Juxi-Technology/wiki-documents/docs/public/downloads/ST3215-20200328-to-customer.stp

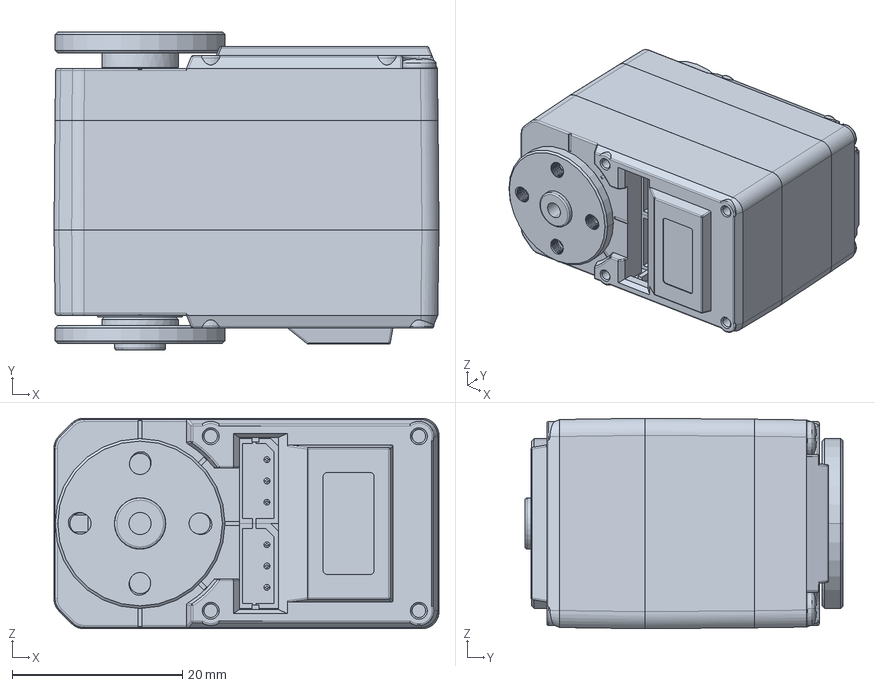
[picture p4: CAD file, 2026-09-16]
docs/public/downloads/ST3215-20200328-to-customer.stp
45.2 x 37.4 x 24.7 mm
SJ-WK00-0021TOPCABINETCASE_104
MOTOR-1723_3_1
PCB-CHAZUO_92_2
SJ-WK00-0023BOTTOMCASE_12
SJ-WK00-0022MIDDLECASE_68
LUOSI-2-25_1_2 x 4
3PIN-1_1 x 2
CHOUCHENGMR106_3 x 2
OUTPUTGEAR_20
FK-AP-019-25T_11
WJ-DP00-0002-FK-AP-020_7
