Juxi-Technology/wiki-documents/docs/public/downloads/SCS009-20230110-S.stp

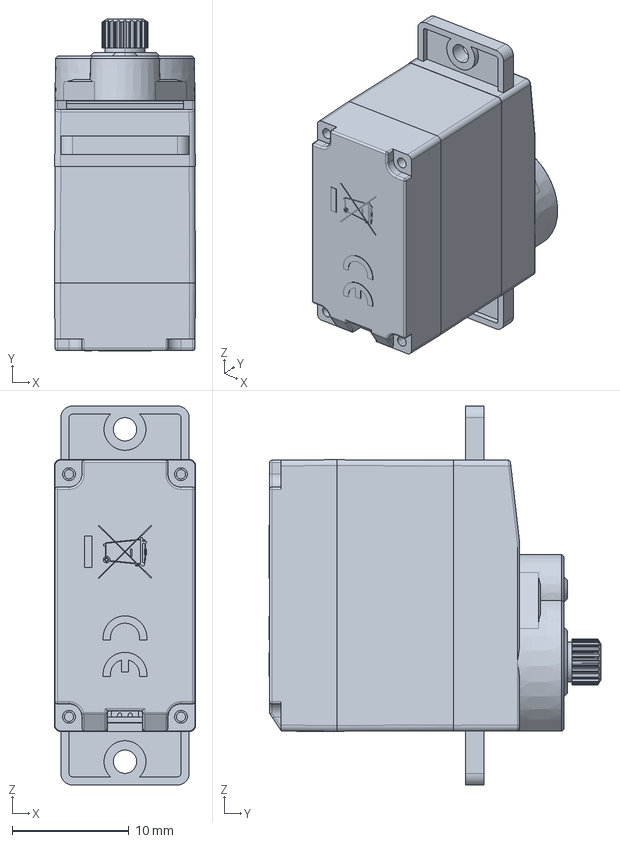
[picture p5: CAD file, 2026-09-16]
docs/public/downloads/SCS009-20230110-S.stp
12.1 x 28.5 x 32.5 mm
SJ-WK00-0038-TOPCASE-0716_41_1
SJ-WK00-0039-COREMIDDLE-0716_65
SJ-WK00-0037-BOTTOMCASE-0716_9_
SJ-CL00-0027-OUTPUTGEAR-0716_37
