Juxi-Technology/wiki-documents/docs/content/tutorials/index.md

---
title: Tutorials Home
titleTemplate: Product Tutorials & Guides
description: "Explore all product tutorials, guides, and examples to quickly get started with Juxi Technology products"
head:
  - [ meta, { property: "og:title", content: "Tutorials Home | Product Tutorials & Guides" } ]
  - [ meta, { property: "og:description", content: "Explore all product tutorials, guides, and examples to quickly get started with Juxi Technology products" } ]
---

# Tutorials Home

Welcome to the Tutorials page! Here, you can find all product usage tutorials, configuration guides, and best practices to help you quickly get started and fully utilize the product's capabilities.

## Topic Categories

### Getting Started

- [FAQ](/tutorials/faq)
- [ROS Intro](/tutorials/ros-intro)
- [Lark Docs](/tutorials/lark-wiki)

### SO-ARM101 Robotic Arm 7-DOF Tutorial

- [SO-ARM101 Robotic Arm 7-DOF Tutorial](/tutorials/robot-arms/so-arm101/lerobot-7dof/)
- **1. Environment Setup**
  - [Ubuntu](/tutorials/robot-arms/so-arm101/lerobot-7dof/01-Environment-Setup/Ubuntu)
  - [Windows](/tutorials/robot-arms/so-arm101/lerobot-7dof/01-Environment-Setup/Windows)
  - [Mac](/tutorials/robot-arms/so-arm101/lerobot-7dof/01-Environment-Setup/MacOS)
- **2. Replace Files (7-DOF Adaptation)**
  - [Replace Files (7-DOF Adaptation)](/tutorials/robot-arms/so-arm101/lerobot-7dof/02-Replace-Files-7DOF)
- **3. Serial Port Check**
  - [Ubuntu](/tutorials/robot-arms/so-arm101/lerobot-7dof/03-Serial-Port/Ubuntu)
  - [Windows](/tutorials/robot-arms/so-arm101/lerobot-7dof/03-Serial-Port/Windows)
  - [Mac](/tutorials/robot-arms/so-arm101/lerobot-7dof/03-Serial-Port/MacOS)
- **4. Arm Calibration**
  - [Ubuntu](/tutorials/robot-arms/so-arm101/lerobot-7dof/04-Calibration/Ubuntu)
  - [Windows](/tutorials/robot-arms/so-arm101/lerobot-7dof/04-Calibration/Windows)
  - [Mac](/tutorials/robot-arms/so-arm101/lerobot-7dof/04-Calibration/MacOS)
- **5. Teleoperation**
  - [Ubuntu](/tutorials/robot-arms/so-arm101/lerobot-7dof/05-Teleoperation/Ubuntu)
  - [Windows](/tutorials/robot-arms/so-arm101/lerobot-7dof/05-Teleoperation/Windows)
  - [Mac](/tutorials/robot-arms/so-arm101/lerobot-7dof/05-Teleoperation/MacOS)
- **6. Camera Teleop**
  - [Ubuntu](/tutorials/robot-arms/so-arm101/lerobot-7dof/06-Camera-Teleoperation/Ubuntu)
  - [Windows](/tutorials/robot-arms/so-arm101/lerobot-7dof/06-Camera-Teleoperation/Windows)
  - [Mac](/tutorials/robot-arms/so-arm101/lerobot-7dof/06-Camera-Teleoperation/MacOS)
- **7. Data Collection**
  - [Browse and Replay the Dataset](/tutorials/robot-arms/so-arm101/lerobot-7dof/07-Data-Collection/Browse-and-Replay)
  - [Dataset Collection Notes](/tutorials/robot-arms/so-arm101/lerobot-7dof/07-Data-Collection/Collection-Notes)
  - [Register a Hugging Face Account (Optional)](/tutorials/robot-arms/so-arm101/lerobot-7dof/07-Data-Collection/HF-Account)
  - [Upload Dataset to HuggingFace (Optional)](/tutorials/robot-arms/so-arm101/lerobot-7dof/07-Data-Collection/HF-Dataset-Upload)
  - [Teaching and Recording a Dataset - Handshake 200](/tutorials/robot-arms/so-arm101/lerobot-7dof/07-Data-Collection/Teaching-and-Recording-Handshake-200)
  - [Teaching and Recording a Dataset](/tutorials/robot-arms/so-arm101/lerobot-7dof/07-Data-Collection/Teaching-and-Recording)
- **8. Model Training**
  - [Cloud GPU Training Environment Setup](/tutorials/robot-arms/so-arm101/lerobot-7dof/08-Training/Cloud-GPU)
  - [Training Command Line - ACT (Recommended for Beginners)](/tutorials/robot-arms/so-arm101/lerobot-7dof/08-Training/Command-ACT)
  - [Training Command Line - Diffusion](/tutorials/robot-arms/so-arm101/lerobot-7dof/08-Training/Command-Diffusion)
  - [Training Command Line - pi0.5](/tutorials/robot-arms/so-arm101/lerobot-7dof/08-Training/Command-pi0.5)
  - [Training Command Line - pi0 (Best Results)](/tutorials/robot-arms/so-arm101/lerobot-7dof/08-Training/Command-pi0)
  - [Training Command Line - pi0fast](/tutorials/robot-arms/so-arm101/lerobot-7dof/08-Training/Command-pi0fast)
  - [Training Command Line - smolvla (Recommended for Advanced Users)](/tutorials/robot-arms/so-arm101/lerobot-7dof/08-Training/Command-smolvla)
  - [Upload the Model to HuggingFace (Optional)](/tutorials/robot-arms/so-arm101/lerobot-7dof/08-Training/HF-Model-Upload)
  - [Imitation Learning Algorithms Supported by LeRobot](/tutorials/robot-arms/so-arm101/lerobot-7dof/08-Training/Imitation-Learning-Algorithms)
  - [Local Ubuntu Training](/tutorials/robot-arms/so-arm101/lerobot-7dof/08-Training/Local-Ubuntu)
  - [Obtain the Model Weight File](/tutorials/robot-arms/so-arm101/lerobot-7dof/08-Training/Model-Weights)
  - [Training Parameter Recommendations](/tutorials/robot-arms/so-arm101/lerobot-7dof/08-Training/Training-Parameter-Tips)
  - [View Real-Time Training Curves on wandb](/tutorials/robot-arms/so-arm101/lerobot-7dof/08-Training/WandB-Curves)
- **9. Model Inference**
  - [Command Line Reference](/tutorials/robot-arms/so-arm101/lerobot-7dof/09-Inference/CLI-Reference)
  - [Inference Command Line - ACT](/tutorials/robot-arms/so-arm101/lerobot-7dof/09-Inference/Command-ACT)
  - [Inference Command Line - Diffusion](/tutorials/robot-arms/so-arm101/lerobot-7dof/09-Inference/Command-Diffusion)
  - [Inference Command Line - pi0.5](/tutorials/robot-arms/so-arm101/lerobot-7dof/09-Inference/Command-pi0.5)
  - [Inference Command Line - pi0](/tutorials/robot-arms/so-arm101/lerobot-7dof/09-Inference/Command-pi0)
  - [Inference Command Line - smolvla](/tutorials/robot-arms/so-arm101/lerobot-7dof/09-Inference/Command-smolvla)
  - [Common Bugs and Fixes](/tutorials/robot-arms/so-arm101/lerobot-7dof/09-Inference/Common-Bugs)
  - [NVIDIA DGX Spark Inference](/tutorials/robot-arms/so-arm101/lerobot-7dof/09-Inference/DGX-Spark)
  - [D-Robotics RDK S100 Inference](/tutorials/robot-arms/so-arm101/lerobot-7dof/09-Inference/RDK-S100)

### Jetson AGX Orin

- [Quick Start — From Unboxing to a Working JetPack 7.2.1 System](/tutorials/jetson-agx-orin/quick-start)
- [Flashing & Updates — Jetson ISO Method](/tutorials/jetson-agx-orin/flashing-and-updates)
- [Verify Your System](/tutorials/jetson-agx-orin/verify-your-system)
- [Interfaces & Hardware Layout](/tutorials/jetson-agx-orin/interfaces)
- [Product Overview](/tutorials/jetson-agx-orin/overview)
- [Local LLM Inference](/tutorials/jetson-agx-orin/local-llm)
- [Agentic AI (NemoClaw)](/tutorials/jetson-agx-orin/agentic-ai)
- [DeepStream Video Analytics](/tutorials/jetson-agx-orin/deepstream)
- [Robotics — State of Play](/tutorials/jetson-agx-orin/robotics)
- [Memory Efficiency](/tutorials/jetson-agx-orin/memory-efficiency)
- [Migrate from JetPack 6.x](/tutorials/jetson-agx-orin/jetpack-6-to-7)
- [Downloads & Official Links](/tutorials/jetson-agx-orin/downloads)
- [FAQ](/tutorials/jetson-agx-orin/faq)
- [Troubleshooting](/tutorials/jetson-agx-orin/troubleshooting)
- [Glossary](/tutorials/jetson-agx-orin/glossary)
- [Changelog](/tutorials/jetson-agx-orin/changelog)
- [XLeRobot Docker — 01 · Overview](/tutorials/jetson-agx-orin/xlerobot-docker/deployment/01-Overview)
- [XLeRobot Docker — 02 · Environment Setup](/tutorials/jetson-agx-orin/xlerobot-docker/deployment/02-Environment-Setup)
- [XLeRobot Docker — 03 · Deployment](/tutorials/jetson-agx-orin/xlerobot-docker/deployment/03-Deployment)
- [XLeRobot Docker — Original LeRobot Operation](/tutorials/jetson-agx-orin/xlerobot-docker/lerobot/01-Operation)
- [XLeRobot Docker — XLeRobot Operation](/tutorials/jetson-agx-orin/xlerobot-docker/xlerobot/01-Operation)
- [XLeRobot Docker — Troubleshooting and Quick Reference](/tutorials/jetson-agx-orin/xlerobot-docker/troubleshooting/01-Troubleshooting)

### Jetson Orin Nano

- [Quick Start — From Unboxing to a Working JetPack 7.2.1 System](/tutorials/jetson-orin-nano/quick-start)
- [Flashing & Updates — Jetson ISO Method, microSD & NVMe](/tutorials/jetson-orin-nano/flashing-and-updates)
- [Verify Your System](/tutorials/jetson-orin-nano/verify-your-system)
- [Interfaces & Hardware Layout](/tutorials/jetson-orin-nano/interfaces)
- [Product Overview](/tutorials/jetson-orin-nano/overview)
- [Local LLM Inference](/tutorials/jetson-orin-nano/local-llm)
- [Memory Efficiency (8 GB)](/tutorials/jetson-orin-nano/memory-efficiency)
- [DeepStream Video Analytics](/tutorials/jetson-orin-nano/deepstream)
- [Robotics (State of Play)](/tutorials/jetson-orin-nano/robotics)
- [Agentic AI (NemoClaw)](/tutorials/jetson-orin-nano/agentic-ai)
- [Migrate from JetPack 6.x](/tutorials/jetson-orin-nano/jetpack-6-to-7)
- [Downloads](/tutorials/jetson-orin-nano/downloads)
- [FAQ](/tutorials/jetson-orin-nano/faq)
- [Troubleshooting](/tutorials/jetson-orin-nano/troubleshooting)
- [Glossary](/tutorials/jetson-orin-nano/glossary)
- [Changelog](/tutorials/jetson-orin-nano/changelog)
- [XLeRobot Docker — 01 · Overview](/tutorials/jetson-orin-nano/xlerobot-docker/deployment/01-Overview)
- [XLeRobot Docker — 02 · Environment Setup](/tutorials/jetson-orin-nano/xlerobot-docker/deployment/02-Environment-Setup)
- [XLeRobot Docker — 03 · Deployment](/tutorials/jetson-orin-nano/xlerobot-docker/deployment/03-Deployment)
- [XLeRobot Docker — Original LeRobot Operation](/tutorials/jetson-orin-nano/xlerobot-docker/lerobot/01-Operation)
- [XLeRobot Docker — XLeRobot Operation](/tutorials/jetson-orin-nano/xlerobot-docker/xlerobot/01-Operation)
- [XLeRobot Docker — Troubleshooting and Quick Reference](/tutorials/jetson-orin-nano/xlerobot-docker/troubleshooting/01-Troubleshooting)

### Learning Resources

- [Learning Resources Home](/tutorials/learning-resources/)
- [Jetson Orin PyTorch Compatibility](/tutorials/learning-resources/jetson-orin-pytorch-compatibility)

### Robot Arms

- [Robot Arms Overview](/tutorials/robot-arms/)
  - [Selection Guide](/tutorials/robot-arms/select-guide)
  - **SO-ARM101 Series**
    - [SO-ARM101 Robotic Arm Tutorials](/tutorials/robot-arms/so-arm101/)
    - [SO-ARM101 Tutorial](/tutorials/robot-arms/so-arm101/SO-ARM101-Tutorial)
    - [SO-ARM101 Assembly](/tutorials/robot-arms/so-arm101/SO-ARM101-Assembly)
    - [SO-ARM101 Jetson Orin PyTorch Compatibility](/tutorials/robot-arms/so-arm101/SO-ARM101-Jetson-Orin-PyTorch-Compatibility)
    - [Arm Mount & Camera Kit Installation](/tutorials/robot-arms/so-arm101/SO-ARM101-100-Arm-Mount-Camera-Kit-Installation)
    - [Overhead Camera Mount Installation](/tutorials/robot-arms/so-arm101/SO-ARM101-Overhead-Camera-Mount-Installation)
    - [SO-ARM101 Wireless Teleoperation (ESP32-NanoCam Version)](/tutorials/robot-arms/so-arm101/SO-ARM101-NanoCam-Wireless-Teleop)
    - [Wireless Teleoperation Troubleshooting](/tutorials/robot-arms/so-arm101/SO-ARM101-NanoCam-Troubleshooting)
    - [SO-ARM101 Bi-Arm (Dual Follower) Tutorial](/tutorials/robot-arms/so-arm101/SO-ARM101-Bi-Arm-Tutorial)
    - [SoARM Series Servo Calibration Tool Tutorial](/tutorials/robot-arms/so-arm101/SO-ARM101-Servo-Calibration-Tool)
    - [So-ARM Series STS3215 Servo Calibration – Web Version](/tutorials/robot-arms/so-arm101/SO-ARM101-Web-Calibration)
      - **LeRobot Full Course**
        - [LeRobot Course Overview](/tutorials/robot-arms/so-arm101/lerobot/)
          - **1. Environment Setup**
            - [Step 1: Environment Setup (Ubuntu)](/tutorials/robot-arms/so-arm101/lerobot/01-Environment-Setup/Ubuntu)
            - [Step 1: Environment Setup (Windows)](/tutorials/robot-arms/so-arm101/lerobot/01-Environment-Setup/Windows)
            - [Step 1: Environment Setup (macOS)](/tutorials/robot-arms/so-arm101/lerobot/01-Environment-Setup/MacOS)
          - **2. Serial Port Check**
            - [Step 2: Serial Port Check (Ubuntu)](/tutorials/robot-arms/so-arm101/lerobot/02-Serial-Port/Ubuntu)
            - [Step 2: Serial Port Check (Windows)](/tutorials/robot-arms/so-arm101/lerobot/02-Serial-Port/Windows)
            - [Step 2: Serial Port Check (macOS)](/tutorials/robot-arms/so-arm101/lerobot/02-Serial-Port/MacOS)
          - **3. Arm Calibration**
            - [Step 3: Arm Calibration (Ubuntu)](/tutorials/robot-arms/so-arm101/lerobot/03-Calibration/Ubuntu)
            - [Step 3: Arm Calibration (Windows)](/tutorials/robot-arms/so-arm101/lerobot/03-Calibration/Windows)
            - [Step 3: Arm Calibration (macOS)](/tutorials/robot-arms/so-arm101/lerobot/03-Calibration/MacOS)
          - **4. Teleoperation**
            - [Step 4: Teleoperation (Ubuntu)](/tutorials/robot-arms/so-arm101/lerobot/04-Teleoperation/Ubuntu)
            - [Step 4: Teleoperation (Windows)](/tutorials/robot-arms/so-arm101/lerobot/04-Teleoperation/Windows)
            - [Step 4: Teleoperation (macOS)](/tutorials/robot-arms/so-arm101/lerobot/04-Teleoperation/MacOS)
          - **5. Camera Teleop**
            - [Step 5: Camera Teleoperation (Ubuntu)](/tutorials/robot-arms/so-arm101/lerobot/05-Camera-Teleoperation/Ubuntu)
            - [Step 5: Camera Teleoperation (Windows)](/tutorials/robot-arms/so-arm101/lerobot/05-Camera-Teleoperation/Windows)
            - [Step 5: Camera Teleoperation (macOS)](/tutorials/robot-arms/so-arm101/lerobot/05-Camera-Teleoperation/MacOS)
          - **6. Data Collection**
            - [Step 6: Teaching & Recording a Dataset](/tutorials/robot-arms/so-arm101/lerobot/06-Data-Collection/Teaching-and-Recording)
            - [Step 6: Teaching & Recording a Dataset — Handshake 200](/tutorials/robot-arms/so-arm101/lerobot/06-Data-Collection/Teaching-and-Recording-Handshake-200)
            - [Step 6: Viewing & Replaying a Dataset](/tutorials/robot-arms/so-arm101/lerobot/06-Data-Collection/Browse-and-Replay)
            - [Step 6: Dataset Collection Notes](/tutorials/robot-arms/so-arm101/lerobot/06-Data-Collection/Collection-Notes)
            - [Step 6: Hugging Face Account (Optional)](/tutorials/robot-arms/so-arm101/lerobot/06-Data-Collection/HF-Account)
            - [Step 6: Upload Dataset to Hugging Face (Optional)](/tutorials/robot-arms/so-arm101/lerobot/06-Data-Collection/HF-Dataset-Upload)
            - [Step 7 (Simulation): Collecting a Dataset — Lightwheel LeIsaac Teleoperation](/tutorials/robot-arms/so-arm101/lerobot/06-Data-Collection/LeIsaac-Sim)
          - **7. Model Training**
            - [Step 7: Training — Local Ubuntu](/tutorials/robot-arms/so-arm101/lerobot/07-Training/Local-Ubuntu)
            - [Step 7: Training — Cloud GPU Setup](/tutorials/robot-arms/so-arm101/lerobot/07-Training/Cloud-GPU)
            - [Step 7: Training — wandb Curves](/tutorials/robot-arms/so-arm101/lerobot/07-Training/WandB-Curves)
            - [Step 7: Training — Upload Model (Optional)](/tutorials/robot-arms/so-arm101/lerobot/07-Training/HF-Model-Upload)
            - [Step 7: Training — Model Weights](/tutorials/robot-arms/so-arm101/lerobot/07-Training/Model-Weights)
            - [Step 7: Training — ACT Command](/tutorials/robot-arms/so-arm101/lerobot/07-Training/Command-ACT)
            - [Step 7: Training — pi0 Command](/tutorials/robot-arms/so-arm101/lerobot/07-Training/Command-pi0)
            - [Step 7: Training — pi0.5 Command](/tutorials/robot-arms/so-arm101/lerobot/07-Training/Command-pi0.5)
            - [Step 7: Training — pi0fast Command](/tutorials/robot-arms/so-arm101/lerobot/07-Training/Command-pi0fast)
            - [Step 7: Training — smolvla Command](/tutorials/robot-arms/so-arm101/lerobot/07-Training/Command-smolvla)
            - [Step 7: Training — Diffusion Command](/tutorials/robot-arms/so-arm101/lerobot/07-Training/Command-Diffusion)
            - [Step 7: Training — WALL-OSS Command](/tutorials/robot-arms/so-arm101/lerobot/07-Training/Command-Wall-OSS)
            - [Step 7: Training — Training Command Line](/tutorials/robot-arms/so-arm101/lerobot/07-Training/Train-CLI)
            - [Step 7: Training — Parameter Tips](/tutorials/robot-arms/so-arm101/lerobot/07-Training/Training-Parameters)
            - [Step 7: Training — Imitation Learning Algorithms](/tutorials/robot-arms/so-arm101/lerobot/07-Training/Imitation-Learning-Algorithms)
          - **8. Model Inference**
            - [Step 8: Inference — CLI Reference](/tutorials/robot-arms/so-arm101/lerobot/08-Inference/CLI-Reference)
            - [Step 8: Inference — Common Bugs](/tutorials/robot-arms/so-arm101/lerobot/08-Inference/Common-Bugs)
            - [Step 8: Inference — ACT Command](/tutorials/robot-arms/so-arm101/lerobot/08-Inference/Command-ACT)
            - [Step 8: Inference — pi0 Command](/tutorials/robot-arms/so-arm101/lerobot/08-Inference/Command-pi0)
            - [Step 8: Inference — pi0.5 Command](/tutorials/robot-arms/so-arm101/lerobot/08-Inference/Command-pi0.5)
            - [Step 8: Inference — smolvla Command](/tutorials/robot-arms/so-arm101/lerobot/08-Inference/Command-smolvla)
            - [Step 8: Inference — Diffusion Command](/tutorials/robot-arms/so-arm101/lerobot/08-Inference/Command-Diffusion)
            - [Step 8: Inference — WALL-OSS Command](/tutorials/robot-arms/so-arm101/lerobot/08-Inference/Command-Wall-OSS)
            - [Step 8: Inference — NVIDIA DGX Spark](/tutorials/robot-arms/so-arm101/lerobot/08-Inference/DGX-Spark)
            - [Step 8: Inference — D-Robotics RDK S100](/tutorials/robot-arms/so-arm101/lerobot/08-Inference/RDK-S100)
          - **Basics**
            - [Understanding LeRobot](/tutorials/robot-arms/so-arm101/basics/Understanding-LeRobot)
            - [LeRobot Datasets on Hugging Face](/tutorials/robot-arms/so-arm101/basics/HF-Datasets)
            - [Model Training Resources](/tutorials/robot-arms/so-arm101/basics/Training-Resources)
            - [SO-ARM100 Official 3D Print Files](/tutorials/robot-arms/so-arm101/basics/Official-3D-Print-Files)
            - [URDF Files and Reference Materials](/tutorials/robot-arms/so-arm101/basics/URDF-Reference)
            - [Recommended Camera Brackets and Mounts](/tutorials/robot-arms/so-arm101/basics/Camera-Mounts-Recommended)
          - **Extras & Advanced**
            - [ROS2 Simulation Control](/tutorials/robot-arms/so-arm101/ROS2-Simulation-Control)
            - [Parallel Finger Gripper Installation](/tutorials/robot-arms/so-arm101/Parallel-Finger-Gripper-Installation)
      - **LeLab Tutorial**
        - [1 · Overview](/tutorials/robot-arms/so-arm101/lelab/01-Overview)
        - [2 · Install and run](/tutorials/robot-arms/so-arm101/lelab/02-Install)
        - [3 · Connect and calibrate](/tutorials/robot-arms/so-arm101/lelab/03-Calibration)
        - [4 · Teleoperation](/tutorials/robot-arms/so-arm101/lelab/04-Teleoperation)
        - [5 · Record a dataset](/tutorials/robot-arms/so-arm101/lelab/05-Record-Dataset)
        - [6 · Train and run inference](/tutorials/robot-arms/so-arm101/lelab/06-Train-and-Inference)
        - [7 · Troubleshooting](/tutorials/robot-arms/so-arm101/lelab/07-Troubleshooting)
      - **MuJoCo Simulation Tutorial**,        - [SO-ARM101 × MuJoCo Full Workflow Tutorial (Index)](/tutorials/robot-arms/so-arm101/mujoco/),        - [01 · Environment Setup](/tutorials/robot-arms/so-arm101/mujoco/01-Environment),        - [02 · Simulation Model Verification (MJCF Loading and Driving)](/tutorials/robot-arms/so-arm101/mujoco/02-Sim-Model-Verification),        - [03 · Real-Robot Connection and Calibration](/tutorials/robot-arms/so-arm101/mujoco/03-Hardware-Calibration),        - [04 · Keyboard Teleoperation](/tutorials/robot-arms/so-arm101/mujoco/04-Keyboard-Teleop),        - [05 · Leader-Arm Digital Twin (Physical Arm Driving the Simulated Arm)](/tutorials/robot-arms/so-arm101/mujoco/05-Leader-Digital-Twin),        - [06 · Data Recording and Replay](/tutorials/robot-arms/so-arm101/mujoco/06-Record-and-Replay),        - [07 · Troubleshooting and Lessons Learned](/tutorials/robot-arms/so-arm101/mujoco/07-Troubleshooting),        - [08 · Roadmap](/tutorials/robot-arms/so-arm101/mujoco/08-Roadmap),        - [09 · Complete Usage Tutorial (Arm Bring-Up → Dataset → Watching Videos → Training → Deployment)](/tutorials/robot-arms/so-arm101/mujoco/09-Usage-Tutorial)
  - **SO-ARM101 + AmazingHand Course**
    - [Course Overview](/tutorials/robot-arms/so-arm-amazinghand/)
      - **Linux**
        - [Stage 1: Environment Setup (Linux)](/tutorials/robot-arms/so-arm-amazinghand/01-Environment-Setup-Linux)
        - [Stage 2: Hand & Arm Calibration (Linux)](/tutorials/robot-arms/so-arm-amazinghand/02-Hand-Arm-Calibration-Linux)
        - [Stage 3: Teleoperation (Linux)](/tutorials/robot-arms/so-arm-amazinghand/03-Teleoperation-Linux)
        - [Stage 4: Data Collection (Linux)](/tutorials/robot-arms/so-arm-amazinghand/04-Data-Collection-Linux)
        - [Stage 5: Model Training (Linux)](/tutorials/robot-arms/so-arm-amazinghand/05-Model-Training-Linux)
        - [Stage 6: Model Deployment (Linux)](/tutorials/robot-arms/so-arm-amazinghand/06-Model-Deployment-Linux)
      - **Windows**
        - [Stage 1: Environment Setup (Windows)](/tutorials/robot-arms/so-arm-amazinghand/01-Environment-Setup-Windows)
        - [Stage 2: Hand & Arm Calibration (Windows)](/tutorials/robot-arms/so-arm-amazinghand/02-Hand-Arm-Calibration-Windows)
        - [Stage 3: Teleoperation (Windows)](/tutorials/robot-arms/so-arm-amazinghand/03-Teleoperation-Windows)
        - [Stage 4: Data Collection (Windows)](/tutorials/robot-arms/so-arm-amazinghand/04-Data-Collection-Windows)
        - [Stage 5: Model Training (Windows)](/tutorials/robot-arms/so-arm-amazinghand/05-Model-Training-Windows)
        - [Stage 6: Model Deployment (Windows)](/tutorials/robot-arms/so-arm-amazinghand/06-Model-Deployment-Windows)
  - **XLeRobot Tutorials**
    - [Tutorials Overview](/tutorials/robot-arms/xlerobot/)
    - [Environment Setup (macOS)](/tutorials/robot-arms/xlerobot/01-Environment-Setup-macOS)
    - [Environment Setup (Ubuntu)](/tutorials/robot-arms/xlerobot/01-Environment-Setup-Ubuntu)
    - [Environment Setup (Windows)](/tutorials/robot-arms/xlerobot/01-Environment-Setup-Windows)
    - [Move XLeRobot Files](/tutorials/robot-arms/xlerobot/02-Move-Xlerobot-Files)
    - [Assembled-Kit Assembly](/tutorials/robot-arms/xlerobot/03-Assembly-Assembled-Kit)
    - [Parts-Kit Assembly](/tutorials/robot-arms/xlerobot/04-Assembly-Parts-Kit)
  - **AmazingHand Dexterous Hand Tutorials Overview**
    - [Tutorial index (incl. legacy URLs)](/tutorials/robot-arms/amazing-hand/index.md)
    - [AmazingHand Dexterous Hand Tutorials Overview](/tutorials/robot-arms/amazing-hand/README)
    - [AmazingHand Product Information](/tutorials/robot-arms/amazing-hand/00-product/product-info)
    - [SCS0009 vs PWM Version Comparison and Selection](/tutorials/robot-arms/amazing-hand/00-product/version-comparison)
    - [Downloads and Resources](/tutorials/robot-arms/amazing-hand/00-product/downloads)
    - [Hardware Overview: Mechanics, CAD and Assembly](/tutorials/robot-arms/amazing-hand/01-hardware/overview)
    - [SCS0009 Wiring, ID and Power](/tutorials/robot-arms/amazing-hand/01-hardware/scs0009)
    - [PWM Wiring, GPIO and Power](/tutorials/robot-arms/amazing-hand/01-hardware/pwm)
    - [Environmental Camera Kit Installation](/tutorials/robot-arms/amazing-hand/01-hardware/camera-kit)
    - [SCS0009 Quick Start](/tutorials/robot-arms/amazing-hand/02-quick-start/scs0009)
    - [PWM Quick Start](/tutorials/robot-arms/amazing-hand/02-quick-start/pwm)
    - [AmazingHand Web Control](/tutorials/robot-arms/amazing-hand/03-web-control/README)
    - [SCS0009 Web Control](/tutorials/robot-arms/amazing-hand/03-web-control/scs0009)
    - [PWM Web Control](/tutorials/robot-arms/amazing-hand/03-web-control/pwm)
    - [SCS0009 Desktop Host Software (GUI and CLI)](/tutorials/robot-arms/amazing-hand/04-desktop/scs0009)
    - [PWM Desktop Host Software (Tkinter GUI)](/tutorials/robot-arms/amazing-hand/04-desktop/pwm)
    - [SCS0009 Hand Tracking (Official dora Demo)](/tutorials/robot-arms/amazing-hand/05-hand-tracking/scs0009)
    - [PWM Hand Tracking (MediaPipe Built into the GUI)](/tutorials/robot-arms/amazing-hand/05-hand-tracking/pwm)
    - [SCS0009 Servo Debugging and Calibration](/tutorials/robot-arms/amazing-hand/06-servo-tuning/scs0009)
    - [PWM Servo Protocol, Commands and Calibration](/tutorials/robot-arms/amazing-hand/06-servo-tuning/pwm)
    - [Arduino Nano Tutorial](/tutorials/robot-arms/amazing-hand/07-arduino/arduino-nano)
    - [Arduino and Python Examples](/tutorials/robot-arms/amazing-hand/07-arduino/examples)
    - [Frequently Asked Questions (FAQ)](/tutorials/robot-arms/amazing-hand/08-faq/faq)
  - **Lekiwi**
    - [Lekiwi Tutorial](/tutorials/robot-arms/lekiwi/Lekiwi-Tutorial)
    - [Lekiwi Assembly](/tutorials/robot-arms/lekiwi/Lekiwi-Assembly)
  - **SR-Support Self-Righting Robot Tutorial**
    - [SR-Support Self-Righting Robot Tutorial](/tutorials/robot-arms/sr-support/)
    - [01 Basics](/tutorials/robot-arms/sr-support/01-basics)
    - [02 Environment setup (venv, flash tools and firmware)](/tutorials/robot-arms/sr-support/02-environment)
    - [03 Flash the main firmware](/tutorials/robot-arms/sr-support/03-build-flash)
    - [04 Assembly: print, build, wire](/tutorials/robot-arms/sr-support/04-assembly)
    - [05 Zero-calibration (arrow keys; required for DIY builds)](/tutorials/robot-arms/sr-support/05-zero-tool)
    - [06 Debug and calibration](/tutorials/robot-arms/sr-support/06-debug-and-calibrate)
    - [07 Self-righting usage and monitoring](/tutorials/robot-arms/sr-support/07-self-righting)
    - [08 WiFi status page and provisioning](/tutorials/robot-arms/sr-support/08-wifi)
    - [09 MuJoCo simulation and the live twin](/tutorials/robot-arms/sr-support/09-mujoco)
    - [10 Troubleshooting](/tutorials/robot-arms/sr-support/10-troubleshooting)
    - [11 Reference: model, parameters and licensing](/tutorials/robot-arms/sr-support/11-reference)

### Accessories

- [Accessories Overview](/tutorials/accessories/)
  - **KWS Speech Recognition Module**
    - [Series Home](/tutorials/accessories/KWS-speech-recognition-module/)
    - [Jetson Nano Serial Communication](/tutorials/accessories/KWS-speech-recognition-module/Jetson-Nano-serial-communication)
    - [Jetson Serial Communication](/tutorials/accessories/KWS-speech-recognition-module/Jetson-serial-communication)
    - [PC Serial Communication](/tutorials/accessories/KWS-speech-recognition-module/PC-serial-communication)
    - [Raspberry Pi Serial Communication](/tutorials/accessories/KWS-speech-recognition-module/raspberry-pi-serial-communication)
    - [ROS2 rviz2 Visualization](/tutorials/accessories/KWS-speech-recognition-module/ROS2-rviz2-visualization)
    - [Firmware Download & Burn](/tutorials/accessories/KWS-speech-recognition-module/download-and-burn-firmware-for-chinese-and-english-recognition-words)
  - **Feetech Servos**
    - [STS3215 & SCS0009 Tutorial](/tutorials/accessories/feetech/Feetech-STS3215&SCS0009-Tutorial)
    - [SCS Communication Protocol](/tutorials/accessories/feetech/Feetech-SCS_Communication_Protocol)
    - [Magnetic Encoder STS Servo Memory Table](/tutorials/accessories/feetech/Feetech-Magnetic_Encoder_STS_Servo-Memory_Table_Analysis)
    - [Potentiometer SCSCL Servo Memory Table](/tutorials/accessories/feetech/Feetech-Potentiometer_SCSCL_Servo-Memory_Table_Analysis)
    - [SCS0009 Servo Debug Tool Tutorial](/tutorials/accessories/feetech/SCS0009-Debug-Tool)
    - [Feetech Bus Servo Web Debugger (SCS0009 / STS3215 / HD1910)](/tutorials/accessories/feetech/Feetech-Web-Debugger)
  - **ESP32-NanoCam Video Module**
    - [ESP32-NanoCam Quick Start](/tutorials/accessories/esp32-nanocam/ESP32-NanoCam-Quick-Start)
    - [ESP32-NanoCam Hardware Spec](/tutorials/accessories/esp32-nanocam/ESP32-NanoCam-Hardware-Spec)
    - [ESP32-NanoCam Serial Protocol Manual](/tutorials/accessories/esp32-nanocam/ESP32-NanoCam-Serial-Protocol)
      - **AI Vision Tutorial (11 chapters)**
        - [Chapter 1: Environment Setup](/tutorials/accessories/esp32-nanocam/Ch01-Environment-Setup)
        - [Chapter 2: Quick Start](/tutorials/accessories/esp32-nanocam/Ch02-Quick-Start)
        - [Chapter 3: Camera Basics](/tutorials/accessories/esp32-nanocam/Ch03-Camera-Basics)
        - [Chapter 4: Face Detection](/tutorials/accessories/esp32-nanocam/Ch04-Face-Detection)
        - [Chapter 5: Cat Face Detection](/tutorials/accessories/esp32-nanocam/Ch05-Cat-Face-Detection)
        - [Chapter 6: Color Recognition](/tutorials/accessories/esp32-nanocam/Ch06-Color-Recognition)
        - [Chapter 7: QR Code Scanning](/tutorials/accessories/esp32-nanocam/Ch07-QR-Code-Scanning)
        - [Chapter 8: Face Recognition](/tutorials/accessories/esp32-nanocam/Ch08-Face-Recognition)
        - [Chapter 9: Voice Chat](/tutorials/accessories/esp32-nanocam/Ch09-Voice-Chat)
        - [Chapter 10: AI Vision Understanding](/tutorials/accessories/esp32-nanocam/Ch10-AI-Vision-Understanding)
        - [Chapter 11: ESP-Claw Voice Control](/tutorials/accessories/esp32-nanocam/Ch11-ESP-Claw-Voice-Control)
  - **CSI Camera Tutorials**
    - [Jetson CSI Camera Setup](/tutorials/accessories/csi-camera/01-Jetson-CSI-Setup)
    - [Auto-Focus Camera Usage](/tutorials/accessories/csi-camera/02-Auto-Focus-Camera)
    - [Using JupyterLab](/tutorials/accessories/csi-camera/03-JupyterLab)
    - [Using JetCam](/tutorials/accessories/csi-camera/04-JetCam)
    - [IMX219 on Raspberry Pi](/tutorials/accessories/csi-camera/05-IMX219-RaspberryPi)
  - **AI Voice Interaction Module**
    - [Quick Start](/tutorials/accessories/ai-voice-module/Quick-Start)
    - [Product Information](/tutorials/accessories/ai-voice-module/Product-Info)
    - [Module Firmware Flashing](/tutorials/accessories/ai-voice-module/Firmware-Flashing)
    - [Modify the Wake Word and Command Words](/tutorials/accessories/ai-voice-module/Wake-Word-Commands-Edit)
    - [Custom Protocol Entry Creation](/tutorials/accessories/ai-voice-module/Custom-Protocol-Entries)
    - [ROS1 Voice Interaction](/tutorials/accessories/ai-voice-module/ROS1-Voice-Interaction)
    - [ROS2 Voice Interaction](/tutorials/accessories/ai-voice-module/ROS2-Voice-Interaction)
    - [Serial Port Protocol](/tutorials/accessories/ai-voice-module/Serial-Protocol)
    - [IIC Protocol](/tutorials/accessories/ai-voice-module/IIC-Protocol)
    - [PC Communication](/tutorials/accessories/ai-voice-module/PC-Communication)
    - [Arduino: Serial Port Communication](/tutorials/accessories/ai-voice-module/Arduino-Serial-Communication)
    - [Arduino: IIC Communication](/tutorials/accessories/ai-voice-module/Arduino-IIC-Communication)
    - [Jetson: Serial Port Communication](/tutorials/accessories/ai-voice-module/Jetson-Serial-Communication)
    - [Jetson: IIC Communication](/tutorials/accessories/ai-voice-module/Jetson-IIC-Communication)
    - [RDK: Serial Port Communication](/tutorials/accessories/ai-voice-module/RDK-Serial-Communication)
    - [RDK: IIC Communication](/tutorials/accessories/ai-voice-module/RDK-IIC-Communication)
    - [Raspberry Pi: Serial Port Communication](/tutorials/accessories/ai-voice-module/RaspberryPi-Serial-Communication)
    - [Raspberry Pi: IIC Communication](/tutorials/accessories/ai-voice-module/RaspberryPi-IIC-Communication)
  - **Other Accessories**
    - [USB Auto-Focus Camera](/tutorials/accessories/usb-auto-focus-camera)
    - [Jetson CSI Camera](/tutorials/accessories/jetson-csi-camera)
    - [2-DOF Camera Gimbal](/tutorials/accessories/2dof-camera-gimbal)
    - [Heart Rate & SpO2 Sensor](/tutorials/accessories/heart-rate-spo2)
    - [0.91" OLED Screen](/tutorials/accessories/0.91-oled-screen-tutorial)
    - [4K HDMI Capture](/tutorials/accessories/4k-hdmi-capture-tutorial)
    - [KVM Switch](/tutorials/accessories/kvm-switch-tutorial)
    - [KVM Switch · Tutorial Overview](/tutorials/accessories/kvm-switch/00-Overview-and-Quick-Start),    - [01 · Switching Between Two Computers (Button & IR Remote)](/tutorials/accessories/kvm-switch/01-Switching-Between-Two-Computers),    - [02 · HUB Function (One to Three)](/tutorials/accessories/kvm-switch/02-HUB-Function-One-to-Three),    - [03 · Bluetooth](/tutorials/accessories/kvm-switch/03-Bluetooth),    - [04 · TTL Serial Port (Wireless Serial)](/tutorials/accessories/kvm-switch/04-TTL-Serial-Port),    - [05 · 10-Pin Expansion Header](/tutorials/accessories/kvm-switch/05-10-Pin-Expansion-Header),    - [06 · Headless Host (Capture Card + OBS)](/tutorials/accessories/kvm-switch/06-Headless-Host-Capture-Card-and-OBS),    - [07 · FAQ and Precautions](/tutorials/accessories/kvm-switch/07-FAQ-and-Precautions)
    - [USB Driver-Free Sound Card](/tutorials/accessories/usb-audio-card-tutorial)

### Sensors

- [Sensors Overview](/tutorials/sensors/)
  - **IMU Inertial Module**
    - [Product Info](/tutorials/sensors/imu/product-info)
    - [Web Host Console](/tutorials/sensors/imu/web-host-console)
    - [MicroDuck Integration](/tutorials/sensors/imu/microduck-integration)
    - [IMU Calibration](/tutorials/sensors/imu/calibration)
    - [Remote File Transfer](/tutorials/sensors/imu/remote-file-transfer)
    - [SSH File Transfer](/tutorials/sensors/imu/ssh-file-transfer)
      - **Multi-Board Examples**
        - [Overview](/tutorials/sensors/imu/multi-board-examples/overview)
        - [PC Communication](/tutorials/sensors/imu/multi-board-examples/pc-communication)
          - **I2C Communication**
            - [Arduino](/tutorials/sensors/imu/multi-board-examples/i2c-communication/arduino)
            - [Jetson Series](/tutorials/sensors/imu/multi-board-examples/i2c-communication/jetson)
            - [Raspberry Pi 5](/tutorials/sensors/imu/multi-board-examples/i2c-communication/raspberry-pi)
            - [RDK Series](/tutorials/sensors/imu/multi-board-examples/i2c-communication/rdk)
            - [STM32 F103C8T6](/tutorials/sensors/imu/multi-board-examples/i2c-communication/stm32)
          - **Serial Communication**
            - [Arduino](/tutorials/sensors/imu/multi-board-examples/serial-communication/arduino)
            - [Jetson Series](/tutorials/sensors/imu/multi-board-examples/serial-communication/jetson)
            - [Raspberry Pi 5](/tutorials/sensors/imu/multi-board-examples/serial-communication/raspberry-pi)
            - [RDK Series](/tutorials/sensors/imu/multi-board-examples/serial-communication/rdk)
            - [STM32 F103C8T6](/tutorials/sensors/imu/multi-board-examples/serial-communication/stm32)
      - **ROS Examples**
        - [ROS1 Application](/tutorials/sensors/imu/ros-examples/ros1)
        - [ROS2 Application](/tutorials/sensors/imu/ros-examples/ros2)
  - **GPS & BeiDou Module**
    - [Module Info](/tutorials/sensors/gps/GPS-Module-Info)
    - [51 MCU: GPS Parsing](/tutorials/sensors/gps/51-MCU-GPS-Parsing)
    - [Arduino: Location Reading](/tutorials/sensors/gps/Arduino-Location-Reading)
    - [Arduino: Location Parsing](/tutorials/sensors/gps/Arduino-Location-Parsing)
    - [STM32F103: GPS Parsing Output](/tutorials/sensors/gps/STM32F103-GPS-Parsing)
    - [Jetson: GPS Parsing](/tutorials/sensors/gps/Jetson-GPS-Parsing)
    - [Jetson: AGNSS Positioning](/tutorials/sensors/gps/Jetson-AGNSS)
    - [Jetson: Baidu Map API](/tutorials/sensors/gps/Jetson-Baidu-Map-API)
    - [Raspberry Pi: GPS Parsing](/tutorials/sensors/gps/RaspberryPi-GPS-Parsing)
    - [Raspberry Pi: AGNSS Positioning](/tutorials/sensors/gps/RaspberryPi-AGNSS)
    - [Raspberry Pi: Baidu Map API](/tutorials/sensors/gps/RaspberryPi-Baidu-Map-API)
    - [ROS: Preparation](/tutorials/sensors/gps/ROS-Preparation)
    - [ROS: Reading GPS Data](/tutorials/sensors/gps/ROS-Read-GPS-Data)
    - [ROS: Drawing GPS Tracks](/tutorials/sensors/gps/ROS-Draw-GPS-Track)
    - [Map Location Error](/tutorials/sensors/gps/Map-Location-Error)

## How to Use

1. **Select Topic Category**: Choose the corresponding topic category based on your interests or needs
2. **View Tutorial List**: In each topic category, view available tutorials and documents
3. **Follow Steps**: Follow the steps in the tutorials to gradually learn and use the product
4. **Practice and Explore**: During actual operation, try different functions and configurations to accumulate experience
- **Learning Resources**
  - [Learning Resources Home](./learning-resources/index)
  - [Jetson Orin PyTorch Compatibility](./learning-resources/jetson-orin-pytorch-compatibility)

## Other Resources

- For questions or suggestions, please visit our GitHub repository to submit an Issue
- Follow our blog and social media for the latest product updates and tutorial information
