Juxi-Technology/wiki-documents/docs/content/de/tutorials/index.md

---
title: Tutorials
description: "Alle Tutorials im Juxi Technology Wiki: Roboterarme, Greifhände, Sensoren und Zubehör mit Schritt-für-Schritt-Anleitungen für den schnellen Einstieg."
---

# Tutorials

Willkommen auf der Tutorials-Seite! Hier finden Sie alle Tutorials zur Produktnutzung, Konfigurationsanleitungen und Best Practices, die Ihnen einen schnellen Einstieg und die volle Nutzung der Produkte ermöglichen.

## Themenkategorien

### Schnellstart

- [FAQ](/de/tutorials/faq)
- [ROS-Einführung](/de/tutorials/ros-intro)
- [Lark Wiki](/de/tutorials/lark-wiki)

### SO-ARM101 Roboterarm 7-Achsen Tutorial

- [SO-ARM101 Roboterarm 7-Achsen Tutorial](/tutorials/robot-arms/so-arm101/lerobot-7dof/)
- **1. LeRobot-Umgebung**
  - [Ubuntu-Computer](/de/tutorials/robot-arms/so-arm101/lerobot-7dof/01-Environment-Setup/Ubuntu)
  - [Windows-Computer](/de/tutorials/robot-arms/so-arm101/lerobot-7dof/01-Environment-Setup/Windows)
  - [Mac-Computer](/de/tutorials/robot-arms/so-arm101/lerobot-7dof/01-Environment-Setup/MacOS)
- **2. Dateien ersetzen (Anpassung an 7-DOF)**
  - [Dateien ersetzen (Anpassung an 7-DOF)](/de/tutorials/robot-arms/so-arm101/lerobot-7dof/02-Replace-Files-7DOF)
- **3. Serielle Ports**
  - [Ubuntu](/de/tutorials/robot-arms/so-arm101/lerobot-7dof/03-Serial-Port/Ubuntu)
  - [Windows-Computer](/de/tutorials/robot-arms/so-arm101/lerobot-7dof/03-Serial-Port/Windows)
  - [Mac-Computer](/de/tutorials/robot-arms/so-arm101/lerobot-7dof/03-Serial-Port/MacOS)
- **4. Kalibrierung**
  - [Ubuntu-Computer](/de/tutorials/robot-arms/so-arm101/lerobot-7dof/04-Calibration/Ubuntu)
  - [Windows-Computer](/de/tutorials/robot-arms/so-arm101/lerobot-7dof/04-Calibration/Windows)
  - [Mac-Computer](/de/tutorials/robot-arms/so-arm101/lerobot-7dof/04-Calibration/MacOS)
- **5. Teleoperation**
  - [Ubuntu-Computer](/de/tutorials/robot-arms/so-arm101/lerobot-7dof/05-Teleoperation/Ubuntu)
  - [Windows-Computer](/de/tutorials/robot-arms/so-arm101/lerobot-7dof/05-Teleoperation/Windows)
  - [Mac-Computer](/de/tutorials/robot-arms/so-arm101/lerobot-7dof/05-Teleoperation/MacOS)
- **6. Teleop mit Kamera**
  - [Ubuntu-Computer](/de/tutorials/robot-arms/so-arm101/lerobot-7dof/06-Camera-Teleoperation/Ubuntu)
  - [Windows-Computer](/de/tutorials/robot-arms/so-arm101/lerobot-7dof/06-Camera-Teleoperation/Windows)
  - [Mac-Computer](/de/tutorials/robot-arms/so-arm101/lerobot-7dof/06-Camera-Teleoperation/MacOS)
- **7. Datenerfassung**
  - [Datensatz ansehen und wiedergeben](/de/tutorials/robot-arms/so-arm101/lerobot-7dof/07-Data-Collection/Browse-and-Replay)
  - [Hinweise zum Erfassen von Datensätzen](/de/tutorials/robot-arms/so-arm101/lerobot-7dof/07-Data-Collection/Collection-Notes)
  - [Hugging Face-Konto registrieren (optional)](/de/tutorials/robot-arms/so-arm101/lerobot-7dof/07-Data-Collection/HF-Account)
  - [Datensatz auf HuggingFace hochladen (optional)](/de/tutorials/robot-arms/so-arm101/lerobot-7dof/07-Data-Collection/HF-Dataset-Upload)
  - [Datensatz durch Demonstration erfassen-Handschlag 200](/de/tutorials/robot-arms/so-arm101/lerobot-7dof/07-Data-Collection/Teaching-and-Recording-Handshake-200)
  - [Datensatz durch Demonstration erfassen](/de/tutorials/robot-arms/so-arm101/lerobot-7dof/07-Data-Collection/Teaching-and-Recording)
- **8. Modelltraining**
  - [Cloud-GPU-Trainingsumgebung einrichten](/de/tutorials/robot-arms/so-arm101/lerobot-7dof/08-Training/Cloud-GPU)
  - [Trainingsbefehl-ACT (empfohlen für den Einstieg)](/de/tutorials/robot-arms/so-arm101/lerobot-7dof/08-Training/Command-ACT)
  - [Trainingsbefehl-Diffusion](/de/tutorials/robot-arms/so-arm101/lerobot-7dof/08-Training/Command-Diffusion)
  - [Trainingsbefehl-pi0.5](/de/tutorials/robot-arms/so-arm101/lerobot-7dof/08-Training/Command-pi0.5)
  - [Trainingsbefehl-pi0 (beste Ergebnisse)](/de/tutorials/robot-arms/so-arm101/lerobot-7dof/08-Training/Command-pi0)
  - [Trainingsbefehl-pi0fast](/de/tutorials/robot-arms/so-arm101/lerobot-7dof/08-Training/Command-pi0fast)
  - [Trainingsbefehl-smolvla (empfohlen für Fortgeschrittene)](/de/tutorials/robot-arms/so-arm101/lerobot-7dof/08-Training/Command-smolvla)
  - [Modell zu HuggingFace hochladen (optional)](/de/tutorials/robot-arms/so-arm101/lerobot-7dof/08-Training/HF-Model-Upload)
  - [Von LeRobot unterstützte Imitation-Learning-Algorithmen](/de/tutorials/robot-arms/so-arm101/lerobot-7dof/08-Training/Imitation-Learning-Algorithms)
  - [Lokales Training unter Ubuntu](/de/tutorials/robot-arms/so-arm101/lerobot-7dof/08-Training/Local-Ubuntu)
  - [Modelldateien abrufen](/de/tutorials/robot-arms/so-arm101/lerobot-7dof/08-Training/Model-Weights)
  - [Empfehlungen für Trainingsparameter](/de/tutorials/robot-arms/so-arm101/lerobot-7dof/08-Training/Training-Parameter-Tips)
  - [Trainingskurven in Echtzeit mit wandb anzeigen](/de/tutorials/robot-arms/so-arm101/lerobot-7dof/08-Training/WandB-Curves)
- **9. Modell-Inferenz**
  - [Erläuterung der Befehle](/de/tutorials/robot-arms/so-arm101/lerobot-7dof/09-Inference/CLI-Reference)
  - [Inferenzbefehl-ACT](/de/tutorials/robot-arms/so-arm101/lerobot-7dof/09-Inference/Command-ACT)
  - [Inferenzbefehl-Diffusion](/de/tutorials/robot-arms/so-arm101/lerobot-7dof/09-Inference/Command-Diffusion)
  - [Inferenzbefehl-pi0.5](/de/tutorials/robot-arms/so-arm101/lerobot-7dof/09-Inference/Command-pi0.5)
  - [Inferenzbefehl-pi0](/de/tutorials/robot-arms/so-arm101/lerobot-7dof/09-Inference/Command-pi0)
  - [Inferenzbefehl-smolvla](/de/tutorials/robot-arms/so-arm101/lerobot-7dof/09-Inference/Command-smolvla)
  - [Häufige Bugs und Lösungen](/de/tutorials/robot-arms/so-arm101/lerobot-7dof/09-Inference/Common-Bugs)
  - [Inferenz mit dem NVIDIA DGX Spark](/de/tutorials/robot-arms/so-arm101/lerobot-7dof/09-Inference/DGX-Spark)
  - [Inferenz mit dem D-Robotics RDK S100](/de/tutorials/robot-arms/so-arm101/lerobot-7dof/09-Inference/RDK-S100)

### Jetson AGX Orin Developer Kit

- [Schnellstart](/de/tutorials/jetson-agx-orin/quick-start)
- [Flashen & Updates](/de/tutorials/jetson-agx-orin/flashing-and-updates)
- [System überprüfen](/de/tutorials/jetson-agx-orin/verify-your-system)
- [Schnittstellen & Hardware-Layout](/de/tutorials/jetson-agx-orin/interfaces)
- [Produktübersicht](/de/tutorials/jetson-agx-orin/overview)
- [Lokale LLM-Inferenz](/de/tutorials/jetson-agx-orin/local-llm)
- [Agentic AI (NemoClaw)](/de/tutorials/jetson-agx-orin/agentic-ai)
- [DeepStream-Videoanalyse](/de/tutorials/jetson-agx-orin/deepstream)
- [Robotik (Stand der Dinge)](/de/tutorials/jetson-agx-orin/robotics)
- [Speichereffizienz](/de/tutorials/jetson-agx-orin/memory-efficiency)
- [Migration von JetPack 6.x](/de/tutorials/jetson-agx-orin/jetpack-6-to-7)
- [Downloads & offizielle Links](/de/tutorials/jetson-agx-orin/downloads)
- [FAQ](/de/tutorials/jetson-agx-orin/faq)
- [Fehlerbehebung](/de/tutorials/jetson-agx-orin/troubleshooting)
- [Glossar](/de/tutorials/jetson-agx-orin/glossary)
- [Changelog](/de/tutorials/jetson-agx-orin/changelog)
- [XLeRobot Docker — 01 · Überblick](/de/tutorials/jetson-agx-orin/xlerobot-docker/deployment/01-Overview)
- [XLeRobot Docker — 02 · Umgebung einrichten](/de/tutorials/jetson-agx-orin/xlerobot-docker/deployment/02-Environment-Setup)
- [XLeRobot Docker — 03 · Bereitstellung](/de/tutorials/jetson-agx-orin/xlerobot-docker/deployment/03-Deployment)
- [XLeRobot Docker — Original-LeRobot-Befehle](/de/tutorials/jetson-agx-orin/xlerobot-docker/lerobot/01-Operation)
- [XLeRobot Docker — XLeRobot-Befehle](/de/tutorials/jetson-agx-orin/xlerobot-docker/xlerobot/01-Operation)
- [XLeRobot Docker — Fehlerbehebung und Schnellreferenz](/de/tutorials/jetson-agx-orin/xlerobot-docker/troubleshooting/01-Troubleshooting)

### Jetson Orin Nano Super Developer Kit

- [Schnellstart](/de/tutorials/jetson-orin-nano/quick-start)
- [Flashen & Updates](/de/tutorials/jetson-orin-nano/flashing-and-updates)
- [System überprüfen](/de/tutorials/jetson-orin-nano/verify-your-system)
- [Schnittstellen & Hardware-Layout](/de/tutorials/jetson-orin-nano/interfaces)
- [Produktübersicht](/de/tutorials/jetson-orin-nano/overview)
- [Lokale LLM-Inferenz](/de/tutorials/jetson-orin-nano/local-llm)
- [Agentic AI (NemoClaw)](/de/tutorials/jetson-orin-nano/agentic-ai)
- [DeepStream-Videoanalyse](/de/tutorials/jetson-orin-nano/deepstream)
- [Robotik (Stand der Dinge)](/de/tutorials/jetson-orin-nano/robotics)
- [Speichereffizienz](/de/tutorials/jetson-orin-nano/memory-efficiency)
- [Migration von JetPack 6.x](/de/tutorials/jetson-orin-nano/jetpack-6-to-7)
- [Downloads & offizielle Links](/de/tutorials/jetson-orin-nano/downloads)
- [FAQ](/de/tutorials/jetson-orin-nano/faq)
- [Fehlerbehebung](/de/tutorials/jetson-orin-nano/troubleshooting)
- [Glossar](/de/tutorials/jetson-orin-nano/glossary)
- [Changelog](/de/tutorials/jetson-orin-nano/changelog)
- [XLeRobot Docker — 01 · Überblick](/de/tutorials/jetson-orin-nano/xlerobot-docker/deployment/01-Overview)
- [XLeRobot Docker — 02 · Umgebung einrichten](/de/tutorials/jetson-orin-nano/xlerobot-docker/deployment/02-Environment-Setup)
- [XLeRobot Docker — 03 · Bereitstellung](/de/tutorials/jetson-orin-nano/xlerobot-docker/deployment/03-Deployment)
- [XLeRobot Docker — Original-LeRobot-Befehle](/de/tutorials/jetson-orin-nano/xlerobot-docker/lerobot/01-Operation)
- [XLeRobot Docker — XLeRobot-Befehle](/de/tutorials/jetson-orin-nano/xlerobot-docker/xlerobot/01-Operation)
- [XLeRobot Docker — Fehlerbehebung und Schnellreferenz](/de/tutorials/jetson-orin-nano/xlerobot-docker/troubleshooting/01-Troubleshooting)

### Lernressourcen

- [Lernressourcen](/de/tutorials/learning-resources/)
- [PyTorch-Inkompatibilitäten auf Jetson Orin](/de/tutorials/learning-resources/jetson-orin-pytorch-compatibility)

### Roboterarme

- [Serie Roboterarme](/de/tutorials/robot-arms/)
- [Auswahlhilfe](/de/tutorials/robot-arms/select-guide)
  - **SO-ARM101-Serie**
    - [SO-ARM101 Roboterarm-Tutorials](/de/tutorials/robot-arms/so-arm101/)
    - [LeRobot-Roboterarm-Tutorial](/de/tutorials/robot-arms/so-arm101/SO-ARM101-Tutorial)
    - [Lerobot-Roboterarm-Montageanleitung](/de/tutorials/robot-arms/so-arm101/SO-ARM101-Assembly)
    - [PyTorch-Inkompatibilität auf Jetson Orin](/de/tutorials/robot-arms/so-arm101/SO-ARM101-Jetson-Orin-PyTorch-Compatibility)
    - [SO-ARM100&101 Armhalterung und Umgebungskamera-Kit – Montage-Tutorial](/de/tutorials/robot-arms/so-arm101/SO-ARM101-100-Arm-Mount-Camera-Kit-Installation)
    - [Overhead-Kamera-Halterung Montage](/de/tutorials/robot-arms/so-arm101/SO-ARM101-Overhead-Camera-Mount-Installation)
    - [SO-ARM101 Drahtlose Teleoperation (ESP32-NanoCam-Version)](/de/tutorials/robot-arms/so-arm101/SO-ARM101-NanoCam-Wireless-Teleop)
    - [Teleoperation-Fehlerbehebung](/de/tutorials/robot-arms/so-arm101/SO-ARM101-NanoCam-Troubleshooting)
    - [SO-ARM101 Zweiarm-Tutorial (zwei Folgearme)](/de/tutorials/robot-arms/so-arm101/SO-ARM101-Bi-Arm-Tutorial)
    - [SoARM-Servo-Kalibrierungstool – Anleitung](/de/tutorials/robot-arms/so-arm101/SO-ARM101-Servo-Calibration-Tool)
    - [So-ARM-Serie STS3215 Servo-Kalibrierung – Web-Version](/de/tutorials/robot-arms/so-arm101/SO-ARM101-Web-Calibration)
      - **LeRobot-Komplettkurs**
        - [LeRobot-Komplettkurs](/de/tutorials/robot-arms/so-arm101/lerobot/)
          - **1. LeRobot-Umgebung**
            - [Schritt 1: LeRobot-Umgebung installieren (Ubuntu)](/de/tutorials/robot-arms/so-arm101/lerobot/01-Environment-Setup/Ubuntu)
            - [Schritt 1: LeRobot-Umgebung installieren (Windows)](/de/tutorials/robot-arms/so-arm101/lerobot/01-Environment-Setup/Windows)
            - [Schritt 1: LeRobot-Umgebung installieren (macOS)](/de/tutorials/robot-arms/so-arm101/lerobot/01-Environment-Setup/MacOS)
          - **2. Serielle Ports**
            - [Schritt 2: Ports der seriellen Geräte anzeigen (Ubuntu)](/de/tutorials/robot-arms/so-arm101/lerobot/02-Serial-Port/Ubuntu)
            - [Schritt 2: Ports der seriellen Geräte anzeigen (Windows)](/de/tutorials/robot-arms/so-arm101/lerobot/02-Serial-Port/Windows)
            - [Schritt 2: Ports der seriellen Geräte anzeigen (macOS)](/de/tutorials/robot-arms/so-arm101/lerobot/02-Serial-Port/MacOS)
          - **3. Kalibrierung**
            - [Schritt 3: Roboterarm kalibrieren (Ubuntu)](/de/tutorials/robot-arms/so-arm101/lerobot/03-Calibration/Ubuntu)
            - [Schritt 3: Roboterarm kalibrieren (Windows)](/de/tutorials/robot-arms/so-arm101/lerobot/03-Calibration/Windows)
            - [Schritt 3: Roboterarm kalibrieren (macOS)](/de/tutorials/robot-arms/so-arm101/lerobot/03-Calibration/MacOS)
          - **4. Teleoperation**
            - [Schritt 4: Teleoperation (Ubuntu)](/de/tutorials/robot-arms/so-arm101/lerobot/04-Teleoperation/Ubuntu)
            - [Schritt 4: Teleoperation (Windows)](/de/tutorials/robot-arms/so-arm101/lerobot/04-Teleoperation/Windows)
            - [Schritt 4: Teleoperation (macOS)](/de/tutorials/robot-arms/so-arm101/lerobot/04-Teleoperation/MacOS)
          - **5. Teleop mit Kamera**
            - [Schritt 5: Teleoperation mit Kamera (Ubuntu)](/de/tutorials/robot-arms/so-arm101/lerobot/05-Camera-Teleoperation/Ubuntu)
            - [Schritt 5: Teleoperation mit Kamera (Windows)](/de/tutorials/robot-arms/so-arm101/lerobot/05-Camera-Teleoperation/Windows)
            - [Schritt 5: Teleoperation mit Kamera (macOS)](/de/tutorials/robot-arms/so-arm101/lerobot/05-Camera-Teleoperation/MacOS)
          - **6. Datenerfassung**
            - [Schritt 6: Datensatz durch Demonstration erfassen](/de/tutorials/robot-arms/so-arm101/lerobot/06-Data-Collection/Teaching-and-Recording)
            - [Schritt 6: Datensatz durch Vorführen aufnehmen – Handshake 200](/de/tutorials/robot-arms/so-arm101/lerobot/06-Data-Collection/Teaching-and-Recording-Handshake-200)
            - [Schritt 6: Datensatz ansehen und wiedergeben](/de/tutorials/robot-arms/so-arm101/lerobot/06-Data-Collection/Browse-and-Replay)
            - [Schritt 6: Hinweise zum Erfassen von Datensätzen](/de/tutorials/robot-arms/so-arm101/lerobot/06-Data-Collection/Collection-Notes)
            - [Schritt 6: Hugging-Face-Konto registrieren (optional)](/de/tutorials/robot-arms/so-arm101/lerobot/06-Data-Collection/HF-Account)
            - [Schritt 6: Datensatz auf HuggingFace hochladen (optional)](/de/tutorials/robot-arms/so-arm101/lerobot/06-Data-Collection/HF-Dataset-Upload)
            - [Schritt 7 (Simulation): Datensatz aufnehmen – Lightwheel-LeIsaac-Teleoperation](/de/tutorials/robot-arms/so-arm101/lerobot/06-Data-Collection/LeIsaac-Sim)
          - **7. Modelltraining**
            - [Schritt 7: Lokales Training unter Ubuntu](/de/tutorials/robot-arms/so-arm101/lerobot/07-Training/Local-Ubuntu)
            - [Schritt 7: Cloud-GPU-Trainingsumgebung einrichten](/de/tutorials/robot-arms/so-arm101/lerobot/07-Training/Cloud-GPU)
            - [Schritt 7: Trainingskurven in Echtzeit mit wandb anzeigen](/de/tutorials/robot-arms/so-arm101/lerobot/07-Training/WandB-Curves)
            - [Schritt 7: Modell zu HuggingFace hochladen (optional)](/de/tutorials/robot-arms/so-arm101/lerobot/07-Training/HF-Model-Upload)
            - [Schritt 7: Modelldateien abrufen](/de/tutorials/robot-arms/so-arm101/lerobot/07-Training/Model-Weights)
            - [Schritt 7: Trainingsbefehl für ACT](/de/tutorials/robot-arms/so-arm101/lerobot/07-Training/Command-ACT)
            - [Schritt 7: Trainingsbefehl für pi0](/de/tutorials/robot-arms/so-arm101/lerobot/07-Training/Command-pi0)
            - [Schritt 7: Trainingsbefehl für pi0.5](/de/tutorials/robot-arms/so-arm101/lerobot/07-Training/Command-pi0.5)
            - [Schritt 7: Trainingsbefehl für pi0fast](/de/tutorials/robot-arms/so-arm101/lerobot/07-Training/Command-pi0fast)
            - [Schritt 7: Trainingsbefehl für SmolVLA](/de/tutorials/robot-arms/so-arm101/lerobot/07-Training/Command-smolvla)
            - [Schritt 7: Trainingsbefehl für Diffusion](/de/tutorials/robot-arms/so-arm101/lerobot/07-Training/Command-Diffusion)
            - [Schritt 7: Trainingsbefehl für WALL-OSS](/de/tutorials/robot-arms/so-arm101/lerobot/07-Training/Command-Wall-OSS)
            - [Schritt 7: Trainings-Kommandozeile](/de/tutorials/robot-arms/so-arm101/lerobot/07-Training/Train-CLI)
            - [Schritt 7: Empfehlungen für Trainingsparameter](/de/tutorials/robot-arms/so-arm101/lerobot/07-Training/Training-Parameters)
            - [Schritt 7: Von LeRobot unterstützte Imitationslern-Algorithmen](/de/tutorials/robot-arms/so-arm101/lerobot/07-Training/Imitation-Learning-Algorithms)
          - **8. Modell-Inferenz**
            - [Schritt 8: Erläuterung der Befehle](/de/tutorials/robot-arms/so-arm101/lerobot/08-Inference/CLI-Reference)
            - [Schritt 8: Häufige Bugs und Lösungen](/de/tutorials/robot-arms/so-arm101/lerobot/08-Inference/Common-Bugs)
            - [Schritt 8: Deploy-Befehl für ACT](/de/tutorials/robot-arms/so-arm101/lerobot/08-Inference/Command-ACT)
            - [Schritt 8: Deploy-Befehl für pi0](/de/tutorials/robot-arms/so-arm101/lerobot/08-Inference/Command-pi0)
            - [Schritt 8: Deploy-Befehl für pi0.5](/de/tutorials/robot-arms/so-arm101/lerobot/08-Inference/Command-pi0.5)
            - [Schritt 8: Deploy-Befehl für SmolVLA](/de/tutorials/robot-arms/so-arm101/lerobot/08-Inference/Command-smolvla)
            - [Schritt 8: Inferenzbefehl für Diffusion](/de/tutorials/robot-arms/so-arm101/lerobot/08-Inference/Command-Diffusion)
            - [Schritt 8: Inferenzbefehl für WALL-OSS](/de/tutorials/robot-arms/so-arm101/lerobot/08-Inference/Command-Wall-OSS)
            - [Schritt 8: Inferenz auf NVIDIA DGX Spark](/de/tutorials/robot-arms/so-arm101/lerobot/08-Inference/DGX-Spark)
            - [Schritt 8: Inferenz auf D-Robotics RDK S100](/de/tutorials/robot-arms/so-arm101/lerobot/08-Inference/RDK-S100)
          - **Grundlagen**
            - [LeRobot kennenlernen](/de/tutorials/robot-arms/so-arm101/basics/Understanding-LeRobot)
            - [LeRobot-Datensätze auf HuggingFace](/de/tutorials/robot-arms/so-arm101/basics/HF-Datasets)
            - [Materialien zum Modelltraining](/de/tutorials/robot-arms/so-arm101/basics/Training-Resources)
            - [Offizielle 3D-Druckdateien für den SO-ARM 100 Roboterarm](/de/tutorials/robot-arms/so-arm101/basics/Official-3D-Print-Files)
            - [URDF-Dateien und Referenzmaterial](/de/tutorials/robot-arms/so-arm101/basics/URDF-Reference)
            - [Empfohlene Kamera-Halterungen und -Montagevorrichtungen](/de/tutorials/robot-arms/so-arm101/basics/Camera-Mounts-Recommended)
          - **Weitere Themen**
            - [ROS2-Simulationssteuerung](/de/tutorials/robot-arms/so-arm101/ROS2-Simulation-Control)
            - [Montageanleitung für den Parallelbacken-Greifer](/de/tutorials/robot-arms/so-arm101/Parallel-Finger-Gripper-Installation)
      - **LeLab-Tutorial**
        - [1 · Überblick](/de/tutorials/robot-arms/so-arm101/lelab/01-Overview)
        - [2 · Installation und Start](/de/tutorials/robot-arms/so-arm101/lelab/02-Install)
        - [3 · Verbinden und kalibrieren](/de/tutorials/robot-arms/so-arm101/lelab/03-Calibration)
        - [4 · Teleoperation](/de/tutorials/robot-arms/so-arm101/lelab/04-Teleoperation)
        - [5 · Ein Dataset aufzeichnen](/de/tutorials/robot-arms/so-arm101/lelab/05-Record-Dataset)
        - [6 · Trainieren und Inferenz ausführen](/de/tutorials/robot-arms/so-arm101/lelab/06-Train-and-Inference)
        - [7 · Fehlerbehebung](/de/tutorials/robot-arms/so-arm101/lelab/07-Troubleshooting)
      - **MuJoCo-Simulations-Tutorial**,        - [SO-ARM101 × MuJoCo – Tutorial für den kompletten Workflow (Index)](/de/tutorials/robot-arms/so-arm101/mujoco/),        - [01 · Umgebung einrichten](/de/tutorials/robot-arms/so-arm101/mujoco/01-Environment),        - [02 · Validierung des Simulationsmodells (MJCF laden und ansteuern)](/de/tutorials/robot-arms/so-arm101/mujoco/02-Sim-Model-Verification),        - [03 · Verbindung zum realen Roboter und Kalibrierung](/de/tutorials/robot-arms/so-arm101/mujoco/03-Hardware-Calibration),        - [04 · Tastatur-Teleoperation](/de/tutorials/robot-arms/so-arm101/mujoco/04-Keyboard-Teleop),        - [05 · Digitaler Zwilling des Leader-Arms (physischer Arm steuert simulierten Arm)](/de/tutorials/robot-arms/so-arm101/mujoco/05-Leader-Digital-Twin),        - [06 · Datenaufzeichnung und -wiedergabe](/de/tutorials/robot-arms/so-arm101/mujoco/06-Record-and-Replay),        - [07 · Häufige Probleme und Erfahrungen](/de/tutorials/robot-arms/so-arm101/mujoco/07-Troubleshooting),        - [08 · Weiterer Fahrplan](/de/tutorials/robot-arms/so-arm101/mujoco/08-Roadmap),        - [09 · Vollständiges Nutzungstutorial (Arm starten → Dataset → Videos ansehen → Training → Deployment)](/de/tutorials/robot-arms/so-arm101/mujoco/09-Usage-Tutorial)
  - **SO-ARM101 + AmazingHand Kurs**
    - [Kursübersicht](/de/tutorials/robot-arms/so-arm-amazinghand/)
      - **Linux**
        - [Phase 1: Umgebung einrichten (Linux)](/de/tutorials/robot-arms/so-arm-amazinghand/01-Environment-Setup-Linux)
        - [Stufe 2: Hand- & Arm-Kalibrierung (Linux)](/de/tutorials/robot-arms/so-arm-amazinghand/02-Hand-Arm-Calibration-Linux)
        - [Phase 3: Teleoperation (Linux)](/de/tutorials/robot-arms/so-arm-amazinghand/03-Teleoperation-Linux)
        - [Phase 4: Datenerfassung (Linux)](/de/tutorials/robot-arms/so-arm-amazinghand/04-Data-Collection-Linux)
        - [Phase 5: Modelltraining (Linux)](/de/tutorials/robot-arms/so-arm-amazinghand/05-Model-Training-Linux)
        - [Stufe 6: Modell-Deployment (Linux)](/de/tutorials/robot-arms/so-arm-amazinghand/06-Model-Deployment-Linux)
      - **Windows**
        - [Phase 1: Umgebung einrichten (Windows)](/de/tutorials/robot-arms/so-arm-amazinghand/01-Environment-Setup-Windows)
        - [Stufe 2: Hand- & Arm-Kalibrierung (Windows)](/de/tutorials/robot-arms/so-arm-amazinghand/02-Hand-Arm-Calibration-Windows)
        - [Phase 3: Teleoperation (Windows)](/de/tutorials/robot-arms/so-arm-amazinghand/03-Teleoperation-Windows)
        - [Phase 4: Datenerfassung (Windows)](/de/tutorials/robot-arms/so-arm-amazinghand/04-Data-Collection-Windows)
        - [Phase 5: Modelltraining (Windows)](/de/tutorials/robot-arms/so-arm-amazinghand/05-Model-Training-Windows)
        - [Stufe 6: Modell-Deployment (Windows)](/de/tutorials/robot-arms/so-arm-amazinghand/06-Model-Deployment-Windows)
  - **XLeRobot-Tutorials**
    - [Tutorial-Übersicht](/de/tutorials/robot-arms/xlerobot/)
    - [Umgebung einrichten (macOS)](/de/tutorials/robot-arms/xlerobot/01-Environment-Setup-macOS)
    - [Umgebung einrichten (Ubuntu)](/de/tutorials/robot-arms/xlerobot/01-Environment-Setup-Ubuntu)
    - [Umgebung einrichten (Windows)](/de/tutorials/robot-arms/xlerobot/01-Environment-Setup-Windows)
    - [XLeRobot-Dateien verschieben](/de/tutorials/robot-arms/xlerobot/02-Move-Xlerobot-Files)
    - [Montage (fertiger Bausatz)](/de/tutorials/robot-arms/xlerobot/03-Assembly-Assembled-Kit)
    - [Montage (Einzelteile)](/de/tutorials/robot-arms/xlerobot/04-Assembly-Parts-Kit)
  - **AmazingHand-Dexterhand-Tutorial – Übersicht**
    - [Tutorial-Index (inkl. alter URLs)](/de/tutorials/robot-arms/amazing-hand/index.md)
    - [AmazingHand-Dexterhand-Tutorial – Übersicht](/de/tutorials/robot-arms/amazing-hand/README)
    - [AmazingHand-Produktinformationen](/de/tutorials/robot-arms/amazing-hand/00-product/product-info)
    - [SCS0009- und PWM-Version im Vergleich und Auswahl](/de/tutorials/robot-arms/amazing-hand/00-product/version-comparison)
    - [Downloads und Ressourcen](/de/tutorials/robot-arms/amazing-hand/00-product/downloads)
    - [Hardware-Übersicht: Struktur, CAD und Montage](/de/tutorials/robot-arms/amazing-hand/01-hardware/overview)
    - [SCS0009-Verkabelung, IDs und Stromversorgung](/de/tutorials/robot-arms/amazing-hand/01-hardware/scs0009)
    - [PWM-Verkabelung, GPIO und Stromversorgung](/de/tutorials/robot-arms/amazing-hand/01-hardware/pwm)
    - [Installation des Umgebungskamera-Kits](/de/tutorials/robot-arms/amazing-hand/01-hardware/camera-kit)
    - [SCS0009-Schnellstart](/de/tutorials/robot-arms/amazing-hand/02-quick-start/scs0009)
    - [PWM-Schnellstart](/de/tutorials/robot-arms/amazing-hand/02-quick-start/pwm)
    - [AmazingHand-Websteuerung](/de/tutorials/robot-arms/amazing-hand/03-web-control/README)
    - [SCS0009-Websteuerung](/de/tutorials/robot-arms/amazing-hand/03-web-control/scs0009)
    - [PWM-Websteuerung](/de/tutorials/robot-arms/amazing-hand/03-web-control/pwm)
    - [SCS0009-Desktop-GUI (GUI und CLI)](/de/tutorials/robot-arms/amazing-hand/04-desktop/scs0009)
    - [PWM-Desktop-GUI (Tkinter-GUI)](/de/tutorials/robot-arms/amazing-hand/04-desktop/pwm)
    - [SCS0009-Handtracking (offizielles dora-Demo)](/de/tutorials/robot-arms/amazing-hand/05-hand-tracking/scs0009)
    - [PWM-Handtracking (integriertes MediaPipe in der GUI)](/de/tutorials/robot-arms/amazing-hand/05-hand-tracking/pwm)
    - [SCS0009-Servo-Debugging und Kalibrierung](/de/tutorials/robot-arms/amazing-hand/06-servo-tuning/scs0009)
    - [PWM-Servo-Protokoll, Befehle und Kalibrierung](/de/tutorials/robot-arms/amazing-hand/06-servo-tuning/pwm)
    - [Arduino Nano – Anleitung](/de/tutorials/robot-arms/amazing-hand/07-arduino/arduino-nano)
    - [Arduino- und Python-Beispiele](/de/tutorials/robot-arms/amazing-hand/07-arduino/examples)
    - [Häufige Fragen (FAQ)](/de/tutorials/robot-arms/amazing-hand/08-faq/faq)
  - **Lekiwi**
    - [Lekiwi-Mobilitätsroboter – Bedienungstutorial](/de/tutorials/robot-arms/lekiwi/Lekiwi-Tutorial)
    - [Lekiwi-Mobilitätsroboter – Montage-Tutorial](/de/tutorials/robot-arms/lekiwi/Lekiwi-Assembly)
  - **SR-Support Selbstaufrichtender Roboter – Tutorial**
    - [SR-Support Selbstaufrichtender Roboter – Tutorial](/de/tutorials/robot-arms/sr-support/)
    - [01 Grundlagen](/de/tutorials/robot-arms/sr-support/01-basics)
    - [02 Umgebungseinrichtung (venv, Flash-Tools und Firmware)](/de/tutorials/robot-arms/sr-support/02-environment)
    - [03 Hauptfirmware flashen](/de/tutorials/robot-arms/sr-support/03-build-flash)
    - [04 Montage: Drucken, Bauen, Verkabeln](/de/tutorials/robot-arms/sr-support/04-assembly)
    - [05 Nullpunkt-Kalibrierung (Pfeiltasten; erforderlich für DIY-Bauten)](/de/tutorials/robot-arms/sr-support/05-zero-tool)
    - [06 Debug und Kalibrierung](/de/tutorials/robot-arms/sr-support/06-debug-and-calibrate)
    - [07 Selbstaufrichtung: Anwendung und Überwachung](/de/tutorials/robot-arms/sr-support/07-self-righting)
    - [08 WLAN-Statusseite und Einrichtung im Heimnetz](/de/tutorials/robot-arms/sr-support/08-wifi)
    - [09 MuJoCo-Simulation und der Live-Zwilling](/de/tutorials/robot-arms/sr-support/09-mujoco)
    - [10 Fehlerbehebung](/de/tutorials/robot-arms/sr-support/10-troubleshooting)
    - [11 Referenz: Modell, Parameter und Lizenzierung](/de/tutorials/robot-arms/sr-support/11-reference)

### Sensoren

- [Sensoren & Wahrnehmung](/de/tutorials/sensors/)
- [IMU-Kalibrierung](/de/tutorials/sensors/imu/calibration)
- [Remote-Dateiübertragung](/de/tutorials/sensors/imu/remote-file-transfer)
- [SSH-Dateiübertragung](/de/tutorials/sensors/imu/ssh-file-transfer)
  - **IMU-Trägheitsnavigation**
    - [Produktinformation](/de/tutorials/sensors/imu/product-info)
    - [Web-Host-Konsole](/de/tutorials/sensors/imu/web-host-console)
    - [MicroDuck-Integration](/de/tutorials/sensors/imu/microduck-integration)
      - **Multi-Board-Beispiele**
        - [Multi-Host-Kommunikationsfälle Übersicht](/de/tutorials/sensors/imu/multi-board-examples/overview)
        - [PC-Kommunikation](/de/tutorials/sensors/imu/multi-board-examples/pc-communication)
          - **I2C-Kommunikation**
            - [Arduino](/de/tutorials/sensors/imu/multi-board-examples/i2c-communication/arduino)
            - [Jetson-Serie](/de/tutorials/sensors/imu/multi-board-examples/i2c-communication/jetson)
            - [Raspberry Pi 5](/de/tutorials/sensors/imu/multi-board-examples/i2c-communication/raspberry-pi)
            - [RDK-Serie](/de/tutorials/sensors/imu/multi-board-examples/i2c-communication/rdk)
            - [STM32 F103C8T6](/de/tutorials/sensors/imu/multi-board-examples/i2c-communication/stm32)
          - **Serielle Kommunikation**
            - [Arduino](/de/tutorials/sensors/imu/multi-board-examples/serial-communication/arduino)
            - [Jetson-Serie](/de/tutorials/sensors/imu/multi-board-examples/serial-communication/jetson)
            - [Raspberry Pi 5](/de/tutorials/sensors/imu/multi-board-examples/serial-communication/raspberry-pi)
            - [RDK-Serie](/de/tutorials/sensors/imu/multi-board-examples/serial-communication/rdk)
            - [STM32 F103C8T6](/de/tutorials/sensors/imu/multi-board-examples/serial-communication/stm32)
      - **ROS-Beispiele**
        - [ROS1-Anwendung](/de/tutorials/sensors/imu/ros-examples/ros1)
        - [ROS2-Anwendung](/de/tutorials/sensors/imu/ros-examples/ros2)
  - **GPS- & BeiDou-Modul**
    - [Modul-Informationen](/de/tutorials/sensors/gps/GPS-Module-Info)
    - [51-MCU: GPS-Auswertung](/de/tutorials/sensors/gps/51-MCU-GPS-Parsing)
    - [Arduino: Positionsausgabe](/de/tutorials/sensors/gps/Arduino-Location-Reading)
    - [Arduino: Positionsauswertung](/de/tutorials/sensors/gps/Arduino-Location-Parsing)
    - [STM32F103: GPS-Auswertung](/de/tutorials/sensors/gps/STM32F103-GPS-Parsing)
    - [Jetson: GPS-Auswertung](/de/tutorials/sensors/gps/Jetson-GPS-Parsing)
    - [Jetson: AGNSS-Unterstützung](/de/tutorials/sensors/gps/Jetson-AGNSS)
    - [Jetson: Baidu-Maps-API](/de/tutorials/sensors/gps/Jetson-Baidu-Map-API)
    - [Raspberry Pi: GPS-Auswertung](/de/tutorials/sensors/gps/RaspberryPi-GPS-Parsing)
    - [Raspberry Pi: AGNSS-Unterstützung](/de/tutorials/sensors/gps/RaspberryPi-AGNSS)
    - [Raspberry Pi: Baidu-Maps-API](/de/tutorials/sensors/gps/RaspberryPi-Baidu-Map-API)
    - [ROS: Vorbereitung](/de/tutorials/sensors/gps/ROS-Preparation)
    - [ROS: GPS-Daten lesen](/de/tutorials/sensors/gps/ROS-Read-GPS-Data)
    - [ROS: GPS-Spur zeichnen](/de/tutorials/sensors/gps/ROS-Draw-GPS-Track)
    - [Kartenpositionsfehler](/de/tutorials/sensors/gps/Map-Location-Error)

### Zubehör

- [Roboter-Accessoires](/de/tutorials/accessories/)
  - [USB-Kamera mit Autofokus](/de/tutorials/accessories/usb-auto-focus-camera)
  - [Jetson-CSI-Kamera](/de/tutorials/accessories/jetson-csi-camera)
    - **KWS-Spracherkennungsmodul**
      - [Tutorial-Startseite](/de/tutorials/accessories/KWS-speech-recognition-module/)
      - [Jetson Nano serielle Kommunikation](/de/tutorials/accessories/KWS-speech-recognition-module/Jetson-Nano-serial-communication)
      - [Jetson serielle Kommunikation](/de/tutorials/accessories/KWS-speech-recognition-module/Jetson-serial-communication)
      - [PC serielle Kommunikation](/de/tutorials/accessories/KWS-speech-recognition-module/PC-serial-communication)
      - [Raspberry Pi serielle Kommunikation](/de/tutorials/accessories/KWS-speech-recognition-module/raspberry-pi-serial-communication)
      - [ROS2 RViz2-Visualisierung](/de/tutorials/accessories/KWS-speech-recognition-module/ROS2-rviz2-visualization)
      - [Firmware für Wake-Wörter herunterladen und flashen](/de/tutorials/accessories/KWS-speech-recognition-module/download-and-burn-firmware-for-chinese-and-english-recognition-words)
    - **Feetech-Servo**
      - [STS3215 & SCS0009 – Debug-Tutorial](/de/tutorials/accessories/feetech/Feetech-STS3215&SCS0009-Tutorial)
      - [SCS-Kommunikationsprotokoll](/de/tutorials/accessories/feetech/Feetech-SCS_Communication_Protocol)
      - [Magnetencoder-STS-Servo – Speichertabelle](/de/tutorials/accessories/feetech/Feetech-Magnetic_Encoder_STS_Servo-Memory_Table_Analysis)
      - [Potentiometer-SCSCL-Servo – Speichertabelle](/de/tutorials/accessories/feetech/Feetech-Potentiometer_SCSCL_Servo-Memory_Table_Analysis)
      - [SCS0009-Servo-Debug-Tool – Anleitung](/de/tutorials/accessories/feetech/SCS0009-Debug-Tool)
    - [Feetech-Busservo-Web-Debugger (SCS0009 / STS3215 / HD1910)](/de/tutorials/accessories/feetech/Feetech-Web-Debugger)
    - **ESP32-NanoCam Videoübertragungsmodul**
      - [ESP32-NanoCam Schnellstart](/de/tutorials/accessories/esp32-nanocam/ESP32-NanoCam-Quick-Start)
      - [ESP32-NanoCam Hardware-Spezifikation](/de/tutorials/accessories/esp32-nanocam/ESP32-NanoCam-Hardware-Spec)
      - [ESP32-NanoCam Handbuch zum seriellen Protokoll](/de/tutorials/accessories/esp32-nanocam/ESP32-NanoCam-Serial-Protocol)
        - **KI-Vision-Tutorial (11 Kapitel)**
          - [Kapitel 1: Umgebungseinrichtung](/de/tutorials/accessories/esp32-nanocam/Ch01-Environment-Setup)
          - [Kapitel 2: Schnellstart](/de/tutorials/accessories/esp32-nanocam/Ch02-Quick-Start)
          - [Kapitel 3: Kamera-Grundlagen](/de/tutorials/accessories/esp32-nanocam/Ch03-Camera-Basics)
          - [Kapitel 4: Gesichtsdetektion](/de/tutorials/accessories/esp32-nanocam/Ch04-Face-Detection)
          - [Kapitel 5: Katzengesichtsdetektion](/de/tutorials/accessories/esp32-nanocam/Ch05-Cat-Face-Detection)
          - [Kapitel 6: Farberkennung](/de/tutorials/accessories/esp32-nanocam/Ch06-Color-Recognition)
          - [Kapitel 7: QR-Code-Scanning](/de/tutorials/accessories/esp32-nanocam/Ch07-QR-Code-Scanning)
          - [Kapitel 8: Gesichtserkennung](/de/tutorials/accessories/esp32-nanocam/Ch08-Face-Recognition)
          - [Kapitel 9: Sprachdialog](/de/tutorials/accessories/esp32-nanocam/Ch09-Voice-Chat)
          - [Kapitel 10: KI-Bildverständnis](/de/tutorials/accessories/esp32-nanocam/Ch10-AI-Vision-Understanding)
          - [Kapitel 11: ESP-Claw-Sprachsteuerung](/de/tutorials/accessories/esp32-nanocam/Ch11-ESP-Claw-Voice-Control)
    - **CSI-Kamera-Tutorials**
      - [Jetson CSI-Kamera einrichten](/de/tutorials/accessories/csi-camera/01-Jetson-CSI-Setup)
      - [Autofokus-Kamera verwenden](/de/tutorials/accessories/csi-camera/02-Auto-Focus-Camera)
      - [Jupyter Lab verwenden](/de/tutorials/accessories/csi-camera/03-JupyterLab)
      - [JetCam verwenden](/de/tutorials/accessories/csi-camera/04-JetCam)
      - [IMX219 am Raspberry Pi](/de/tutorials/accessories/csi-camera/05-IMX219-RaspberryPi)
    - **AI-Sprachinteraktionsmodul**
      - [Schnellstart](/de/tutorials/accessories/ai-voice-module/Quick-Start)
      - [Produktinformationen](/de/tutorials/accessories/ai-voice-module/Product-Info)
      - [Flashen der Modul-Firmware](/de/tutorials/accessories/ai-voice-module/Firmware-Flashing)
      - [Weckwort und Befehlswörter ändern](/de/tutorials/accessories/ai-voice-module/Wake-Word-Commands-Edit)
      - [Benutzerdefinierte Protokolleinträge erstellen](/de/tutorials/accessories/ai-voice-module/Custom-Protocol-Entries)
      - [ROS1-Sprachinteraktion](/de/tutorials/accessories/ai-voice-module/ROS1-Voice-Interaction)
      - [ROS2-Sprachinteraktion](/de/tutorials/accessories/ai-voice-module/ROS2-Voice-Interaction)
      - [Serielles Protokoll](/de/tutorials/accessories/ai-voice-module/Serial-Protocol)
      - [IIC-Protokoll](/de/tutorials/accessories/ai-voice-module/IIC-Protocol)
      - [PC-Kommunikation](/de/tutorials/accessories/ai-voice-module/PC-Communication)
      - [Arduino: Serielle Kommunikation](/de/tutorials/accessories/ai-voice-module/Arduino-Serial-Communication)
      - [Arduino: IIC-Kommunikation](/de/tutorials/accessories/ai-voice-module/Arduino-IIC-Communication)
      - [Jetson: Serielle Kommunikation](/de/tutorials/accessories/ai-voice-module/Jetson-Serial-Communication)
      - [Jetson: IIC-Kommunikation](/de/tutorials/accessories/ai-voice-module/Jetson-IIC-Communication)
      - [RDK: Serielle Kommunikation](/de/tutorials/accessories/ai-voice-module/RDK-Serial-Communication)
      - [RDK: IIC-Kommunikation](/de/tutorials/accessories/ai-voice-module/RDK-IIC-Communication)
      - [Raspberry Pi: Serielle Kommunikation](/de/tutorials/accessories/ai-voice-module/RaspberryPi-Serial-Communication)
      - [Raspberry Pi: IIC-Kommunikation](/de/tutorials/accessories/ai-voice-module/RaspberryPi-IIC-Communication)
  - [2-DOF-Gimbal](/de/tutorials/accessories/2dof-camera-gimbal)
- [Herzfrequenz- und SpO2-Sensor](/de/tutorials/accessories/heart-rate-spo2)
- [0,91-Zoll-OLED-Display](/de/tutorials/accessories/0.91-oled-screen-tutorial)
- [4K-HDMI-Capture-Karte](/de/tutorials/accessories/4k-hdmi-capture-tutorial)
- [KVM-Switch](/de/tutorials/accessories/kvm-switch-tutorial)
- [KVM-Switch · Tutorial-Übersicht](/de/tutorials/accessories/kvm-switch/00-Overview-and-Quick-Start),- [01 · Umschalten zwischen zwei Computern (Taste & IR-Fernbedienung)](/de/tutorials/accessories/kvm-switch/01-Switching-Between-Two-Computers),- [02 · HUB-Funktion (eins zu drei)](/de/tutorials/accessories/kvm-switch/02-HUB-Function-One-to-Three),- [03 · Bluetooth](/de/tutorials/accessories/kvm-switch/03-Bluetooth),- [04 · TTL-Serieller Anschluss (drahtlose serielle Verbindung)](/de/tutorials/accessories/kvm-switch/04-TTL-Serial-Port),- [05 · 10-Pin-Erweiterungsheader](/de/tutorials/accessories/kvm-switch/05-10-Pin-Expansion-Header),- [06 · Host ohne Monitor (Capture-Card + OBS)](/de/tutorials/accessories/kvm-switch/06-Headless-Host-Capture-Card-and-OBS),- [07 · FAQ und Hinweise](/de/tutorials/accessories/kvm-switch/07-FAQ-and-Precautions)
- [USB-Soundkarte ohne Treiber](/de/tutorials/accessories/usb-audio-card-tutorial)

## So verwenden Sie die Seite

1. **Themenkategorie wählen**: Wählen Sie die passende Themenkategorie je nach Interesse oder Bedarf.
2. **Tutorial-Liste ansehen**: In jeder Themenkategorie finden Sie die verfügbaren Tutorials und Dokumente.
3. **Den Schritten folgen**: Folgen Sie den Schritten der Tutorials, um die Produkte Schritt für Schritt kennenzulernen und zu nutzen.
4. **Üben und ausprobieren**: Probieren Sie bei der praktischen Arbeit verschiedene Funktionen und Konfigurationen aus, um Erfahrung zu sammeln.

## Weitere Ressourcen

- Bei Fragen oder Anregungen besuchen Sie bitte unser GitHub-Repository und reichen Sie ein Issue ein.
- Folgen Sie unserem Blog und unseren Social-Media-Kanälen für die neuesten Produkt-Updates und Tutorial-Informationen.
