Juxi-Technology/wiki-documents/docs/content/es/tutorials/index.md

---
title: Tutoriales
titleTemplate: Tutoriales y guías de productos
description: "Explora todos los tutoriales, guías y ejemplos de productos para empezar rápidamente con los productos de Juxi Technology"
head:
  - [ meta, { property: "og:title", content: "Tutoriales | Tutoriales y guías de productos" } ]
  - [ meta, { property: "og:description", content: "Explora todos los tutoriales, guías y ejemplos de productos para empezar rápidamente con los productos de Juxi Technology" } ]
---

# Tutoriales

¡Bienvenido a la página de Tutoriales! Aquí encontrarás todos los tutoriales de uso de productos, guías de configuración y mejores prácticas para ayudarte a empezar rápidamente y aprovechar al máximo las capacidades del producto.

## Categorías temáticas

### Inicio rápido

- [FAQ](/es/tutorials/faq)
- [Introducción a ROS](/es/tutorials/ros-intro)
- [Lark Wiki](/es/tutorials/lark-wiki)

### Tutorial del brazo robótico SO-ARM101 de 7 ejes

- [Tutorial del brazo robótico SO-ARM101 de 7 ejes](/tutorials/robot-arms/so-arm101/lerobot-7dof/)
- **1. Instalar LeRobot**
  - [Equipo Ubuntu](/es/tutorials/robot-arms/so-arm101/lerobot-7dof/01-Environment-Setup/Ubuntu)
  - [Equipo Windows](/es/tutorials/robot-arms/so-arm101/lerobot-7dof/01-Environment-Setup/Windows)
  - [Equipo MAC](/es/tutorials/robot-arms/so-arm101/lerobot-7dof/01-Environment-Setup/MacOS)
- **2. Sustituir los archivos (adaptación a 7DOF)**
  - [Sustituir los archivos (adaptación a 7DOF)](/es/tutorials/robot-arms/so-arm101/lerobot-7dof/02-Replace-Files-7DOF)
- **3. Puerto serie**
  - [Ubuntu](/es/tutorials/robot-arms/so-arm101/lerobot-7dof/03-Serial-Port/Ubuntu)
  - [Equipo Windows](/es/tutorials/robot-arms/so-arm101/lerobot-7dof/03-Serial-Port/Windows)
  - [Equipo MAC](/es/tutorials/robot-arms/so-arm101/lerobot-7dof/03-Serial-Port/MacOS)
- **4. Calibración**
  - [Equipo Ubuntu](/es/tutorials/robot-arms/so-arm101/lerobot-7dof/04-Calibration/Ubuntu)
  - [Equipo Windows](/es/tutorials/robot-arms/so-arm101/lerobot-7dof/04-Calibration/Windows)
  - [Equipo Mac](/es/tutorials/robot-arms/so-arm101/lerobot-7dof/04-Calibration/MacOS)
- **5. Teleoperación**
  - [Equipo Ubuntu](/es/tutorials/robot-arms/so-arm101/lerobot-7dof/05-Teleoperation/Ubuntu)
  - [Equipo Windows](/es/tutorials/robot-arms/so-arm101/lerobot-7dof/05-Teleoperation/Windows)
  - [Equipo Mac](/es/tutorials/robot-arms/so-arm101/lerobot-7dof/05-Teleoperation/MacOS)
- **6. Cámara y teleop.**
  - [Equipo Ubuntu](/es/tutorials/robot-arms/so-arm101/lerobot-7dof/06-Camera-Teleoperation/Ubuntu)
  - [Equipo Windows](/es/tutorials/robot-arms/so-arm101/lerobot-7dof/06-Camera-Teleoperation/Windows)
  - [Equipo Mac](/es/tutorials/robot-arms/so-arm101/lerobot-7dof/06-Camera-Teleoperation/MacOS)
- **7. Conjunto de datos**
  - [Revisar y reproducir el conjunto de datos](/es/tutorials/robot-arms/so-arm101/lerobot-7dof/07-Data-Collection/Browse-and-Replay)
  - [Notas de la recopilación del conjunto de datos](/es/tutorials/robot-arms/so-arm101/lerobot-7dof/07-Data-Collection/Collection-Notes)
  - [Cuenta de Hugging Face (opcional)](/es/tutorials/robot-arms/so-arm101/lerobot-7dof/07-Data-Collection/HF-Account)
  - [Subir el conjunto de datos a HuggingFace (opcional)](/es/tutorials/robot-arms/so-arm101/lerobot-7dof/07-Data-Collection/HF-Dataset-Upload)
  - [Recopilación del conjunto de datos por enseñanza-Apretón de manos 200](/es/tutorials/robot-arms/so-arm101/lerobot-7dof/07-Data-Collection/Teaching-and-Recording-Handshake-200)
  - [Recopilación del conjunto de datos por enseñanza](/es/tutorials/robot-arms/so-arm101/lerobot-7dof/07-Data-Collection/Teaching-and-Recording)
- **8. Entrenamiento**
  - [Configuración del entorno de entrenamiento con GPU en la nube](/es/tutorials/robot-arms/so-arm101/lerobot-7dof/08-Training/Cloud-GPU)
  - [Línea de comandos de entrenamiento-ACT (recomendado para empezar)](/es/tutorials/robot-arms/so-arm101/lerobot-7dof/08-Training/Command-ACT)
  - [Línea de comandos de entrenamiento-Diffusion](/es/tutorials/robot-arms/so-arm101/lerobot-7dof/08-Training/Command-Diffusion)
  - [Línea de comandos de entrenamiento-pi0.5](/es/tutorials/robot-arms/so-arm101/lerobot-7dof/08-Training/Command-pi0.5)
  - [Línea de comandos de entrenamiento-pi0 (el de mejores resultados)](/es/tutorials/robot-arms/so-arm101/lerobot-7dof/08-Training/Command-pi0)
  - [Línea de comandos de entrenamiento-pi0fast](/es/tutorials/robot-arms/so-arm101/lerobot-7dof/08-Training/Command-pi0fast)
  - [Línea de comandos de entrenamiento-smolvla (recomendado para nivel avanzado)](/es/tutorials/robot-arms/so-arm101/lerobot-7dof/08-Training/Command-smolvla)
  - [Subir el modelo a HuggingFace (opcional)](/es/tutorials/robot-arms/so-arm101/lerobot-7dof/08-Training/HF-Model-Upload)
  - [Algoritmos de aprendizaje por imitación compatibles con LeRobot](/es/tutorials/robot-arms/so-arm101/lerobot-7dof/08-Training/Imitation-Learning-Algorithms)
  - [Entrenamiento local en Ubuntu](/es/tutorials/robot-arms/so-arm101/lerobot-7dof/08-Training/Local-Ubuntu)
  - [Obtener el archivo de pesos del modelo](/es/tutorials/robot-arms/so-arm101/lerobot-7dof/08-Training/Model-Weights)
  - [Recomendaciones de parámetros de entrenamiento](/es/tutorials/robot-arms/so-arm101/lerobot-7dof/08-Training/Training-Parameter-Tips)
  - [Curvas de entrenamiento en tiempo real con wandb](/es/tutorials/robot-arms/so-arm101/lerobot-7dof/08-Training/WandB-Curves)
- **9. Inferencia**
  - [Descripción de la línea de comandos](/es/tutorials/robot-arms/so-arm101/lerobot-7dof/09-Inference/CLI-Reference)
  - [Línea de comandos de inferencia-ACT](/es/tutorials/robot-arms/so-arm101/lerobot-7dof/09-Inference/Command-ACT)
  - [Línea de comandos de inferencia-Diffusion](/es/tutorials/robot-arms/so-arm101/lerobot-7dof/09-Inference/Command-Diffusion)
  - [Línea de comandos de inferencia-pi0.5](/es/tutorials/robot-arms/so-arm101/lerobot-7dof/09-Inference/Command-pi0.5)
  - [Línea de comandos de inferencia-pi0](/es/tutorials/robot-arms/so-arm101/lerobot-7dof/09-Inference/Command-pi0)
  - [Línea de comandos de inferencia-smolvla](/es/tutorials/robot-arms/so-arm101/lerobot-7dof/09-Inference/Command-smolvla)
  - [Bugs comunes y soluciones](/es/tutorials/robot-arms/so-arm101/lerobot-7dof/09-Inference/Common-Bugs)
  - [Inferencia en NVIDIA DGX Spark](/es/tutorials/robot-arms/so-arm101/lerobot-7dof/09-Inference/DGX-Spark)
  - [Inferencia en D-Robotics RDK S100](/es/tutorials/robot-arms/so-arm101/lerobot-7dof/09-Inference/RDK-S100)

### Kit de desarrollo Jetson AGX Orin

- [Inicio rápido](/es/tutorials/jetson-agx-orin/quick-start)
- [Flasheo y actualizaciones](/es/tutorials/jetson-agx-orin/flashing-and-updates)
- [Verificación del sistema](/es/tutorials/jetson-agx-orin/verify-your-system)
- [Interfaces y disposición del hardware](/es/tutorials/jetson-agx-orin/interfaces)
- [Descripción general del producto](/es/tutorials/jetson-agx-orin/overview)
- [Inferencia LLM local](/es/tutorials/jetson-agx-orin/local-llm)
- [IA agéntica (NemoClaw)](/es/tutorials/jetson-agx-orin/agentic-ai)
- [Análisis de video con DeepStream](/es/tutorials/jetson-agx-orin/deepstream)
- [Robótica (estado actual)](/es/tutorials/jetson-agx-orin/robotics)
- [Eficiencia de memoria](/es/tutorials/jetson-agx-orin/memory-efficiency)
- [Migrar desde JetPack 6.x](/es/tutorials/jetson-agx-orin/jetpack-6-to-7)
- [Descargas](/es/tutorials/jetson-agx-orin/downloads)
- [Preguntas frecuentes](/es/tutorials/jetson-agx-orin/faq)
- [Solución de problemas](/es/tutorials/jetson-agx-orin/troubleshooting)
- [Glosario](/es/tutorials/jetson-agx-orin/glossary)
- [Registro de cambios](/es/tutorials/jetson-agx-orin/changelog)
- [XLeRobot Docker — 01 · Resumen](/es/tutorials/jetson-agx-orin/xlerobot-docker/deployment/01-Overview)
- [XLeRobot Docker — 02 · Preparación del entorno](/es/tutorials/jetson-agx-orin/xlerobot-docker/deployment/02-Environment-Setup)
- [XLeRobot Docker — 03 · Despliegue](/es/tutorials/jetson-agx-orin/xlerobot-docker/deployment/03-Deployment)
- [XLeRobot Docker — Comandos de LeRobot original](/es/tutorials/jetson-agx-orin/xlerobot-docker/lerobot/01-Operation)
- [XLeRobot Docker — Comandos de XLeRobot](/es/tutorials/jetson-agx-orin/xlerobot-docker/xlerobot/01-Operation)
- [XLeRobot Docker — Solución de problemas y referencia rápida](/es/tutorials/jetson-agx-orin/xlerobot-docker/troubleshooting/01-Troubleshooting)

### Kit de desarrollo Jetson Orin Nano Super

- [Inicio rápido](/es/tutorials/jetson-orin-nano/quick-start)
- [Flasheo y actualizaciones](/es/tutorials/jetson-orin-nano/flashing-and-updates)
- [Verificación del sistema](/es/tutorials/jetson-orin-nano/verify-your-system)
- [Interfaces y disposición del hardware](/es/tutorials/jetson-orin-nano/interfaces)
- [Descripción general del producto](/es/tutorials/jetson-orin-nano/overview)
- [Inferencia LLM local](/es/tutorials/jetson-orin-nano/local-llm)
- [IA agéntica (NemoClaw)](/es/tutorials/jetson-orin-nano/agentic-ai)
- [Análisis de video con DeepStream](/es/tutorials/jetson-orin-nano/deepstream)
- [Robótica (estado actual)](/es/tutorials/jetson-orin-nano/robotics)
- [Eficiencia de memoria](/es/tutorials/jetson-orin-nano/memory-efficiency)
- [Migrar desde JetPack 6.x](/es/tutorials/jetson-orin-nano/jetpack-6-to-7)
- [Descargas](/es/tutorials/jetson-orin-nano/downloads)
- [Preguntas frecuentes](/es/tutorials/jetson-orin-nano/faq)
- [Solución de problemas](/es/tutorials/jetson-orin-nano/troubleshooting)
- [Glosario](/es/tutorials/jetson-orin-nano/glossary)
- [Registro de cambios](/es/tutorials/jetson-orin-nano/changelog)
- [XLeRobot Docker — 01 · Resumen](/es/tutorials/jetson-orin-nano/xlerobot-docker/deployment/01-Overview)
- [XLeRobot Docker — 02 · Preparación del entorno](/es/tutorials/jetson-orin-nano/xlerobot-docker/deployment/02-Environment-Setup)
- [XLeRobot Docker — 03 · Despliegue](/es/tutorials/jetson-orin-nano/xlerobot-docker/deployment/03-Deployment)
- [XLeRobot Docker — Comandos de LeRobot original](/es/tutorials/jetson-orin-nano/xlerobot-docker/lerobot/01-Operation)
- [XLeRobot Docker — Comandos de XLeRobot](/es/tutorials/jetson-orin-nano/xlerobot-docker/xlerobot/01-Operation)
- [XLeRobot Docker — Solución de problemas y referencia rápida](/es/tutorials/jetson-orin-nano/xlerobot-docker/troubleshooting/01-Troubleshooting)

### Recursos didácticos

- [Recursos didácticos](/es/tutorials/learning-resources/)
- [Incompatibilidades de PyTorch en Jetson Orin](/es/tutorials/learning-resources/jetson-orin-pytorch-compatibility)

### Brazos robóticos

- [Serie de brazos robóticos](/es/tutorials/robot-arms/)
- [Guía de selección](/es/tutorials/robot-arms/select-guide)
  - **Serie SO-ARM101**
    - [Tutoriales del brazo robótico SO-ARM101](/es/tutorials/robot-arms/so-arm101/)
    - [Tutorial del brazo robótico LeRobot](/es/tutorials/robot-arms/so-arm101/SO-ARM101-Tutorial)
    - [Guía de montaje del brazo robótico Lerobot](/es/tutorials/robot-arms/so-arm101/SO-ARM101-Assembly)
    - [Incompatibilidad de PyTorch en Jetson Orin](/es/tutorials/robot-arms/so-arm101/SO-ARM101-Jetson-Orin-PyTorch-Compatibility)
    - [Soporte de brazo y kit de cámara ambiental SO-ARM100&101 – Tutorial de instalación](/es/tutorials/robot-arms/so-arm101/SO-ARM101-100-Arm-Mount-Camera-Kit-Installation)
    - [Instalación del soporte de cámara superior](/es/tutorials/robot-arms/so-arm101/SO-ARM101-Overhead-Camera-Mount-Installation)
    - [Teleoperación inalámbrica SO-ARM101 (versión ESP32-NanoCam)](/es/tutorials/robot-arms/so-arm101/SO-ARM101-NanoCam-Wireless-Teleop)
    - [Solución de problemas de teleoperación](/es/tutorials/robot-arms/so-arm101/SO-ARM101-NanoCam-Troubleshooting)
    - [Tutorial de doble brazo (doble brazo seguidor) del SO-ARM101](/es/tutorials/robot-arms/so-arm101/SO-ARM101-Bi-Arm-Tutorial)
    - [Tutorial de uso de la herramienta de calibración de servos de la serie SoARM](/es/tutorials/robot-arms/so-arm101/SO-ARM101-Servo-Calibration-Tool)
    - [Serie So-ARM: calibración de servos STS3215 – versión web](/es/tutorials/robot-arms/so-arm101/SO-ARM101-Web-Calibration)
      - **Curso de LeRobot**
        - [Curso completo de LeRobot](/es/tutorials/robot-arms/so-arm101/lerobot/)
          - **1. Instalar LeRobot**
            - [Paso 1: Instalar el entorno de LeRobot (Ubuntu)](/es/tutorials/robot-arms/so-arm101/lerobot/01-Environment-Setup/Ubuntu)
            - [Paso 1: Instalar el entorno de LeRobot (Windows)](/es/tutorials/robot-arms/so-arm101/lerobot/01-Environment-Setup/Windows)
            - [Paso 1: Instalar el entorno de LeRobot (macOS)](/es/tutorials/robot-arms/so-arm101/lerobot/01-Environment-Setup/MacOS)
          - **2. Puerto serie**
            - [Paso 2: Ver el puerto del dispositivo serie (Ubuntu)](/es/tutorials/robot-arms/so-arm101/lerobot/02-Serial-Port/Ubuntu)
            - [Paso 2: Ver el puerto del dispositivo serie (Windows)](/es/tutorials/robot-arms/so-arm101/lerobot/02-Serial-Port/Windows)
            - [Paso 2: Ver el puerto del dispositivo serie (macOS)](/es/tutorials/robot-arms/so-arm101/lerobot/02-Serial-Port/MacOS)
          - **3. Calibración**
            - [Paso 3: Calibrar el brazo robótico (Ubuntu)](/es/tutorials/robot-arms/so-arm101/lerobot/03-Calibration/Ubuntu)
            - [Paso 3: Calibrar el brazo robótico (Windows)](/es/tutorials/robot-arms/so-arm101/lerobot/03-Calibration/Windows)
            - [Paso 3: Calibrar el brazo robótico (macOS)](/es/tutorials/robot-arms/so-arm101/lerobot/03-Calibration/MacOS)
          - **4. Teleoperación**
            - [Paso 4: Teleoperación (Ubuntu)](/es/tutorials/robot-arms/so-arm101/lerobot/04-Teleoperation/Ubuntu)
            - [Paso 4: Teleoperación (Windows)](/es/tutorials/robot-arms/so-arm101/lerobot/04-Teleoperation/Windows)
            - [Paso 4: Teleoperación (macOS)](/es/tutorials/robot-arms/so-arm101/lerobot/04-Teleoperation/MacOS)
          - **5. Cámara y teleop.**
            - [Paso 5: Teleoperación con cámara (Ubuntu)](/es/tutorials/robot-arms/so-arm101/lerobot/05-Camera-Teleoperation/Ubuntu)
            - [Paso 5: Teleoperación con cámara (Windows)](/es/tutorials/robot-arms/so-arm101/lerobot/05-Camera-Teleoperation/Windows)
            - [Paso 5: Teleoperación con cámara (macOS)](/es/tutorials/robot-arms/so-arm101/lerobot/05-Camera-Teleoperation/MacOS)
          - **6. Conjunto de datos**
            - [Paso 6: Recopilación de datos por enseñanza](/es/tutorials/robot-arms/so-arm101/lerobot/06-Data-Collection/Teaching-and-Recording)
            - [Paso 6: Recopilación por demostración — Handshake 200](/es/tutorials/robot-arms/so-arm101/lerobot/06-Data-Collection/Teaching-and-Recording-Handshake-200)
            - [Paso 6: Ver y reproducir un conjunto de datos](/es/tutorials/robot-arms/so-arm101/lerobot/06-Data-Collection/Browse-and-Replay)
            - [Paso 6: Notas de la recopilación de datos](/es/tutorials/robot-arms/so-arm101/lerobot/06-Data-Collection/Collection-Notes)
            - [Paso 6: Cuenta de Hugging Face (opcional)](/es/tutorials/robot-arms/so-arm101/lerobot/06-Data-Collection/HF-Account)
            - [Paso 6: Subir el conjunto de datos (opcional)](/es/tutorials/robot-arms/so-arm101/lerobot/06-Data-Collection/HF-Dataset-Upload)
            - [Paso 7 (simulación): Recopilar un conjunto de datos — teleoperación Lightwheel LeIsaac](/es/tutorials/robot-arms/so-arm101/lerobot/06-Data-Collection/LeIsaac-Sim)
          - **7. Entrenamiento**
            - [Paso 7: Entrenamiento local en Ubuntu](/es/tutorials/robot-arms/so-arm101/lerobot/07-Training/Local-Ubuntu)
            - [Paso 7: Entorno de entrenamiento con GPU en la nube](/es/tutorials/robot-arms/so-arm101/lerobot/07-Training/Cloud-GPU)
            - [Paso 7: Curvas de entrenamiento con wandb](/es/tutorials/robot-arms/so-arm101/lerobot/07-Training/WandB-Curves)
            - [Paso 7: Subir el modelo (opcional)](/es/tutorials/robot-arms/so-arm101/lerobot/07-Training/HF-Model-Upload)
            - [Paso 7: Obtener los pesos del modelo](/es/tutorials/robot-arms/so-arm101/lerobot/07-Training/Model-Weights)
            - [Paso 7: Comando de entrenamiento ACT](/es/tutorials/robot-arms/so-arm101/lerobot/07-Training/Command-ACT)
            - [Paso 7: Comando de entrenamiento pi0](/es/tutorials/robot-arms/so-arm101/lerobot/07-Training/Command-pi0)
            - [Paso 7: Comando de entrenamiento pi0.5](/es/tutorials/robot-arms/so-arm101/lerobot/07-Training/Command-pi0.5)
            - [Paso 7: Comando de entrenamiento pi0fast](/es/tutorials/robot-arms/so-arm101/lerobot/07-Training/Command-pi0fast)
            - [Paso 7: Comando de entrenamiento smolvla](/es/tutorials/robot-arms/so-arm101/lerobot/07-Training/Command-smolvla)
            - [Paso 7: Comando de entrenamiento Diffusion](/es/tutorials/robot-arms/so-arm101/lerobot/07-Training/Command-Diffusion)
            - [Paso 7: Comando de entrenamiento WALL-OSS](/es/tutorials/robot-arms/so-arm101/lerobot/07-Training/Command-Wall-OSS)
            - [Paso 7: Línea de comandos de entrenamiento](/es/tutorials/robot-arms/so-arm101/lerobot/07-Training/Train-CLI)
            - [Paso 7: Recomendaciones de parámetros de entrenamiento](/es/tutorials/robot-arms/so-arm101/lerobot/07-Training/Training-Parameters)
            - [Paso 7: Algoritmos de aprendizaje por imitación compatibles con LeRobot](/es/tutorials/robot-arms/so-arm101/lerobot/07-Training/Imitation-Learning-Algorithms)
          - **8. Inferencia**
            - [Paso 8: Descripción de la línea de comandos](/es/tutorials/robot-arms/so-arm101/lerobot/08-Inference/CLI-Reference)
            - [Paso 8: Bugs comunes y soluciones](/es/tutorials/robot-arms/so-arm101/lerobot/08-Inference/Common-Bugs)
            - [Paso 8: Comando de despliegue ACT](/es/tutorials/robot-arms/so-arm101/lerobot/08-Inference/Command-ACT)
            - [Paso 8: Comando de despliegue pi0](/es/tutorials/robot-arms/so-arm101/lerobot/08-Inference/Command-pi0)
            - [Paso 8: Comando de despliegue pi0.5](/es/tutorials/robot-arms/so-arm101/lerobot/08-Inference/Command-pi0.5)
            - [Paso 8: Comando de despliegue smolvla](/es/tutorials/robot-arms/so-arm101/lerobot/08-Inference/Command-smolvla)
            - [Paso 8: Comando de despliegue Diffusion](/es/tutorials/robot-arms/so-arm101/lerobot/08-Inference/Command-Diffusion)
            - [Paso 8: Comando de despliegue WALL-OSS](/es/tutorials/robot-arms/so-arm101/lerobot/08-Inference/Command-Wall-OSS)
            - [Paso 8: Inferencia en NVIDIA DGX Spark](/es/tutorials/robot-arms/so-arm101/lerobot/08-Inference/DGX-Spark)
            - [Paso 8: Inferencia en D-Robotics RDK S100](/es/tutorials/robot-arms/so-arm101/lerobot/08-Inference/RDK-S100)
          - **Conceptos básicos**
            - [Conocer LeRobot y la inteligencia encarnada](/es/tutorials/robot-arms/so-arm101/basics/Understanding-LeRobot)
            - [Conjuntos de datos de LeRobot en HuggingFace](/es/tutorials/robot-arms/so-arm101/basics/HF-Datasets)
            - [Materiales para el entrenamiento de modelos](/es/tutorials/robot-arms/so-arm101/basics/Training-Resources)
            - [Archivos oficiales de impresión 3D del SO-ARM 100](/es/tutorials/robot-arms/so-arm101/basics/Official-3D-Print-Files)
            - [Archivos URDF y referencias de materiales](/es/tutorials/robot-arms/so-arm101/basics/URDF-Reference)
            - [Soportes y monturas de cámara recomendados](/es/tutorials/robot-arms/so-arm101/basics/Camera-Mounts-Recommended)
          - **Extras y avanzado**
            - [Control de simulación en ROS2](/es/tutorials/robot-arms/so-arm101/ROS2-Simulation-Control)
            - [Instalación de la pinza de dedos paralelos](/es/tutorials/robot-arms/so-arm101/Parallel-Finger-Gripper-Installation)
      - **Tutorial de LeLab**
        - [1 · Descripción general](/es/tutorials/robot-arms/so-arm101/lelab/01-Overview)
        - [2 · Instalar y ejecutar](/es/tutorials/robot-arms/so-arm101/lelab/02-Install)
        - [3 · Conectar y calibrar](/es/tutorials/robot-arms/so-arm101/lelab/03-Calibration)
        - [4 · Teleoperación](/es/tutorials/robot-arms/so-arm101/lelab/04-Teleoperation)
        - [5 · Grabar un dataset](/es/tutorials/robot-arms/so-arm101/lelab/05-Record-Dataset)
        - [6 · Entrenar y ejecutar la inferencia](/es/tutorials/robot-arms/so-arm101/lelab/06-Train-and-Inference)
        - [7 · Solución de problemas](/es/tutorials/robot-arms/so-arm101/lelab/07-Troubleshooting)
      - **Tutorial de simulación MuJoCo**,        - [SO-ARM101 × MuJoCo tutorial completo (índice)](/es/tutorials/robot-arms/so-arm101/mujoco/),        - [01 · Preparación del entorno](/es/tutorials/robot-arms/so-arm101/mujoco/01-Environment),        - [02 · Verificación del modelo de simulación (carga y accionamiento de MJCF)](/es/tutorials/robot-arms/so-arm101/mujoco/02-Sim-Model-Verification),        - [03 · Conexión del robot real y calibración](/es/tutorials/robot-arms/so-arm101/mujoco/03-Hardware-Calibration),        - [04 · Teleoperación por teclado](/es/tutorials/robot-arms/so-arm101/mujoco/04-Keyboard-Teleop),        - [05 · Gemelo digital del brazo líder (el brazo físico acciona el brazo simulado)](/es/tutorials/robot-arms/so-arm101/mujoco/05-Leader-Digital-Twin),        - [06 · Grabación y reproducción de datos](/es/tutorials/robot-arms/so-arm101/mujoco/06-Record-and-Replay),        - [07 · Preguntas frecuentes y experiencias](/es/tutorials/robot-arms/so-arm101/mujoco/07-Troubleshooting),        - [08 · Hoja de ruta](/es/tutorials/robot-arms/so-arm101/mujoco/08-Roadmap),        - [09 · Tutorial de uso completo (arrancar el brazo → dataset → ver vídeos → entrenar → desplegar)](/es/tutorials/robot-arms/so-arm101/mujoco/09-Usage-Tutorial)
  - **Curso SO-ARM101 + AmazingHand**
    - [Resumen del curso](/es/tutorials/robot-arms/so-arm-amazinghand/)
      - **Linux**
        - [Fase 1: Preparación del entorno (Linux)](/es/tutorials/robot-arms/so-arm-amazinghand/01-Environment-Setup-Linux)
        - [Etapa 2: calibración de mano y brazos (Linux)](/es/tutorials/robot-arms/so-arm-amazinghand/02-Hand-Arm-Calibration-Linux)
        - [Fase 3: Teleoperación (Linux)](/es/tutorials/robot-arms/so-arm-amazinghand/03-Teleoperation-Linux)
        - [Fase 4: Recolección de datos (Linux)](/es/tutorials/robot-arms/so-arm-amazinghand/04-Data-Collection-Linux)
        - [Fase 5: Entrenamiento del modelo (Linux)](/es/tutorials/robot-arms/so-arm-amazinghand/05-Model-Training-Linux)
        - [Etapa 6: despliegue del modelo (Linux)](/es/tutorials/robot-arms/so-arm-amazinghand/06-Model-Deployment-Linux)
      - **Windows**
        - [Fase 1: Preparación del entorno (Windows)](/es/tutorials/robot-arms/so-arm-amazinghand/01-Environment-Setup-Windows)
        - [Etapa 2: calibración de mano y brazos (Windows)](/es/tutorials/robot-arms/so-arm-amazinghand/02-Hand-Arm-Calibration-Windows)
        - [Fase 3: Teleoperación (Windows)](/es/tutorials/robot-arms/so-arm-amazinghand/03-Teleoperation-Windows)
        - [Fase 4: Recolección de datos (Windows)](/es/tutorials/robot-arms/so-arm-amazinghand/04-Data-Collection-Windows)
        - [Fase 5: Entrenamiento del modelo (Windows)](/es/tutorials/robot-arms/so-arm-amazinghand/05-Model-Training-Windows)
        - [Etapa 6: despliegue del modelo (Windows)](/es/tutorials/robot-arms/so-arm-amazinghand/06-Model-Deployment-Windows)
  - **Tutoriales de XLeRobot**
    - [Resumen de tutoriales](/es/tutorials/robot-arms/xlerobot/)
    - [Configuración (macOS)](/es/tutorials/robot-arms/xlerobot/01-Environment-Setup-macOS)
    - [Configuración (Ubuntu)](/es/tutorials/robot-arms/xlerobot/01-Environment-Setup-Ubuntu)
    - [Configuración (Windows)](/es/tutorials/robot-arms/xlerobot/01-Environment-Setup-Windows)
    - [Mover archivos de XLeRobot](/es/tutorials/robot-arms/xlerobot/02-Move-Xlerobot-Files)
    - [Montaje del kit ensamblado](/es/tutorials/robot-arms/xlerobot/03-Assembly-Assembled-Kit)
    - [Montaje del kit de piezas](/es/tutorials/robot-arms/xlerobot/04-Assembly-Parts-Kit)
  - **Descripción general de los tutoriales de AmazingHand**
    - [Índice del tutorial (incl. URL antiguas)](/es/tutorials/robot-arms/amazing-hand/index.md)
    - [Descripción general de los tutoriales de AmazingHand](/es/tutorials/robot-arms/amazing-hand/README)
    - [Información del producto AmazingHand](/es/tutorials/robot-arms/amazing-hand/00-product/product-info)
    - [Comparación y selección entre las versiones SCS0009 y PWM](/es/tutorials/robot-arms/amazing-hand/00-product/version-comparison)
    - [Descargas y recursos](/es/tutorials/robot-arms/amazing-hand/00-product/downloads)
    - [Descripción general del hardware: estructura, CAD y montaje](/es/tutorials/robot-arms/amazing-hand/01-hardware/overview)
    - [Cableado, ID y alimentación SCS0009](/es/tutorials/robot-arms/amazing-hand/01-hardware/scs0009)
    - [Cableado, GPIO y alimentación PWM](/es/tutorials/robot-arms/amazing-hand/01-hardware/pwm)
    - [Instalación del kit de cámara de entorno](/es/tutorials/robot-arms/amazing-hand/01-hardware/camera-kit)
    - [Inicio rápido con SCS0009](/es/tutorials/robot-arms/amazing-hand/02-quick-start/scs0009)
    - [Inicio rápido con PWM](/es/tutorials/robot-arms/amazing-hand/02-quick-start/pwm)
    - [Control web de AmazingHand](/es/tutorials/robot-arms/amazing-hand/03-web-control/README)
    - [Control web SCS0009](/es/tutorials/robot-arms/amazing-hand/03-web-control/scs0009)
    - [Control web PWM](/es/tutorials/robot-arms/amazing-hand/03-web-control/pwm)
    - [Aplicación de escritorio SCS0009 (GUI y CLI)](/es/tutorials/robot-arms/amazing-hand/04-desktop/scs0009)
    - [Aplicación de escritorio PWM (GUI Tkinter)](/es/tutorials/robot-arms/amazing-hand/04-desktop/pwm)
    - [Seguimiento de manos SCS0009 (Demo oficial dora)](/es/tutorials/robot-arms/amazing-hand/05-hand-tracking/scs0009)
    - [Seguimiento de manos PWM (MediaPipe integrado en la GUI)](/es/tutorials/robot-arms/amazing-hand/05-hand-tracking/pwm)
    - [Depuración y calibración de servos SCS0009](/es/tutorials/robot-arms/amazing-hand/06-servo-tuning/scs0009)
    - [Protocolo, comandos y calibración de los servos PWM](/es/tutorials/robot-arms/amazing-hand/06-servo-tuning/pwm)
    - [Tutorial de uso de Arduino Nano](/es/tutorials/robot-arms/amazing-hand/07-arduino/arduino-nano)
    - [Ejemplos de Arduino y Python](/es/tutorials/robot-arms/amazing-hand/07-arduino/examples)
    - [Preguntas frecuentes (FAQ)](/es/tutorials/robot-arms/amazing-hand/08-faq/faq)
  - **Lekiwi**
    - [Tutorial de uso del robot móvil Lekiwi](/es/tutorials/robot-arms/lekiwi/Lekiwi-Tutorial)
    - [Tutorial de ensamblaje del robot móvil Lekiwi](/es/tutorials/robot-arms/lekiwi/Lekiwi-Assembly)
  - **Tutorial del robot auto-enderezante SR-Support**
    - [Tutorial del robot auto-enderezante SR-Support](/es/tutorials/robot-arms/sr-support/)
    - [01 Conceptos básicos](/es/tutorials/robot-arms/sr-support/01-basics)
    - [02 Preparación del entorno (venv, herramientas de flasheo y firmware)](/es/tutorials/robot-arms/sr-support/02-environment)
    - [03 Flashear el firmware principal](/es/tutorials/robot-arms/sr-support/03-build-flash)
    - [04 Montaje: imprimir, construir, cablear](/es/tutorials/robot-arms/sr-support/04-assembly)
    - [05 Calibración de punto cero (teclas de flecha; obligatorio para montajes DIY)](/es/tutorials/robot-arms/sr-support/05-zero-tool)
    - [06 Depuración y calibración](/es/tutorials/robot-arms/sr-support/06-debug-and-calibrate)
    - [07 Uso y monitorización del auto-enderezamiento](/es/tutorials/robot-arms/sr-support/07-self-righting)
    - [08 Página de estado WiFi y aprovisionamiento](/es/tutorials/robot-arms/sr-support/08-wifi)
    - [09 Simulación MuJoCo y el gemelo en vivo](/es/tutorials/robot-arms/sr-support/09-mujoco)
    - [10 Resolución de problemas](/es/tutorials/robot-arms/sr-support/10-troubleshooting)
    - [11 Referencia: modelo, parámetros y licencias](/es/tutorials/robot-arms/sr-support/11-reference)

### Sensores

- [Sensores y percepción](/es/tutorials/sensors/)
- [Calibración IMU](/es/tutorials/sensors/imu/calibration)
- [Transferencia remota de archivos](/es/tutorials/sensors/imu/remote-file-transfer)
- [Transferencia de archivos por SSH](/es/tutorials/sensors/imu/ssh-file-transfer)
  - **Navegación inercial IMU**
    - [Información del producto](/es/tutorials/sensors/imu/product-info)
    - [Consola web del host](/es/tutorials/sensors/imu/web-host-console)
    - [Integración MicroDuck](/es/tutorials/sensors/imu/microduck-integration)
      - **Ejemplos multi-placa**
        - [Resumen de casos multi-host](/es/tutorials/sensors/imu/multi-board-examples/overview)
        - [Comunicación PC](/es/tutorials/sensors/imu/multi-board-examples/pc-communication)
          - **Comunicación I2C**
            - [Arduino](/es/tutorials/sensors/imu/multi-board-examples/i2c-communication/arduino)
            - [Serie Jetson](/es/tutorials/sensors/imu/multi-board-examples/i2c-communication/jetson)
            - [Raspberry Pi 5](/es/tutorials/sensors/imu/multi-board-examples/i2c-communication/raspberry-pi)
            - [Serie RDK](/es/tutorials/sensors/imu/multi-board-examples/i2c-communication/rdk)
            - [STM32 F103C8T6](/es/tutorials/sensors/imu/multi-board-examples/i2c-communication/stm32)
          - **Comunicación serie**
            - [Arduino](/es/tutorials/sensors/imu/multi-board-examples/serial-communication/arduino)
            - [Serie Jetson](/es/tutorials/sensors/imu/multi-board-examples/serial-communication/jetson)
            - [Raspberry Pi 5](/es/tutorials/sensors/imu/multi-board-examples/serial-communication/raspberry-pi)
            - [Serie RDK](/es/tutorials/sensors/imu/multi-board-examples/serial-communication/rdk)
            - [STM32 F103C8T6](/es/tutorials/sensors/imu/multi-board-examples/serial-communication/stm32)
      - **Ejemplos ROS**
        - [Aplicación ROS1](/es/tutorials/sensors/imu/ros-examples/ros1)
        - [Aplicación ROS2](/es/tutorials/sensors/imu/ros-examples/ros2)
  - **Módulo GPS y BeiDou**
    - [Información del módulo](/es/tutorials/sensors/gps/GPS-Module-Info)
    - [51 MCU: análisis GPS](/es/tutorials/sensors/gps/51-MCU-GPS-Parsing)
    - [Arduino: lectura de posición](/es/tutorials/sensors/gps/Arduino-Location-Reading)
    - [Arduino: análisis de posición](/es/tutorials/sensors/gps/Arduino-Location-Parsing)
    - [STM32F103: salida de análisis GPS](/es/tutorials/sensors/gps/STM32F103-GPS-Parsing)
    - [Jetson: análisis GPS](/es/tutorials/sensors/gps/Jetson-GPS-Parsing)
    - [Jetson: posicionamiento AGNSS](/es/tutorials/sensors/gps/Jetson-AGNSS)
    - [Jetson: API de Baidu Maps](/es/tutorials/sensors/gps/Jetson-Baidu-Map-API)
    - [Raspberry Pi: análisis GPS](/es/tutorials/sensors/gps/RaspberryPi-GPS-Parsing)
    - [Raspberry Pi: posicionamiento AGNSS](/es/tutorials/sensors/gps/RaspberryPi-AGNSS)
    - [Raspberry Pi: API de Baidu Maps](/es/tutorials/sensors/gps/RaspberryPi-Baidu-Map-API)
    - [ROS: preparación](/es/tutorials/sensors/gps/ROS-Preparation)
    - [ROS: lectura de datos GPS](/es/tutorials/sensors/gps/ROS-Read-GPS-Data)
    - [ROS: dibujar trayectoria GPS](/es/tutorials/sensors/gps/ROS-Draw-GPS-Track)
    - [Error de ubicación en el mapa](/es/tutorials/sensors/gps/Map-Location-Error)

### Accesorios

- [Accesorios robóticos](/es/tutorials/accessories/)
  - [Cámara USB con enfoque automático](/es/tutorials/accessories/usb-auto-focus-camera)
  - [Cámara CSI Jetson](/es/tutorials/accessories/jetson-csi-camera)
    - **Módulo de reconocimiento de voz KWS**
      - [Inicio de tutoriales](/es/tutorials/accessories/KWS-speech-recognition-module/)
      - [Comunicación serie Jetson Nano](/es/tutorials/accessories/KWS-speech-recognition-module/Jetson-Nano-serial-communication)
      - [Comunicación serie Jetson](/es/tutorials/accessories/KWS-speech-recognition-module/Jetson-serial-communication)
      - [Comunicación serie PC](/es/tutorials/accessories/KWS-speech-recognition-module/PC-serial-communication)
      - [Comunicación serie Raspberry Pi](/es/tutorials/accessories/KWS-speech-recognition-module/raspberry-pi-serial-communication)
      - [Visualización ROS2 RViz2](/es/tutorials/accessories/KWS-speech-recognition-module/ROS2-rviz2-visualization)
      - [Grabación de firmware chino/inglés](/es/tutorials/accessories/KWS-speech-recognition-module/download-and-burn-firmware-for-chinese-and-english-recognition-words)
    - **Servos Feetech**
      - [Tutorial de depuración STS3215 & SCS0009](/es/tutorials/accessories/feetech/Feetech-STS3215&SCS0009-Tutorial)
      - [Protocolo de comunicación SCS](/es/tutorials/accessories/feetech/Feetech-SCS_Communication_Protocol)
      - [Tabla de memoria del servo STS con encoder magnético](/es/tutorials/accessories/feetech/Feetech-Magnetic_Encoder_STS_Servo-Memory_Table_Analysis)
      - [Tabla de memoria del servo SCSCL con potenciómetro](/es/tutorials/accessories/feetech/Feetech-Potentiometer_SCSCL_Servo-Memory_Table_Analysis)
      - [Tutorial de uso de la herramienta de depuración del servo SCS0009](/es/tutorials/accessories/feetech/SCS0009-Debug-Tool)
    - [Depurador web de servos bus Feetech (SCS0009 / STS3215 / HD1910)](/es/tutorials/accessories/feetech/Feetech-Web-Debugger)
    - **Módulo de transmisión de video ESP32-NanoCam**
      - [Inicio rápido de ESP32-NanoCam](/es/tutorials/accessories/esp32-nanocam/ESP32-NanoCam-Quick-Start)
      - [Especificaciones de hardware del ESP32-NanoCam](/es/tutorials/accessories/esp32-nanocam/ESP32-NanoCam-Hardware-Spec)
      - [Manual del protocolo serie del ESP32-NanoCam](/es/tutorials/accessories/esp32-nanocam/ESP32-NanoCam-Serial-Protocol)
        - **Tutorial de visión IA (11 capítulos)**
          - [Capítulo 1: Configuración del entorno](/es/tutorials/accessories/esp32-nanocam/Ch01-Environment-Setup)
          - [Capítulo 2: Inicio rápido](/es/tutorials/accessories/esp32-nanocam/Ch02-Quick-Start)
          - [Capítulo 3: Fundamentos de la cámara](/es/tutorials/accessories/esp32-nanocam/Ch03-Camera-Basics)
          - [Capítulo 4: Detección de rostros](/es/tutorials/accessories/esp32-nanocam/Ch04-Face-Detection)
          - [Capítulo 5: Detección de caras de gatos](/es/tutorials/accessories/esp32-nanocam/Ch05-Cat-Face-Detection)
          - [Capítulo 6: Reconocimiento de colores](/es/tutorials/accessories/esp32-nanocam/Ch06-Color-Recognition)
          - [Capítulo 7: Escaneo de códigos QR](/es/tutorials/accessories/esp32-nanocam/Ch07-QR-Code-Scanning)
          - [Capítulo 8: Reconocimiento facial](/es/tutorials/accessories/esp32-nanocam/Ch08-Face-Recognition)
          - [Capítulo 9: Conversación de voz](/es/tutorials/accessories/esp32-nanocam/Ch09-Voice-Chat)
          - [Capítulo 10: Comprensión visual con IA](/es/tutorials/accessories/esp32-nanocam/Ch10-AI-Vision-Understanding)
          - [Capítulo 11: Control por voz ESP-Claw](/es/tutorials/accessories/esp32-nanocam/Ch11-ESP-Claw-Voice-Control)
    - **Tutoriales de cámara CSI**
      - [Configuración de cámara CSI en Jetson](/es/tutorials/accessories/csi-camera/01-Jetson-CSI-Setup)
      - [Uso de la cámara con autofoco](/es/tutorials/accessories/csi-camera/02-Auto-Focus-Camera)
      - [Uso de Jupyter Lab](/es/tutorials/accessories/csi-camera/03-JupyterLab)
      - [Uso de JetCam](/es/tutorials/accessories/csi-camera/04-JetCam)
      - [IMX219 en Raspberry Pi](/es/tutorials/accessories/csi-camera/05-IMX219-RaspberryPi)
    - **Módulo de interacción de voz IA**
      - [Inicio rápido](/es/tutorials/accessories/ai-voice-module/Quick-Start)
      - [Información del producto](/es/tutorials/accessories/ai-voice-module/Product-Info)
      - [Grabación del firmware del módulo](/es/tutorials/accessories/ai-voice-module/Firmware-Flashing)
      - [Modificar la palabra de activación y las palabras de comando](/es/tutorials/accessories/ai-voice-module/Wake-Word-Commands-Edit)
      - [Creación de entradas de protocolo personalizadas](/es/tutorials/accessories/ai-voice-module/Custom-Protocol-Entries)
      - [Interacción por voz en ROS1](/es/tutorials/accessories/ai-voice-module/ROS1-Voice-Interaction)
      - [Interacción por voz en ROS2](/es/tutorials/accessories/ai-voice-module/ROS2-Voice-Interaction)
      - [Protocolo de puerto serie](/es/tutorials/accessories/ai-voice-module/Serial-Protocol)
      - [Protocolo IIC](/es/tutorials/accessories/ai-voice-module/IIC-Protocol)
      - [Comunicación con PC](/es/tutorials/accessories/ai-voice-module/PC-Communication)
      - [Arduino: Comunicación por puerto serie](/es/tutorials/accessories/ai-voice-module/Arduino-Serial-Communication)
      - [Arduino: Comunicación IIC](/es/tutorials/accessories/ai-voice-module/Arduino-IIC-Communication)
      - [Jetson: Comunicación por puerto serie](/es/tutorials/accessories/ai-voice-module/Jetson-Serial-Communication)
      - [Jetson: Comunicación IIC](/es/tutorials/accessories/ai-voice-module/Jetson-IIC-Communication)
      - [RDK: Comunicación por puerto serie](/es/tutorials/accessories/ai-voice-module/RDK-Serial-Communication)
      - [RDK: Comunicación IIC](/es/tutorials/accessories/ai-voice-module/RDK-IIC-Communication)
      - [Raspberry Pi: Comunicación por puerto serie](/es/tutorials/accessories/ai-voice-module/RaspberryPi-Serial-Communication)
      - [Raspberry Pi: Comunicación IIC](/es/tutorials/accessories/ai-voice-module/RaspberryPi-IIC-Communication)
  - [Cardán 2-DOF](/es/tutorials/accessories/2dof-camera-gimbal)
- [Sensor de frecuencia cardíaca y SpO2](/es/tutorials/accessories/heart-rate-spo2)
- [Pantalla OLED de 0,91 pulgadas](/es/tutorials/accessories/0.91-oled-screen-tutorial)
- [Capturadora HDMI 4K](/es/tutorials/accessories/4k-hdmi-capture-tutorial)
- [Conmutador KVM](/es/tutorials/accessories/kvm-switch-tutorial)
- [Conmutador KVM · Descripción general del tutorial](/es/tutorials/accessories/kvm-switch/00-Overview-and-Quick-Start),- [01 · Cambio entre dos ordenadores (botón y mando IR)](/es/tutorials/accessories/kvm-switch/01-Switching-Between-Two-Computers),- [02 · Función HUB (uno a tres)](/es/tutorials/accessories/kvm-switch/02-HUB-Function-One-to-Three),- [03 · Bluetooth](/es/tutorials/accessories/kvm-switch/03-Bluetooth),- [04 · Puerto serie TTL (serie inalámbrica)](/es/tutorials/accessories/kvm-switch/04-TTL-Serial-Port),- [05 · Conector de expansión de 10 pines](/es/tutorials/accessories/kvm-switch/05-10-Pin-Expansion-Header),- [06 · Equipo sin monitor (tarjeta capturadora + OBS)](/es/tutorials/accessories/kvm-switch/06-Headless-Host-Capture-Card-and-OBS),- [07 · Preguntas frecuentes y precauciones](/es/tutorials/accessories/kvm-switch/07-FAQ-and-Precautions)
- [Tarjeta de sonido USB sin controlador](/es/tutorials/accessories/usb-audio-card-tutorial)

## Cómo usar

1. **Elige la categoría temática**: elige la categoría correspondiente según tus intereses o necesidades
2. **Consulta la lista de tutoriales**: en cada categoría, consulta los tutoriales y documentos disponibles
3. **Sigue los pasos**: sigue los pasos de los tutoriales para aprender y usar el producto gradualmente
4. **Practica y explora**: durante el uso real, prueba distintas funciones y configuraciones para acumular experiencia

## Otros recursos

- Si tienes preguntas o sugerencias, visita nuestro repositorio de GitHub para enviar un Issue
- Sigue nuestro blog y redes sociales para conocer las últimas novedades de productos e información de tutoriales
