Juxi-Technology/wiki-documents/docs/content/it/tutorials/index.md

---
title: Tutorial
description: "Tutti i tutorial Juxi Technology: bracci robotici SO-ARM101 e XLeRobot, sensori GPS e IMU, fotocamere CSI, moduli vocali KWS e IA, schede e accessori."
---

# Tutorial

Benvenuto nella pagina dei tutorial! Qui puoi trovare tutti i tutorial d'uso dei prodotti, le guide di configurazione e le best practice per iniziare rapidamente e sfruttare al meglio le capacità del prodotto.

## Categorie di argomenti

### Guida rapida

- [FAQ](/it/tutorials/faq)
- [Introduzione a ROS](/it/tutorials/ros-intro)
- [Lark Wiki](/it/tutorials/lark-wiki)

### SO-ARM101 Braccio robotico 7 assi · Tutorial

- [SO-ARM101 Braccio robotico 7 assi · Tutorial](/tutorials/robot-arms/so-arm101/lerobot-7dof/)
- **1. Ambiente LeRobot**
  - [Computer Ubuntu](/it/tutorials/robot-arms/so-arm101/lerobot-7dof/01-Environment-Setup/Ubuntu)
  - [Computer Windows](/it/tutorials/robot-arms/so-arm101/lerobot-7dof/01-Environment-Setup/Windows)
  - [Computer Mac](/it/tutorials/robot-arms/so-arm101/lerobot-7dof/01-Environment-Setup/MacOS)
- **2. Sostituire i file (adattamento a 7DOF)**
  - [Sostituire i file (adattamento a 7DOF)](/it/tutorials/robot-arms/so-arm101/lerobot-7dof/02-Replace-Files-7DOF)
- **3. Porte seriali**
  - [Ubuntu](/it/tutorials/robot-arms/so-arm101/lerobot-7dof/03-Serial-Port/Ubuntu)
  - [Computer Windows](/it/tutorials/robot-arms/so-arm101/lerobot-7dof/03-Serial-Port/Windows)
  - [Computer Mac](/it/tutorials/robot-arms/so-arm101/lerobot-7dof/03-Serial-Port/MacOS)
- **4. Calibrazione**
  - [Computer Ubuntu](/it/tutorials/robot-arms/so-arm101/lerobot-7dof/04-Calibration/Ubuntu)
  - [Computer Windows](/it/tutorials/robot-arms/so-arm101/lerobot-7dof/04-Calibration/Windows)
  - [Computer Mac](/it/tutorials/robot-arms/so-arm101/lerobot-7dof/04-Calibration/MacOS)
- **5. Teleoperazione**
  - [Computer Ubuntu](/it/tutorials/robot-arms/so-arm101/lerobot-7dof/05-Teleoperation/Ubuntu)
  - [Computer Windows](/it/tutorials/robot-arms/so-arm101/lerobot-7dof/05-Teleoperation/Windows)
  - [Computer Mac](/it/tutorials/robot-arms/so-arm101/lerobot-7dof/05-Teleoperation/MacOS)
- **6. Con telecamera**
  - [Computer Ubuntu](/it/tutorials/robot-arms/so-arm101/lerobot-7dof/06-Camera-Teleoperation/Ubuntu)
  - [Computer Windows](/it/tutorials/robot-arms/so-arm101/lerobot-7dof/06-Camera-Teleoperation/Windows)
  - [Computer Mac](/it/tutorials/robot-arms/so-arm101/lerobot-7dof/06-Camera-Teleoperation/MacOS)
- **7. Raccolta dataset**
  - [Rivedere e riprodurre il dataset](/it/tutorials/robot-arms/so-arm101/lerobot-7dof/07-Data-Collection/Browse-and-Replay)
  - [Note sulla raccolta del dataset](/it/tutorials/robot-arms/so-arm101/lerobot-7dof/07-Data-Collection/Collection-Notes)
  - [Registrare un account Hugging Face (opzionale)](/it/tutorials/robot-arms/so-arm101/lerobot-7dof/07-Data-Collection/HF-Account)
  - [Caricare il dataset su HuggingFace (opzionale)](/it/tutorials/robot-arms/so-arm101/lerobot-7dof/07-Data-Collection/HF-Dataset-Upload)
  - [Raccolta del dataset tramite insegnamento-Stretta di mano 200](/it/tutorials/robot-arms/so-arm101/lerobot-7dof/07-Data-Collection/Teaching-and-Recording-Handshake-200)
  - [Raccolta del dataset tramite insegnamento](/it/tutorials/robot-arms/so-arm101/lerobot-7dof/07-Data-Collection/Teaching-and-Recording)
- **8. Addestramento**
  - [Configurazione dell'ambiente di addestramento su GPU cloud](/it/tutorials/robot-arms/so-arm101/lerobot-7dof/08-Training/Cloud-GPU)
  - [Comando di addestramento-ACT (consigliato per iniziare)](/it/tutorials/robot-arms/so-arm101/lerobot-7dof/08-Training/Command-ACT)
  - [Comando di addestramento-Diffusion](/it/tutorials/robot-arms/so-arm101/lerobot-7dof/08-Training/Command-Diffusion)
  - [Comando di addestramento-pi0.5](/it/tutorials/robot-arms/so-arm101/lerobot-7dof/08-Training/Command-pi0.5)
  - [Comando di addestramento-pi0 (risultati migliori)](/it/tutorials/robot-arms/so-arm101/lerobot-7dof/08-Training/Command-pi0)
  - [Comando di addestramento-pi0fast](/it/tutorials/robot-arms/so-arm101/lerobot-7dof/08-Training/Command-pi0fast)
  - [Comando di addestramento-smolvla (consigliato per progredire)](/it/tutorials/robot-arms/so-arm101/lerobot-7dof/08-Training/Command-smolvla)
  - [Caricare il modello su HuggingFace (opzionale)](/it/tutorials/robot-arms/so-arm101/lerobot-7dof/08-Training/HF-Model-Upload)
  - [Algoritmi di apprendimento per imitazione supportati da LeRobot](/it/tutorials/robot-arms/so-arm101/lerobot-7dof/08-Training/Imitation-Learning-Algorithms)
  - [Addestramento su Ubuntu locale](/it/tutorials/robot-arms/so-arm101/lerobot-7dof/08-Training/Local-Ubuntu)
  - [Ottenere il file dei pesi del modello](/it/tutorials/robot-arms/so-arm101/lerobot-7dof/08-Training/Model-Weights)
  - [Suggerimenti sui parametri di addestramento](/it/tutorials/robot-arms/so-arm101/lerobot-7dof/08-Training/Training-Parameter-Tips)
  - [Curve di addestramento in tempo reale con wandb](/it/tutorials/robot-arms/so-arm101/lerobot-7dof/08-Training/WandB-Curves)
- **9. Deployment**
  - [Descrizione dei comandi](/it/tutorials/robot-arms/so-arm101/lerobot-7dof/09-Inference/CLI-Reference)
  - [Comando di inferenza-ACT](/it/tutorials/robot-arms/so-arm101/lerobot-7dof/09-Inference/Command-ACT)
  - [Comando di inferenza-Diffusion](/it/tutorials/robot-arms/so-arm101/lerobot-7dof/09-Inference/Command-Diffusion)
  - [Comando di inferenza-pi0.5](/it/tutorials/robot-arms/so-arm101/lerobot-7dof/09-Inference/Command-pi0.5)
  - [Comando di inferenza-pi0](/it/tutorials/robot-arms/so-arm101/lerobot-7dof/09-Inference/Command-pi0)
  - [Comando di inferenza-smolvla](/it/tutorials/robot-arms/so-arm101/lerobot-7dof/09-Inference/Command-smolvla)
  - [Bug comuni e soluzioni](/it/tutorials/robot-arms/so-arm101/lerobot-7dof/09-Inference/Common-Bugs)
  - [Inferenza su NVIDIA DGX Spark](/it/tutorials/robot-arms/so-arm101/lerobot-7dof/09-Inference/DGX-Spark)
  - [Inferenza su D-Robotics RDK S100](/it/tutorials/robot-arms/so-arm101/lerobot-7dof/09-Inference/RDK-S100)

### Kit di sviluppo Jetson AGX Orin

- [Avvio rapido — Dall'unboxing a un sistema JetPack 7.2.1 funzionante](/it/tutorials/jetson-agx-orin/quick-start)
- [Flashing e aggiornamenti — Opzioni di installazione del BSP](/it/tutorials/jetson-agx-orin/flashing-and-updates)
- [Verificare il sistema — versioni e checklist dei componenti](/it/tutorials/jetson-agx-orin/verify-your-system)
- [Interfacce e layout hardware](/it/tutorials/jetson-agx-orin/interfaces)
- [Panoramica del prodotto — Kit di sviluppo Jetson AGX Orin](/it/tutorials/jetson-agx-orin/overview)
- [Eseguire LLM in locale — TensorRT Edge-LLM su JetPack 7.2](/it/tutorials/jetson-agx-orin/local-llm)
- [IA agentica — NemoClaw su JetPack 7.2](/it/tutorials/jetson-agx-orin/agentic-ai)
- [Analisi video multi-stream — DeepStream 9.1](/it/tutorials/jetson-agx-orin/deepstream)
- [Robotica su JetPack 7.2 — cosa funziona oggi](/it/tutorials/jetson-agx-orin/robotics)
- [Efficienza della memoria — Carichi di lavoro più grandi su 64GB](/it/tutorials/jetson-agx-orin/memory-efficiency)
- [Migrazione da JetPack 6.x a JetPack 7.2](/it/tutorials/jetson-agx-orin/jetpack-6-to-7)
- [Download e link ufficiali](/it/tutorials/jetson-agx-orin/downloads)
- [FAQ](/it/tutorials/jetson-agx-orin/faq)
- [Risoluzione dei problemi](/it/tutorials/jetson-agx-orin/troubleshooting)
- [Glossario](/it/tutorials/jetson-agx-orin/glossary)
- [Registro delle modifiche](/it/tutorials/jetson-agx-orin/changelog)
- [XLeRobot Docker — 01 · Panoramica](/it/tutorials/jetson-agx-orin/xlerobot-docker/deployment/01-Overview)
- [XLeRobot Docker — 02 · Preparazione dell'ambiente](/it/tutorials/jetson-agx-orin/xlerobot-docker/deployment/02-Environment-Setup)
- [XLeRobot Docker — 03 · Distribuzione](/it/tutorials/jetson-agx-orin/xlerobot-docker/deployment/03-Deployment)
- [XLeRobot Docker — Comandi LeRobot originali](/it/tutorials/jetson-agx-orin/xlerobot-docker/lerobot/01-Operation)
- [XLeRobot Docker — Comandi XLeRobot](/it/tutorials/jetson-agx-orin/xlerobot-docker/xlerobot/01-Operation)
- [XLeRobot Docker — Risoluzione dei problemi e riferimento rapido](/it/tutorials/jetson-agx-orin/xlerobot-docker/troubleshooting/01-Troubleshooting)

### Kit di sviluppo Jetson Orin Nano Super

- [Avvio rapido — Dall'unboxing a un sistema JetPack 7.2.1 funzionante](/it/tutorials/jetson-orin-nano/quick-start)
- [Flashing e aggiornamenti — Opzioni di installazione del BSP](/it/tutorials/jetson-orin-nano/flashing-and-updates)
- [Verificare il sistema — versione, Modalità Super e checklist dell'alimentazione](/it/tutorials/jetson-orin-nano/verify-your-system)
- [Interfacce e layout hardware](/it/tutorials/jetson-orin-nano/interfaces)
- [Panoramica del prodotto — Kit di sviluppo Jetson Orin Nano Super](/it/tutorials/jetson-orin-nano/overview)
- [Eseguire LLM in locale — TensorRT Edge-LLM sull'Orin Nano da 8 GB](/it/tutorials/jetson-orin-nano/local-llm)
- [IA agentica — NemoClaw sull'Orin Nano da 8 GB](/it/tutorials/jetson-orin-nano/agentic-ai)
- [Pipeline di analisi video — DeepStream 9.1](/it/tutorials/jetson-orin-nano/deepstream)
- [Robotica su JetPack 7.2 — cosa funziona sull'Orin Nano](/it/tutorials/jetson-orin-nano/robotics)
- [Efficienza della memoria — Eseguire modelli in 8 GB](/it/tutorials/jetson-orin-nano/memory-efficiency)
- [Migrazione da JetPack 6.x a JetPack 7.2.1](/it/tutorials/jetson-orin-nano/jetpack-6-to-7)
- [Download e link ufficiali](/it/tutorials/jetson-orin-nano/downloads)
- [FAQ](/it/tutorials/jetson-orin-nano/faq)
- [Risoluzione dei problemi](/it/tutorials/jetson-orin-nano/troubleshooting)
- [Glossario](/it/tutorials/jetson-orin-nano/glossary)
- [Registro delle modifiche](/it/tutorials/jetson-orin-nano/changelog)
- [XLeRobot Docker — 01 · Panoramica](/it/tutorials/jetson-orin-nano/xlerobot-docker/deployment/01-Overview)
- [XLeRobot Docker — 02 · Preparazione dell'ambiente](/it/tutorials/jetson-orin-nano/xlerobot-docker/deployment/02-Environment-Setup)
- [XLeRobot Docker — 03 · Distribuzione](/it/tutorials/jetson-orin-nano/xlerobot-docker/deployment/03-Deployment)
- [XLeRobot Docker — Comandi LeRobot originali](/it/tutorials/jetson-orin-nano/xlerobot-docker/lerobot/01-Operation)
- [XLeRobot Docker — Comandi XLeRobot](/it/tutorials/jetson-orin-nano/xlerobot-docker/xlerobot/01-Operation)
- [XLeRobot Docker — Risoluzione dei problemi e riferimento rapido](/it/tutorials/jetson-orin-nano/xlerobot-docker/troubleshooting/01-Troubleshooting)

### Risorse didattiche

- [Risorse didattiche](/it/tutorials/learning-resources/)
- [Incompatibilità PyTorch su Jetson Orin](/it/tutorials/learning-resources/jetson-orin-pytorch-compatibility)

### Bracci robotici

- [Serie bracci robotici](/it/tutorials/robot-arms/)
- [Guida alla scelta](/it/tutorials/robot-arms/select-guide)
  - **Serie SO-ARM101**
    - [Tutorial del braccio robotico SO-ARM101](/it/tutorials/robot-arms/so-arm101/)
    - [Tutorial braccio robotico LeRobot](/it/tutorials/robot-arms/so-arm101/SO-ARM101-Tutorial)
    - [Guida di montaggio del braccio robotico Lerobot](/it/tutorials/robot-arms/so-arm101/SO-ARM101-Assembly)
    - [Incompatibilità PyTorch su Jetson Orin](/it/tutorials/robot-arms/so-arm101/SO-ARM101-Jetson-Orin-PyTorch-Compatibility)
    - [Supporto da braccio e kit camera ambientale SO-ARM100&101 – Tutorial di installazione](/it/tutorials/robot-arms/so-arm101/SO-ARM101-100-Arm-Mount-Camera-Kit-Installation)
    - [Installazione del supporto camera overhead](/it/tutorials/robot-arms/so-arm101/SO-ARM101-Overhead-Camera-Mount-Installation)
    - [SO-ARM101 Teleoperazione wireless (versione ESP32-NanoCam)](/it/tutorials/robot-arms/so-arm101/SO-ARM101-NanoCam-Wireless-Teleop)
    - [Risoluzione problemi di teleoperazione](/it/tutorials/robot-arms/so-arm101/SO-ARM101-NanoCam-Troubleshooting)
    - [SO-ARM101 Tutorial bi-braccio (doppio follower)](/it/tutorials/robot-arms/so-arm101/SO-ARM101-Bi-Arm-Tutorial)
    - [Tutorial d'uso del tool di calibrazione servo della serie SoARM](/it/tutorials/robot-arms/so-arm101/SO-ARM101-Servo-Calibration-Tool)
    - [Serie So-ARM – Calibrazione servo STS3215 – versione Web](/it/tutorials/robot-arms/so-arm101/SO-ARM101-Web-Calibration)
      - **Corso LeRobot**
        - [Panoramica del corso LeRobot](/it/tutorials/robot-arms/so-arm101/lerobot/)
          - **1. Ambiente LeRobot**
            - [Passo 1: Installare l'ambiente LeRobot (Ubuntu)](/it/tutorials/robot-arms/so-arm101/lerobot/01-Environment-Setup/Ubuntu)
            - [Passo 1: Installare l'ambiente LeRobot (Windows)](/it/tutorials/robot-arms/so-arm101/lerobot/01-Environment-Setup/Windows)
            - [Passo 1: Installare l'ambiente LeRobot (macOS)](/it/tutorials/robot-arms/so-arm101/lerobot/01-Environment-Setup/MacOS)
          - **2. Porte seriali**
            - [Passo 2: Visualizzare le porte seriali (Ubuntu)](/it/tutorials/robot-arms/so-arm101/lerobot/02-Serial-Port/Ubuntu)
            - [Passo 2: Visualizzare le porte seriali (Windows)](/it/tutorials/robot-arms/so-arm101/lerobot/02-Serial-Port/Windows)
            - [Passo 2: Visualizzare le porte seriali (macOS)](/it/tutorials/robot-arms/so-arm101/lerobot/02-Serial-Port/MacOS)
          - **3. Calibrazione**
            - [Passo 3: Calibrare il braccio robotico (Ubuntu)](/it/tutorials/robot-arms/so-arm101/lerobot/03-Calibration/Ubuntu)
            - [Passo 3: Calibrare il braccio robotico (Windows)](/it/tutorials/robot-arms/so-arm101/lerobot/03-Calibration/Windows)
            - [Passo 3: Calibrare il braccio robotico (macOS)](/it/tutorials/robot-arms/so-arm101/lerobot/03-Calibration/MacOS)
          - **4. Teleoperazione**
            - [Passo 4: Teleoperazione (Ubuntu)](/it/tutorials/robot-arms/so-arm101/lerobot/04-Teleoperation/Ubuntu)
            - [Passo 4: Teleoperazione (Windows)](/it/tutorials/robot-arms/so-arm101/lerobot/04-Teleoperation/Windows)
            - [Passo 4: Teleoperazione (macOS)](/it/tutorials/robot-arms/so-arm101/lerobot/04-Teleoperation/MacOS)
          - **5. Con telecamera**
            - [Passo 5: Teleoperazione con telecamera (Ubuntu)](/it/tutorials/robot-arms/so-arm101/lerobot/05-Camera-Teleoperation/Ubuntu)
            - [Passo 5: Teleoperazione con telecamera (Windows)](/it/tutorials/robot-arms/so-arm101/lerobot/05-Camera-Teleoperation/Windows)
            - [Passo 5: Teleoperazione con telecamera (macOS)](/it/tutorials/robot-arms/so-arm101/lerobot/05-Camera-Teleoperation/MacOS)
          - **6. Raccolta dataset**
            - [Passo 6: Raccolta del dataset tramite insegnamento](/it/tutorials/robot-arms/so-arm101/lerobot/06-Data-Collection/Teaching-and-Recording)
            - [Passo 6: Raccolta tramite dimostrazione — Handshake 200](/it/tutorials/robot-arms/so-arm101/lerobot/06-Data-Collection/Teaching-and-Recording-Handshake-200)
            - [Passo 6: Visualizzare e riprodurre un dataset](/it/tutorials/robot-arms/so-arm101/lerobot/06-Data-Collection/Browse-and-Replay)
            - [Passo 6: Note sulla raccolta del dataset](/it/tutorials/robot-arms/so-arm101/lerobot/06-Data-Collection/Collection-Notes)
            - [Passo 6: Registrare un account Hugging Face (opzionale)](/it/tutorials/robot-arms/so-arm101/lerobot/06-Data-Collection/HF-Account)
            - [Passo 6: Caricare il dataset su HuggingFace (opzionale)](/it/tutorials/robot-arms/so-arm101/lerobot/06-Data-Collection/HF-Dataset-Upload)
            - [Passo 7 (simulazione): Raccogliere un dataset — teleoperazione Lightwheel LeIsaac](/it/tutorials/robot-arms/so-arm101/lerobot/06-Data-Collection/LeIsaac-Sim)
          - **7. Addestramento**
            - [Passo 7: Addestramento su Ubuntu locale](/it/tutorials/robot-arms/so-arm101/lerobot/07-Training/Local-Ubuntu)
            - [Passo 7: Ambiente di addestramento su GPU cloud](/it/tutorials/robot-arms/so-arm101/lerobot/07-Training/Cloud-GPU)
            - [Passo 7: Curve di addestramento in tempo reale con wandb](/it/tutorials/robot-arms/so-arm101/lerobot/07-Training/WandB-Curves)
            - [Passo 7: Caricare il modello su HuggingFace (opzionale)](/it/tutorials/robot-arms/so-arm101/lerobot/07-Training/HF-Model-Upload)
            - [Passo 7: Ottenere il file dei pesi del modello](/it/tutorials/robot-arms/so-arm101/lerobot/07-Training/Model-Weights)
            - [Passo 7: Comando di addestramento ACT](/it/tutorials/robot-arms/so-arm101/lerobot/07-Training/Command-ACT)
            - [Passo 7: Comando di addestramento pi0](/it/tutorials/robot-arms/so-arm101/lerobot/07-Training/Command-pi0)
            - [Passo 7: Comando di addestramento pi0.5](/it/tutorials/robot-arms/so-arm101/lerobot/07-Training/Command-pi0.5)
            - [Passo 7: Comando di addestramento pi0fast](/it/tutorials/robot-arms/so-arm101/lerobot/07-Training/Command-pi0fast)
            - [Passo 7: Comando di addestramento SmolVLA](/it/tutorials/robot-arms/so-arm101/lerobot/07-Training/Command-smolvla)
            - [Passo 7: Comando di addestramento Diffusion](/it/tutorials/robot-arms/so-arm101/lerobot/07-Training/Command-Diffusion)
            - [Passo 7: Comando di addestramento WALL-OSS](/it/tutorials/robot-arms/so-arm101/lerobot/07-Training/Command-Wall-OSS)
            - [Passo 7: Riga di comando di addestramento](/it/tutorials/robot-arms/so-arm101/lerobot/07-Training/Train-CLI)
            - [Passo 7: Consigli sui parametri di addestramento](/it/tutorials/robot-arms/so-arm101/lerobot/07-Training/Training-Parameters)
            - [Passo 7: Algoritmi di imitation learning supportati da LeRobot](/it/tutorials/robot-arms/so-arm101/lerobot/07-Training/Imitation-Learning-Algorithms)
          - **8. Deployment**
            - [Passo 8: Descrizione dei comandi di deployment](/it/tutorials/robot-arms/so-arm101/lerobot/08-Inference/CLI-Reference)
            - [Passo 8: Bug comuni e soluzioni](/it/tutorials/robot-arms/so-arm101/lerobot/08-Inference/Common-Bugs)
            - [Passo 8: Comando di deployment ACT](/it/tutorials/robot-arms/so-arm101/lerobot/08-Inference/Command-ACT)
            - [Passo 8: Comando di deployment pi0](/it/tutorials/robot-arms/so-arm101/lerobot/08-Inference/Command-pi0)
            - [Passo 8: Comando di deployment pi0.5](/it/tutorials/robot-arms/so-arm101/lerobot/08-Inference/Command-pi0.5)
            - [Passo 8: Comando di deployment SmolVLA](/it/tutorials/robot-arms/so-arm101/lerobot/08-Inference/Command-smolvla)
            - [Passo 8: Comando di deployment Diffusion](/it/tutorials/robot-arms/so-arm101/lerobot/08-Inference/Command-Diffusion)
            - [Passo 8: Comando di deployment WALL-OSS](/it/tutorials/robot-arms/so-arm101/lerobot/08-Inference/Command-Wall-OSS)
            - [Passo 8: Inferenza su NVIDIA DGX Spark](/it/tutorials/robot-arms/so-arm101/lerobot/08-Inference/DGX-Spark)
            - [Passo 8: Inferenza su D-Robotics RDK S100](/it/tutorials/robot-arms/so-arm101/lerobot/08-Inference/RDK-S100)
          - **Nozioni di base**
            - [Conoscere LeRobot](/it/tutorials/robot-arms/so-arm101/basics/Understanding-LeRobot)
            - [Dataset LeRobot su HuggingFace](/it/tutorials/robot-arms/so-arm101/basics/HF-Datasets)
            - [Materiali per l'addestramento del modello](/it/tutorials/robot-arms/so-arm101/basics/Training-Resources)
            - [File di stampa 3D ufficiali del braccio SO-ARM 100](/it/tutorials/robot-arms/so-arm101/basics/Official-3D-Print-Files)
            - [File URDF e materiali di riferimento](/it/tutorials/robot-arms/so-arm101/basics/URDF-Reference)
            - [Staffe e supporti per telecamere consigliati](/it/tutorials/robot-arms/so-arm101/basics/Camera-Mounts-Recommended)
          - **Approfondimenti**
            - [Controllo di simulazione ROS2](/it/tutorials/robot-arms/so-arm101/ROS2-Simulation-Control)
            - [Installazione della pinza a dita parallele](/it/tutorials/robot-arms/so-arm101/Parallel-Finger-Gripper-Installation)
      - **Tutorial LeLab**
        - [1 · Panoramica](/it/tutorials/robot-arms/so-arm101/lelab/01-Overview)
        - [2 · Installazione e avvio](/it/tutorials/robot-arms/so-arm101/lelab/02-Install)
        - [3 · Collegamento e calibrazione](/it/tutorials/robot-arms/so-arm101/lelab/03-Calibration)
        - [4 · Teleoperazione](/it/tutorials/robot-arms/so-arm101/lelab/04-Teleoperation)
        - [5 · Registrare un dataset](/it/tutorials/robot-arms/so-arm101/lelab/05-Record-Dataset)
        - [6 · Addestrare ed eseguire l'inferenza](/it/tutorials/robot-arms/so-arm101/lelab/06-Train-and-Inference)
        - [7 · Risoluzione dei problemi](/it/tutorials/robot-arms/so-arm101/lelab/07-Troubleshooting)
      - **Tutorial di simulazione MuJoCo**,        - [SO-ARM101 × MuJoCo — Tutorial completo del flusso di lavoro (indice)](/it/tutorials/robot-arms/so-arm101/mujoco/),        - [01 · Preparazione dell'ambiente](/it/tutorials/robot-arms/so-arm101/mujoco/01-Environment),        - [02 · Verifica del modello di simulazione (caricamento e azionamento MJCF)](/it/tutorials/robot-arms/so-arm101/mujoco/02-Sim-Model-Verification),        - [03 · Connessione al robot reale e calibrazione](/it/tutorials/robot-arms/so-arm101/mujoco/03-Hardware-Calibration),        - [04 · Teleoperazione da tastiera](/it/tutorials/robot-arms/so-arm101/mujoco/04-Keyboard-Teleop),        - [05 · Digital twin del braccio leader (braccio fisico che guida il braccio simulato)](/it/tutorials/robot-arms/so-arm101/mujoco/05-Leader-Digital-Twin),        - [06 · Registrazione e riproduzione dei dati](/it/tutorials/robot-arms/so-arm101/mujoco/06-Record-and-Replay),        - [07 · Problemi comuni ed esperienze](/it/tutorials/robot-arms/so-arm101/mujoco/07-Troubleshooting),        - [08 · Roadmap](/it/tutorials/robot-arms/so-arm101/mujoco/08-Roadmap),        - [09 · Tutorial d'uso completo (avvio del braccio → dataset → visione dei video → addestramento → deployment)](/it/tutorials/robot-arms/so-arm101/mujoco/09-Usage-Tutorial)
  - **Corso SO-ARM101 + AmazingHand**
    - [Panoramica del corso](/it/tutorials/robot-arms/so-arm-amazinghand/)
      - **Linux**
        - [Fase 1: Configurazione dell'ambiente (Linux)](/it/tutorials/robot-arms/so-arm-amazinghand/01-Environment-Setup-Linux)
        - [Fase 2: calibrazione mano e bracci (Linux)](/it/tutorials/robot-arms/so-arm-amazinghand/02-Hand-Arm-Calibration-Linux)
        - [Fase 3: Teleoperazione (Linux)](/it/tutorials/robot-arms/so-arm-amazinghand/03-Teleoperation-Linux)
        - [Fase 4: Acquisizione dati (Linux)](/it/tutorials/robot-arms/so-arm-amazinghand/04-Data-Collection-Linux)
        - [Fase 5: Addestramento del modello (Linux)](/it/tutorials/robot-arms/so-arm-amazinghand/05-Model-Training-Linux)
        - [Fase 6: deployment modello (Linux)](/it/tutorials/robot-arms/so-arm-amazinghand/06-Model-Deployment-Linux)
      - **Windows**
        - [Fase 1: Configurazione dell'ambiente (Windows)](/it/tutorials/robot-arms/so-arm-amazinghand/01-Environment-Setup-Windows)
        - [Fase 2: calibrazione mano e bracci (Windows)](/it/tutorials/robot-arms/so-arm-amazinghand/02-Hand-Arm-Calibration-Windows)
        - [Fase 3: Teleoperazione (Windows)](/it/tutorials/robot-arms/so-arm-amazinghand/03-Teleoperation-Windows)
        - [Fase 4: Acquisizione dati (Windows)](/it/tutorials/robot-arms/so-arm-amazinghand/04-Data-Collection-Windows)
        - [Fase 5: Addestramento del modello (Windows)](/it/tutorials/robot-arms/so-arm-amazinghand/05-Model-Training-Windows)
        - [Fase 6: deployment modello (Windows)](/it/tutorials/robot-arms/so-arm-amazinghand/06-Model-Deployment-Windows)
  - **Tutorial XLeRobot**
    - [Panoramica dei tutorial](/it/tutorials/robot-arms/xlerobot/)
    - [Configurazione (macOS)](/it/tutorials/robot-arms/xlerobot/01-Environment-Setup-macOS)
    - [Configurazione (Ubuntu)](/it/tutorials/robot-arms/xlerobot/01-Environment-Setup-Ubuntu)
    - [Configurazione (Windows)](/it/tutorials/robot-arms/xlerobot/01-Environment-Setup-Windows)
    - [Spostare i file XLeRobot](/it/tutorials/robot-arms/xlerobot/02-Move-Xlerobot-Files)
    - [Montaggio kit assemblato](/it/tutorials/robot-arms/xlerobot/03-Assembly-Assembled-Kit)
    - [Montaggio kit a pezzi](/it/tutorials/robot-arms/xlerobot/04-Assembly-Parts-Kit)
  - **Panoramica del tutorial della mano robotica AmazingHand**
    - [Indice del tutorial (incl. URL precedenti)](/it/tutorials/robot-arms/amazing-hand/index.md)
    - [Panoramica del tutorial della mano robotica AmazingHand](/it/tutorials/robot-arms/amazing-hand/README)
    - [Scheda prodotto AmazingHand](/it/tutorials/robot-arms/amazing-hand/00-product/product-info)
    - [Confronto e scelta tra versioni SCS0009 e PWM](/it/tutorials/robot-arms/amazing-hand/00-product/version-comparison)
    - [Download e risorse](/it/tutorials/robot-arms/amazing-hand/00-product/downloads)
    - [Panoramica hardware: struttura, CAD e assemblaggio](/it/tutorials/robot-arms/amazing-hand/01-hardware/overview)
    - [Cablaggio, ID e alimentazione SCS0009](/it/tutorials/robot-arms/amazing-hand/01-hardware/scs0009)
    - [Cablaggio, GPIO e alimentazione PWM](/it/tutorials/robot-arms/amazing-hand/01-hardware/pwm)
    - [Installazione del kit telecamera ambientale](/it/tutorials/robot-arms/amazing-hand/01-hardware/camera-kit)
    - [Avvio rapido SCS0009](/it/tutorials/robot-arms/amazing-hand/02-quick-start/scs0009)
    - [Avvio rapido PWM](/it/tutorials/robot-arms/amazing-hand/02-quick-start/pwm)
    - [Controllo web AmazingHand](/it/tutorials/robot-arms/amazing-hand/03-web-control/README)
    - [Controllo web SCS0009](/it/tutorials/robot-arms/amazing-hand/03-web-control/scs0009)
    - [Controllo web PWM](/it/tutorials/robot-arms/amazing-hand/03-web-control/pwm)
    - [Applicazione desktop SCS0009 (GUI e CLI)](/it/tutorials/robot-arms/amazing-hand/04-desktop/scs0009)
    - [Applicazione desktop PWM (GUI Tkinter)](/it/tutorials/robot-arms/amazing-hand/04-desktop/pwm)
    - [Tracciamento delle mani SCS0009 (demo ufficiale dora)](/it/tutorials/robot-arms/amazing-hand/05-hand-tracking/scs0009)
    - [Tracciamento delle mani PWM (MediaPipe integrato nella GUI)](/it/tutorials/robot-arms/amazing-hand/05-hand-tracking/pwm)
    - [Messa a punto e calibrazione dei servo SCS0009](/it/tutorials/robot-arms/amazing-hand/06-servo-tuning/scs0009)
    - [Protocollo, comandi e calibrazione dei servo PWM](/it/tutorials/robot-arms/amazing-hand/06-servo-tuning/pwm)
    - [Tutorial di utilizzo di Arduino Nano](/it/tutorials/robot-arms/amazing-hand/07-arduino/arduino-nano)
    - [Esempi Arduino e Python](/it/tutorials/robot-arms/amazing-hand/07-arduino/examples)
    - [Domande frequenti (FAQ)](/it/tutorials/robot-arms/amazing-hand/08-faq/faq)
  - **Lekiwi**
    - [Tutorial d'uso del robot mobile Lekiwi](/it/tutorials/robot-arms/lekiwi/Lekiwi-Tutorial)
    - [Tutorial di assemblaggio del robot mobile Lekiwi](/it/tutorials/robot-arms/lekiwi/Lekiwi-Assembly)
  - **Tutorial del robot auto-raddrizzante SR-Support**
    - [Tutorial del robot auto-raddrizzante SR-Support](/it/tutorials/robot-arms/sr-support/)
    - [01 Nozioni di base](/it/tutorials/robot-arms/sr-support/01-basics)
    - [02 Preparazione dell'ambiente (venv, strumenti di flash e firmware)](/it/tutorials/robot-arms/sr-support/02-environment)
    - [03 Flash del firmware principale](/it/tutorials/robot-arms/sr-support/03-build-flash)
    - [04 Assemblaggio: stampa, montaggio, cablaggio](/it/tutorials/robot-arms/sr-support/04-assembly)
    - [05 Azzeramento (tasti freccia; obbligatorio per le build fai-da-te)](/it/tutorials/robot-arms/sr-support/05-zero-tool)
    - [06 Debug e calibrazione](/it/tutorials/robot-arms/sr-support/06-debug-and-calibrate)
    - [07 Uso dell'auto-raddrizzamento e monitoraggio](/it/tutorials/robot-arms/sr-support/07-self-righting)
    - [08 Pagina di stato WiFi e provisioning](/it/tutorials/robot-arms/sr-support/08-wifi)
    - [09 Simulazione MuJoCo e il gemello in tempo reale](/it/tutorials/robot-arms/sr-support/09-mujoco)
    - [10 Risoluzione dei problemi](/it/tutorials/robot-arms/sr-support/10-troubleshooting)
    - [11 Riferimenti: modello, parametri e licenze](/it/tutorials/robot-arms/sr-support/11-reference)

### Sensori

- [Sensori e percezione](/it/tutorials/sensors/)
- [Calibrazione IMU](/it/tutorials/sensors/imu/calibration)
- [Trasferimento remoto di file](/it/tutorials/sensors/imu/remote-file-transfer)
- [Trasferimento di file tramite SSH](/it/tutorials/sensors/imu/ssh-file-transfer)
  - **Navigazione inerziale IMU**
    - [Informazioni prodotto](/it/tutorials/sensors/imu/product-info)
    - [Console host Web](/it/tutorials/sensors/imu/web-host-console)
    - [Integrazione MicroDuck](/it/tutorials/sensors/imu/microduck-integration)
      - **Esempi multi-scheda**
        - [Panoramica dei casi multi-host](/it/tutorials/sensors/imu/multi-board-examples/overview)
        - [Comunicazione PC](/it/tutorials/sensors/imu/multi-board-examples/pc-communication)
          - **Comunicazione I2C**
            - [Arduino](/it/tutorials/sensors/imu/multi-board-examples/i2c-communication/arduino)
            - [Serie Jetson](/it/tutorials/sensors/imu/multi-board-examples/i2c-communication/jetson)
            - [Raspberry Pi 5](/it/tutorials/sensors/imu/multi-board-examples/i2c-communication/raspberry-pi)
            - [Serie RDK](/it/tutorials/sensors/imu/multi-board-examples/i2c-communication/rdk)
            - [STM32 F103C8T6](/it/tutorials/sensors/imu/multi-board-examples/i2c-communication/stm32)
          - **Comunicazione seriale**
            - [Arduino](/it/tutorials/sensors/imu/multi-board-examples/serial-communication/arduino)
            - [Serie Jetson](/it/tutorials/sensors/imu/multi-board-examples/serial-communication/jetson)
            - [Raspberry Pi 5](/it/tutorials/sensors/imu/multi-board-examples/serial-communication/raspberry-pi)
            - [Serie RDK](/it/tutorials/sensors/imu/multi-board-examples/serial-communication/rdk)
            - [STM32 F103C8T6](/it/tutorials/sensors/imu/multi-board-examples/serial-communication/stm32)
      - **Esempi ROS**
        - [Applicazione ROS1](/it/tutorials/sensors/imu/ros-examples/ros1)
        - [Applicazione ROS2](/it/tutorials/sensors/imu/ros-examples/ros2)
  - **Modulo GPS e BeiDou**
    - [Informazioni modulo](/it/tutorials/sensors/gps/GPS-Module-Info)
    - [51 MCU: analisi GPS](/it/tutorials/sensors/gps/51-MCU-GPS-Parsing)
    - [Arduino: lettura posizione](/it/tutorials/sensors/gps/Arduino-Location-Reading)
    - [Arduino: analisi posizione](/it/tutorials/sensors/gps/Arduino-Location-Parsing)
    - [STM32F103: output analisi GPS](/it/tutorials/sensors/gps/STM32F103-GPS-Parsing)
    - [Jetson: analisi GPS](/it/tutorials/sensors/gps/Jetson-GPS-Parsing)
    - [Jetson: posizionamento AGNSS](/it/tutorials/sensors/gps/Jetson-AGNSS)
    - [Jetson: API Baidu Maps](/it/tutorials/sensors/gps/Jetson-Baidu-Map-API)
    - [Raspberry Pi: analisi GPS](/it/tutorials/sensors/gps/RaspberryPi-GPS-Parsing)
    - [Raspberry Pi: posizionamento AGNSS](/it/tutorials/sensors/gps/RaspberryPi-AGNSS)
    - [Raspberry Pi: API Baidu Maps](/it/tutorials/sensors/gps/RaspberryPi-Baidu-Map-API)
    - [ROS: preparazione](/it/tutorials/sensors/gps/ROS-Preparation)
    - [ROS: lettura dati GPS](/it/tutorials/sensors/gps/ROS-Read-GPS-Data)
    - [ROS: tracciare il percorso GPS](/it/tutorials/sensors/gps/ROS-Draw-GPS-Track)
    - [Errore di posizione sulla mappa](/it/tutorials/sensors/gps/Map-Location-Error)

### Accessori

- [Accessori robotici](/it/tutorials/accessories/)
  - [Fotocamera USB con autofocus](/it/tutorials/accessories/usb-auto-focus-camera)
  - [Fotocamera CSI Jetson](/it/tutorials/accessories/jetson-csi-camera)
    - **Modulo di riconoscimento vocale KWS**
      - [Home dei tutorial](/it/tutorials/accessories/KWS-speech-recognition-module/)
      - [Comunicazione seriale Jetson Nano](/it/tutorials/accessories/KWS-speech-recognition-module/Jetson-Nano-serial-communication)
      - [Comunicazione seriale Jetson](/it/tutorials/accessories/KWS-speech-recognition-module/Jetson-serial-communication)
      - [Comunicazione seriale PC](/it/tutorials/accessories/KWS-speech-recognition-module/PC-serial-communication)
      - [Comunicazione seriale Raspberry Pi](/it/tutorials/accessories/KWS-speech-recognition-module/raspberry-pi-serial-communication)
      - [Visualizzazione ROS2 RViz2](/it/tutorials/accessories/KWS-speech-recognition-module/ROS2-rviz2-visualization)
      - [Flashing firmware cinese/inglese](/it/tutorials/accessories/KWS-speech-recognition-module/download-and-burn-firmware-for-chinese-and-english-recognition-words)
    - **Servomotori Feetech**
      - [Tutorial di debug STS3215 & SCS0009](/it/tutorials/accessories/feetech/Feetech-STS3215&SCS0009-Tutorial)
      - [Protocollo di comunicazione SCS](/it/tutorials/accessories/feetech/Feetech-SCS_Communication_Protocol)
      - [Tabella di memoria del servo STS a encoder magnetico](/it/tutorials/accessories/feetech/Feetech-Magnetic_Encoder_STS_Servo-Memory_Table_Analysis)
      - [Tabella di memoria del servo SCSCL a potenziometro](/it/tutorials/accessories/feetech/Feetech-Potentiometer_SCSCL_Servo-Memory_Table_Analysis)
      - [Tutorial d'uso del tool di debug servo SCS0009](/it/tutorials/accessories/feetech/SCS0009-Debug-Tool)
    - [Debugger Web servo bus Feetech (SCS0009 / STS3215 / HD1910)](/it/tutorials/accessories/feetech/Feetech-Web-Debugger)
    - **Modulo di trasmissione video ESP32-NanoCam**
      - [ESP32-NanoCam Avvio rapido](/it/tutorials/accessories/esp32-nanocam/ESP32-NanoCam-Quick-Start)
      - [ESP32-NanoCam Specifiche hardware](/it/tutorials/accessories/esp32-nanocam/ESP32-NanoCam-Hardware-Spec)
      - [ESP32-NanoCam Manuale del protocollo seriale](/it/tutorials/accessories/esp32-nanocam/ESP32-NanoCam-Serial-Protocol)
        - **Tutorial di visione IA (11 capitoli)**
          - [Capitolo 1: Configurazione dell'ambiente](/it/tutorials/accessories/esp32-nanocam/Ch01-Environment-Setup)
          - [Capitolo 2: Avvio rapido](/it/tutorials/accessories/esp32-nanocam/Ch02-Quick-Start)
          - [Capitolo 3: Fondamenti della fotocamera](/it/tutorials/accessories/esp32-nanocam/Ch03-Camera-Basics)
          - [Capitolo 4: Rilevamento del volto](/it/tutorials/accessories/esp32-nanocam/Ch04-Face-Detection)
          - [Capitolo 5: Rilevamento del muso del gatto](/it/tutorials/accessories/esp32-nanocam/Ch05-Cat-Face-Detection)
          - [Capitolo 6: Riconoscimento dei colori](/it/tutorials/accessories/esp32-nanocam/Ch06-Color-Recognition)
          - [Capitolo 7: Scansione dei codici QR](/it/tutorials/accessories/esp32-nanocam/Ch07-QR-Code-Scanning)
          - [Capitolo 8: Riconoscimento facciale](/it/tutorials/accessories/esp32-nanocam/Ch08-Face-Recognition)
          - [Capitolo 9: Conversazione vocale](/it/tutorials/accessories/esp32-nanocam/Ch09-Voice-Chat)
          - [Capitolo 10: Comprensione visiva AI](/it/tutorials/accessories/esp32-nanocam/Ch10-AI-Vision-Understanding)
          - [Capitolo 11: Controllo vocale ESP-Claw](/it/tutorials/accessories/esp32-nanocam/Ch11-ESP-Claw-Voice-Control)
    - **Tutorial della fotocamera CSI**
      - [Configurazione fotocamera CSI su Jetson](/it/tutorials/accessories/csi-camera/01-Jetson-CSI-Setup)
      - [Uso della fotocamera autofocus](/it/tutorials/accessories/csi-camera/02-Auto-Focus-Camera)
      - [Uso di Jupyter Lab](/it/tutorials/accessories/csi-camera/03-JupyterLab)
      - [Uso di JetCam](/it/tutorials/accessories/csi-camera/04-JetCam)
      - [IMX219 su Raspberry Pi](/it/tutorials/accessories/csi-camera/05-IMX219-RaspberryPi)
    - **Modulo di interazione vocale IA**
      - [Avvio rapido](/it/tutorials/accessories/ai-voice-module/Quick-Start)
      - [Informazioni sul prodotto](/it/tutorials/accessories/ai-voice-module/Product-Info)
      - [Flash del firmware del modulo](/it/tutorials/accessories/ai-voice-module/Firmware-Flashing)
      - [Modifica della parola di attivazione e delle parole di comando](/it/tutorials/accessories/ai-voice-module/Wake-Word-Commands-Edit)
      - [Creazione di voci con protocollo personalizzato](/it/tutorials/accessories/ai-voice-module/Custom-Protocol-Entries)
      - [Interazione vocale ROS1](/it/tutorials/accessories/ai-voice-module/ROS1-Voice-Interaction)
      - [Interazione vocale ROS2](/it/tutorials/accessories/ai-voice-module/ROS2-Voice-Interaction)
      - [Protocollo della porta seriale](/it/tutorials/accessories/ai-voice-module/Serial-Protocol)
      - [Protocollo IIC](/it/tutorials/accessories/ai-voice-module/IIC-Protocol)
      - [Comunicazione con PC](/it/tutorials/accessories/ai-voice-module/PC-Communication)
      - [Arduino: Comunicazione della porta seriale](/it/tutorials/accessories/ai-voice-module/Arduino-Serial-Communication)
      - [Arduino: Comunicazione IIC](/it/tutorials/accessories/ai-voice-module/Arduino-IIC-Communication)
      - [Jetson: Comunicazione della porta seriale](/it/tutorials/accessories/ai-voice-module/Jetson-Serial-Communication)
      - [Jetson: Comunicazione IIC](/it/tutorials/accessories/ai-voice-module/Jetson-IIC-Communication)
      - [RDK: Comunicazione della porta seriale](/it/tutorials/accessories/ai-voice-module/RDK-Serial-Communication)
      - [RDK: Comunicazione IIC](/it/tutorials/accessories/ai-voice-module/RDK-IIC-Communication)
      - [Raspberry Pi: Comunicazione della porta seriale](/it/tutorials/accessories/ai-voice-module/RaspberryPi-Serial-Communication)
      - [Raspberry Pi: Comunicazione IIC](/it/tutorials/accessories/ai-voice-module/RaspberryPi-IIC-Communication)
  - [Gimbal 2-DOF](/it/tutorials/accessories/2dof-camera-gimbal)
- [Sensore di frequenza cardiaca e SpO2](/it/tutorials/accessories/heart-rate-spo2)
- [Display OLED da 0,91 pollici](/it/tutorials/accessories/0.91-oled-screen-tutorial)
- [Scheda di acquisizione HDMI 4K](/it/tutorials/accessories/4k-hdmi-capture-tutorial)
- [Switch KVM](/it/tutorials/accessories/kvm-switch-tutorial)
- [Switch KVM · Panoramica del tutorial](/it/tutorials/accessories/kvm-switch/00-Overview-and-Quick-Start),- [01 · Commutazione tra due computer (pulsante e telecomando IR)](/it/tutorials/accessories/kvm-switch/01-Switching-Between-Two-Computers),- [02 · Funzione HUB (uno a tre)](/it/tutorials/accessories/kvm-switch/02-HUB-Function-One-to-Three),- [03 · Bluetooth](/it/tutorials/accessories/kvm-switch/03-Bluetooth),- [04 · Porta seriale TTL (seriale wireless)](/it/tutorials/accessories/kvm-switch/04-TTL-Serial-Port),- [05 · Connettore di espansione a 10 pin](/it/tutorials/accessories/kvm-switch/05-10-Pin-Expansion-Header),- [06 · Host senza monitor (scheda di acquisizione + OBS)](/it/tutorials/accessories/kvm-switch/06-Headless-Host-Capture-Card-and-OBS),- [07 · Domande frequenti e precauzioni](/it/tutorials/accessories/kvm-switch/07-FAQ-and-Precautions)
- [Scheda audio USB senza driver](/it/tutorials/accessories/usb-audio-card-tutorial)

## Come utilizzare

1. **Seleziona la categoria di argomento**: scegli la categoria corrispondente in base ai tuoi interessi o alle tue esigenze
2. **Visualizza l'elenco dei tutorial**: in ogni categoria, consulta i tutorial e i documenti disponibili
3. **Segui i passaggi**: segui i passaggi dei tutorial per imparare e utilizzare gradualmente il prodotto
4. **Esercitati ed esplora**: durante l'uso reale, prova diverse funzioni e configurazioni per accumulare esperienza

## Altre risorse

- Per domande o suggerimenti, visita il nostro repository GitHub per inviare un Issue
- Segui il nostro blog e i canali social per le ultime novità sui prodotti e sui tutorial
