Juxi-Technology/wiki-documents/docs/content/ja/tutorials/index.md

---
title: チュートリアル
description: "Juxi Technology Wiki のチュートリアル一覧。ロボットアームやカメラなど全製品の使い方と設定ガイドを網羅しています。"
---

# チュートリアル

チュートリアルページへようこそ!ここでは、すべての製品の使い方チュートリアル、設定ガイド、ベストプラクティスを確認でき、すぐに使い始めて製品の機能を最大限に活用できます。

## テーマカテゴリ

### クイックスタート

- [FAQ](/ja/tutorials/faq)
- [ROS 入門](/ja/tutorials/ros-intro)
- [Lark Wiki](/ja/tutorials/lark-wiki)

### SO-ARM101 ロボットアーム 7軸 チュートリアル

- [SO-ARM101 ロボットアーム 7軸 チュートリアル](/tutorials/robot-arms/so-arm101/lerobot-7dof/)
- **1. LeRobot環境のインストール**
  - [Ubuntuコンピューター](/ja/tutorials/robot-arms/so-arm101/lerobot-7dof/01-Environment-Setup/Ubuntu)
  - [Windowsコンピューター](/ja/tutorials/robot-arms/so-arm101/lerobot-7dof/01-Environment-Setup/Windows)
  - [MACコンピューター](/ja/tutorials/robot-arms/so-arm101/lerobot-7dof/01-Environment-Setup/MacOS)
- **2. ファイルの置き換え（7DOF 対応）**
  - [ファイルの置き換え（7DOF 対応）](/ja/tutorials/robot-arms/so-arm101/lerobot-7dof/02-Replace-Files-7DOF)
- **3. シリアルポート番号の確認**
  - [Ubuntu](/ja/tutorials/robot-arms/so-arm101/lerobot-7dof/03-Serial-Port/Ubuntu)
  - [Windowsコンピューター](/ja/tutorials/robot-arms/so-arm101/lerobot-7dof/03-Serial-Port/Windows)
  - [MACコンピューター](/ja/tutorials/robot-arms/so-arm101/lerobot-7dof/03-Serial-Port/MacOS)
- **4. ロボットアームのキャリブレーション**
  - [Ubuntuコンピューター](/ja/tutorials/robot-arms/so-arm101/lerobot-7dof/04-Calibration/Ubuntu)
  - [Windowsコンピューター](/ja/tutorials/robot-arms/so-arm101/lerobot-7dof/04-Calibration/Windows)
  - [Macコンピューター](/ja/tutorials/robot-arms/so-arm101/lerobot-7dof/04-Calibration/MacOS)
- **5. テレオペレーション**
  - [Ubuntuコンピューター](/ja/tutorials/robot-arms/so-arm101/lerobot-7dof/05-Teleoperation/Ubuntu)
  - [Windowsコンピューター](/ja/tutorials/robot-arms/so-arm101/lerobot-7dof/05-Teleoperation/Windows)
  - [Macコンピューター](/ja/tutorials/robot-arms/so-arm101/lerobot-7dof/05-Teleoperation/MacOS)
- **6. カメラ付きテレオペレーション**
  - [Ubuntuコンピューター](/ja/tutorials/robot-arms/so-arm101/lerobot-7dof/06-Camera-Teleoperation/Ubuntu)
  - [Windowsコンピューター](/ja/tutorials/robot-arms/so-arm101/lerobot-7dof/06-Camera-Teleoperation/Windows)
  - [Macコンピューター](/ja/tutorials/robot-arms/so-arm101/lerobot-7dof/06-Camera-Teleoperation/MacOS)
- **7. データセット収集（実機）**
  - [データセットの確認・リプレイ](/ja/tutorials/robot-arms/so-arm101/lerobot-7dof/07-Data-Collection/Browse-and-Replay)
  - [データセット収集の注意事項](/ja/tutorials/robot-arms/so-arm101/lerobot-7dof/07-Data-Collection/Collection-Notes)
  - [Hugging Faceアカウントの登録（任意）](/ja/tutorials/robot-arms/so-arm101/lerobot-7dof/07-Data-Collection/HF-Account)
  - [データセットをHuggingFaceにアップロード（任意）](/ja/tutorials/robot-arms/so-arm101/lerobot-7dof/07-Data-Collection/HF-Dataset-Upload)
  - [教示によるデータセット収集-握手200](/ja/tutorials/robot-arms/so-arm101/lerobot-7dof/07-Data-Collection/Teaching-and-Recording-Handshake-200)
  - [教示によるデータセット収集](/ja/tutorials/robot-arms/so-arm101/lerobot-7dof/07-Data-Collection/Teaching-and-Recording)
- **8. モデルの訓練**
  - [クラウドGPU訓練環境の設定](/ja/tutorials/robot-arms/so-arm101/lerobot-7dof/08-Training/Cloud-GPU)
  - [訓練コマンドライン-ACT（入門に推奨）](/ja/tutorials/robot-arms/so-arm101/lerobot-7dof/08-Training/Command-ACT)
  - [訓練コマンドライン-Diffusion](/ja/tutorials/robot-arms/so-arm101/lerobot-7dof/08-Training/Command-Diffusion)
  - [訓練コマンドライン-pi0.5](/ja/tutorials/robot-arms/so-arm101/lerobot-7dof/08-Training/Command-pi0.5)
  - [訓練コマンドライン-pi0（効果が最も良い）](/ja/tutorials/robot-arms/so-arm101/lerobot-7dof/08-Training/Command-pi0)
  - [訓練コマンドライン-pi0fast](/ja/tutorials/robot-arms/so-arm101/lerobot-7dof/08-Training/Command-pi0fast)
  - [訓練コマンドライン-smolvla（次のステップに推奨）](/ja/tutorials/robot-arms/so-arm101/lerobot-7dof/08-Training/Command-smolvla)
  - [モデルをHuggingFaceにアップロード（任意）](/ja/tutorials/robot-arms/so-arm101/lerobot-7dof/08-Training/HF-Model-Upload)
  - [LeRobotがサポートする模倣学習アルゴリズム](/ja/tutorials/robot-arms/so-arm101/lerobot-7dof/08-Training/Imitation-Learning-Algorithms)
  - [ローカルUbuntuでの訓練](/ja/tutorials/robot-arms/so-arm101/lerobot-7dof/08-Training/Local-Ubuntu)
  - [モデルの重みファイルを取得](/ja/tutorials/robot-arms/so-arm101/lerobot-7dof/08-Training/Model-Weights)
  - [訓練パラメータの提案](/ja/tutorials/robot-arms/so-arm101/lerobot-7dof/08-Training/Training-Parameter-Tips)
  - [wandbでリアルタイム訓練曲線を確認](/ja/tutorials/robot-arms/so-arm101/lerobot-7dof/08-Training/WandB-Curves)
- **9. モデルのデプロイ**
  - [コマンドラインの説明](/ja/tutorials/robot-arms/so-arm101/lerobot-7dof/09-Inference/CLI-Reference)
  - [推論コマンドライン-ACT](/ja/tutorials/robot-arms/so-arm101/lerobot-7dof/09-Inference/Command-ACT)
  - [推論コマンドライン-Diffusion](/ja/tutorials/robot-arms/so-arm101/lerobot-7dof/09-Inference/Command-Diffusion)
  - [推論コマンドライン-pi0.5](/ja/tutorials/robot-arms/so-arm101/lerobot-7dof/09-Inference/Command-pi0.5)
  - [推論コマンドライン-pi0](/ja/tutorials/robot-arms/so-arm101/lerobot-7dof/09-Inference/Command-pi0)
  - [推論コマンドライン-smolvla](/ja/tutorials/robot-arms/so-arm101/lerobot-7dof/09-Inference/Command-smolvla)
  - [よくあるBugと解決方法](/ja/tutorials/robot-arms/so-arm101/lerobot-7dof/09-Inference/Common-Bugs)
  - [NVIDIA DGX Spark 推論](/ja/tutorials/robot-arms/so-arm101/lerobot-7dof/09-Inference/DGX-Spark)
  - [地瓜机器人（D-Robotics） RDK S100 推論](/ja/tutorials/robot-arms/so-arm101/lerobot-7dof/09-Inference/RDK-S100)

### Jetson AGX Orin 開発キット

- [クイックスタート](/ja/tutorials/jetson-agx-orin/quick-start)
- [書き込みと更新](/ja/tutorials/jetson-agx-orin/flashing-and-updates)
- [システムの確認](/ja/tutorials/jetson-agx-orin/verify-your-system)
- [インターフェース & ハードウェアレイアウト](/ja/tutorials/jetson-agx-orin/interfaces)
- [製品概要](/ja/tutorials/jetson-agx-orin/overview)
- [ローカル LLM 推論](/ja/tutorials/jetson-agx-orin/local-llm)
- [エージェント型 AI(NemoClaw)](/ja/tutorials/jetson-agx-orin/agentic-ai)
- [DeepStream 映像解析](/ja/tutorials/jetson-agx-orin/deepstream)
- [ロボティクス(現状)](/ja/tutorials/jetson-agx-orin/robotics)
- [メモリ効率](/ja/tutorials/jetson-agx-orin/memory-efficiency)
- [JetPack 6.x からの移行](/ja/tutorials/jetson-agx-orin/jetpack-6-to-7)
- [ダウンロード](/ja/tutorials/jetson-agx-orin/downloads)
- [FAQ](/ja/tutorials/jetson-agx-orin/faq)
- [トラブルシューティング](/ja/tutorials/jetson-agx-orin/troubleshooting)
- [用語集](/ja/tutorials/jetson-agx-orin/glossary)
- [変更履歴](/ja/tutorials/jetson-agx-orin/changelog)
- [XLeRobot Docker — 01 · 概要](/ja/tutorials/jetson-agx-orin/xlerobot-docker/deployment/01-Overview)
- [XLeRobot Docker — 02 · 環境準備](/ja/tutorials/jetson-agx-orin/xlerobot-docker/deployment/02-Environment-Setup)
- [XLeRobot Docker — 03 · デプロイ](/ja/tutorials/jetson-agx-orin/xlerobot-docker/deployment/03-Deployment)
- [XLeRobot Docker — 原版 LeRobot の実行コマンド](/ja/tutorials/jetson-agx-orin/xlerobot-docker/lerobot/01-Operation)
- [XLeRobot Docker — XLeRobot の実行コマンド](/ja/tutorials/jetson-agx-orin/xlerobot-docker/xlerobot/01-Operation)
- [XLeRobot Docker — トラブルシューティングと早見表](/ja/tutorials/jetson-agx-orin/xlerobot-docker/troubleshooting/01-Troubleshooting)

### Jetson Orin Nano Super 開発キット

- [クイックスタート](/ja/tutorials/jetson-orin-nano/quick-start)
- [書き込みと更新](/ja/tutorials/jetson-orin-nano/flashing-and-updates)
- [システムの確認](/ja/tutorials/jetson-orin-nano/verify-your-system)
- [インターフェース & ハードウェアレイアウト](/ja/tutorials/jetson-orin-nano/interfaces)
- [製品概要](/ja/tutorials/jetson-orin-nano/overview)
- [ローカル LLM 推論](/ja/tutorials/jetson-orin-nano/local-llm)
- [エージェント型 AI(NemoClaw)](/ja/tutorials/jetson-orin-nano/agentic-ai)
- [DeepStream 映像解析](/ja/tutorials/jetson-orin-nano/deepstream)
- [ロボティクス(現状)](/ja/tutorials/jetson-orin-nano/robotics)
- [メモリ効率](/ja/tutorials/jetson-orin-nano/memory-efficiency)
- [JetPack 6.x からの移行](/ja/tutorials/jetson-orin-nano/jetpack-6-to-7)
- [ダウンロード](/ja/tutorials/jetson-orin-nano/downloads)
- [FAQ](/ja/tutorials/jetson-orin-nano/faq)
- [トラブルシューティング](/ja/tutorials/jetson-orin-nano/troubleshooting)
- [用語集](/ja/tutorials/jetson-orin-nano/glossary)
- [変更履歴](/ja/tutorials/jetson-orin-nano/changelog)
- [XLeRobot Docker — 01 · 概要](/ja/tutorials/jetson-orin-nano/xlerobot-docker/deployment/01-Overview)
- [XLeRobot Docker — 02 · 環境準備](/ja/tutorials/jetson-orin-nano/xlerobot-docker/deployment/02-Environment-Setup)
- [XLeRobot Docker — 03 · デプロイ](/ja/tutorials/jetson-orin-nano/xlerobot-docker/deployment/03-Deployment)
- [XLeRobot Docker — 原版 LeRobot の実行コマンド](/ja/tutorials/jetson-orin-nano/xlerobot-docker/lerobot/01-Operation)
- [XLeRobot Docker — XLeRobot の実行コマンド](/ja/tutorials/jetson-orin-nano/xlerobot-docker/xlerobot/01-Operation)
- [XLeRobot Docker — トラブルシューティングと早見表](/ja/tutorials/jetson-orin-nano/xlerobot-docker/troubleshooting/01-Troubleshooting)

### 学習リソース

- [学習リソース](/ja/tutorials/learning-resources/)
- [Jetson Orin での PyTorch 非互換問題](/ja/tutorials/learning-resources/jetson-orin-pytorch-compatibility)

### ロボットアーム

- [ロボットアームシリーズ](/ja/tutorials/robot-arms/)
- [選定ガイド](/ja/tutorials/robot-arms/select-guide)
  - **SO-ARM101 シリーズ**
    - [SO-ARM101 ロボットアームチュートリアル](/ja/tutorials/robot-arms/so-arm101/)
    - [LeRobot ロボットアームチュートリアル](/ja/tutorials/robot-arms/so-arm101/SO-ARM101-Tutorial)
    - [Lerobot ロボットアーム組立ガイド](/ja/tutorials/robot-arms/so-arm101/SO-ARM101-Assembly)
    - [Jetson Orin での PyTorch 非互換問題](/ja/tutorials/robot-arms/so-arm101/SO-ARM101-Jetson-Orin-PyTorch-Compatibility)
    - [SO-ARM100&101 アーム搭載ブラケットと環境カメラキット 取付チュートリアル](/ja/tutorials/robot-arms/so-arm101/SO-ARM101-100-Arm-Mount-Camera-Kit-Installation)
    - [オーバーヘッドカメラマウント取付ガイド](/ja/tutorials/robot-arms/so-arm101/SO-ARM101-Overhead-Camera-Mount-Installation)
    - [SO-ARM101 ワイヤレス遠隔操作(ESP32-NanoCam 版)](/ja/tutorials/robot-arms/so-arm101/SO-ARM101-NanoCam-Wireless-Teleop)
    - [遠隔操作トラブルシューティング](/ja/tutorials/robot-arms/so-arm101/SO-ARM101-NanoCam-Troubleshooting)
    - [SO-ARM101 デュアルアーム(デュアルフォロワー)チュートリアル](/ja/tutorials/robot-arms/so-arm101/SO-ARM101-Bi-Arm-Tutorial)
    - [SoARM シリーズ サーボキャリブレーションツール使用チュートリアル](/ja/tutorials/robot-arms/so-arm101/SO-ARM101-Servo-Calibration-Tool)
    - [So-ARM シリーズ STS3215 サーボキャリブレーション – Web 版](/ja/tutorials/robot-arms/so-arm101/SO-ARM101-Web-Calibration)
      - **LeRobot完全コース**
        - [LeRobot完全コース](/ja/tutorials/robot-arms/so-arm101/lerobot/)
          - **1. LeRobot環境のインストール**
            - [ステップ1:LeRobot環境のインストール（Ubuntu）](/ja/tutorials/robot-arms/so-arm101/lerobot/01-Environment-Setup/Ubuntu)
            - [ステップ1:LeRobot環境のインストール（Windows）](/ja/tutorials/robot-arms/so-arm101/lerobot/01-Environment-Setup/Windows)
            - [ステップ1:LeRobot環境のインストール（macOS）](/ja/tutorials/robot-arms/so-arm101/lerobot/01-Environment-Setup/MacOS)
          - **2. シリアルポート番号の確認**
            - [ステップ2:シリアルポート番号の確認（Ubuntu）](/ja/tutorials/robot-arms/so-arm101/lerobot/02-Serial-Port/Ubuntu)
            - [ステップ2:シリアルポート番号の確認（Windows）](/ja/tutorials/robot-arms/so-arm101/lerobot/02-Serial-Port/Windows)
            - [ステップ2:シリアルポート番号の確認（macOS）](/ja/tutorials/robot-arms/so-arm101/lerobot/02-Serial-Port/MacOS)
          - **3. ロボットアームのキャリブレーション**
            - [ステップ3:ロボットアームのキャリブレーション（Ubuntu）](/ja/tutorials/robot-arms/so-arm101/lerobot/03-Calibration/Ubuntu)
            - [ステップ3:ロボットアームのキャリブレーション（Windows）](/ja/tutorials/robot-arms/so-arm101/lerobot/03-Calibration/Windows)
            - [ステップ3:ロボットアームのキャリブレーション（macOS）](/ja/tutorials/robot-arms/so-arm101/lerobot/03-Calibration/MacOS)
          - **4. テレオペレーション**
            - [ステップ4:テレオペレーション（Ubuntu）](/ja/tutorials/robot-arms/so-arm101/lerobot/04-Teleoperation/Ubuntu)
            - [ステップ4:テレオペレーション（Windows）](/ja/tutorials/robot-arms/so-arm101/lerobot/04-Teleoperation/Windows)
            - [ステップ4:テレオペレーション（macOS）](/ja/tutorials/robot-arms/so-arm101/lerobot/04-Teleoperation/MacOS)
          - **5. カメラ付きテレオペレーション**
            - [ステップ5:カメラ付きテレオペレーション（Ubuntu）](/ja/tutorials/robot-arms/so-arm101/lerobot/05-Camera-Teleoperation/Ubuntu)
            - [ステップ5:カメラ付きテレオペレーション（Windows）](/ja/tutorials/robot-arms/so-arm101/lerobot/05-Camera-Teleoperation/Windows)
            - [ステップ5:カメラ付きテレオペレーション（macOS）](/ja/tutorials/robot-arms/so-arm101/lerobot/05-Camera-Teleoperation/MacOS)
          - **6. データセット収集（実機）**
            - [ステップ6:教示によるデータセット収集](/ja/tutorials/robot-arms/so-arm101/lerobot/06-Data-Collection/Teaching-and-Recording)
            - [ステップ6:教示データ収集-Handshake 200](/ja/tutorials/robot-arms/so-arm101/lerobot/06-Data-Collection/Teaching-and-Recording-Handshake-200)
            - [ステップ6:データセットの表示と再生](/ja/tutorials/robot-arms/so-arm101/lerobot/06-Data-Collection/Browse-and-Replay)
            - [ステップ6:データセット収集の注意事項](/ja/tutorials/robot-arms/so-arm101/lerobot/06-Data-Collection/Collection-Notes)
            - [ステップ6:HuggingFaceアカウントの登録（任意）](/ja/tutorials/robot-arms/so-arm101/lerobot/06-Data-Collection/HF-Account)
            - [ステップ6:データセットをHuggingFaceにアップロード（任意）](/ja/tutorials/robot-arms/so-arm101/lerobot/06-Data-Collection/HF-Dataset-Upload)
            - [ステップ7(シミュレーション):データセット収集 — Lightwheel LeIsaac シミュレーション・テレオペレーション](/ja/tutorials/robot-arms/so-arm101/lerobot/06-Data-Collection/LeIsaac-Sim)
          - **7. モデルの訓練**
            - [ステップ7:ローカルUbuntuでの訓練](/ja/tutorials/robot-arms/so-arm101/lerobot/07-Training/Local-Ubuntu)
            - [ステップ7:クラウドGPU訓練環境の設定](/ja/tutorials/robot-arms/so-arm101/lerobot/07-Training/Cloud-GPU)
            - [ステップ7:wandbでリアルタイム訓練曲線を確認](/ja/tutorials/robot-arms/so-arm101/lerobot/07-Training/WandB-Curves)
            - [ステップ7:モデルをHuggingFaceにアップロード（任意）](/ja/tutorials/robot-arms/so-arm101/lerobot/07-Training/HF-Model-Upload)
            - [ステップ7:モデルの重みファイルを取得](/ja/tutorials/robot-arms/so-arm101/lerobot/07-Training/Model-Weights)
            - [ステップ7:訓練コマンドライン-ACT](/ja/tutorials/robot-arms/so-arm101/lerobot/07-Training/Command-ACT)
            - [ステップ7:訓練コマンドライン-pi0](/ja/tutorials/robot-arms/so-arm101/lerobot/07-Training/Command-pi0)
            - [ステップ7:訓練コマンドライン-pi0.5](/ja/tutorials/robot-arms/so-arm101/lerobot/07-Training/Command-pi0.5)
            - [ステップ7:訓練コマンドライン-pi0fast](/ja/tutorials/robot-arms/so-arm101/lerobot/07-Training/Command-pi0fast)
            - [ステップ7:訓練コマンドライン-smolvla](/ja/tutorials/robot-arms/so-arm101/lerobot/07-Training/Command-smolvla)
            - [ステップ7:訓練コマンドライン-Diffusion](/ja/tutorials/robot-arms/so-arm101/lerobot/07-Training/Command-Diffusion)
            - [ステップ7:訓練コマンドライン-WALL-OSS](/ja/tutorials/robot-arms/so-arm101/lerobot/07-Training/Command-Wall-OSS)
            - [ステップ7:訓練コマンドライン](/ja/tutorials/robot-arms/so-arm101/lerobot/07-Training/Train-CLI)
            - [ステップ7:訓練パラメーターの推奨](/ja/tutorials/robot-arms/so-arm101/lerobot/07-Training/Training-Parameters)
            - [ステップ7:LeRobot がサポートする模倣学習アルゴリズム](/ja/tutorials/robot-arms/so-arm101/lerobot/07-Training/Imitation-Learning-Algorithms)
          - **8. モデルのデプロイ**
            - [ステップ8:デプロイコマンドラインの説明](/ja/tutorials/robot-arms/so-arm101/lerobot/08-Inference/CLI-Reference)
            - [ステップ8:よくあるBugと解決方法](/ja/tutorials/robot-arms/so-arm101/lerobot/08-Inference/Common-Bugs)
            - [ステップ8:デプロイコマンドライン-ACT](/ja/tutorials/robot-arms/so-arm101/lerobot/08-Inference/Command-ACT)
            - [ステップ8:デプロイコマンドライン-pi0](/ja/tutorials/robot-arms/so-arm101/lerobot/08-Inference/Command-pi0)
            - [ステップ8:デプロイコマンドライン-pi0.5](/ja/tutorials/robot-arms/so-arm101/lerobot/08-Inference/Command-pi0.5)
            - [ステップ8:デプロイコマンドライン-smolvla](/ja/tutorials/robot-arms/so-arm101/lerobot/08-Inference/Command-smolvla)
            - [ステップ8:デプロイコマンドライン-Diffusion](/ja/tutorials/robot-arms/so-arm101/lerobot/08-Inference/Command-Diffusion)
            - [ステップ8:デプロイコマンドライン-WALL-OSS](/ja/tutorials/robot-arms/so-arm101/lerobot/08-Inference/Command-Wall-OSS)
            - [ステップ8:NVIDIA DGX Spark での推論](/ja/tutorials/robot-arms/so-arm101/lerobot/08-Inference/DGX-Spark)
            - [ステップ8:D-Robotics RDK S100 での推論](/ja/tutorials/robot-arms/so-arm101/lerobot/08-Inference/RDK-S100)
          - **基礎知識**
            - [LeRobotを知る](/ja/tutorials/robot-arms/so-arm101/basics/Understanding-LeRobot)
            - [HuggingFace上のLeRobotデータセット](/ja/tutorials/robot-arms/so-arm101/basics/HF-Datasets)
            - [モデルトレーニングの資料](/ja/tutorials/robot-arms/so-arm101/basics/Training-Resources)
            - [SO-ARM 100公式3Dプリントファイル](/ja/tutorials/robot-arms/so-arm101/basics/Official-3D-Print-Files)
            - [URDFファイルおよび資料参考](/ja/tutorials/robot-arms/so-arm101/basics/URDF-Reference)
            - [推奨カメラブラケットとマウント](/ja/tutorials/robot-arms/so-arm101/basics/Camera-Mounts-Recommended)
          - **その他・応用**
            - [ROS2シミュレーション制御](/ja/tutorials/robot-arms/so-arm101/ROS2-Simulation-Control)
            - [平行指グリッパー取り付けチュートリアル](/ja/tutorials/robot-arms/so-arm101/Parallel-Finger-Gripper-Installation)
      - **LeLab チュートリアル**
        - [1 · 概要](/ja/tutorials/robot-arms/so-arm101/lelab/01-Overview)
        - [2 · インストールと起動](/ja/tutorials/robot-arms/so-arm101/lelab/02-Install)
        - [3 · 接続とキャリブレーション](/ja/tutorials/robot-arms/so-arm101/lelab/03-Calibration)
        - [4 · テレオペレーション](/ja/tutorials/robot-arms/so-arm101/lelab/04-Teleoperation)
        - [5 · データセットの記録](/ja/tutorials/robot-arms/so-arm101/lelab/05-Record-Dataset)
        - [6 · 訓練と推論](/ja/tutorials/robot-arms/so-arm101/lelab/06-Train-and-Inference)
        - [7 · トラブルシューティング](/ja/tutorials/robot-arms/so-arm101/lelab/07-Troubleshooting)
      - **MuJoCo シミュレーションチュートリアル**,        - [SO-ARM101 × MuJoCo ワークフロー全体チュートリアル（索引）](/ja/tutorials/robot-arms/so-arm101/mujoco/),        - [01 · 環境準備](/ja/tutorials/robot-arms/so-arm101/mujoco/01-Environment),        - [02 · シミュレーションモデル検証（MJCF の読み込みと駆動）](/ja/tutorials/robot-arms/so-arm101/mujoco/02-Sim-Model-Verification),        - [03 · 実機接続とキャリブレーション](/ja/tutorials/robot-arms/so-arm101/mujoco/03-Hardware-Calibration),        - [04 · キーボード遠隔操作](/ja/tutorials/robot-arms/so-arm101/mujoco/04-Keyboard-Teleop),        - [05 · リーダーアームのデジタルツイン（実体アームがシミュレーションアームを駆動）](/ja/tutorials/robot-arms/so-arm101/mujoco/05-Leader-Digital-Twin),        - [06 · データ録画と再生](/ja/tutorials/robot-arms/so-arm101/mujoco/06-Record-and-Replay),        - [07 · よくある問題と経験](/ja/tutorials/robot-arms/so-arm101/mujoco/07-Troubleshooting),        - [08 · 今後のロードマップ](/ja/tutorials/robot-arms/so-arm101/mujoco/08-Roadmap),        - [09 · 完全使用チュートリアル（アーム起動 → データセット → 動画確認 → 学習 → 展開）](/ja/tutorials/robot-arms/so-arm101/mujoco/09-Usage-Tutorial)
  - **SO-ARM101 + AmazingHand チュートリアル**
    - [コース概要](/ja/tutorials/robot-arms/so-arm-amazinghand/)
      - **Linux**
        - [ステージ1：環境構築（Linux）](/ja/tutorials/robot-arms/so-arm-amazinghand/01-Environment-Setup-Linux)
        - [ステージ2:ハンドとアームのキャリブレーション(Linux)](/ja/tutorials/robot-arms/so-arm-amazinghand/02-Hand-Arm-Calibration-Linux)
        - [ステージ3：遠隔操作（Linux）](/ja/tutorials/robot-arms/so-arm-amazinghand/03-Teleoperation-Linux)
        - [ステージ4：データ収集（Linux）](/ja/tutorials/robot-arms/so-arm-amazinghand/04-Data-Collection-Linux)
        - [ステージ5：モデル訓練（Linux）](/ja/tutorials/robot-arms/so-arm-amazinghand/05-Model-Training-Linux)
        - [ステージ6:モデルデプロイ(Linux)](/ja/tutorials/robot-arms/so-arm-amazinghand/06-Model-Deployment-Linux)
      - **Windows**
        - [ステージ1：環境構築（Windows）](/ja/tutorials/robot-arms/so-arm-amazinghand/01-Environment-Setup-Windows)
        - [ステージ2:ハンドとアームのキャリブレーション(Windows)](/ja/tutorials/robot-arms/so-arm-amazinghand/02-Hand-Arm-Calibration-Windows)
        - [ステージ3：遠隔操作（Windows）](/ja/tutorials/robot-arms/so-arm-amazinghand/03-Teleoperation-Windows)
        - [ステージ4：データ収集（Windows）](/ja/tutorials/robot-arms/so-arm-amazinghand/04-Data-Collection-Windows)
        - [ステージ5：モデル訓練（Windows）](/ja/tutorials/robot-arms/so-arm-amazinghand/05-Model-Training-Windows)
        - [ステージ6:モデルデプロイ(Windows)](/ja/tutorials/robot-arms/so-arm-amazinghand/06-Model-Deployment-Windows)
  - **XLeRobot チュートリアル**
    - [チュートリアル概要](/ja/tutorials/robot-arms/xlerobot/)
    - [環境構築(macOS)](/ja/tutorials/robot-arms/xlerobot/01-Environment-Setup-macOS)
    - [環境構築(Ubuntu)](/ja/tutorials/robot-arms/xlerobot/01-Environment-Setup-Ubuntu)
    - [環境構築(Windows)](/ja/tutorials/robot-arms/xlerobot/01-Environment-Setup-Windows)
    - [XLeRobot ファイルの移動](/ja/tutorials/robot-arms/xlerobot/02-Move-Xlerobot-Files)
    - [完成品組み立て](/ja/tutorials/robot-arms/xlerobot/03-Assembly-Assembled-Kit)
    - [パーツキット組み立て](/ja/tutorials/robot-arms/xlerobot/04-Assembly-Parts-Kit)
  - **AmazingHand 多指ハンドチュートリアル総覧**
    - [チュートリアル索引（旧URL含む）](/ja/tutorials/robot-arms/amazing-hand/index.md)
    - [AmazingHand 多指ハンドチュートリアル総覧](/ja/tutorials/robot-arms/amazing-hand/README)
    - [AmazingHand 製品資料](/ja/tutorials/robot-arms/amazing-hand/00-product/product-info)
    - [SCS0009 と PWM のバージョン比較と選定](/ja/tutorials/robot-arms/amazing-hand/00-product/version-comparison)
    - [ダウンロードとリソース](/ja/tutorials/robot-arms/amazing-hand/00-product/downloads)
    - [ハードウェア概要：構造、CAD、組み立て](/ja/tutorials/robot-arms/amazing-hand/01-hardware/overview)
    - [SCS0009 配線、ID、給電](/ja/tutorials/robot-arms/amazing-hand/01-hardware/scs0009)
    - [PWM 配線、GPIO、給電](/ja/tutorials/robot-arms/amazing-hand/01-hardware/pwm)
    - [環境カメラキットの取り付け](/ja/tutorials/robot-arms/amazing-hand/01-hardware/camera-kit)
    - [SCS0009 クイックスタート](/ja/tutorials/robot-arms/amazing-hand/02-quick-start/scs0009)
    - [PWM クイックスタート](/ja/tutorials/robot-arms/amazing-hand/02-quick-start/pwm)
    - [AmazingHand ウェブコントロール](/ja/tutorials/robot-arms/amazing-hand/03-web-control/README)
    - [SCS0009 ウェブコントロール](/ja/tutorials/robot-arms/amazing-hand/03-web-control/scs0009)
    - [PWM ウェブコントロール](/ja/tutorials/robot-arms/amazing-hand/03-web-control/pwm)
    - [SCS0009 デスクトップツール（GUI と CLI）](/ja/tutorials/robot-arms/amazing-hand/04-desktop/scs0009)
    - [PWM デスクトップツール（Tkinter GUI）](/ja/tutorials/robot-arms/amazing-hand/04-desktop/pwm)
    - [SCS0009 ハンドトラッキング（公式 dora Demo）](/ja/tutorials/robot-arms/amazing-hand/05-hand-tracking/scs0009)
    - [PWM ハンドトラッキング（GUI 内蔵 MediaPipe）](/ja/tutorials/robot-arms/amazing-hand/05-hand-tracking/pwm)
    - [SCS0009 サーボ調整とキャリブレーション](/ja/tutorials/robot-arms/amazing-hand/06-servo-tuning/scs0009)
    - [PWM サーボのプロトコル、コマンド、キャリブレーション](/ja/tutorials/robot-arms/amazing-hand/06-servo-tuning/pwm)
    - [Arduino Nano の使い方](/ja/tutorials/robot-arms/amazing-hand/07-arduino/arduino-nano)
    - [Arduino と Python のサンプル](/ja/tutorials/robot-arms/amazing-hand/07-arduino/examples)
    - [よくある問題（FAQ）](/ja/tutorials/robot-arms/amazing-hand/08-faq/faq)
  - **Lekiwi**
    - [Lekiwi 移動ロボット使用チュートリアル](/ja/tutorials/robot-arms/lekiwi/Lekiwi-Tutorial)
    - [Lekiwi 移動ロボット組み立てチュートリアル](/ja/tutorials/robot-arms/lekiwi/Lekiwi-Assembly)
  - **SR-Support 自己起立ロボットチュートリアル**
    - [SR-Support 自己起立ロボットチュートリアル](/ja/tutorials/robot-arms/sr-support/)
    - [01 基礎知識](/ja/tutorials/robot-arms/sr-support/01-basics)
    - [02 環境構築（venv、書き込みツール、ファームウェア）](/ja/tutorials/robot-arms/sr-support/02-environment)
    - [03 メインファームウェアの書き込み](/ja/tutorials/robot-arms/sr-support/03-build-flash)
    - [04 組立：プリント・組み立て・配線](/ja/tutorials/robot-arms/sr-support/04-assembly)
    - [05 ゼロ点校正（矢印キー；DIY ビルドでは必須）](/ja/tutorials/robot-arms/sr-support/05-zero-tool)
    - [06 デバッグとキャリブレーション](/ja/tutorials/robot-arms/sr-support/06-debug-and-calibrate)
    - [07 自己起立の使用方法とモニタリング](/ja/tutorials/robot-arms/sr-support/07-self-righting)
    - [08 WiFi ステータスページとプロビジョニング](/ja/tutorials/robot-arms/sr-support/08-wifi)
    - [09 MuJoCo シミュレーションとライブツイン](/ja/tutorials/robot-arms/sr-support/09-mujoco)
    - [10 トラブルシューティング](/ja/tutorials/robot-arms/sr-support/10-troubleshooting)
    - [11 リファレンス：モデル・パラメータ・ライセンス](/ja/tutorials/robot-arms/sr-support/11-reference)

### センサー

- [センサーと知覚](/ja/tutorials/sensors/)
- [IMU キャリブレーション](/ja/tutorials/sensors/imu/calibration)
- [ファイルリモート転送](/ja/tutorials/sensors/imu/remote-file-transfer)
- [SSHファイル転送](/ja/tutorials/sensors/imu/ssh-file-transfer)
  - **IMU 慣性ナビゲーション**
    - [製品情報](/ja/tutorials/sensors/imu/product-info)
    - [Web ホストコンソール](/ja/tutorials/sensors/imu/web-host-console)
    - [MicroDuck 連携](/ja/tutorials/sensors/imu/microduck-integration)
      - **マルチボード例**
        - [マルチホスト通信ケース概要](/ja/tutorials/sensors/imu/multi-board-examples/overview)
        - [PC 通信](/ja/tutorials/sensors/imu/multi-board-examples/pc-communication)
          - **I2C 通信**
            - [Arduino](/ja/tutorials/sensors/imu/multi-board-examples/i2c-communication/arduino)
            - [Jetsonシリーズ](/ja/tutorials/sensors/imu/multi-board-examples/i2c-communication/jetson)
            - [Raspberry Pi 5](/ja/tutorials/sensors/imu/multi-board-examples/i2c-communication/raspberry-pi)
            - [RDKシリーズ](/ja/tutorials/sensors/imu/multi-board-examples/i2c-communication/rdk)
            - [STM32 F103C8T6](/ja/tutorials/sensors/imu/multi-board-examples/i2c-communication/stm32)
          - **シリアル通信**
            - [Arduino](/ja/tutorials/sensors/imu/multi-board-examples/serial-communication/arduino)
            - [Jetsonシリーズ](/ja/tutorials/sensors/imu/multi-board-examples/serial-communication/jetson)
            - [Raspberry Pi 5](/ja/tutorials/sensors/imu/multi-board-examples/serial-communication/raspberry-pi)
            - [RDKシリーズ](/ja/tutorials/sensors/imu/multi-board-examples/serial-communication/rdk)
            - [STM32 F103C8T6](/ja/tutorials/sensors/imu/multi-board-examples/serial-communication/stm32)
      - **ROS サンプル**
        - [ROS1 応用](/ja/tutorials/sensors/imu/ros-examples/ros1)
        - [ROS2 応用](/ja/tutorials/sensors/imu/ros-examples/ros2)
  - **GPS 北斗測位モジュール**
    - [モジュール資料](/ja/tutorials/sensors/gps/GPS-Module-Info)
    - [51 マイコン:GPS 解析](/ja/tutorials/sensors/gps/51-MCU-GPS-Parsing)
    - [Arduino:位置情報の読み取り](/ja/tutorials/sensors/gps/Arduino-Location-Reading)
    - [Arduino:位置情報の解析](/ja/tutorials/sensors/gps/Arduino-Location-Parsing)
    - [STM32F103:GPS 解析出力](/ja/tutorials/sensors/gps/STM32F103-GPS-Parsing)
    - [Jetson:位置情報解析](/ja/tutorials/sensors/gps/Jetson-GPS-Parsing)
    - [Jetson:AGNSS 支援測位](/ja/tutorials/sensors/gps/Jetson-AGNSS)
    - [Jetson:百度地図 API 申請](/ja/tutorials/sensors/gps/Jetson-Baidu-Map-API)
    - [ラズベリーパイ:位置情報解析](/ja/tutorials/sensors/gps/RaspberryPi-GPS-Parsing)
    - [ラズベリーパイ:AGNSS 支援測位](/ja/tutorials/sensors/gps/RaspberryPi-AGNSS)
    - [ラズベリーパイ:百度地図 API 申請](/ja/tutorials/sensors/gps/RaspberryPi-Baidu-Map-API)
    - [ROS:事前準備](/ja/tutorials/sensors/gps/ROS-Preparation)
    - [ROS:GPS データの読み取り](/ja/tutorials/sensors/gps/ROS-Read-GPS-Data)
    - [ROS:GPS 軌跡の描画](/ja/tutorials/sensors/gps/ROS-Draw-GPS-Track)
    - [地図の位置誤差](/ja/tutorials/sensors/gps/Map-Location-Error)

### アクセサリー

- [ロボットアクセサリ](/ja/tutorials/accessories/)
  - [USB オートフォーカスカメラ](/ja/tutorials/accessories/usb-auto-focus-camera)
  - [Jetson CSI カメラ](/ja/tutorials/accessories/jetson-csi-camera)
    - **KWS 音声認識モジュール**
      - [シリーズチュートリアルホーム](/ja/tutorials/accessories/KWS-speech-recognition-module/)
      - [Jetson Nano シリアル通信](/ja/tutorials/accessories/KWS-speech-recognition-module/Jetson-Nano-serial-communication)
      - [Jetson シリアル通信](/ja/tutorials/accessories/KWS-speech-recognition-module/Jetson-serial-communication)
      - [PC シリアル通信](/ja/tutorials/accessories/KWS-speech-recognition-module/PC-serial-communication)
      - [ラズベリーパイシリアル通信](/ja/tutorials/accessories/KWS-speech-recognition-module/raspberry-pi-serial-communication)
      - [ROS2 RViz2 可視化](/ja/tutorials/accessories/KWS-speech-recognition-module/ROS2-rviz2-visualization)
      - [中英認識語ファームウェアのダウンロードと書き込み](/ja/tutorials/accessories/KWS-speech-recognition-module/download-and-burn-firmware-for-chinese-and-english-recognition-words)
    - **Feetech サーボ**
      - [STS3215 & SCS0009 デバッグチュートリアル](/ja/tutorials/accessories/feetech/Feetech-STS3215&SCS0009-Tutorial)
      - [SCS 通信プロトコル](/ja/tutorials/accessories/feetech/Feetech-SCS_Communication_Protocol)
      - [磁気エンコーダ STS サーボ - メモリテーブル解析](/ja/tutorials/accessories/feetech/Feetech-Magnetic_Encoder_STS_Servo-Memory_Table_Analysis)
      - [ポテンショメータ SCSCL サーボ - メモリテーブル解析](/ja/tutorials/accessories/feetech/Feetech-Potentiometer_SCSCL_Servo-Memory_Table_Analysis)
      - [SCS0009 サーボデバッグツール使用チュートリアル](/ja/tutorials/accessories/feetech/SCS0009-Debug-Tool)
    - [Feetech バスサーボ Web デバッグ（SCS0009 / STS3215 / HD1910）](/ja/tutorials/accessories/feetech/Feetech-Web-Debugger)
    - **ESP32-NanoCam 映像伝送モジュール**
      - [ESP32-NanoCam クイックスタート](/ja/tutorials/accessories/esp32-nanocam/ESP32-NanoCam-Quick-Start)
      - [ESP32-NanoCam ハードウェア仕様書](/ja/tutorials/accessories/esp32-nanocam/ESP32-NanoCam-Hardware-Spec)
      - [ESP32-NanoCam シリアルプロトコルマニュアル](/ja/tutorials/accessories/esp32-nanocam/ESP32-NanoCam-Serial-Protocol)
        - **AI ビジョンチュートリアル(全 11 章)**
          - [第 1 章:環境構築](/ja/tutorials/accessories/esp32-nanocam/Ch01-Environment-Setup)
          - [第 2 章:クイックスタート](/ja/tutorials/accessories/esp32-nanocam/Ch02-Quick-Start)
          - [第 3 章:カメラの基礎](/ja/tutorials/accessories/esp32-nanocam/Ch03-Camera-Basics)
          - [第 4 章:顔検出](/ja/tutorials/accessories/esp32-nanocam/Ch04-Face-Detection)
          - [第 5 章:猫顔検出](/ja/tutorials/accessories/esp32-nanocam/Ch05-Cat-Face-Detection)
          - [第 6 章:色認識](/ja/tutorials/accessories/esp32-nanocam/Ch06-Color-Recognition)
          - [第 7 章:QR コードスキャン](/ja/tutorials/accessories/esp32-nanocam/Ch07-QR-Code-Scanning)
          - [第 8 章:顔認識](/ja/tutorials/accessories/esp32-nanocam/Ch08-Face-Recognition)
          - [第 9 章:音声対話](/ja/tutorials/accessories/esp32-nanocam/Ch09-Voice-Chat)
          - [第 10 章:AI 視覚理解](/ja/tutorials/accessories/esp32-nanocam/Ch10-AI-Vision-Understanding)
          - [第 11 章:ESP-Claw 音声制御](/ja/tutorials/accessories/esp32-nanocam/Ch11-ESP-Claw-Voice-Control)
    - **CSI カメラ使用チュートリアル**
      - [Jetson CSI カメラ設定](/ja/tutorials/accessories/csi-camera/01-Jetson-CSI-Setup)
      - [オートフォーカスカメラの使用](/ja/tutorials/accessories/csi-camera/02-Auto-Focus-Camera)
      - [Jupyter Lab の使用](/ja/tutorials/accessories/csi-camera/03-JupyterLab)
      - [JetCam の使用](/ja/tutorials/accessories/csi-camera/04-JetCam)
      - [IMX219(ラズベリーパイ)](/ja/tutorials/accessories/csi-camera/05-IMX219-RaspberryPi)
    - **AI 音声対話モジュール**
      - [クイックスタート](/ja/tutorials/accessories/ai-voice-module/Quick-Start)
      - [製品資料](/ja/tutorials/accessories/ai-voice-module/Product-Info)
      - [モジュールファームウェアの書き込み](/ja/tutorials/accessories/ai-voice-module/Firmware-Flashing)
      - [ウェイクワードとコマンドワードの変更](/ja/tutorials/accessories/ai-voice-module/Wake-Word-Commands-Edit)
      - [カスタムプロトコルエントリーの作成](/ja/tutorials/accessories/ai-voice-module/Custom-Protocol-Entries)
      - [ROS1 音声対話](/ja/tutorials/accessories/ai-voice-module/ROS1-Voice-Interaction)
      - [ROS2 音声対話](/ja/tutorials/accessories/ai-voice-module/ROS2-Voice-Interaction)
      - [シリアルポートプロトコル](/ja/tutorials/accessories/ai-voice-module/Serial-Protocol)
      - [IIC プロトコル](/ja/tutorials/accessories/ai-voice-module/IIC-Protocol)
      - [PC 通信](/ja/tutorials/accessories/ai-voice-module/PC-Communication)
      - [Arduino: シリアルポート通信](/ja/tutorials/accessories/ai-voice-module/Arduino-Serial-Communication)
      - [Arduino: IIC 通信](/ja/tutorials/accessories/ai-voice-module/Arduino-IIC-Communication)
      - [Jetson: シリアルポート通信](/ja/tutorials/accessories/ai-voice-module/Jetson-Serial-Communication)
      - [Jetson: IIC 通信](/ja/tutorials/accessories/ai-voice-module/Jetson-IIC-Communication)
      - [RDK: シリアルポート通信](/ja/tutorials/accessories/ai-voice-module/RDK-Serial-Communication)
      - [RDK: IIC 通信](/ja/tutorials/accessories/ai-voice-module/RDK-IIC-Communication)
      - [ラズベリーパイ: シリアルポート通信](/ja/tutorials/accessories/ai-voice-module/RaspberryPi-Serial-Communication)
      - [ラズベリーパイ: IIC 通信](/ja/tutorials/accessories/ai-voice-module/RaspberryPi-IIC-Communication)
  - [2自由度ジンバル](/ja/tutorials/accessories/2dof-camera-gimbal)
- [心拍・血中酸素センサー](/ja/tutorials/accessories/heart-rate-spo2)
- [0.91 インチ OLED スクリーン](/ja/tutorials/accessories/0.91-oled-screen-tutorial)
- [4K HDMI キャプチャカード](/ja/tutorials/accessories/4k-hdmi-capture-tutorial)
- [KVMスイッチ](/ja/tutorials/accessories/kvm-switch-tutorial)
- [KVM スイッチ · チュートリアル概要](/ja/tutorials/accessories/kvm-switch/00-Overview-and-Quick-Start),- [01 · 2台のPC切替（ボタンと赤外線リモコン）](/ja/tutorials/accessories/kvm-switch/01-Switching-Between-Two-Computers),- [02 · HUB機能（1分3）](/ja/tutorials/accessories/kvm-switch/02-HUB-Function-One-to-Three),- [03 · Bluetooth機能](/ja/tutorials/accessories/kvm-switch/03-Bluetooth),- [04 · TTLシリアルポート（ワイヤレスシリアル）](/ja/tutorials/accessories/kvm-switch/04-TTL-Serial-Port),- [05 · 10ピン拡張ヘッダー](/ja/tutorials/accessories/kvm-switch/05-10-Pin-Expansion-Header),- [06 · ディスプレイなしホスト（キャプチャーカード + OBS）](/ja/tutorials/accessories/kvm-switch/06-Headless-Host-Capture-Card-and-OBS),- [07 · よくある質問と注意事項](/ja/tutorials/accessories/kvm-switch/07-FAQ-and-Precautions)
- [USB ドライバ不要サウンドカード](/ja/tutorials/accessories/usb-audio-card-tutorial)

## 使い方

1. **テーマカテゴリを選ぶ**: 興味やニーズに応じて、対応するテーマカテゴリを選択します
2. **チュートリアルリストを確認する**: 各テーマカテゴリで、利用可能なチュートリアルとドキュメントを確認します
3. **手順に従う**: チュートリアルの手順に従って、段階的に製品を学び使用します
4. **実践と探索**: 実際の操作で、さまざまな機能や設定を試して経験を積みます

## その他のリソース

- ご質問やご提案は、GitHub リポジトリにアクセスして Issue を送信してください
- 最新の製品アップデートやチュートリアル情報は、ブログや SNS をフォローしてください
