Juxi-Technology/wiki-documents/docs/content/ko/tutorials/index.md

---
title: 튜토리얼
description: "Juxi Technology 튜토리얼 — 로봇 암과 액세서리, 센서와 인지 등 모든 제품의 사용 튜토리얼과 설정 가이드를 모았습니다."
---

# 튜토리얼

튜토리얼 페이지에 오신 것을 환영합니다! 모든 제품 사용 튜토리얼, 설정 가이드, 모범 사례를 찾아 빠르게 시작하고 제품의 성능을 최대한 활용할 수 있습니다.

## 주제 분류

### 빠른 시작

- [FAQ](/ko/tutorials/faq)
- [ROS 입문](/ko/tutorials/ros-intro)
- [Lark Wiki](/ko/tutorials/lark-wiki)

### SO-ARM101 로봇 암 7축 튜토리얼

- [SO-ARM101 로봇 암 7축 튜토리얼](/tutorials/robot-arms/so-arm101/lerobot-7dof/)
- **1. LeRobot 환경 설치**
  - [Ubuntu 컴퓨터](/ko/tutorials/robot-arms/so-arm101/lerobot-7dof/01-Environment-Setup/Ubuntu)
  - [Windows 컴퓨터](/ko/tutorials/robot-arms/so-arm101/lerobot-7dof/01-Environment-Setup/Windows)
  - [Mac 컴퓨터](/ko/tutorials/robot-arms/so-arm101/lerobot-7dof/01-Environment-Setup/MacOS)
- **2. 2단계: 파일 교체(7DOF 적응)**
  - [2단계: 파일 교체(7DOF 적응)](/ko/tutorials/robot-arms/so-arm101/lerobot-7dof/02-Replace-Files-7DOF)
- **3. 시리얼 포트 확인**
  - [Ubuntu](/ko/tutorials/robot-arms/so-arm101/lerobot-7dof/03-Serial-Port/Ubuntu)
  - [Windows 컴퓨터](/ko/tutorials/robot-arms/so-arm101/lerobot-7dof/03-Serial-Port/Windows)
  - [Mac 컴퓨터](/ko/tutorials/robot-arms/so-arm101/lerobot-7dof/03-Serial-Port/MacOS)
- **4. 로봇 암 캘리브레이션**
  - [Ubuntu 컴퓨터](/ko/tutorials/robot-arms/so-arm101/lerobot-7dof/04-Calibration/Ubuntu)
  - [Windows 컴퓨터](/ko/tutorials/robot-arms/so-arm101/lerobot-7dof/04-Calibration/Windows)
  - [Mac 컴퓨터](/ko/tutorials/robot-arms/so-arm101/lerobot-7dof/04-Calibration/MacOS)
- **5. 원격조작**
  - [Ubuntu 컴퓨터](/ko/tutorials/robot-arms/so-arm101/lerobot-7dof/05-Teleoperation/Ubuntu)
  - [Windows 컴퓨터](/ko/tutorials/robot-arms/so-arm101/lerobot-7dof/05-Teleoperation/Windows)
  - [Mac 컴퓨터](/ko/tutorials/robot-arms/so-arm101/lerobot-7dof/05-Teleoperation/MacOS)
- **6. 카메라 원격조작**
  - [Ubuntu 컴퓨터](/ko/tutorials/robot-arms/so-arm101/lerobot-7dof/06-Camera-Teleoperation/Ubuntu)
  - [Windows 컴퓨터](/ko/tutorials/robot-arms/so-arm101/lerobot-7dof/06-Camera-Teleoperation/Windows)
  - [Mac 컴퓨터](/ko/tutorials/robot-arms/so-arm101/lerobot-7dof/06-Camera-Teleoperation/MacOS)
- **7. 데이터셋 수집**
  - [데이터셋 다시 보기, 재생](/ko/tutorials/robot-arms/so-arm101/lerobot-7dof/07-Data-Collection/Browse-and-Replay)
  - [데이터셋 수집 주의 사항](/ko/tutorials/robot-arms/so-arm101/lerobot-7dof/07-Data-Collection/Collection-Notes)
  - [Hugging Face 계정 등록(선택 사항)](/ko/tutorials/robot-arms/so-arm101/lerobot-7dof/07-Data-Collection/HF-Account)
  - [HuggingFace에 데이터셋 업로드(선택 사항)](/ko/tutorials/robot-arms/so-arm101/lerobot-7dof/07-Data-Collection/HF-Dataset-Upload)
  - [시연 데이터셋 수집-악수 200](/ko/tutorials/robot-arms/so-arm101/lerobot-7dof/07-Data-Collection/Teaching-and-Recording-Handshake-200)
  - [시연 데이터셋 수집](/ko/tutorials/robot-arms/so-arm101/lerobot-7dof/07-Data-Collection/Teaching-and-Recording)
- **8. 모델 학습**
  - [클라우드 GPU 학습 환경 설정](/ko/tutorials/robot-arms/so-arm101/lerobot-7dof/08-Training/Cloud-GPU)
  - [학습 커맨드라인-ACT(입문 추천)](/ko/tutorials/robot-arms/so-arm101/lerobot-7dof/08-Training/Command-ACT)
  - [학습 커맨드라인-Diffusion](/ko/tutorials/robot-arms/so-arm101/lerobot-7dof/08-Training/Command-Diffusion)
  - [학습 커맨드라인-pi0.5](/ko/tutorials/robot-arms/so-arm101/lerobot-7dof/08-Training/Command-pi0.5)
  - [학습 커맨드라인-pi0(효과 최고)](/ko/tutorials/robot-arms/so-arm101/lerobot-7dof/08-Training/Command-pi0)
  - [학습 커맨드라인-pi0fast](/ko/tutorials/robot-arms/so-arm101/lerobot-7dof/08-Training/Command-pi0fast)
  - [학습 커맨드라인-smolvla(심화 추천)](/ko/tutorials/robot-arms/so-arm101/lerobot-7dof/08-Training/Command-smolvla)
  - [HuggingFace에 모델 업로드(선택 사항)](/ko/tutorials/robot-arms/so-arm101/lerobot-7dof/08-Training/HF-Model-Upload)
  - [LeRobot이 지원하는 모방학습 알고리즘](/ko/tutorials/robot-arms/so-arm101/lerobot-7dof/08-Training/Imitation-Learning-Algorithms)
  - [로컬 Ubuntu 학습](/ko/tutorials/robot-arms/so-arm101/lerobot-7dof/08-Training/Local-Ubuntu)
  - [모델 가중치 파일 얻기](/ko/tutorials/robot-arms/so-arm101/lerobot-7dof/08-Training/Model-Weights)
  - [학습 파라미터 제안](/ko/tutorials/robot-arms/so-arm101/lerobot-7dof/08-Training/Training-Parameter-Tips)
  - [wandb 실시간 학습 곡선 확인](/ko/tutorials/robot-arms/so-arm101/lerobot-7dof/08-Training/WandB-Curves)
- **9. 모델 배포**
  - [커맨드라인 설명](/ko/tutorials/robot-arms/so-arm101/lerobot-7dof/09-Inference/CLI-Reference)
  - [추론 커맨드라인-ACT](/ko/tutorials/robot-arms/so-arm101/lerobot-7dof/09-Inference/Command-ACT)
  - [추론 커맨드라인-Diffusion](/ko/tutorials/robot-arms/so-arm101/lerobot-7dof/09-Inference/Command-Diffusion)
  - [추론 커맨드라인-pi0.5](/ko/tutorials/robot-arms/so-arm101/lerobot-7dof/09-Inference/Command-pi0.5)
  - [추론 커맨드라인-pi0](/ko/tutorials/robot-arms/so-arm101/lerobot-7dof/09-Inference/Command-pi0)
  - [추론 커맨드라인-smolvla](/ko/tutorials/robot-arms/so-arm101/lerobot-7dof/09-Inference/Command-smolvla)
  - [자주 발생하는 Bug 및 해결](/ko/tutorials/robot-arms/so-arm101/lerobot-7dof/09-Inference/Common-Bugs)
  - [NVIDIA DGX Spark 추론](/ko/tutorials/robot-arms/so-arm101/lerobot-7dof/09-Inference/DGX-Spark)
  - [D-Robotics RDK S100 추론](/ko/tutorials/robot-arms/so-arm101/lerobot-7dof/09-Inference/RDK-S100)

### Jetson AGX Orin

- [빠른 시작](/ko/tutorials/jetson-agx-orin/quick-start)
- [플래싱 및 업데이트](/ko/tutorials/jetson-agx-orin/flashing-and-updates)
- [시스템 검증](/ko/tutorials/jetson-agx-orin/verify-your-system)
- [인터페이스 & 하드웨어 레이아웃](/ko/tutorials/jetson-agx-orin/interfaces)
- [제품 개요](/ko/tutorials/jetson-agx-orin/overview)
- [로컬 LLM 추론](/ko/tutorials/jetson-agx-orin/local-llm)
- [에이전트 AI (NemoClaw)](/ko/tutorials/jetson-agx-orin/agentic-ai)
- [DeepStream 영상 분석](/ko/tutorials/jetson-agx-orin/deepstream)
- [로보틱스(현황)](/ko/tutorials/jetson-agx-orin/robotics)
- [메모리 효율](/ko/tutorials/jetson-agx-orin/memory-efficiency)
- [JetPack 6.x에서 마이그레이션](/ko/tutorials/jetson-agx-orin/jetpack-6-to-7)
- [다운로드](/ko/tutorials/jetson-agx-orin/downloads)
- [FAQ](/ko/tutorials/jetson-agx-orin/faq)
- [문제 해결](/ko/tutorials/jetson-agx-orin/troubleshooting)
- [용어집](/ko/tutorials/jetson-agx-orin/glossary)
- [변경 이력](/ko/tutorials/jetson-agx-orin/changelog)
- [XLeRobot Docker — 01 · 개요](/ko/tutorials/jetson-agx-orin/xlerobot-docker/deployment/01-Overview)
- [XLeRobot Docker — 02 · 환경 준비](/ko/tutorials/jetson-agx-orin/xlerobot-docker/deployment/02-Environment-Setup)
- [XLeRobot Docker — 03 · 배포](/ko/tutorials/jetson-agx-orin/xlerobot-docker/deployment/03-Deployment)
- [XLeRobot Docker — 원본 LeRobot 실행 명령](/ko/tutorials/jetson-agx-orin/xlerobot-docker/lerobot/01-Operation)
- [XLeRobot Docker — XLeRobot 실행 명령](/ko/tutorials/jetson-agx-orin/xlerobot-docker/xlerobot/01-Operation)
- [XLeRobot Docker — 문제 해결 및 빠른 참조](/ko/tutorials/jetson-agx-orin/xlerobot-docker/troubleshooting/01-Troubleshooting)

### Jetson Orin Nano

- [빠른 시작](/ko/tutorials/jetson-orin-nano/quick-start)
- [플래싱 및 업데이트](/ko/tutorials/jetson-orin-nano/flashing-and-updates)
- [시스템 검증](/ko/tutorials/jetson-orin-nano/verify-your-system)
- [인터페이스 & 하드웨어 레이아웃](/ko/tutorials/jetson-orin-nano/interfaces)
- [제품 개요](/ko/tutorials/jetson-orin-nano/overview)
- [로컬 LLM 추론](/ko/tutorials/jetson-orin-nano/local-llm)
- [에이전트 AI (NemoClaw)](/ko/tutorials/jetson-orin-nano/agentic-ai)
- [DeepStream 영상 분석](/ko/tutorials/jetson-orin-nano/deepstream)
- [로보틱스(현황)](/ko/tutorials/jetson-orin-nano/robotics)
- [메모리 효율](/ko/tutorials/jetson-orin-nano/memory-efficiency)
- [JetPack 6.x에서 마이그레이션](/ko/tutorials/jetson-orin-nano/jetpack-6-to-7)
- [다운로드](/ko/tutorials/jetson-orin-nano/downloads)
- [FAQ](/ko/tutorials/jetson-orin-nano/faq)
- [문제 해결](/ko/tutorials/jetson-orin-nano/troubleshooting)
- [용어집](/ko/tutorials/jetson-orin-nano/glossary)
- [변경 이력](/ko/tutorials/jetson-orin-nano/changelog)
- [XLeRobot Docker — 01 · 개요](/ko/tutorials/jetson-orin-nano/xlerobot-docker/deployment/01-Overview)
- [XLeRobot Docker — 02 · 환경 준비](/ko/tutorials/jetson-orin-nano/xlerobot-docker/deployment/02-Environment-Setup)
- [XLeRobot Docker — 03 · 배포](/ko/tutorials/jetson-orin-nano/xlerobot-docker/deployment/03-Deployment)
- [XLeRobot Docker — 원본 LeRobot 실행 명령](/ko/tutorials/jetson-orin-nano/xlerobot-docker/lerobot/01-Operation)
- [XLeRobot Docker — XLeRobot 실행 명령](/ko/tutorials/jetson-orin-nano/xlerobot-docker/xlerobot/01-Operation)
- [XLeRobot Docker — 문제 해결 및 빠른 참조](/ko/tutorials/jetson-orin-nano/xlerobot-docker/troubleshooting/01-Troubleshooting)

### 학습 리소스

- [학습 리소스](/ko/tutorials/learning-resources/)
- [Jetson Orin에서 PyTorch 비호환 문제](/ko/tutorials/learning-resources/jetson-orin-pytorch-compatibility)

### 로봇 암

- [로봇 팔 시리즈](/ko/tutorials/robot-arms/)
- [선택 가이드](/ko/tutorials/robot-arms/select-guide)
  - **SO-ARM101 시리즈**
    - [SO-ARM101 로봇 암 튜토리얼](/ko/tutorials/robot-arms/so-arm101/)
    - [LeRobot 로봇팔 튜토리얼](/ko/tutorials/robot-arms/so-arm101/SO-ARM101-Tutorial)
    - [Lerobot 로봇 암 조립 가이드](/ko/tutorials/robot-arms/so-arm101/SO-ARM101-Assembly)
    - [Jetson Orin에서 PyTorch 비호환 문제](/ko/tutorials/robot-arms/so-arm101/SO-ARM101-Jetson-Orin-PyTorch-Compatibility)
    - [SO-ARM100&101 암 장착 브래킷 및 환경 카메라 키트 설치 튜토리얼](/ko/tutorials/robot-arms/so-arm101/SO-ARM101-100-Arm-Mount-Camera-Kit-Installation)
    - [오버헤드 카메라 마운트 설치 가이드](/ko/tutorials/robot-arms/so-arm101/SO-ARM101-Overhead-Camera-Mount-Installation)
    - [SO-ARM101 무선 텔레오퍼레이션(ESP32-NanoCam 버전)](/ko/tutorials/robot-arms/so-arm101/SO-ARM101-NanoCam-Wireless-Teleop)
    - [원격조작 문제 해결](/ko/tutorials/robot-arms/so-arm101/SO-ARM101-NanoCam-Troubleshooting)
    - [SO-ARM101 양팔(듀얼 팔로워 암) 튜토리얼](/ko/tutorials/robot-arms/so-arm101/SO-ARM101-Bi-Arm-Tutorial)
    - [SoARM 시리즈 서보 캘리브레이션 도구 사용 튜토리얼](/ko/tutorials/robot-arms/so-arm101/SO-ARM101-Servo-Calibration-Tool)
    - [So-ARM 시리즈 STS3215 서보 캘리브레이션 – 웹 버전](/ko/tutorials/robot-arms/so-arm101/SO-ARM101-Web-Calibration)
      - **LeRobot 전체 코스**
        - [LeRobot 코스 개요](/ko/tutorials/robot-arms/so-arm101/lerobot/)
          - **1. LeRobot 환경 설치**
            - [1단계: LeRobot 환경 설치 (Ubuntu)](/ko/tutorials/robot-arms/so-arm101/lerobot/01-Environment-Setup/Ubuntu)
            - [1단계: LeRobot 환경 설치 (Windows)](/ko/tutorials/robot-arms/so-arm101/lerobot/01-Environment-Setup/Windows)
            - [1단계: LeRobot 환경 설치 (macOS)](/ko/tutorials/robot-arms/so-arm101/lerobot/01-Environment-Setup/MacOS)
          - **2. 시리얼 포트 확인**
            - [2단계: 시리얼 장치 포트 번호 확인 (Ubuntu)](/ko/tutorials/robot-arms/so-arm101/lerobot/02-Serial-Port/Ubuntu)
            - [2단계: 시리얼 장치 포트 번호 확인 (Windows)](/ko/tutorials/robot-arms/so-arm101/lerobot/02-Serial-Port/Windows)
            - [2단계: 시리얼 장치 포트 번호 확인 (macOS)](/ko/tutorials/robot-arms/so-arm101/lerobot/02-Serial-Port/MacOS)
          - **3. 로봇 암 캘리브레이션**
            - [3단계: 로봇 암 캘리브레이션 (Ubuntu)](/ko/tutorials/robot-arms/so-arm101/lerobot/03-Calibration/Ubuntu)
            - [3단계: 로봇 암 캘리브레이션 (Windows)](/ko/tutorials/robot-arms/so-arm101/lerobot/03-Calibration/Windows)
            - [3단계: 로봇 암 캘리브레이션 (macOS)](/ko/tutorials/robot-arms/so-arm101/lerobot/03-Calibration/MacOS)
          - **4. 원격조작**
            - [4단계: 원격조작 (Ubuntu)](/ko/tutorials/robot-arms/so-arm101/lerobot/04-Teleoperation/Ubuntu)
            - [4단계: 원격조작 (Windows)](/ko/tutorials/robot-arms/so-arm101/lerobot/04-Teleoperation/Windows)
            - [4단계: 원격조작 (macOS)](/ko/tutorials/robot-arms/so-arm101/lerobot/04-Teleoperation/MacOS)
          - **5. 카메라 원격조작**
            - [5단계: 카메라 연결 원격조작 (Ubuntu)](/ko/tutorials/robot-arms/so-arm101/lerobot/05-Camera-Teleoperation/Ubuntu)
            - [5단계: 카메라 연결 원격조작 (Windows)](/ko/tutorials/robot-arms/so-arm101/lerobot/05-Camera-Teleoperation/Windows)
            - [5단계: 카메라 연결 원격조작 (macOS)](/ko/tutorials/robot-arms/so-arm101/lerobot/05-Camera-Teleoperation/MacOS)
          - **6. 데이터셋 수집**
            - [6단계: 시연 데이터셋 수집](/ko/tutorials/robot-arms/so-arm101/lerobot/06-Data-Collection/Teaching-and-Recording)
            - [6단계: 시연 데이터셋 수집 — Handshake 200](/ko/tutorials/robot-arms/so-arm101/lerobot/06-Data-Collection/Teaching-and-Recording-Handshake-200)
            - [6단계: 데이터셋 보기 및 재생](/ko/tutorials/robot-arms/so-arm101/lerobot/06-Data-Collection/Browse-and-Replay)
            - [6단계: 데이터셋 수집 주의 사항](/ko/tutorials/robot-arms/so-arm101/lerobot/06-Data-Collection/Collection-Notes)
            - [6단계: Hugging Face 계정 등록(선택 사항)](/ko/tutorials/robot-arms/so-arm101/lerobot/06-Data-Collection/HF-Account)
            - [6단계: HuggingFace에 데이터셋 업로드(선택 사항)](/ko/tutorials/robot-arms/so-arm101/lerobot/06-Data-Collection/HF-Dataset-Upload)
            - [7단계(시뮬레이션): 데이터셋 수집 — Lightwheel LeIsaac 시뮬레이션 원격조작](/ko/tutorials/robot-arms/so-arm101/lerobot/06-Data-Collection/LeIsaac-Sim)
          - **7. 모델 학습**
            - [7단계: 로컬 Ubuntu 학습](/ko/tutorials/robot-arms/so-arm101/lerobot/07-Training/Local-Ubuntu)
            - [7단계: 클라우드 GPU 학습 환경 설정](/ko/tutorials/robot-arms/so-arm101/lerobot/07-Training/Cloud-GPU)
            - [7단계: wandb 실시간 학습 곡선 확인](/ko/tutorials/robot-arms/so-arm101/lerobot/07-Training/WandB-Curves)
            - [7단계: HuggingFace에 모델 업로드(선택 사항)](/ko/tutorials/robot-arms/so-arm101/lerobot/07-Training/HF-Model-Upload)
            - [7단계: 모델 가중치 파일 얻기](/ko/tutorials/robot-arms/so-arm101/lerobot/07-Training/Model-Weights)
            - [7단계: ACT 학습 커맨드라인](/ko/tutorials/robot-arms/so-arm101/lerobot/07-Training/Command-ACT)
            - [7단계: pi0 학습 커맨드라인](/ko/tutorials/robot-arms/so-arm101/lerobot/07-Training/Command-pi0)
            - [7단계: pi0.5 학습 커맨드라인](/ko/tutorials/robot-arms/so-arm101/lerobot/07-Training/Command-pi0.5)
            - [7단계: pi0fast 학습 커맨드라인](/ko/tutorials/robot-arms/so-arm101/lerobot/07-Training/Command-pi0fast)
            - [7단계: smolvla 학습 커맨드라인](/ko/tutorials/robot-arms/so-arm101/lerobot/07-Training/Command-smolvla)
            - [7단계: Diffusion 학습 커맨드라인](/ko/tutorials/robot-arms/so-arm101/lerobot/07-Training/Command-Diffusion)
            - [7단계: WALL-OSS 학습 커맨드라인](/ko/tutorials/robot-arms/so-arm101/lerobot/07-Training/Command-Wall-OSS)
            - [7단계: 학습 커맨드라인](/ko/tutorials/robot-arms/so-arm101/lerobot/07-Training/Train-CLI)
            - [7단계: 학습 파라미터 권장 사항](/ko/tutorials/robot-arms/so-arm101/lerobot/07-Training/Training-Parameters)
            - [7단계: LeRobot가 지원하는 모방 학습 알고리즘](/ko/tutorials/robot-arms/so-arm101/lerobot/07-Training/Imitation-Learning-Algorithms)
          - **8. 모델 배포**
            - [8단계: 커맨드라인 설명](/ko/tutorials/robot-arms/so-arm101/lerobot/08-Inference/CLI-Reference)
            - [8단계: 자주 발생하는 Bug 및 해결](/ko/tutorials/robot-arms/so-arm101/lerobot/08-Inference/Common-Bugs)
            - [8단계: ACT 배포 커맨드라인](/ko/tutorials/robot-arms/so-arm101/lerobot/08-Inference/Command-ACT)
            - [8단계: pi0 배포 커맨드라인](/ko/tutorials/robot-arms/so-arm101/lerobot/08-Inference/Command-pi0)
            - [8단계: pi0.5 배포 커맨드라인](/ko/tutorials/robot-arms/so-arm101/lerobot/08-Inference/Command-pi0.5)
            - [8단계: smolvla 배포 커맨드라인](/ko/tutorials/robot-arms/so-arm101/lerobot/08-Inference/Command-smolvla)
            - [8단계: Diffusion 배포 커맨드라인](/ko/tutorials/robot-arms/so-arm101/lerobot/08-Inference/Command-Diffusion)
            - [8단계: WALL-OSS 배포 커맨드라인](/ko/tutorials/robot-arms/so-arm101/lerobot/08-Inference/Command-Wall-OSS)
            - [8단계: NVIDIA DGX Spark 추론](/ko/tutorials/robot-arms/so-arm101/lerobot/08-Inference/DGX-Spark)
            - [8단계: D-Robotics RDK S100 추론](/ko/tutorials/robot-arms/so-arm101/lerobot/08-Inference/RDK-S100)
          - **기초 지식**
            - [LeRobot 알아보기](/ko/tutorials/robot-arms/so-arm101/basics/Understanding-LeRobot)
            - [HuggingFace의 LeRobot 데이터셋](/ko/tutorials/robot-arms/so-arm101/basics/HF-Datasets)
            - [모델 학습 자료](/ko/tutorials/robot-arms/so-arm101/basics/Training-Resources)
            - [SO-ARM 100 로봇 암 공식 3D 프린팅 파일](/ko/tutorials/robot-arms/so-arm101/basics/Official-3D-Print-Files)
            - [URDF 파일 및 자료 참고](/ko/tutorials/robot-arms/so-arm101/basics/URDF-Reference)
            - [권장 카메라 브래킷 및 마운트](/ko/tutorials/robot-arms/so-arm101/basics/Camera-Mounts-Recommended)
          - **기타 및 심화**
            - [ROS2 시뮬레이션 제어](/ko/tutorials/robot-arms/so-arm101/ROS2-Simulation-Control)
            - [평행 핑거 그리퍼 설치 튜토리얼](/ko/tutorials/robot-arms/so-arm101/Parallel-Finger-Gripper-Installation)
      - **LeLab 튜토리얼**
        - [1 · 개요](/ko/tutorials/robot-arms/so-arm101/lelab/01-Overview)
        - [2 · 설치 및 실행](/ko/tutorials/robot-arms/so-arm101/lelab/02-Install)
        - [3 · 연결 및 캘리브레이션](/ko/tutorials/robot-arms/so-arm101/lelab/03-Calibration)
        - [4 · 텔레오퍼레이션](/ko/tutorials/robot-arms/so-arm101/lelab/04-Teleoperation)
        - [5 · 데이터셋 녹화](/ko/tutorials/robot-arms/so-arm101/lelab/05-Record-Dataset)
        - [6 · 학습과 추론](/ko/tutorials/robot-arms/so-arm101/lelab/06-Train-and-Inference)
        - [7 · 문제 해결](/ko/tutorials/robot-arms/so-arm101/lelab/07-Troubleshooting)
      - **MuJoCo 시뮬레이션 튜토리얼**,        - [SO-ARM101 × MuJoCo 전체 워크플로 튜토리얼(인덱스)](/ko/tutorials/robot-arms/so-arm101/mujoco/),        - [01 · 환경 준비](/ko/tutorials/robot-arms/so-arm101/mujoco/01-Environment),        - [02 · 시뮬레이션 모델 검증(MJCF 로드와 구동)](/ko/tutorials/robot-arms/so-arm101/mujoco/02-Sim-Model-Verification),        - [03 · 실기 연결과 캘리브레이션](/ko/tutorials/robot-arms/so-arm101/mujoco/03-Hardware-Calibration),        - [04 · 키보드 텔레오퍼레이션](/ko/tutorials/robot-arms/so-arm101/mujoco/04-Keyboard-Teleop),        - [05 · 리더 암 디지털 트윈(실물 암으로 시뮬레이션 암 구동)](/ko/tutorials/robot-arms/so-arm101/mujoco/05-Leader-Digital-Twin),        - [06 · 데이터 녹화와 리플레이](/ko/tutorials/robot-arms/so-arm101/mujoco/06-Record-and-Replay),        - [07 · 자주 발생하는 문제와 경험](/ko/tutorials/robot-arms/so-arm101/mujoco/07-Troubleshooting),        - [08 · 이후 로드맵](/ko/tutorials/robot-arms/so-arm101/mujoco/08-Roadmap),        - [09 · 전체 사용 튜토리얼(암 준비 → 데이터셋 → 영상 확인 → 학습 → 배포)](/ko/tutorials/robot-arms/so-arm101/mujoco/09-Usage-Tutorial)
  - **SO-ARM101 + AmazingHand 튜토리얼**
    - [코스 개요](/ko/tutorials/robot-arms/so-arm-amazinghand/)
      - **Linux**
        - [단계 1: 환경 구축(Linux)](/ko/tutorials/robot-arms/so-arm-amazinghand/01-Environment-Setup-Linux)
        - [2단계: 핸드·양팔 캘리브레이션 (Linux)](/ko/tutorials/robot-arms/so-arm-amazinghand/02-Hand-Arm-Calibration-Linux)
        - [단계 3: 원격 조작(Linux)](/ko/tutorials/robot-arms/so-arm-amazinghand/03-Teleoperation-Linux)
        - [단계 4: 데이터 수집(Linux)](/ko/tutorials/robot-arms/so-arm-amazinghand/04-Data-Collection-Linux)
        - [단계 5: 모델 학습(Linux)](/ko/tutorials/robot-arms/so-arm-amazinghand/05-Model-Training-Linux)
        - [6단계: 모델 배포 (Linux)](/ko/tutorials/robot-arms/so-arm-amazinghand/06-Model-Deployment-Linux)
      - **Windows**
        - [단계 1: 환경 구축(Windows)](/ko/tutorials/robot-arms/so-arm-amazinghand/01-Environment-Setup-Windows)
        - [2단계: 핸드·양팔 캘리브레이션 (Windows)](/ko/tutorials/robot-arms/so-arm-amazinghand/02-Hand-Arm-Calibration-Windows)
        - [단계 3: 원격 조작(Windows)](/ko/tutorials/robot-arms/so-arm-amazinghand/03-Teleoperation-Windows)
        - [단계 4: 데이터 수집(Windows)](/ko/tutorials/robot-arms/so-arm-amazinghand/04-Data-Collection-Windows)
        - [단계 5: 모델 학습(Windows)](/ko/tutorials/robot-arms/so-arm-amazinghand/05-Model-Training-Windows)
        - [6단계: 모델 배포 (Windows)](/ko/tutorials/robot-arms/so-arm-amazinghand/06-Model-Deployment-Windows)
  - **XLeRobot 튜토리얼**
    - [튜토리얼 개요](/ko/tutorials/robot-arms/xlerobot/)
    - [환경 구축(macOS)](/ko/tutorials/robot-arms/xlerobot/01-Environment-Setup-macOS)
    - [환경 구축(Ubuntu)](/ko/tutorials/robot-arms/xlerobot/01-Environment-Setup-Ubuntu)
    - [환경 구축(Windows)](/ko/tutorials/robot-arms/xlerobot/01-Environment-Setup-Windows)
    - [XLeRobot 파일 이동](/ko/tutorials/robot-arms/xlerobot/02-Move-Xlerobot-Files)
    - [완제품 조립](/ko/tutorials/robot-arms/xlerobot/03-Assembly-Assembled-Kit)
    - [부품 키트 조립](/ko/tutorials/robot-arms/xlerobot/04-Assembly-Parts-Kit)
  - **AmazingHand 로봇 손 튜토리얼 개요**
    - [튜토리얼 색인(이전 URL 포함)](/ko/tutorials/robot-arms/amazing-hand/index.md)
    - [AmazingHand 로봇 손 튜토리얼 개요](/ko/tutorials/robot-arms/amazing-hand/README)
    - [AmazingHand 제품 자료](/ko/tutorials/robot-arms/amazing-hand/00-product/product-info)
    - [SCS0009와 PWM 버전 비교 및 선택](/ko/tutorials/robot-arms/amazing-hand/00-product/version-comparison)
    - [다운로드와 리소스](/ko/tutorials/robot-arms/amazing-hand/00-product/downloads)
    - [하드웨어 개요: 구조, CAD와 조립](/ko/tutorials/robot-arms/amazing-hand/01-hardware/overview)
    - [SCS0009 배선, ID와 전원 공급](/ko/tutorials/robot-arms/amazing-hand/01-hardware/scs0009)
    - [PWM 배선, GPIO와 전원 공급](/ko/tutorials/robot-arms/amazing-hand/01-hardware/pwm)
    - [환경 카메라 키트 설치](/ko/tutorials/robot-arms/amazing-hand/01-hardware/camera-kit)
    - [SCS0009 빠른 시작](/ko/tutorials/robot-arms/amazing-hand/02-quick-start/scs0009)
    - [PWM 빠른 시작](/ko/tutorials/robot-arms/amazing-hand/02-quick-start/pwm)
    - [AmazingHand 웹 제어](/ko/tutorials/robot-arms/amazing-hand/03-web-control/README)
    - [SCS0009 웹 제어](/ko/tutorials/robot-arms/amazing-hand/03-web-control/scs0009)
    - [PWM 웹 제어](/ko/tutorials/robot-arms/amazing-hand/03-web-control/pwm)
    - [SCS0009 데스크톱 제어 프로그램(GUI와 CLI)](/ko/tutorials/robot-arms/amazing-hand/04-desktop/scs0009)
    - [PWM 데스크톱 제어 프로그램(Tkinter GUI)](/ko/tutorials/robot-arms/amazing-hand/04-desktop/pwm)
    - [SCS0009 손 추적(공식 dora Demo)](/ko/tutorials/robot-arms/amazing-hand/05-hand-tracking/scs0009)
    - [PWM 손 추적(GUI 내장 MediaPipe)](/ko/tutorials/robot-arms/amazing-hand/05-hand-tracking/pwm)
    - [SCS0009 서보 디버깅과 캘리브레이션](/ko/tutorials/robot-arms/amazing-hand/06-servo-tuning/scs0009)
    - [PWM 서보 프로토콜, 명령과 캘리브레이션](/ko/tutorials/robot-arms/amazing-hand/06-servo-tuning/pwm)
    - [Arduino Nano 사용 튜토리얼](/ko/tutorials/robot-arms/amazing-hand/07-arduino/arduino-nano)
    - [Arduino와 Python 예제](/ko/tutorials/robot-arms/amazing-hand/07-arduino/examples)
    - [자주 묻는 질문(FAQ)](/ko/tutorials/robot-arms/amazing-hand/08-faq/faq)
  - **Lekiwi**
    - [Lekiwi 이동 로봇 사용 튜토리얼](/ko/tutorials/robot-arms/lekiwi/Lekiwi-Tutorial)
    - [Lekiwi 이동 로봇 조립 튜토리얼](/ko/tutorials/robot-arms/lekiwi/Lekiwi-Assembly)
  - **SR-Support 자기 기립 로봇 튜토리얼**
    - [SR-Support 자기 기립 로봇 튜토리얼](/ko/tutorials/robot-arms/sr-support/)
    - [01 기초](/ko/tutorials/robot-arms/sr-support/01-basics)
    - [02 환경 설정 (venv, 플래시 도구와 펌웨어)](/ko/tutorials/robot-arms/sr-support/02-environment)
    - [03 메인 펌웨어 플래싱](/ko/tutorials/robot-arms/sr-support/03-build-flash)
    - [04 조립: 프린팅, 제작, 배선](/ko/tutorials/robot-arms/sr-support/04-assembly)
    - [05 영점 캘리브레이션 (화살표 키; DIY 제작 필수)](/ko/tutorials/robot-arms/sr-support/05-zero-tool)
    - [06 디버그와 캘리브레이션](/ko/tutorials/robot-arms/sr-support/06-debug-and-calibrate)
    - [07 자기 기립 사용법과 모니터링](/ko/tutorials/robot-arms/sr-support/07-self-righting)
    - [08 WiFi 상태 페이지와 프로비저닝](/ko/tutorials/robot-arms/sr-support/08-wifi)
    - [09 MuJoCo 시뮬레이션과 라이브 트윈](/ko/tutorials/robot-arms/sr-support/09-mujoco)
    - [10 문제 해결](/ko/tutorials/robot-arms/sr-support/10-troubleshooting)
    - [11 레퍼런스: 모델, 파라미터 및 라이선스](/ko/tutorials/robot-arms/sr-support/11-reference)

### 센서

- [센서와 인지](/ko/tutorials/sensors/)
- [IMU 캘리브레이션](/ko/tutorials/sensors/imu/calibration)
- [파일 원격 전송](/ko/tutorials/sensors/imu/remote-file-transfer)
- [SSH 파일 전송](/ko/tutorials/sensors/imu/ssh-file-transfer)
  - **IMU 관성 내비게이션**
    - [제품 정보](/ko/tutorials/sensors/imu/product-info)
    - [웹 호스트 콘솔](/ko/tutorials/sensors/imu/web-host-console)
    - [MicroDuck 연동](/ko/tutorials/sensors/imu/microduck-integration)
      - **멀티 보드 예제**
        - [멀티 호스트 통신 케이스 개요](/ko/tutorials/sensors/imu/multi-board-examples/overview)
        - [PC 통신](/ko/tutorials/sensors/imu/multi-board-examples/pc-communication)
          - **I2C 통신**
            - [Arduino](/ko/tutorials/sensors/imu/multi-board-examples/i2c-communication/arduino)
            - [Jetson 시리즈](/ko/tutorials/sensors/imu/multi-board-examples/i2c-communication/jetson)
            - [Raspberry Pi 5](/ko/tutorials/sensors/imu/multi-board-examples/i2c-communication/raspberry-pi)
            - [RDK 시리즈](/ko/tutorials/sensors/imu/multi-board-examples/i2c-communication/rdk)
            - [STM32 F103C8T6](/ko/tutorials/sensors/imu/multi-board-examples/i2c-communication/stm32)
          - **직렬 통신**
            - [Arduino](/ko/tutorials/sensors/imu/multi-board-examples/serial-communication/arduino)
            - [Jetson 시리즈](/ko/tutorials/sensors/imu/multi-board-examples/serial-communication/jetson)
            - [Raspberry Pi 5](/ko/tutorials/sensors/imu/multi-board-examples/serial-communication/raspberry-pi)
            - [RDK 시리즈](/ko/tutorials/sensors/imu/multi-board-examples/serial-communication/rdk)
            - [STM32 F103C8T6](/ko/tutorials/sensors/imu/multi-board-examples/serial-communication/stm32)
      - **ROS 예제**
        - [ROS1 응용](/ko/tutorials/sensors/imu/ros-examples/ros1)
        - [ROS2 응용](/ko/tutorials/sensors/imu/ros-examples/ros2)
  - **GPS 베이더우 측위 모듈**
    - [모듈 자료](/ko/tutorials/sensors/gps/GPS-Module-Info)
    - [51 MCU: GPS 파싱](/ko/tutorials/sensors/gps/51-MCU-GPS-Parsing)
    - [Arduino: 위치 정보 읽기](/ko/tutorials/sensors/gps/Arduino-Location-Reading)
    - [Arduino: 위치 정보 파싱](/ko/tutorials/sensors/gps/Arduino-Location-Parsing)
    - [STM32F103: GPS 파싱 출력](/ko/tutorials/sensors/gps/STM32F103-GPS-Parsing)
    - [Jetson: GPS 파싱](/ko/tutorials/sensors/gps/Jetson-GPS-Parsing)
    - [Jetson: AGNSS 보조 측위](/ko/tutorials/sensors/gps/Jetson-AGNSS)
    - [Jetson: 바이두 지도 API](/ko/tutorials/sensors/gps/Jetson-Baidu-Map-API)
    - [라즈베리파이: GPS 파싱](/ko/tutorials/sensors/gps/RaspberryPi-GPS-Parsing)
    - [라즈베리파이: AGNSS 보조 측위](/ko/tutorials/sensors/gps/RaspberryPi-AGNSS)
    - [라즈베리파이: 바이두 지도 API](/ko/tutorials/sensors/gps/RaspberryPi-Baidu-Map-API)
    - [ROS: 사전 준비](/ko/tutorials/sensors/gps/ROS-Preparation)
    - [ROS: GPS 데이터 읽기](/ko/tutorials/sensors/gps/ROS-Read-GPS-Data)
    - [ROS: GPS 궤적 그리기](/ko/tutorials/sensors/gps/ROS-Draw-GPS-Track)
    - [지도 위치 오차](/ko/tutorials/sensors/gps/Map-Location-Error)

### 액세서리

- [로봇 액세서리](/ko/tutorials/accessories/)
  - [USB 자동 초점 카메라](/ko/tutorials/accessories/usb-auto-focus-camera)
  - [Jetson CSI 카메라](/ko/tutorials/accessories/jetson-csi-camera)
    - **KWS 음성 인식 모듈**
      - [시리즈 튜토리얼 홈](/ko/tutorials/accessories/KWS-speech-recognition-module/)
      - [Jetson Nano 직렬 통신](/ko/tutorials/accessories/KWS-speech-recognition-module/Jetson-Nano-serial-communication)
      - [Jetson 직렬 통신](/ko/tutorials/accessories/KWS-speech-recognition-module/Jetson-serial-communication)
      - [PC 직렬 통신](/ko/tutorials/accessories/KWS-speech-recognition-module/PC-serial-communication)
      - [라즈베리파이 직렬 통신](/ko/tutorials/accessories/KWS-speech-recognition-module/raspberry-pi-serial-communication)
      - [ROS2 RViz2 시각화](/ko/tutorials/accessories/KWS-speech-recognition-module/ROS2-rviz2-visualization)
      - [중문/영문 인식어 펌웨어 다운로드 및 굽기](/ko/tutorials/accessories/KWS-speech-recognition-module/download-and-burn-firmware-for-chinese-and-english-recognition-words)
    - **Feetech 서보**
      - [STS3215 & SCS0009 디버깅 튜토리얼](/ko/tutorials/accessories/feetech/Feetech-STS3215&SCS0009-Tutorial)
      - [SCS 통신 프로토콜](/ko/tutorials/accessories/feetech/Feetech-SCS_Communication_Protocol)
      - [자기 엔코더 STS 서보 - 메모리 테이블 분석](/ko/tutorials/accessories/feetech/Feetech-Magnetic_Encoder_STS_Servo-Memory_Table_Analysis)
      - [전위차계 SCSCL 서보 - 메모리 테이블 분석](/ko/tutorials/accessories/feetech/Feetech-Potentiometer_SCSCL_Servo-Memory_Table_Analysis)
      - [SCS0009 서보 디버깅 도구 사용 튜토리얼](/ko/tutorials/accessories/feetech/SCS0009-Debug-Tool)
    - [Feetech 버스 서보 웹 디버깅 (SCS0009 / STS3215 / HD1910)](/ko/tutorials/accessories/feetech/Feetech-Web-Debugger)
    - **ESP32-NanoCam 영상 전송 모듈**
      - [ESP32-NanoCam 빠른 시작](/ko/tutorials/accessories/esp32-nanocam/ESP32-NanoCam-Quick-Start)
      - [ESP32-NanoCam 하드웨어 사양서](/ko/tutorials/accessories/esp32-nanocam/ESP32-NanoCam-Hardware-Spec)
      - [ESP32-NanoCam 시리얼 프로토콜 매뉴얼](/ko/tutorials/accessories/esp32-nanocam/ESP32-NanoCam-Serial-Protocol)
        - **AI 비전 튜토리얼(11장)**
          - [1장: 환경 구축](/ko/tutorials/accessories/esp32-nanocam/Ch01-Environment-Setup)
          - [2장: 퀵 스타트](/ko/tutorials/accessories/esp32-nanocam/Ch02-Quick-Start)
          - [3장: 카메라 기초](/ko/tutorials/accessories/esp32-nanocam/Ch03-Camera-Basics)
          - [4장: 얼굴 검출](/ko/tutorials/accessories/esp32-nanocam/Ch04-Face-Detection)
          - [5장: 고양이 얼굴 검출](/ko/tutorials/accessories/esp32-nanocam/Ch05-Cat-Face-Detection)
          - [6장: 색상 인식](/ko/tutorials/accessories/esp32-nanocam/Ch06-Color-Recognition)
          - [7장: QR 코드 스캔](/ko/tutorials/accessories/esp32-nanocam/Ch07-QR-Code-Scanning)
          - [8장: 얼굴 인식](/ko/tutorials/accessories/esp32-nanocam/Ch08-Face-Recognition)
          - [9장: 음성 대화](/ko/tutorials/accessories/esp32-nanocam/Ch09-Voice-Chat)
          - [10장: AI 비전 이해](/ko/tutorials/accessories/esp32-nanocam/Ch10-AI-Vision-Understanding)
          - [11장: ESP-Claw 음성 제어](/ko/tutorials/accessories/esp32-nanocam/Ch11-ESP-Claw-Voice-Control)
    - **CSI 카메라 사용 튜토리얼**
      - [Jetson CSI 카메라 설정](/ko/tutorials/accessories/csi-camera/01-Jetson-CSI-Setup)
      - [자동 초점 카메라 사용](/ko/tutorials/accessories/csi-camera/02-Auto-Focus-Camera)
      - [Jupyter Lab 사용](/ko/tutorials/accessories/csi-camera/03-JupyterLab)
      - [JetCam 사용](/ko/tutorials/accessories/csi-camera/04-JetCam)
      - [IMX219(라즈베리파이)](/ko/tutorials/accessories/csi-camera/05-IMX219-RaspberryPi)
    - **AI 음성 인터랙션 모듈**
      - [빠른 시작](/ko/tutorials/accessories/ai-voice-module/Quick-Start)
      - [제품 자료](/ko/tutorials/accessories/ai-voice-module/Product-Info)
      - [모듈 펌웨어 플래싱](/ko/tutorials/accessories/ai-voice-module/Firmware-Flashing)
      - [웨이크 워드 및 명령어 수정](/ko/tutorials/accessories/ai-voice-module/Wake-Word-Commands-Edit)
      - [사용자 정의 프로토콜 항목 제작](/ko/tutorials/accessories/ai-voice-module/Custom-Protocol-Entries)
      - [ROS1 음성 인터랙션](/ko/tutorials/accessories/ai-voice-module/ROS1-Voice-Interaction)
      - [ROS2 음성 인터랙션](/ko/tutorials/accessories/ai-voice-module/ROS2-Voice-Interaction)
      - [시리얼 포트 프로토콜](/ko/tutorials/accessories/ai-voice-module/Serial-Protocol)
      - [IIC 프로토콜](/ko/tutorials/accessories/ai-voice-module/IIC-Protocol)
      - [PC 통신](/ko/tutorials/accessories/ai-voice-module/PC-Communication)
      - [Arduino: 시리얼 통신](/ko/tutorials/accessories/ai-voice-module/Arduino-Serial-Communication)
      - [Arduino: IIC 통신](/ko/tutorials/accessories/ai-voice-module/Arduino-IIC-Communication)
      - [Jetson: 시리얼 통신](/ko/tutorials/accessories/ai-voice-module/Jetson-Serial-Communication)
      - [Jetson: IIC 통신](/ko/tutorials/accessories/ai-voice-module/Jetson-IIC-Communication)
      - [RDK: 시리얼 통신](/ko/tutorials/accessories/ai-voice-module/RDK-Serial-Communication)
      - [RDK: IIC 통신](/ko/tutorials/accessories/ai-voice-module/RDK-IIC-Communication)
      - [라즈베리파이: 시리얼 통신](/ko/tutorials/accessories/ai-voice-module/RaspberryPi-Serial-Communication)
      - [라즈베리파이: IIC 통신](/ko/tutorials/accessories/ai-voice-module/RaspberryPi-IIC-Communication)
  - [2자유도 짐벌](/ko/tutorials/accessories/2dof-camera-gimbal)
- [심박·혈중 산소 센서](/ko/tutorials/accessories/heart-rate-spo2)
- [0.91인치 OLED 화면](/ko/tutorials/accessories/0.91-oled-screen-tutorial)
- [4K HDMI 캡처 카드](/ko/tutorials/accessories/4k-hdmi-capture-tutorial)
- [KVM 스위치](/ko/tutorials/accessories/kvm-switch-tutorial)
- [KVM 스위치 · 사용 튜토리얼 개요](/ko/tutorials/accessories/kvm-switch/00-Overview-and-Quick-Start),- [01 · 두 대 PC 전환(버튼 및 IR 리모컨)](/ko/tutorials/accessories/kvm-switch/01-Switching-Between-Two-Computers),- [02 · HUB 기능(1대3)](/ko/tutorials/accessories/kvm-switch/02-HUB-Function-One-to-Three),- [03 · 블루투스 기능](/ko/tutorials/accessories/kvm-switch/03-Bluetooth),- [04 · TTL 시리얼 포트(무선 시리얼)](/ko/tutorials/accessories/kvm-switch/04-TTL-Serial-Port),- [05 · 10핀 확장 헤더](/ko/tutorials/accessories/kvm-switch/05-10-Pin-Expansion-Header),- [06 · 모니터 없는 호스트(캡처 카드 + OBS)](/ko/tutorials/accessories/kvm-switch/06-Headless-Host-Capture-Card-and-OBS),- [07 · FAQ 및 주의사항](/ko/tutorials/accessories/kvm-switch/07-FAQ-and-Precautions)
- [USB 무드라이버 사운드 카드](/ko/tutorials/accessories/usb-audio-card-tutorial)

## 사용 방법

1. **주제 분류 선택**: 관심사나 필요에 따라 해당 주제 분류를 선택합니다
2. **튜토리얼 목록 확인**: 각 주제 분류에서 사용 가능한 튜토리얼과 문서를 확인합니다
3. **단계별 따라하기**: 튜토리얼의 단계를 따라 점차 제품을 배우고 사용합니다
4. **실습과 탐색**: 실제 사용 중 다양한 기능과 설정을 시도해 경험을 쌓습니다

## 기타 리소스

- 질문이나 제안이 있으면 GitHub 저장소를 방문해 Issue를 제출해 주세요
- 최신 제품 업데이트와 튜토리얼 정보는 블로그와 소셜 미디어를 팔로우하세요
- 제품 튜토리얼 목차는 [제품 페이지](/ko/products/)에서도 확인할 수 있습니다. 상세 기술 튜토리얼은 [중국어](/tutorials/) 버전을 이용하세요.
