Juxi-Technology/wiki-documents/docs/content/pt-br/tutorials/index.md

---
title: Início dos Tutoriais
titleTemplate: Tutoriais e Guias de Produtos
description: "Explore todos os tutoriais, guias e exemplos de produtos para começar rapidamente com os produtos da Juxi Technology"
head:
  - [ meta, { property: "og:title", content: "Início dos Tutoriais | Tutoriais e Guias de Produtos" } ]
  - [ meta, { property: "og:description", content: "Explore todos os tutoriais, guias e exemplos de produtos para começar rapidamente com os produtos da Juxi Technology" } ]
---

# Início dos Tutoriais

Bem-vindo à página de Tutoriais! Aqui você encontra todos os tutoriais de uso dos produtos, guias de configuração e boas práticas para ajudá-lo a começar rapidamente e aproveitar ao máximo os recursos do produto.

## Categorias de Tópicos

### Guia Rápido

- [FAQ](/pt-br/tutorials/faq)
- [Introdução ao ROS](/pt-br/tutorials/ros-intro)
- [Docs Lark](/pt-br/tutorials/lark-wiki)

### Tutorial do braço robótico SO-ARM101 de 7 eixos

- [Tutorial do braço robótico SO-ARM101 de 7 eixos](/tutorials/robot-arms/so-arm101/lerobot-7dof/)
- **1. Ambiente LeRobot**
  - [Computador Ubuntu](/pt-br/tutorials/robot-arms/so-arm101/lerobot-7dof/01-Environment-Setup/Ubuntu)
  - [Computador Windows](/pt-br/tutorials/robot-arms/so-arm101/lerobot-7dof/01-Environment-Setup/Windows)
  - [Computador MAC](/pt-br/tutorials/robot-arms/so-arm101/lerobot-7dof/01-Environment-Setup/MacOS)
- **2. Etapa 2: Substituir arquivos (adaptação para 7DOF)**
  - [Etapa 2: Substituir arquivos (adaptação para 7DOF)](/pt-br/tutorials/robot-arms/so-arm101/lerobot-7dof/02-Replace-Files-7DOF)
- **3. Porta serial**
  - [Ubuntu](/pt-br/tutorials/robot-arms/so-arm101/lerobot-7dof/03-Serial-Port/Ubuntu)
  - [Computador Windows](/pt-br/tutorials/robot-arms/so-arm101/lerobot-7dof/03-Serial-Port/Windows)
  - [Computador MAC](/pt-br/tutorials/robot-arms/so-arm101/lerobot-7dof/03-Serial-Port/MacOS)
- **4. Calibração**
  - [Computador Ubuntu](/pt-br/tutorials/robot-arms/so-arm101/lerobot-7dof/04-Calibration/Ubuntu)
  - [Computador Windows](/pt-br/tutorials/robot-arms/so-arm101/lerobot-7dof/04-Calibration/Windows)
  - [Computador Mac](/pt-br/tutorials/robot-arms/so-arm101/lerobot-7dof/04-Calibration/MacOS)
- **5. Teleoperação**
  - [Computador Ubuntu](/pt-br/tutorials/robot-arms/so-arm101/lerobot-7dof/05-Teleoperation/Ubuntu)
  - [Computador Windows](/pt-br/tutorials/robot-arms/so-arm101/lerobot-7dof/05-Teleoperation/Windows)
  - [Computador Mac](/pt-br/tutorials/robot-arms/so-arm101/lerobot-7dof/05-Teleoperation/MacOS)
- **6. Teleop. e câmera**
  - [Computador Ubuntu](/pt-br/tutorials/robot-arms/so-arm101/lerobot-7dof/06-Camera-Teleoperation/Ubuntu)
  - [Computador Windows](/pt-br/tutorials/robot-arms/so-arm101/lerobot-7dof/06-Camera-Teleoperation/Windows)
  - [Computador Mac](/pt-br/tutorials/robot-arms/so-arm101/lerobot-7dof/06-Camera-Teleoperation/MacOS)
- **7. Coleta de dados**
  - [Revisar e reproduzir o conjunto de dados](/pt-br/tutorials/robot-arms/so-arm101/lerobot-7dof/07-Data-Collection/Browse-and-Replay)
  - [Observações sobre a coleta de dados](/pt-br/tutorials/robot-arms/so-arm101/lerobot-7dof/07-Data-Collection/Collection-Notes)
  - [Registrar conta no Hugging Face (opcional)](/pt-br/tutorials/robot-arms/so-arm101/lerobot-7dof/07-Data-Collection/HF-Account)
  - [Enviar o conjunto de dados para o HuggingFace (opcional)](/pt-br/tutorials/robot-arms/so-arm101/lerobot-7dof/07-Data-Collection/HF-Dataset-Upload)
  - [Coleta de dados por demonstração-Aperto de mão 200](/pt-br/tutorials/robot-arms/so-arm101/lerobot-7dof/07-Data-Collection/Teaching-and-Recording-Handshake-200)
  - [Coleta de dados por demonstração](/pt-br/tutorials/robot-arms/so-arm101/lerobot-7dof/07-Data-Collection/Teaching-and-Recording)
- **8. Treinamento**
  - [Configuração do ambiente de treinamento em GPU na nuvem](/pt-br/tutorials/robot-arms/so-arm101/lerobot-7dof/08-Training/Cloud-GPU)
  - [Comando de treinamento-ACT (recomendado para começar)](/pt-br/tutorials/robot-arms/so-arm101/lerobot-7dof/08-Training/Command-ACT)
  - [Comando de treinamento-Diffusion](/pt-br/tutorials/robot-arms/so-arm101/lerobot-7dof/08-Training/Command-Diffusion)
  - [Comando de treinamento-pi0.5](/pt-br/tutorials/robot-arms/so-arm101/lerobot-7dof/08-Training/Command-pi0.5)
  - [Comando de treinamento-pi0 (melhor desempenho)](/pt-br/tutorials/robot-arms/so-arm101/lerobot-7dof/08-Training/Command-pi0)
  - [Comando de treinamento-pi0fast](/pt-br/tutorials/robot-arms/so-arm101/lerobot-7dof/08-Training/Command-pi0fast)
  - [Comando de treinamento-smolvla (recomendado para avançar)](/pt-br/tutorials/robot-arms/so-arm101/lerobot-7dof/08-Training/Command-smolvla)
  - [Enviar o modelo para o HuggingFace (opcional)](/pt-br/tutorials/robot-arms/so-arm101/lerobot-7dof/08-Training/HF-Model-Upload)
  - [Algoritmos de aprendizado por imitação suportados pelo LeRobot](/pt-br/tutorials/robot-arms/so-arm101/lerobot-7dof/08-Training/Imitation-Learning-Algorithms)
  - [Treinamento local no Ubuntu](/pt-br/tutorials/robot-arms/so-arm101/lerobot-7dof/08-Training/Local-Ubuntu)
  - [Obter o arquivo de pesos do modelo](/pt-br/tutorials/robot-arms/so-arm101/lerobot-7dof/08-Training/Model-Weights)
  - [Sugestões de parâmetros de treinamento](/pt-br/tutorials/robot-arms/so-arm101/lerobot-7dof/08-Training/Training-Parameter-Tips)
  - [Curvas de treinamento em tempo real no wandb](/pt-br/tutorials/robot-arms/so-arm101/lerobot-7dof/08-Training/WandB-Curves)
- **9. Inferência**
  - [Descrição da linha de comando](/pt-br/tutorials/robot-arms/so-arm101/lerobot-7dof/09-Inference/CLI-Reference)
  - [Comando de inferência-ACT](/pt-br/tutorials/robot-arms/so-arm101/lerobot-7dof/09-Inference/Command-ACT)
  - [Comando de inferência-Diffusion](/pt-br/tutorials/robot-arms/so-arm101/lerobot-7dof/09-Inference/Command-Diffusion)
  - [Comando de inferência-pi0.5](/pt-br/tutorials/robot-arms/so-arm101/lerobot-7dof/09-Inference/Command-pi0.5)
  - [Comando de inferência-pi0](/pt-br/tutorials/robot-arms/so-arm101/lerobot-7dof/09-Inference/Command-pi0)
  - [Comando de inferência-smolvla](/pt-br/tutorials/robot-arms/so-arm101/lerobot-7dof/09-Inference/Command-smolvla)
  - [Bugs comuns e soluções](/pt-br/tutorials/robot-arms/so-arm101/lerobot-7dof/09-Inference/Common-Bugs)
  - [Inferência no NVIDIA DGX Spark](/pt-br/tutorials/robot-arms/so-arm101/lerobot-7dof/09-Inference/DGX-Spark)
  - [Inferência no D-Robotics RDK S100](/pt-br/tutorials/robot-arms/so-arm101/lerobot-7dof/09-Inference/RDK-S100)

### Kit de Desenvolvedor Jetson AGX Orin

- [Início rápido](/pt-br/tutorials/jetson-agx-orin/quick-start)
- [Gravação e atualizações](/pt-br/tutorials/jetson-agx-orin/flashing-and-updates)
- [Verifique seu sistema](/pt-br/tutorials/jetson-agx-orin/verify-your-system)
- [Interfaces & Layout de Hardware](/pt-br/tutorials/jetson-agx-orin/interfaces)
- [Visão geral do produto](/pt-br/tutorials/jetson-agx-orin/overview)
- [Inferência de LLM local](/pt-br/tutorials/jetson-agx-orin/local-llm)
- [IA agêntica (NemoClaw)](/pt-br/tutorials/jetson-agx-orin/agentic-ai)
- [Análise de vídeo com DeepStream](/pt-br/tutorials/jetson-agx-orin/deepstream)
- [Robótica (situação atual)](/pt-br/tutorials/jetson-agx-orin/robotics)
- [Eficiência de memória](/pt-br/tutorials/jetson-agx-orin/memory-efficiency)
- [Migrar do JetPack 6.x](/pt-br/tutorials/jetson-agx-orin/jetpack-6-to-7)
- [Downloads](/pt-br/tutorials/jetson-agx-orin/downloads)
- [FAQ](/pt-br/tutorials/jetson-agx-orin/faq)
- [Solução de problemas](/pt-br/tutorials/jetson-agx-orin/troubleshooting)
- [Glossário](/pt-br/tutorials/jetson-agx-orin/glossary)
- [Registro de alterações](/pt-br/tutorials/jetson-agx-orin/changelog)
- [XLeRobot Docker — 01 · Visão geral](/pt-br/tutorials/jetson-agx-orin/xlerobot-docker/deployment/01-Overview)
- [XLeRobot Docker — 02 · Preparação do ambiente](/pt-br/tutorials/jetson-agx-orin/xlerobot-docker/deployment/02-Environment-Setup)
- [XLeRobot Docker — 03 · Implantação](/pt-br/tutorials/jetson-agx-orin/xlerobot-docker/deployment/03-Deployment)
- [XLeRobot Docker — Comandos do LeRobot original](/pt-br/tutorials/jetson-agx-orin/xlerobot-docker/lerobot/01-Operation)
- [XLeRobot Docker — Comandos do XLeRobot](/pt-br/tutorials/jetson-agx-orin/xlerobot-docker/xlerobot/01-Operation)
- [XLeRobot Docker — Solução de problemas e referência rápida](/pt-br/tutorials/jetson-agx-orin/xlerobot-docker/troubleshooting/01-Troubleshooting)

### Kit de Desenvolvedor Jetson Orin Nano Super

- [Início rápido](/pt-br/tutorials/jetson-orin-nano/quick-start)
- [Gravação e atualizações](/pt-br/tutorials/jetson-orin-nano/flashing-and-updates)
- [Verifique seu sistema](/pt-br/tutorials/jetson-orin-nano/verify-your-system)
- [Interfaces & Layout de Hardware](/pt-br/tutorials/jetson-orin-nano/interfaces)
- [Visão geral do produto](/pt-br/tutorials/jetson-orin-nano/overview)
- [Inferência de LLM local](/pt-br/tutorials/jetson-orin-nano/local-llm)
- [IA agêntica (NemoClaw)](/pt-br/tutorials/jetson-orin-nano/agentic-ai)
- [Análise de vídeo com DeepStream](/pt-br/tutorials/jetson-orin-nano/deepstream)
- [Robótica (situação atual)](/pt-br/tutorials/jetson-orin-nano/robotics)
- [Eficiência de memória](/pt-br/tutorials/jetson-orin-nano/memory-efficiency)
- [Migrar do JetPack 6.x](/pt-br/tutorials/jetson-orin-nano/jetpack-6-to-7)
- [Downloads](/pt-br/tutorials/jetson-orin-nano/downloads)
- [FAQ](/pt-br/tutorials/jetson-orin-nano/faq)
- [Solução de problemas](/pt-br/tutorials/jetson-orin-nano/troubleshooting)
- [Glossário](/pt-br/tutorials/jetson-orin-nano/glossary)
- [Registro de alterações](/pt-br/tutorials/jetson-orin-nano/changelog)
- [XLeRobot Docker — 01 · Visão geral](/pt-br/tutorials/jetson-orin-nano/xlerobot-docker/deployment/01-Overview)
- [XLeRobot Docker — 02 · Preparação do ambiente](/pt-br/tutorials/jetson-orin-nano/xlerobot-docker/deployment/02-Environment-Setup)
- [XLeRobot Docker — 03 · Implantação](/pt-br/tutorials/jetson-orin-nano/xlerobot-docker/deployment/03-Deployment)
- [XLeRobot Docker — Comandos do LeRobot original](/pt-br/tutorials/jetson-orin-nano/xlerobot-docker/lerobot/01-Operation)
- [XLeRobot Docker — Comandos do XLeRobot](/pt-br/tutorials/jetson-orin-nano/xlerobot-docker/xlerobot/01-Operation)
- [XLeRobot Docker — Solução de problemas e referência rápida](/pt-br/tutorials/jetson-orin-nano/xlerobot-docker/troubleshooting/01-Troubleshooting)

### Recursos de Aprendizado

- [Recursos de Aprendizado](/pt-br/tutorials/learning-resources/)
- [Compatibilidade PyTorch no Jetson Orin](/pt-br/tutorials/learning-resources/jetson-orin-pytorch-compatibility)

### Braços Robóticos

- [Visão Geral dos Braços Robóticos](/pt-br/tutorials/robot-arms/)
- [Guia de Seleção](/pt-br/tutorials/robot-arms/select-guide)
  - **Série SO-ARM101**
    - [Tutoriais do Braço Robótico SO-ARM101](/pt-br/tutorials/robot-arms/so-arm101/)
    - [Tutorial do Braço Robótico LeRobot](/pt-br/tutorials/robot-arms/so-arm101/SO-ARM101-Tutorial)
    - [Guia de Montagem do Braço Robótico Lerobot](/pt-br/tutorials/robot-arms/so-arm101/SO-ARM101-Assembly)
    - [Compatibilidade PyTorch no Jetson Orin](/pt-br/tutorials/robot-arms/so-arm101/SO-ARM101-Jetson-Orin-PyTorch-Compatibility)
    - [Instalação do Suporte de Braço e Kit de Câmera SO-ARM100&101](/pt-br/tutorials/robot-arms/so-arm101/SO-ARM101-100-Arm-Mount-Camera-Kit-Installation)
    - [Instalação da Câmera Superior](/pt-br/tutorials/robot-arms/so-arm101/SO-ARM101-Overhead-Camera-Mount-Installation)
    - [Teleoperação sem fio do SO-ARM101 (versão ESP32-NanoCam)](/pt-br/tutorials/robot-arms/so-arm101/SO-ARM101-NanoCam-Wireless-Teleop)
    - [Solução de problemas de teleoperação](/pt-br/tutorials/robot-arms/so-arm101/SO-ARM101-NanoCam-Troubleshooting)
    - [Tutorial de dois braços (dois seguidores) do SO-ARM101](/pt-br/tutorials/robot-arms/so-arm101/SO-ARM101-Bi-Arm-Tutorial)
    - [Tutorial de uso da ferramenta de calibração de servos da série SoARM](/pt-br/tutorials/robot-arms/so-arm101/SO-ARM101-Servo-Calibration-Tool)
    - [Série So-ARM – Calibração de servos STS3215 – versão Web](/pt-br/tutorials/robot-arms/so-arm101/SO-ARM101-Web-Calibration)
      - **Curso LeRobot**
        - [Curso completo LeRobot](/pt-br/tutorials/robot-arms/so-arm101/lerobot/)
          - **1. Ambiente LeRobot**
            - [Etapa 1: Instalação do ambiente LeRobot (Ubuntu)](/pt-br/tutorials/robot-arms/so-arm101/lerobot/01-Environment-Setup/Ubuntu)
            - [Etapa 1: Instalação do ambiente LeRobot (Windows)](/pt-br/tutorials/robot-arms/so-arm101/lerobot/01-Environment-Setup/Windows)
            - [Etapa 1: Instalação do ambiente LeRobot (macOS)](/pt-br/tutorials/robot-arms/so-arm101/lerobot/01-Environment-Setup/MacOS)
          - **2. Porta serial**
            - [Etapa 2: Ver a porta do dispositivo serial (Ubuntu)](/pt-br/tutorials/robot-arms/so-arm101/lerobot/02-Serial-Port/Ubuntu)
            - [Etapa 2: Ver a porta do dispositivo serial (Windows)](/pt-br/tutorials/robot-arms/so-arm101/lerobot/02-Serial-Port/Windows)
            - [Etapa 2: Ver a porta do dispositivo serial (macOS)](/pt-br/tutorials/robot-arms/so-arm101/lerobot/02-Serial-Port/MacOS)
          - **3. Calibração**
            - [Etapa 3: Calibrar o braço robótico (Ubuntu)](/pt-br/tutorials/robot-arms/so-arm101/lerobot/03-Calibration/Ubuntu)
            - [Etapa 3: Calibrar o braço robótico (Windows)](/pt-br/tutorials/robot-arms/so-arm101/lerobot/03-Calibration/Windows)
            - [Etapa 3: Calibrar o braço robótico (macOS)](/pt-br/tutorials/robot-arms/so-arm101/lerobot/03-Calibration/MacOS)
          - **4. Teleoperação**
            - [Etapa 4: Teleoperação (Ubuntu)](/pt-br/tutorials/robot-arms/so-arm101/lerobot/04-Teleoperation/Ubuntu)
            - [Etapa 4: Teleoperação (Windows)](/pt-br/tutorials/robot-arms/so-arm101/lerobot/04-Teleoperation/Windows)
            - [Etapa 4: Teleoperação (macOS)](/pt-br/tutorials/robot-arms/so-arm101/lerobot/04-Teleoperation/MacOS)
          - **5. Teleop. e câmera**
            - [Etapa 5: Teleoperação com câmera (Ubuntu)](/pt-br/tutorials/robot-arms/so-arm101/lerobot/05-Camera-Teleoperation/Ubuntu)
            - [Etapa 5: Teleoperação com câmera (Windows)](/pt-br/tutorials/robot-arms/so-arm101/lerobot/05-Camera-Teleoperation/Windows)
            - [Etapa 5: Teleoperação com câmera (macOS)](/pt-br/tutorials/robot-arms/so-arm101/lerobot/05-Camera-Teleoperation/MacOS)
          - **6. Coleta de dados**
            - [Etapa 6: Coleta de dados por demonstração](/pt-br/tutorials/robot-arms/so-arm101/lerobot/06-Data-Collection/Teaching-and-Recording)
            - [Etapa 6: Coleta por demonstração — Handshake 200](/pt-br/tutorials/robot-arms/so-arm101/lerobot/06-Data-Collection/Teaching-and-Recording-Handshake-200)
            - [Etapa 6: Visualizar e reproduzir um dataset](/pt-br/tutorials/robot-arms/so-arm101/lerobot/06-Data-Collection/Browse-and-Replay)
            - [Etapa 6: Observações sobre a coleta de dados](/pt-br/tutorials/robot-arms/so-arm101/lerobot/06-Data-Collection/Collection-Notes)
            - [Etapa 6: Registrar conta no Hugging Face (opcional)](/pt-br/tutorials/robot-arms/so-arm101/lerobot/06-Data-Collection/HF-Account)
            - [Etapa 6: Enviar o dataset ao Hugging Face (opcional)](/pt-br/tutorials/robot-arms/so-arm101/lerobot/06-Data-Collection/HF-Dataset-Upload)
            - [Etapa 7 (simulação): Coletar um dataset — teleoperação Lightwheel LeIsaac](/pt-br/tutorials/robot-arms/so-arm101/lerobot/06-Data-Collection/LeIsaac-Sim)
          - **7. Treinamento**
            - [Etapa 7: Treinamento local no Ubuntu](/pt-br/tutorials/robot-arms/so-arm101/lerobot/07-Training/Local-Ubuntu)
            - [Etapa 7: Configuração do ambiente de GPU na nuvem](/pt-br/tutorials/robot-arms/so-arm101/lerobot/07-Training/Cloud-GPU)
            - [Etapa 7: Curvas de treinamento em tempo real no wandb](/pt-br/tutorials/robot-arms/so-arm101/lerobot/07-Training/WandB-Curves)
            - [Etapa 7: Enviar o modelo ao Hugging Face (opcional)](/pt-br/tutorials/robot-arms/so-arm101/lerobot/07-Training/HF-Model-Upload)
            - [Etapa 7: Obter o arquivo de pesos do modelo](/pt-br/tutorials/robot-arms/so-arm101/lerobot/07-Training/Model-Weights)
            - [Etapa 7: Comando de treinamento — ACT](/pt-br/tutorials/robot-arms/so-arm101/lerobot/07-Training/Command-ACT)
            - [Etapa 7: Comando de treinamento — pi0](/pt-br/tutorials/robot-arms/so-arm101/lerobot/07-Training/Command-pi0)
            - [Etapa 7: Comando de treinamento — pi0.5](/pt-br/tutorials/robot-arms/so-arm101/lerobot/07-Training/Command-pi0.5)
            - [Etapa 7: Comando de treinamento — pi0fast](/pt-br/tutorials/robot-arms/so-arm101/lerobot/07-Training/Command-pi0fast)
            - [Etapa 7: Comando de treinamento — SmolVLA](/pt-br/tutorials/robot-arms/so-arm101/lerobot/07-Training/Command-smolvla)
            - [Etapa 7: Comando de treinamento — Diffusion](/pt-br/tutorials/robot-arms/so-arm101/lerobot/07-Training/Command-Diffusion)
            - [Etapa 7: Comando de treinamento — WALL-OSS](/pt-br/tutorials/robot-arms/so-arm101/lerobot/07-Training/Command-Wall-OSS)
            - [Etapa 7: Linha de comando de treinamento](/pt-br/tutorials/robot-arms/so-arm101/lerobot/07-Training/Train-CLI)
            - [Etapa 7: Recomendações de parâmetros de treinamento](/pt-br/tutorials/robot-arms/so-arm101/lerobot/07-Training/Training-Parameters)
            - [Etapa 7: Algoritmos de aprendizado por imitação compatíveis com o LeRobot](/pt-br/tutorials/robot-arms/so-arm101/lerobot/07-Training/Imitation-Learning-Algorithms)
          - **8. Inferência**
            - [Etapa 8: Descrição da linha de comando](/pt-br/tutorials/robot-arms/so-arm101/lerobot/08-Inference/CLI-Reference)
            - [Etapa 8: Bugs comuns e soluções](/pt-br/tutorials/robot-arms/so-arm101/lerobot/08-Inference/Common-Bugs)
            - [Etapa 8: Comando de inferência — ACT](/pt-br/tutorials/robot-arms/so-arm101/lerobot/08-Inference/Command-ACT)
            - [Etapa 8: Comando de inferência — pi0](/pt-br/tutorials/robot-arms/so-arm101/lerobot/08-Inference/Command-pi0)
            - [Etapa 8: Comando de inferência — pi0.5](/pt-br/tutorials/robot-arms/so-arm101/lerobot/08-Inference/Command-pi0.5)
            - [Etapa 8: Comando de inferência — SmolVLA](/pt-br/tutorials/robot-arms/so-arm101/lerobot/08-Inference/Command-smolvla)
            - [Etapa 8: Comando de inferência — Diffusion](/pt-br/tutorials/robot-arms/so-arm101/lerobot/08-Inference/Command-Diffusion)
            - [Etapa 8: Comando de inferência — WALL-OSS](/pt-br/tutorials/robot-arms/so-arm101/lerobot/08-Inference/Command-Wall-OSS)
            - [Etapa 8: Inferência no NVIDIA DGX Spark](/pt-br/tutorials/robot-arms/so-arm101/lerobot/08-Inference/DGX-Spark)
            - [Etapa 8: Inferência no D-Robotics RDK S100](/pt-br/tutorials/robot-arms/so-arm101/lerobot/08-Inference/RDK-S100)
          - **Fundamentos**
            - [Entendendo o LeRobot](/pt-br/tutorials/robot-arms/so-arm101/basics/Understanding-LeRobot)
            - [Conjuntos de dados LeRobot no Hugging Face](/pt-br/tutorials/robot-arms/so-arm101/basics/HF-Datasets)
            - [Materiais para treinamento de modelos](/pt-br/tutorials/robot-arms/so-arm101/basics/Training-Resources)
            - [Arquivos oficiais de impressão 3D do SO-ARM 100](/pt-br/tutorials/robot-arms/so-arm101/basics/Official-3D-Print-Files)
            - [Arquivos URDF e materiais de referência](/pt-br/tutorials/robot-arms/so-arm101/basics/URDF-Reference)
            - [Brackets e suportes de câmera recomendados](/pt-br/tutorials/robot-arms/so-arm101/basics/Camera-Mounts-Recommended)
          - **Extras e avançado**
            - [Controle de simulação ROS2](/pt-br/tutorials/robot-arms/so-arm101/ROS2-Simulation-Control)
            - [Tutorial de instalação da garra de dedos paralelos](/pt-br/tutorials/robot-arms/so-arm101/Parallel-Finger-Gripper-Installation)
      - **Tutorial do LeLab**
        - [1 · Visão geral](/pt-br/tutorials/robot-arms/so-arm101/lelab/01-Overview)
        - [2 · Instalar e executar](/pt-br/tutorials/robot-arms/so-arm101/lelab/02-Install)
        - [3 · Conectar e calibrar](/pt-br/tutorials/robot-arms/so-arm101/lelab/03-Calibration)
        - [4 · Teleoperação](/pt-br/tutorials/robot-arms/so-arm101/lelab/04-Teleoperation)
        - [5 · Gravar um dataset](/pt-br/tutorials/robot-arms/so-arm101/lelab/05-Record-Dataset)
        - [6 · Treinar e executar inferência](/pt-br/tutorials/robot-arms/so-arm101/lelab/06-Train-and-Inference)
        - [7 · Solução de problemas](/pt-br/tutorials/robot-arms/so-arm101/lelab/07-Troubleshooting)
      - **Tutorial de simulação MuJoCo**,        - [Tutorial completo SO-ARM101 × MuJoCo (índice)](/pt-br/tutorials/robot-arms/so-arm101/mujoco/),        - [01 · Preparação do ambiente](/pt-br/tutorials/robot-arms/so-arm101/mujoco/01-Environment),        - [02 · Verificação do modelo de simulação (carregamento e acionamento MJCF)](/pt-br/tutorials/robot-arms/so-arm101/mujoco/02-Sim-Model-Verification),        - [03 · Conexão com o robô real e calibração](/pt-br/tutorials/robot-arms/so-arm101/mujoco/03-Hardware-Calibration),        - [04 · Teleoperação por teclado](/pt-br/tutorials/robot-arms/so-arm101/mujoco/04-Keyboard-Teleop),        - [05 · Gêmeo digital do braço líder (braço físico acionando o braço simulado)](/pt-br/tutorials/robot-arms/so-arm101/mujoco/05-Leader-Digital-Twin),        - [06 · Gravação e reprodução de dados](/pt-br/tutorials/robot-arms/so-arm101/mujoco/06-Record-and-Replay),        - [07 · Perguntas frequentes e experiências](/pt-br/tutorials/robot-arms/so-arm101/mujoco/07-Troubleshooting),        - [08 · Roteiro futuro](/pt-br/tutorials/robot-arms/so-arm101/mujoco/08-Roadmap),        - [09 · Tutorial de uso completo (iniciar o braço → conjunto de dados → assistir aos vídeos → treinamento → implantação)](/pt-br/tutorials/robot-arms/so-arm101/mujoco/09-Usage-Tutorial)
  - **Curso SO-ARM101 + AmazingHand**
    - [Visão geral do curso](/pt-br/tutorials/robot-arms/so-arm-amazinghand/)
      - **Linux**
        - [Etapa 1: Configuração do ambiente (Linux)](/pt-br/tutorials/robot-arms/so-arm-amazinghand/01-Environment-Setup-Linux)
        - [Etapa 2: calibração de mão e braços (Linux)](/pt-br/tutorials/robot-arms/so-arm-amazinghand/02-Hand-Arm-Calibration-Linux)
        - [Etapa 3: Teleoperação (Linux)](/pt-br/tutorials/robot-arms/so-arm-amazinghand/03-Teleoperation-Linux)
        - [Etapa 4: Coleta de dados (Linux)](/pt-br/tutorials/robot-arms/so-arm-amazinghand/04-Data-Collection-Linux)
        - [Etapa 5: Treinamento do modelo (Linux)](/pt-br/tutorials/robot-arms/so-arm-amazinghand/05-Model-Training-Linux)
        - [Etapa 6: implantação do modelo (Linux)](/pt-br/tutorials/robot-arms/so-arm-amazinghand/06-Model-Deployment-Linux)
      - **Windows**
        - [Etapa 1: Configuração do ambiente (Windows)](/pt-br/tutorials/robot-arms/so-arm-amazinghand/01-Environment-Setup-Windows)
        - [Etapa 2: calibração de mão e braços (Windows)](/pt-br/tutorials/robot-arms/so-arm-amazinghand/02-Hand-Arm-Calibration-Windows)
        - [Etapa 3: Teleoperação (Windows)](/pt-br/tutorials/robot-arms/so-arm-amazinghand/03-Teleoperation-Windows)
        - [Etapa 4: Coleta de dados (Windows)](/pt-br/tutorials/robot-arms/so-arm-amazinghand/04-Data-Collection-Windows)
        - [Etapa 5: Treinamento do modelo (Windows)](/pt-br/tutorials/robot-arms/so-arm-amazinghand/05-Model-Training-Windows)
        - [Etapa 6: implantação do modelo (Windows)](/pt-br/tutorials/robot-arms/so-arm-amazinghand/06-Model-Deployment-Windows)
  - **Tutoriais do XLeRobot**
    - [Visão geral dos tutoriais](/pt-br/tutorials/robot-arms/xlerobot/)
    - [Configuração (macOS)](/pt-br/tutorials/robot-arms/xlerobot/01-Environment-Setup-macOS)
    - [Configuração (Ubuntu)](/pt-br/tutorials/robot-arms/xlerobot/01-Environment-Setup-Ubuntu)
    - [Configuração (Windows)](/pt-br/tutorials/robot-arms/xlerobot/01-Environment-Setup-Windows)
    - [Mover arquivos do XLeRobot](/pt-br/tutorials/robot-arms/xlerobot/02-Move-Xlerobot-Files)
    - [Montagem do kit montado](/pt-br/tutorials/robot-arms/xlerobot/03-Assembly-Assembled-Kit)
    - [Montagem do kit em peças](/pt-br/tutorials/robot-arms/xlerobot/04-Assembly-Parts-Kit)
  - **Visão geral dos tutoriais da mão dexterosa AmazingHand**
    - [Índice do tutorial (incl. URLs antigas)](/pt-br/tutorials/robot-arms/amazing-hand/index.md)
    - [Visão geral dos tutoriais da mão dexterosa AmazingHand](/pt-br/tutorials/robot-arms/amazing-hand/README)
    - [Informações do produto AmazingHand](/pt-br/tutorials/robot-arms/amazing-hand/00-product/product-info)
    - [Comparação e escolha entre as versões SCS0009 e PWM](/pt-br/tutorials/robot-arms/amazing-hand/00-product/version-comparison)
    - [Downloads e recursos](/pt-br/tutorials/robot-arms/amazing-hand/00-product/downloads)
    - [Visão geral do hardware: estrutura, CAD e montagem](/pt-br/tutorials/robot-arms/amazing-hand/01-hardware/overview)
    - [Fiação, ID e alimentação SCS0009](/pt-br/tutorials/robot-arms/amazing-hand/01-hardware/scs0009)
    - [Fiação, GPIO e alimentação PWM](/pt-br/tutorials/robot-arms/amazing-hand/01-hardware/pwm)
    - [Montagem do kit de câmera de ambiente](/pt-br/tutorials/robot-arms/amazing-hand/01-hardware/camera-kit)
    - [Início rápido com SCS0009](/pt-br/tutorials/robot-arms/amazing-hand/02-quick-start/scs0009)
    - [Início rápido com PWM](/pt-br/tutorials/robot-arms/amazing-hand/02-quick-start/pwm)
    - [Controle web AmazingHand](/pt-br/tutorials/robot-arms/amazing-hand/03-web-control/README)
    - [Controle web SCS0009](/pt-br/tutorials/robot-arms/amazing-hand/03-web-control/scs0009)
    - [Controle web PWM](/pt-br/tutorials/robot-arms/amazing-hand/03-web-control/pwm)
    - [Aplicativo de desktop SCS0009 (GUI e CLI)](/pt-br/tutorials/robot-arms/amazing-hand/04-desktop/scs0009)
    - [Aplicativo de desktop PWM (GUI Tkinter)](/pt-br/tutorials/robot-arms/amazing-hand/04-desktop/pwm)
    - [Rastreamento de mãos SCS0009 (Demo oficial dora)](/pt-br/tutorials/robot-arms/amazing-hand/05-hand-tracking/scs0009)
    - [Rastreamento de mãos PWM (MediaPipe embutido na GUI)](/pt-br/tutorials/robot-arms/amazing-hand/05-hand-tracking/pwm)
    - [Depuração e calibração de servos SCS0009](/pt-br/tutorials/robot-arms/amazing-hand/06-servo-tuning/scs0009)
    - [Protocolo, comandos e calibração dos servos PWM](/pt-br/tutorials/robot-arms/amazing-hand/06-servo-tuning/pwm)
    - [Tutorial de uso do Arduino Nano](/pt-br/tutorials/robot-arms/amazing-hand/07-arduino/arduino-nano)
    - [Exemplos em Arduino e Python](/pt-br/tutorials/robot-arms/amazing-hand/07-arduino/examples)
    - [Perguntas frequentes (FAQ)](/pt-br/tutorials/robot-arms/amazing-hand/08-faq/faq)
  - **Lekiwi**
    - [Tutorial de Uso do Robô Móvel Lekiwi](/pt-br/tutorials/robot-arms/lekiwi/Lekiwi-Tutorial)
    - [Tutorial de Montagem do Robô Móvel Lekiwi](/pt-br/tutorials/robot-arms/lekiwi/Lekiwi-Assembly)
  - **Tutorial do Robô de Auto-Endireitamento SR-Support**
    - [Tutorial do Robô de Auto-Endireitamento SR-Support](/pt-br/tutorials/robot-arms/sr-support/)
    - [01 Fundamentos](/pt-br/tutorials/robot-arms/sr-support/01-basics)
    - [02 Configuração do ambiente (venv, ferramentas de gravação e firmware)](/pt-br/tutorials/robot-arms/sr-support/02-environment)
    - [03 Gravar o firmware principal](/pt-br/tutorials/robot-arms/sr-support/03-build-flash)
    - [04 Montagem: imprimir, montar e ligar](/pt-br/tutorials/robot-arms/sr-support/04-assembly)
    - [05 Calibração de zero (teclas de seta; obrigatório para builds DIY)](/pt-br/tutorials/robot-arms/sr-support/05-zero-tool)
    - [06 Depuração e calibração](/pt-br/tutorials/robot-arms/sr-support/06-debug-and-calibrate)
    - [07 Uso e monitoramento do auto-endireitamento](/pt-br/tutorials/robot-arms/sr-support/07-self-righting)
    - [08 Página de status WiFi e provisionamento](/pt-br/tutorials/robot-arms/sr-support/08-wifi)
    - [09 Simulação MuJoCo e o gêmeo ao vivo](/pt-br/tutorials/robot-arms/sr-support/09-mujoco)
    - [10 Solução de problemas](/pt-br/tutorials/robot-arms/sr-support/10-troubleshooting)
    - [11 Referência: modelo, parâmetros e licenciamento](/pt-br/tutorials/robot-arms/sr-support/11-reference)

### Acessórios

- [Visão Geral dos Acessórios](/pt-br/tutorials/accessories/)
  - **Módulo de Reconhecimento de Voz KWS**
    - [Início da Série](/pt-br/tutorials/accessories/KWS-speech-recognition-module/)
    - [Comunicação Serial Jetson Nano](/pt-br/tutorials/accessories/KWS-speech-recognition-module/Jetson-Nano-serial-communication)
    - [Comunicação Serial Jetson](/pt-br/tutorials/accessories/KWS-speech-recognition-module/Jetson-serial-communication)
    - [Comunicação Serial PC](/pt-br/tutorials/accessories/KWS-speech-recognition-module/PC-serial-communication)
    - [Comunicação Serial Raspberry Pi](/pt-br/tutorials/accessories/KWS-speech-recognition-module/raspberry-pi-serial-communication)
    - [Visualização ROS2 RViz2](/pt-br/tutorials/accessories/KWS-speech-recognition-module/ROS2-rviz2-visualization)
    - [Download e Gravação de Firmware de Palavras de Ativação](/pt-br/tutorials/accessories/KWS-speech-recognition-module/download-and-burn-firmware-for-chinese-and-english-recognition-words)
  - **Servos Feetech**
    - [Tutorial de Depuração STS3215 & SCS0009](/pt-br/tutorials/accessories/feetech/Feetech-STS3215&SCS0009-Tutorial)
    - [Protocolo de Comunicação SCS](/pt-br/tutorials/accessories/feetech/Feetech-SCS_Communication_Protocol)
    - [Tabela de Memória do Servo STS com Encoder Magnético](/pt-br/tutorials/accessories/feetech/Feetech-Magnetic_Encoder_STS_Servo-Memory_Table_Analysis)
    - [Tabela de Memória do Servo SCSCL com Potenciômetro](/pt-br/tutorials/accessories/feetech/Feetech-Potentiometer_SCSCL_Servo-Memory_Table_Analysis)
    - [Tutorial de uso da ferramenta de depuração do servo SCS0009](/pt-br/tutorials/accessories/feetech/SCS0009-Debug-Tool)
    - [Depurador Web de servos de barramento Feetech (SCS0009 / STS3215 / HD1910)](/pt-br/tutorials/accessories/feetech/Feetech-Web-Debugger)
  - **Módulo de transmissão de vídeo ESP32-NanoCam**
    - [Início rápido do ESP32-NanoCam](/pt-br/tutorials/accessories/esp32-nanocam/ESP32-NanoCam-Quick-Start)
    - [Especificações de hardware do ESP32-NanoCam](/pt-br/tutorials/accessories/esp32-nanocam/ESP32-NanoCam-Hardware-Spec)
    - [Manual do protocolo serial do ESP32-NanoCam](/pt-br/tutorials/accessories/esp32-nanocam/ESP32-NanoCam-Serial-Protocol)
      - **Tutorial de visão IA (11 capítulos)**
        - [Capítulo 1: Configuração do ambiente](/pt-br/tutorials/accessories/esp32-nanocam/Ch01-Environment-Setup)
        - [Capítulo 2: Início rápido](/pt-br/tutorials/accessories/esp32-nanocam/Ch02-Quick-Start)
        - [Capítulo 3: Fundamentos da câmera](/pt-br/tutorials/accessories/esp32-nanocam/Ch03-Camera-Basics)
        - [Capítulo 4: Detecção de rosto](/pt-br/tutorials/accessories/esp32-nanocam/Ch04-Face-Detection)
        - [Capítulo 5: Detecção de rosto de gato](/pt-br/tutorials/accessories/esp32-nanocam/Ch05-Cat-Face-Detection)
        - [Capítulo 6: Reconhecimento de cores](/pt-br/tutorials/accessories/esp32-nanocam/Ch06-Color-Recognition)
        - [Capítulo 7: Leitura de código QR](/pt-br/tutorials/accessories/esp32-nanocam/Ch07-QR-Code-Scanning)
        - [Capítulo 8: Reconhecimento facial](/pt-br/tutorials/accessories/esp32-nanocam/Ch08-Face-Recognition)
        - [Capítulo 9: Conversa por voz](/pt-br/tutorials/accessories/esp32-nanocam/Ch09-Voice-Chat)
        - [Capítulo 10: Compreensão visual por IA](/pt-br/tutorials/accessories/esp32-nanocam/Ch10-AI-Vision-Understanding)
        - [Capítulo 11: Controle por voz do ESP-Claw](/pt-br/tutorials/accessories/esp32-nanocam/Ch11-ESP-Claw-Voice-Control)
  - **Tutoriais da câmera CSI**
    - [Configuração da câmera CSI no Jetson](/pt-br/tutorials/accessories/csi-camera/01-Jetson-CSI-Setup)
    - [Uso da câmera com autofoco](/pt-br/tutorials/accessories/csi-camera/02-Auto-Focus-Camera)
    - [Uso do Jupyter Lab](/pt-br/tutorials/accessories/csi-camera/03-JupyterLab)
    - [Uso do JetCam](/pt-br/tutorials/accessories/csi-camera/04-JetCam)
    - [IMX219 no Raspberry Pi](/pt-br/tutorials/accessories/csi-camera/05-IMX219-RaspberryPi)
  - **Módulo de interação por voz IA**
    - [Início rápido](/pt-br/tutorials/accessories/ai-voice-module/Quick-Start)
    - [Informações do produto](/pt-br/tutorials/accessories/ai-voice-module/Product-Info)
    - [Gravação do firmware do módulo](/pt-br/tutorials/accessories/ai-voice-module/Firmware-Flashing)
    - [Modificar a palavra de ativação e as palavras de comando](/pt-br/tutorials/accessories/ai-voice-module/Wake-Word-Commands-Edit)
    - [Criação de entradas de protocolo personalizadas](/pt-br/tutorials/accessories/ai-voice-module/Custom-Protocol-Entries)
    - [Interação de voz ROS1](/pt-br/tutorials/accessories/ai-voice-module/ROS1-Voice-Interaction)
    - [Interação de voz ROS2](/pt-br/tutorials/accessories/ai-voice-module/ROS2-Voice-Interaction)
    - [Protocolo da porta serial](/pt-br/tutorials/accessories/ai-voice-module/Serial-Protocol)
    - [Protocolo IIC](/pt-br/tutorials/accessories/ai-voice-module/IIC-Protocol)
    - [Comunicação com PC](/pt-br/tutorials/accessories/ai-voice-module/PC-Communication)
    - [Arduino: Comunicação por porta serial](/pt-br/tutorials/accessories/ai-voice-module/Arduino-Serial-Communication)
    - [Arduino: Comunicação IIC](/pt-br/tutorials/accessories/ai-voice-module/Arduino-IIC-Communication)
    - [Jetson: Comunicação por porta serial](/pt-br/tutorials/accessories/ai-voice-module/Jetson-Serial-Communication)
    - [Jetson: Comunicação IIC](/pt-br/tutorials/accessories/ai-voice-module/Jetson-IIC-Communication)
    - [RDK: Comunicação por porta serial](/pt-br/tutorials/accessories/ai-voice-module/RDK-Serial-Communication)
    - [RDK: Comunicação IIC](/pt-br/tutorials/accessories/ai-voice-module/RDK-IIC-Communication)
    - [Raspberry Pi: Comunicação por porta serial](/pt-br/tutorials/accessories/ai-voice-module/RaspberryPi-Serial-Communication)
    - [Raspberry Pi: Comunicação IIC](/pt-br/tutorials/accessories/ai-voice-module/RaspberryPi-IIC-Communication)
  - **Outros Acessórios**
    - [Câmera USB com Foco Automático](/pt-br/tutorials/accessories/usb-auto-focus-camera)
    - [Câmera CSI Jetson](/pt-br/tutorials/accessories/jetson-csi-camera)
    - [Gimbal de Câmera 2-DOF](/pt-br/tutorials/accessories/2dof-camera-gimbal)
    - [Sensor de Frequência Cardíaca e SpO2](/pt-br/tutorials/accessories/heart-rate-spo2)
    - [Tela OLED de 0,91"](/pt-br/tutorials/accessories/0.91-oled-screen-tutorial)
    - [Captura HDMI 4K](/pt-br/tutorials/accessories/4k-hdmi-capture-tutorial)
    - [Chaveador KVM](/pt-br/tutorials/accessories/kvm-switch-tutorial)
    - [Switch KVM · Visão geral do tutorial](/pt-br/tutorials/accessories/kvm-switch/00-Overview-and-Quick-Start),    - [01 · Alternância entre dois computadores (botão e controle IR)](/pt-br/tutorials/accessories/kvm-switch/01-Switching-Between-Two-Computers),    - [02 · Função HUB (um para três)](/pt-br/tutorials/accessories/kvm-switch/02-HUB-Function-One-to-Three),    - [03 · Bluetooth](/pt-br/tutorials/accessories/kvm-switch/03-Bluetooth),    - [04 · Porta serial TTL (serial sem fio)](/pt-br/tutorials/accessories/kvm-switch/04-TTL-Serial-Port),    - [05 · Conector de expansão de 10 pinos](/pt-br/tutorials/accessories/kvm-switch/05-10-Pin-Expansion-Header),    - [06 · Host sem monitor (placa de captura + OBS)](/pt-br/tutorials/accessories/kvm-switch/06-Headless-Host-Capture-Card-and-OBS),    - [07 · Perguntas frequentes e avisos](/pt-br/tutorials/accessories/kvm-switch/07-FAQ-and-Precautions)
    - [Placa de Som USB sem Driver](/pt-br/tutorials/accessories/usb-audio-card-tutorial)

### Sensores

- [Visão Geral dos Sensores](/pt-br/tutorials/sensors/)
  - **Módulo de Navegação Inercial IMU**
    - [Informações do Produto](/pt-br/tutorials/sensors/imu/product-info)
    - [Console web do host](/pt-br/tutorials/sensors/imu/web-host-console)
    - [Integração MicroDuck](/pt-br/tutorials/sensors/imu/microduck-integration)
    - [Calibração IMU](/pt-br/tutorials/sensors/imu/calibration)
    - [Transferência remota de arquivos](/pt-br/tutorials/sensors/imu/remote-file-transfer)
    - [Transferência de arquivos via SSH](/pt-br/tutorials/sensors/imu/ssh-file-transfer)
      - **Exemplos Multi-Placa**
        - [Visão Geral dos Casos Multi-Host](/pt-br/tutorials/sensors/imu/multi-board-examples/overview)
        - [Comunicação PC](/pt-br/tutorials/sensors/imu/multi-board-examples/pc-communication)
          - **Comunicação I2C**
            - [Arduino](/pt-br/tutorials/sensors/imu/multi-board-examples/i2c-communication/arduino)
            - [Série Jetson](/pt-br/tutorials/sensors/imu/multi-board-examples/i2c-communication/jetson)
            - [Raspberry Pi 5](/pt-br/tutorials/sensors/imu/multi-board-examples/i2c-communication/raspberry-pi)
            - [Série RDK](/pt-br/tutorials/sensors/imu/multi-board-examples/i2c-communication/rdk)
            - [STM32 F103C8T6](/pt-br/tutorials/sensors/imu/multi-board-examples/i2c-communication/stm32)
          - **Comunicação Serial**
            - [Arduino](/pt-br/tutorials/sensors/imu/multi-board-examples/serial-communication/arduino)
            - [Série Jetson](/pt-br/tutorials/sensors/imu/multi-board-examples/serial-communication/jetson)
            - [Raspberry Pi 5](/pt-br/tutorials/sensors/imu/multi-board-examples/serial-communication/raspberry-pi)
            - [Série RDK](/pt-br/tutorials/sensors/imu/multi-board-examples/serial-communication/rdk)
            - [STM32 F103C8T6](/pt-br/tutorials/sensors/imu/multi-board-examples/serial-communication/stm32)
      - **Exemplos ROS**
        - [Aplicação ROS1](/pt-br/tutorials/sensors/imu/ros-examples/ros1)
        - [Aplicação ROS2](/pt-br/tutorials/sensors/imu/ros-examples/ros2)
  - **Módulo GPS e BeiDou**
    - [Informações do módulo](/pt-br/tutorials/sensors/gps/GPS-Module-Info)
    - [51 MCU: análise GPS](/pt-br/tutorials/sensors/gps/51-MCU-GPS-Parsing)
    - [Arduino: leitura de posição](/pt-br/tutorials/sensors/gps/Arduino-Location-Reading)
    - [Arduino: análise de posição](/pt-br/tutorials/sensors/gps/Arduino-Location-Parsing)
    - [STM32F103: saída de análise GPS](/pt-br/tutorials/sensors/gps/STM32F103-GPS-Parsing)
    - [Jetson: análise GPS](/pt-br/tutorials/sensors/gps/Jetson-GPS-Parsing)
    - [Jetson: posicionamento AGNSS](/pt-br/tutorials/sensors/gps/Jetson-AGNSS)
    - [Jetson: API do Baidu Maps](/pt-br/tutorials/sensors/gps/Jetson-Baidu-Map-API)
    - [Raspberry Pi: análise GPS](/pt-br/tutorials/sensors/gps/RaspberryPi-GPS-Parsing)
    - [Raspberry Pi: posicionamento AGNSS](/pt-br/tutorials/sensors/gps/RaspberryPi-AGNSS)
    - [Raspberry Pi: API do Baidu Maps](/pt-br/tutorials/sensors/gps/RaspberryPi-Baidu-Map-API)
    - [ROS: preparação](/pt-br/tutorials/sensors/gps/ROS-Preparation)
    - [ROS: leitura de dados GPS](/pt-br/tutorials/sensors/gps/ROS-Read-GPS-Data)
    - [ROS: desenhar trajeto GPS](/pt-br/tutorials/sensors/gps/ROS-Draw-GPS-Track)
    - [Erro de localização no mapa](/pt-br/tutorials/sensors/gps/Map-Location-Error)

## Como Usar

1. **Selecione a Categoria de Tópico**: Escolha a categoria correspondente com base nos seus interesses ou necessidades
2. **Visualize a Lista de Tutoriais**: Em cada categoria, veja os tutoriais e documentos disponíveis
3. **Siga as Etapas**: Siga as etapas dos tutoriais para aprender e usar o produto gradualmente
4. **Pratique e Explore**: Durante a operação real, experimente diferentes funções e configurações para acumular experiência
- **Recursos de Aprendizado**
  - [Recursos de Aprendizado](./learning-resources/index)
  - [Compatibilidade PyTorch no Jetson Orin](./learning-resources/jetson-orin-pytorch-compatibility)

## Outros Recursos

- Para dúvidas ou sugestões, visite nosso repositório no GitHub para abrir uma Issue
- Acompanhe nosso blog e redes sociais para as novidades sobre produtos e informações de tutoriais
