Juxi-Technology/wiki-documents/docs/content/pt-pt/tutorials/index.md

---
title: Início dos Tutoriais
titleTemplate: Tutoriais e Guias de Produtos
description: "Ponto de partida dos tutoriais da Juxi Technology: braços robóticos, acessórios, sensores e perceção, com guias e exemplos para começar a construir."
head:
  - [ meta, { property: "og:title", content: "Início dos Tutoriais | Tutoriais e Guias de Produtos" } ]
  - [ meta, { property: "og:description", content: "Explore todos os tutoriais, guias e exemplos de produtos para começar rapidamente com os produtos da Juxi Technology" } ]
---

# Início dos Tutoriais

Bem-vindo à página de Tutoriais! Aqui você encontra todos os tutoriais de uso dos produtos, guias de configuração e boas práticas para ajudá-lo a começar rapidamente e aproveitar ao máximo os recursos do produto.

## Categorias de Tópicos

### Guia Rápido

- [FAQ](/pt-pt/tutorials/faq)
- [Introdução ao ROS](/pt-pt/tutorials/ros-intro)
- [Docs Lark](/pt-pt/tutorials/lark-wiki)

### Tutorial do braço robótico SO-ARM101 de 7 eixos

- [Tutorial do braço robótico SO-ARM101 de 7 eixos](/tutorials/robot-arms/so-arm101/lerobot-7dof/)
- **1. Ambiente LeRobot**
  - [Computador Ubuntu](/pt-pt/tutorials/robot-arms/so-arm101/lerobot-7dof/01-Environment-Setup/Ubuntu)
  - [Computador Windows](/pt-pt/tutorials/robot-arms/so-arm101/lerobot-7dof/01-Environment-Setup/Windows)
  - [Computador Mac](/pt-pt/tutorials/robot-arms/so-arm101/lerobot-7dof/01-Environment-Setup/MacOS)
- **2. Etapa 2: Substituir ficheiros (adaptação a 7DOF)**
  - [Etapa 2: Substituir ficheiros (adaptação a 7DOF)](/pt-pt/tutorials/robot-arms/so-arm101/lerobot-7dof/02-Replace-Files-7DOF)
- **3. Portas série**
  - [Ubuntu](/pt-pt/tutorials/robot-arms/so-arm101/lerobot-7dof/03-Serial-Port/Ubuntu)
  - [Computador Windows](/pt-pt/tutorials/robot-arms/so-arm101/lerobot-7dof/03-Serial-Port/Windows)
  - [Computador Mac](/pt-pt/tutorials/robot-arms/so-arm101/lerobot-7dof/03-Serial-Port/MacOS)
- **4. Calibração**
  - [Computador Ubuntu](/pt-pt/tutorials/robot-arms/so-arm101/lerobot-7dof/04-Calibration/Ubuntu)
  - [Computador Windows](/pt-pt/tutorials/robot-arms/so-arm101/lerobot-7dof/04-Calibration/Windows)
  - [Computador Mac](/pt-pt/tutorials/robot-arms/so-arm101/lerobot-7dof/04-Calibration/MacOS)
- **5. Teleoperação**
  - [Computador Ubuntu](/pt-pt/tutorials/robot-arms/so-arm101/lerobot-7dof/05-Teleoperation/Ubuntu)
  - [Computador Windows](/pt-pt/tutorials/robot-arms/so-arm101/lerobot-7dof/05-Teleoperation/Windows)
  - [Computador Mac](/pt-pt/tutorials/robot-arms/so-arm101/lerobot-7dof/05-Teleoperation/MacOS)
- **6. Teleop. c/ câmara**
  - [Computador Ubuntu](/pt-pt/tutorials/robot-arms/so-arm101/lerobot-7dof/06-Camera-Teleoperation/Ubuntu)
  - [Computador Windows](/pt-pt/tutorials/robot-arms/so-arm101/lerobot-7dof/06-Camera-Teleoperation/Windows)
  - [Computador Mac](/pt-pt/tutorials/robot-arms/so-arm101/lerobot-7dof/06-Camera-Teleoperation/MacOS)
- **7. Recolha de dados**
  - [Rever e reproduzir o conjunto de dados](/pt-pt/tutorials/robot-arms/so-arm101/lerobot-7dof/07-Data-Collection/Browse-and-Replay)
  - [Notas sobre a recolha de conjuntos de dados](/pt-pt/tutorials/robot-arms/so-arm101/lerobot-7dof/07-Data-Collection/Collection-Notes)
  - [Registar uma conta Hugging Face (opcional)](/pt-pt/tutorials/robot-arms/so-arm101/lerobot-7dof/07-Data-Collection/HF-Account)
  - [Carregar dados para o HuggingFace (opcional)](/pt-pt/tutorials/robot-arms/so-arm101/lerobot-7dof/07-Data-Collection/HF-Dataset-Upload)
  - [Recolha de conjuntos de dados por ensino-Aperto de mão 200](/pt-pt/tutorials/robot-arms/so-arm101/lerobot-7dof/07-Data-Collection/Teaching-and-Recording-Handshake-200)
  - [Recolha de conjuntos de dados por ensino](/pt-pt/tutorials/robot-arms/so-arm101/lerobot-7dof/07-Data-Collection/Teaching-and-Recording)
- **8. Treino de modelos**
  - [Ambiente de treino em GPU na nuvem](/pt-pt/tutorials/robot-arms/so-arm101/lerobot-7dof/08-Training/Cloud-GPU)
  - [Comando de treino-ACT (recomendado para começar)](/pt-pt/tutorials/robot-arms/so-arm101/lerobot-7dof/08-Training/Command-ACT)
  - [Comando de treino-Diffusion](/pt-pt/tutorials/robot-arms/so-arm101/lerobot-7dof/08-Training/Command-Diffusion)
  - [Comando de treino-pi0.5](/pt-pt/tutorials/robot-arms/so-arm101/lerobot-7dof/08-Training/Command-pi0.5)
  - [Comando de treino-pi0 (melhor desempenho)](/pt-pt/tutorials/robot-arms/so-arm101/lerobot-7dof/08-Training/Command-pi0)
  - [Comando de treino-pi0fast](/pt-pt/tutorials/robot-arms/so-arm101/lerobot-7dof/08-Training/Command-pi0fast)
  - [Comando de treino-smolvla (recomendado para avançados)](/pt-pt/tutorials/robot-arms/so-arm101/lerobot-7dof/08-Training/Command-smolvla)
  - [Enviar o modelo para o HuggingFace (opcional)](/pt-pt/tutorials/robot-arms/so-arm101/lerobot-7dof/08-Training/HF-Model-Upload)
  - [Algoritmos de aprendizagem por imitação suportados pelo LeRobot](/pt-pt/tutorials/robot-arms/so-arm101/lerobot-7dof/08-Training/Imitation-Learning-Algorithms)
  - [Treino local em Ubuntu](/pt-pt/tutorials/robot-arms/so-arm101/lerobot-7dof/08-Training/Local-Ubuntu)
  - [Obter o ficheiro de pesos do modelo](/pt-pt/tutorials/robot-arms/so-arm101/lerobot-7dof/08-Training/Model-Weights)
  - [Sugestões de parâmetros de treino](/pt-pt/tutorials/robot-arms/so-arm101/lerobot-7dof/08-Training/Training-Parameter-Tips)
  - [Visualizar as curvas de treino em tempo real com o wandb](/pt-pt/tutorials/robot-arms/so-arm101/lerobot-7dof/08-Training/WandB-Curves)
- **9. Implantação**
  - [Descrição da linha de comando](/pt-pt/tutorials/robot-arms/so-arm101/lerobot-7dof/09-Inference/CLI-Reference)
  - [Comando de inferência-ACT](/pt-pt/tutorials/robot-arms/so-arm101/lerobot-7dof/09-Inference/Command-ACT)
  - [Comando de inferência-Diffusion](/pt-pt/tutorials/robot-arms/so-arm101/lerobot-7dof/09-Inference/Command-Diffusion)
  - [Comando de inferência-pi0.5](/pt-pt/tutorials/robot-arms/so-arm101/lerobot-7dof/09-Inference/Command-pi0.5)
  - [Comando de inferência-pi0](/pt-pt/tutorials/robot-arms/so-arm101/lerobot-7dof/09-Inference/Command-pi0)
  - [Comando de inferência-smolvla](/pt-pt/tutorials/robot-arms/so-arm101/lerobot-7dof/09-Inference/Command-smolvla)
  - [Bugs comuns e soluções](/pt-pt/tutorials/robot-arms/so-arm101/lerobot-7dof/09-Inference/Common-Bugs)
  - [Inferência no NVIDIA DGX Spark](/pt-pt/tutorials/robot-arms/so-arm101/lerobot-7dof/09-Inference/DGX-Spark)
  - [Inferência no D-Robotics RDK S100](/pt-pt/tutorials/robot-arms/so-arm101/lerobot-7dof/09-Inference/RDK-S100)

### Kit de Desenvolvedor Jetson AGX Orin

- [Início rápido](/pt-pt/tutorials/jetson-agx-orin/quick-start)
- [Gravação e atualizações](/pt-pt/tutorials/jetson-agx-orin/flashing-and-updates)
- [Verificar o sistema](/pt-pt/tutorials/jetson-agx-orin/verify-your-system)
- [Interfaces e layout do hardware](/pt-pt/tutorials/jetson-agx-orin/interfaces)
- [Visão geral do produto](/pt-pt/tutorials/jetson-agx-orin/overview)
- [Inferência local de LLM](/pt-pt/tutorials/jetson-agx-orin/local-llm)
- [IA agêntica (NemoClaw)](/pt-pt/tutorials/jetson-agx-orin/agentic-ai)
- [Análise de vídeo com DeepStream](/pt-pt/tutorials/jetson-agx-orin/deepstream)
- [Robótica (ponto de situação)](/pt-pt/tutorials/jetson-agx-orin/robotics)
- [Eficiência de memória](/pt-pt/tutorials/jetson-agx-orin/memory-efficiency)
- [Migrar do JetPack 6.x](/pt-pt/tutorials/jetson-agx-orin/jetpack-6-to-7)
- [Downloads](/pt-pt/tutorials/jetson-agx-orin/downloads)
- [FAQ](/pt-pt/tutorials/jetson-agx-orin/faq)
- [Resolução de problemas](/pt-pt/tutorials/jetson-agx-orin/troubleshooting)
- [Glossário](/pt-pt/tutorials/jetson-agx-orin/glossary)
- [Registo de alterações](/pt-pt/tutorials/jetson-agx-orin/changelog)
- [XLeRobot Docker — 01 · Visão geral](/pt-pt/tutorials/jetson-agx-orin/xlerobot-docker/deployment/01-Overview)
- [XLeRobot Docker — 02 · Preparação do ambiente](/pt-pt/tutorials/jetson-agx-orin/xlerobot-docker/deployment/02-Environment-Setup)
- [XLeRobot Docker — 03 · Implementação](/pt-pt/tutorials/jetson-agx-orin/xlerobot-docker/deployment/03-Deployment)
- [XLeRobot Docker — Comandos do LeRobot original](/pt-pt/tutorials/jetson-agx-orin/xlerobot-docker/lerobot/01-Operation)
- [XLeRobot Docker — Comandos do XLeRobot](/pt-pt/tutorials/jetson-agx-orin/xlerobot-docker/xlerobot/01-Operation)
- [XLeRobot Docker — Resolução de problemas e referência rápida](/pt-pt/tutorials/jetson-agx-orin/xlerobot-docker/troubleshooting/01-Troubleshooting)

### Kit de Desenvolvedor Jetson Orin Nano Super

- [Início rápido](/pt-pt/tutorials/jetson-orin-nano/quick-start)
- [Gravação e atualizações](/pt-pt/tutorials/jetson-orin-nano/flashing-and-updates)
- [Verificar o sistema](/pt-pt/tutorials/jetson-orin-nano/verify-your-system)
- [Interfaces e layout do hardware](/pt-pt/tutorials/jetson-orin-nano/interfaces)
- [Visão geral do produto](/pt-pt/tutorials/jetson-orin-nano/overview)
- [Inferência local de LLM](/pt-pt/tutorials/jetson-orin-nano/local-llm)
- [IA agêntica (NemoClaw)](/pt-pt/tutorials/jetson-orin-nano/agentic-ai)
- [Análise de vídeo com DeepStream](/pt-pt/tutorials/jetson-orin-nano/deepstream)
- [Robótica (ponto de situação)](/pt-pt/tutorials/jetson-orin-nano/robotics)
- [Eficiência de memória](/pt-pt/tutorials/jetson-orin-nano/memory-efficiency)
- [Migrar do JetPack 6.x](/pt-pt/tutorials/jetson-orin-nano/jetpack-6-to-7)
- [Downloads](/pt-pt/tutorials/jetson-orin-nano/downloads)
- [FAQ](/pt-pt/tutorials/jetson-orin-nano/faq)
- [Resolução de problemas](/pt-pt/tutorials/jetson-orin-nano/troubleshooting)
- [Glossário](/pt-pt/tutorials/jetson-orin-nano/glossary)
- [Registo de alterações](/pt-pt/tutorials/jetson-orin-nano/changelog)
- [XLeRobot Docker — 01 · Visão geral](/pt-pt/tutorials/jetson-orin-nano/xlerobot-docker/deployment/01-Overview)
- [XLeRobot Docker — 02 · Preparação do ambiente](/pt-pt/tutorials/jetson-orin-nano/xlerobot-docker/deployment/02-Environment-Setup)
- [XLeRobot Docker — 03 · Implementação](/pt-pt/tutorials/jetson-orin-nano/xlerobot-docker/deployment/03-Deployment)
- [XLeRobot Docker — Comandos do LeRobot original](/pt-pt/tutorials/jetson-orin-nano/xlerobot-docker/lerobot/01-Operation)
- [XLeRobot Docker — Comandos do XLeRobot](/pt-pt/tutorials/jetson-orin-nano/xlerobot-docker/xlerobot/01-Operation)
- [XLeRobot Docker — Resolução de problemas e referência rápida](/pt-pt/tutorials/jetson-orin-nano/xlerobot-docker/troubleshooting/01-Troubleshooting)

### Recursos de Aprendizado

- [Recursos de Aprendizado](/pt-pt/tutorials/learning-resources/)
- [Compatibilidade PyTorch no Jetson Orin](/pt-pt/tutorials/learning-resources/jetson-orin-pytorch-compatibility)

### Braços Robóticos

- [Visão Geral dos Braços Robóticos](/pt-pt/tutorials/robot-arms/)
- [Guia de Seleção](/pt-pt/tutorials/robot-arms/select-guide)
  - **Série SO-ARM101**
    - [Tutoriais do Braço Robótico SO-ARM101](/pt-pt/tutorials/robot-arms/so-arm101/)
    - [Tutorial do Braço Robótico LeRobot](/pt-pt/tutorials/robot-arms/so-arm101/SO-ARM101-Tutorial)
    - [Guia de Montagem do Braço Robótico Lerobot](/pt-pt/tutorials/robot-arms/so-arm101/SO-ARM101-Assembly)
    - [Compatibilidade PyTorch no Jetson Orin](/pt-pt/tutorials/robot-arms/so-arm101/SO-ARM101-Jetson-Orin-PyTorch-Compatibility)
    - [Instalação do Suporte de Braço e Kit de Câmara SO-ARM100&101](/pt-pt/tutorials/robot-arms/so-arm101/SO-ARM101-100-Arm-Mount-Camera-Kit-Installation)
    - [Instalação da Câmara Superior](/pt-pt/tutorials/robot-arms/so-arm101/SO-ARM101-Overhead-Camera-Mount-Installation)
    - [Teleoperação sem fios do SO-ARM101 (versão ESP32-NanoCam)](/pt-pt/tutorials/robot-arms/so-arm101/SO-ARM101-NanoCam-Wireless-Teleop)
    - [Resolução de problemas de teleoperação](/pt-pt/tutorials/robot-arms/so-arm101/SO-ARM101-NanoCam-Troubleshooting)
    - [Tutorial do braço duplo SO-ARM101 (dois braços seguidores)](/pt-pt/tutorials/robot-arms/so-arm101/SO-ARM101-Bi-Arm-Tutorial)
    - [Tutorial de utilização da ferramenta de calibração de servos da série SoARM](/pt-pt/tutorials/robot-arms/so-arm101/SO-ARM101-Servo-Calibration-Tool)
    - [Série So-ARM – Calibração de servos STS3215 – versão Web](/pt-pt/tutorials/robot-arms/so-arm101/SO-ARM101-Web-Calibration)
      - **Curso de LeRobot**
        - [Visão geral do curso de LeRobot](/pt-pt/tutorials/robot-arms/so-arm101/lerobot/)
          - **1. Ambiente LeRobot**
            - [Etapa 1: Instalar o ambiente LeRobot (Ubuntu)](/pt-pt/tutorials/robot-arms/so-arm101/lerobot/01-Environment-Setup/Ubuntu)
            - [Etapa 1: Instalar o ambiente LeRobot (Windows)](/pt-pt/tutorials/robot-arms/so-arm101/lerobot/01-Environment-Setup/Windows)
            - [Etapa 1: Instalar o ambiente LeRobot (macOS)](/pt-pt/tutorials/robot-arms/so-arm101/lerobot/01-Environment-Setup/MacOS)
          - **2. Portas série**
            - [Etapa 2: Ver a porta do dispositivo série (Ubuntu)](/pt-pt/tutorials/robot-arms/so-arm101/lerobot/02-Serial-Port/Ubuntu)
            - [Etapa 2: Ver a porta do dispositivo série (Windows)](/pt-pt/tutorials/robot-arms/so-arm101/lerobot/02-Serial-Port/Windows)
            - [Etapa 2: Ver a porta do dispositivo série (macOS)](/pt-pt/tutorials/robot-arms/so-arm101/lerobot/02-Serial-Port/MacOS)
          - **3. Calibração**
            - [Etapa 3: Calibrar o braço robótico (Ubuntu)](/pt-pt/tutorials/robot-arms/so-arm101/lerobot/03-Calibration/Ubuntu)
            - [Etapa 3: Calibrar o braço robótico (Windows)](/pt-pt/tutorials/robot-arms/so-arm101/lerobot/03-Calibration/Windows)
            - [Etapa 3: Calibrar o braço robótico (macOS)](/pt-pt/tutorials/robot-arms/so-arm101/lerobot/03-Calibration/MacOS)
          - **4. Teleoperação**
            - [Etapa 4: Teleoperação (Ubuntu)](/pt-pt/tutorials/robot-arms/so-arm101/lerobot/04-Teleoperation/Ubuntu)
            - [Etapa 4: Teleoperação (Windows)](/pt-pt/tutorials/robot-arms/so-arm101/lerobot/04-Teleoperation/Windows)
            - [Etapa 4: Teleoperação (macOS)](/pt-pt/tutorials/robot-arms/so-arm101/lerobot/04-Teleoperation/MacOS)
          - **5. Teleop. c/ câmara**
            - [Etapa 5: Teleoperação com câmara (Ubuntu)](/pt-pt/tutorials/robot-arms/so-arm101/lerobot/05-Camera-Teleoperation/Ubuntu)
            - [Etapa 5: Teleoperação com câmara (Windows)](/pt-pt/tutorials/robot-arms/so-arm101/lerobot/05-Camera-Teleoperation/Windows)
            - [Etapa 5: Teleoperação com câmara (macOS)](/pt-pt/tutorials/robot-arms/so-arm101/lerobot/05-Camera-Teleoperation/MacOS)
          - **6. Recolha de dados**
            - [Etapa 6: Recolha de conjuntos de dados por ensino](/pt-pt/tutorials/robot-arms/so-arm101/lerobot/06-Data-Collection/Teaching-and-Recording)
            - [Etapa 6: Recolha por demonstração — Handshake 200](/pt-pt/tutorials/robot-arms/so-arm101/lerobot/06-Data-Collection/Teaching-and-Recording-Handshake-200)
            - [Etapa 6: Ver e reproduzir um conjunto de dados](/pt-pt/tutorials/robot-arms/so-arm101/lerobot/06-Data-Collection/Browse-and-Replay)
            - [Etapa 6: Notas sobre a recolha de conjuntos de dados](/pt-pt/tutorials/robot-arms/so-arm101/lerobot/06-Data-Collection/Collection-Notes)
            - [Etapa 6: Registar uma conta Hugging Face (opcional)](/pt-pt/tutorials/robot-arms/so-arm101/lerobot/06-Data-Collection/HF-Account)
            - [Etapa 6: Carregar dados para o HuggingFace (opcional)](/pt-pt/tutorials/robot-arms/so-arm101/lerobot/06-Data-Collection/HF-Dataset-Upload)
            - [Etapa 7 (simulação): Recolher um conjunto de dados — teleoperação Lightwheel LeIsaac](/pt-pt/tutorials/robot-arms/so-arm101/lerobot/06-Data-Collection/LeIsaac-Sim)
          - **7. Treino de modelos**
            - [Etapa 7: Treino local em Ubuntu](/pt-pt/tutorials/robot-arms/so-arm101/lerobot/07-Training/Local-Ubuntu)
            - [Etapa 7: Ambiente de treino em GPU na nuvem](/pt-pt/tutorials/robot-arms/so-arm101/lerobot/07-Training/Cloud-GPU)
            - [Etapa 7: Visualizar as curvas de treino com o wandb](/pt-pt/tutorials/robot-arms/so-arm101/lerobot/07-Training/WandB-Curves)
            - [Etapa 7: Enviar o modelo para o HuggingFace (opcional)](/pt-pt/tutorials/robot-arms/so-arm101/lerobot/07-Training/HF-Model-Upload)
            - [Etapa 7: Obter o ficheiro de pesos do modelo](/pt-pt/tutorials/robot-arms/so-arm101/lerobot/07-Training/Model-Weights)
            - [Etapa 7: Comando de treino ACT](/pt-pt/tutorials/robot-arms/so-arm101/lerobot/07-Training/Command-ACT)
            - [Etapa 7: Comando de treino pi0](/pt-pt/tutorials/robot-arms/so-arm101/lerobot/07-Training/Command-pi0)
            - [Etapa 7: Comando de treino pi0.5](/pt-pt/tutorials/robot-arms/so-arm101/lerobot/07-Training/Command-pi0.5)
            - [Etapa 7: Comando de treino pi0fast](/pt-pt/tutorials/robot-arms/so-arm101/lerobot/07-Training/Command-pi0fast)
            - [Etapa 7: Comando de treino smolvla](/pt-pt/tutorials/robot-arms/so-arm101/lerobot/07-Training/Command-smolvla)
            - [Etapa 7: Comando de treino Diffusion](/pt-pt/tutorials/robot-arms/so-arm101/lerobot/07-Training/Command-Diffusion)
            - [Etapa 7: Comando de treino WALL-OSS](/pt-pt/tutorials/robot-arms/so-arm101/lerobot/07-Training/Command-Wall-OSS)
            - [Etapa 7: Linha de comandos de treino](/pt-pt/tutorials/robot-arms/so-arm101/lerobot/07-Training/Train-CLI)
            - [Etapa 7: Recomendações de parâmetros de treino](/pt-pt/tutorials/robot-arms/so-arm101/lerobot/07-Training/Training-Parameters)
            - [Etapa 7: Algoritmos de aprendizagem por imitação suportados pelo LeRobot](/pt-pt/tutorials/robot-arms/so-arm101/lerobot/07-Training/Imitation-Learning-Algorithms)
          - **8. Implantação**
            - [Etapa 8: Descrição da linha de comando](/pt-pt/tutorials/robot-arms/so-arm101/lerobot/08-Inference/CLI-Reference)
            - [Etapa 8: Bugs comuns e soluções](/pt-pt/tutorials/robot-arms/so-arm101/lerobot/08-Inference/Common-Bugs)
            - [Etapa 8: Comando de implantação ACT](/pt-pt/tutorials/robot-arms/so-arm101/lerobot/08-Inference/Command-ACT)
            - [Etapa 8: Comando de implantação pi0](/pt-pt/tutorials/robot-arms/so-arm101/lerobot/08-Inference/Command-pi0)
            - [Etapa 8: Comando de implantação pi0.5](/pt-pt/tutorials/robot-arms/so-arm101/lerobot/08-Inference/Command-pi0.5)
            - [Etapa 8: Comando de implantação smolvla](/pt-pt/tutorials/robot-arms/so-arm101/lerobot/08-Inference/Command-smolvla)
            - [Etapa 8: Comando de implantação Diffusion](/pt-pt/tutorials/robot-arms/so-arm101/lerobot/08-Inference/Command-Diffusion)
            - [Etapa 8: Comando de implantação WALL-OSS](/pt-pt/tutorials/robot-arms/so-arm101/lerobot/08-Inference/Command-Wall-OSS)
            - [Etapa 8: Inferência NVIDIA DGX Spark](/pt-pt/tutorials/robot-arms/so-arm101/lerobot/08-Inference/DGX-Spark)
            - [Etapa 8: Inferência D-Robotics RDK S100](/pt-pt/tutorials/robot-arms/so-arm101/lerobot/08-Inference/RDK-S100)
          - **Noções básicas**
            - [Conhecer o LeRobot](/pt-pt/tutorials/robot-arms/so-arm101/basics/Understanding-LeRobot)
            - [Conjuntos de dados LeRobot no HuggingFace](/pt-pt/tutorials/robot-arms/so-arm101/basics/HF-Datasets)
            - [Materiais para o treino de modelos](/pt-pt/tutorials/robot-arms/so-arm101/basics/Training-Resources)
            - [Ficheiros oficiais de impressão 3D do SO-ARM 100](/pt-pt/tutorials/robot-arms/so-arm101/basics/Official-3D-Print-Files)
            - [Ficheiros URDF e materiais de referência](/pt-pt/tutorials/robot-arms/so-arm101/basics/URDF-Reference)
            - [Suportes e fixações de câmara recomendados](/pt-pt/tutorials/robot-arms/so-arm101/basics/Camera-Mounts-Recommended)
          - **Tópicos adicionais**
            - [Controlo de simulação ROS2](/pt-pt/tutorials/robot-arms/so-arm101/ROS2-Simulation-Control)
            - [Instalação da garra de dedos paralelos](/pt-pt/tutorials/robot-arms/so-arm101/Parallel-Finger-Gripper-Installation)
      - **Tutorial do LeLab**
        - [1 · Visão geral](/pt-pt/tutorials/robot-arms/so-arm101/lelab/01-Overview)
        - [2 · Instalar e executar](/pt-pt/tutorials/robot-arms/so-arm101/lelab/02-Install)
        - [3 · Ligar e calibrar](/pt-pt/tutorials/robot-arms/so-arm101/lelab/03-Calibration)
        - [4 · Teleoperação](/pt-pt/tutorials/robot-arms/so-arm101/lelab/04-Teleoperation)
        - [5 · Gravar um conjunto de dados](/pt-pt/tutorials/robot-arms/so-arm101/lelab/05-Record-Dataset)
        - [6 · Treinar e executar inferência](/pt-pt/tutorials/robot-arms/so-arm101/lelab/06-Train-and-Inference)
        - [7 · Resolução de problemas](/pt-pt/tutorials/robot-arms/so-arm101/lelab/07-Troubleshooting)
      - **Tutorial de simulação MuJoCo**,        - [SO-ARM101 × MuJoCo — Tutorial do fluxo completo (índice)](/pt-pt/tutorials/robot-arms/so-arm101/mujoco/),        - [01 · Preparação do ambiente](/pt-pt/tutorials/robot-arms/so-arm101/mujoco/01-Environment),        - [02 · Verificação do modelo de simulação (carregamento e acionamento MJCF)](/pt-pt/tutorials/robot-arms/so-arm101/mujoco/02-Sim-Model-Verification),        - [03 · Ligação ao robô real e calibração](/pt-pt/tutorials/robot-arms/so-arm101/mujoco/03-Hardware-Calibration),        - [04 · Teleoperação por teclado](/pt-pt/tutorials/robot-arms/so-arm101/mujoco/04-Keyboard-Teleop),        - [05 · Gémeo digital do braço líder (braço físico a comandar o braço simulado)](/pt-pt/tutorials/robot-arms/so-arm101/mujoco/05-Leader-Digital-Twin),        - [06 · Gravação e reprodução de dados](/pt-pt/tutorials/robot-arms/so-arm101/mujoco/06-Record-and-Replay),        - [07 · Problemas comuns e lições aprendidas](/pt-pt/tutorials/robot-arms/so-arm101/mujoco/07-Troubleshooting),        - [08 · Próximos passos](/pt-pt/tutorials/robot-arms/so-arm101/mujoco/08-Roadmap),        - [09 · Tutorial de utilização completo (braço → conjunto de dados → ver vídeos → treino → implementação)](/pt-pt/tutorials/robot-arms/so-arm101/mujoco/09-Usage-Tutorial)
  - **Curso SO-ARM101 + AmazingHand**
    - [Visão geral do curso](/pt-pt/tutorials/robot-arms/so-arm-amazinghand/)
      - **Linux**
        - [Etapa 1: Configuração do ambiente (Linux)](/pt-pt/tutorials/robot-arms/so-arm-amazinghand/01-Environment-Setup-Linux)
        - [Etapa 2: calibração de mão e braços (Linux)](/pt-pt/tutorials/robot-arms/so-arm-amazinghand/02-Hand-Arm-Calibration-Linux)
        - [Etapa 3: Teleoperação (Linux)](/pt-pt/tutorials/robot-arms/so-arm-amazinghand/03-Teleoperation-Linux)
        - [Etapa 4: Recolha de dados (Linux)](/pt-pt/tutorials/robot-arms/so-arm-amazinghand/04-Data-Collection-Linux)
        - [Etapa 5: Treino do modelo (Linux)](/pt-pt/tutorials/robot-arms/so-arm-amazinghand/05-Model-Training-Linux)
        - [Etapa 6: implementação do modelo (Linux)](/pt-pt/tutorials/robot-arms/so-arm-amazinghand/06-Model-Deployment-Linux)
      - **Windows**
        - [Etapa 1: Configuração do ambiente (Windows)](/pt-pt/tutorials/robot-arms/so-arm-amazinghand/01-Environment-Setup-Windows)
        - [Etapa 2: calibração de mão e braços (Windows)](/pt-pt/tutorials/robot-arms/so-arm-amazinghand/02-Hand-Arm-Calibration-Windows)
        - [Etapa 3: Teleoperação (Windows)](/pt-pt/tutorials/robot-arms/so-arm-amazinghand/03-Teleoperation-Windows)
        - [Etapa 4: Recolha de dados (Windows)](/pt-pt/tutorials/robot-arms/so-arm-amazinghand/04-Data-Collection-Windows)
        - [Etapa 5: Treino do modelo (Windows)](/pt-pt/tutorials/robot-arms/so-arm-amazinghand/05-Model-Training-Windows)
        - [Etapa 6: implementação do modelo (Windows)](/pt-pt/tutorials/robot-arms/so-arm-amazinghand/06-Model-Deployment-Windows)
  - **Tutoriais do XLeRobot**
    - [Visão geral dos tutoriais](/pt-pt/tutorials/robot-arms/xlerobot/)
    - [Configuração (macOS)](/pt-pt/tutorials/robot-arms/xlerobot/01-Environment-Setup-macOS)
    - [Configuração (Ubuntu)](/pt-pt/tutorials/robot-arms/xlerobot/01-Environment-Setup-Ubuntu)
    - [Configuração (Windows)](/pt-pt/tutorials/robot-arms/xlerobot/01-Environment-Setup-Windows)
    - [Mover ficheiros do XLeRobot](/pt-pt/tutorials/robot-arms/xlerobot/02-Move-Xlerobot-Files)
    - [Montagem do kit montado](/pt-pt/tutorials/robot-arms/xlerobot/03-Assembly-Assembled-Kit)
    - [Montagem do kit em peças](/pt-pt/tutorials/robot-arms/xlerobot/04-Assembly-Parts-Kit)
  - **Visão geral dos tutoriais AmazingHand**
    - [Índice do tutorial (incl. URLs antigas)](/pt-pt/tutorials/robot-arms/amazing-hand/index.md)
    - [Visão geral dos tutoriais AmazingHand](/pt-pt/tutorials/robot-arms/amazing-hand/README)
    - [Documentação do produto AmazingHand](/pt-pt/tutorials/robot-arms/amazing-hand/00-product/product-info)
    - [Comparação e seleção entre as versões SCS0009 e PWM](/pt-pt/tutorials/robot-arms/amazing-hand/00-product/version-comparison)
    - [Downloads e recursos](/pt-pt/tutorials/robot-arms/amazing-hand/00-product/downloads)
    - [Visão geral do hardware: estrutura, CAD e montagem](/pt-pt/tutorials/robot-arms/amazing-hand/01-hardware/overview)
    - [Cablagem, ID e alimentação SCS0009](/pt-pt/tutorials/robot-arms/amazing-hand/01-hardware/scs0009)
    - [Cablagem, GPIO e alimentação PWM](/pt-pt/tutorials/robot-arms/amazing-hand/01-hardware/pwm)
    - [Instalação do kit de câmara ambiente](/pt-pt/tutorials/robot-arms/amazing-hand/01-hardware/camera-kit)
    - [Início rápido SCS0009](/pt-pt/tutorials/robot-arms/amazing-hand/02-quick-start/scs0009)
    - [Início rápido PWM](/pt-pt/tutorials/robot-arms/amazing-hand/02-quick-start/pwm)
    - [Controlo web do AmazingHand](/pt-pt/tutorials/robot-arms/amazing-hand/03-web-control/README)
    - [Controlo web SCS0009](/pt-pt/tutorials/robot-arms/amazing-hand/03-web-control/scs0009)
    - [Controlo web PWM](/pt-pt/tutorials/robot-arms/amazing-hand/03-web-control/pwm)
    - [Aplicação de desktop SCS0009 (GUI e CLI)](/pt-pt/tutorials/robot-arms/amazing-hand/04-desktop/scs0009)
    - [Aplicação de desktop PWM (GUI Tkinter)](/pt-pt/tutorials/robot-arms/amazing-hand/04-desktop/pwm)
    - [Seguimento de mãos SCS0009 (Demo oficial dora)](/pt-pt/tutorials/robot-arms/amazing-hand/05-hand-tracking/scs0009)
    - [Seguimento de mãos PWM (MediaPipe integrado na GUI)](/pt-pt/tutorials/robot-arms/amazing-hand/05-hand-tracking/pwm)
    - [Depuração e calibração dos servos SCS0009](/pt-pt/tutorials/robot-arms/amazing-hand/06-servo-tuning/scs0009)
    - [Protocolo, comandos e calibração dos servos PWM](/pt-pt/tutorials/robot-arms/amazing-hand/06-servo-tuning/pwm)
    - [Tutorial de utilização do Arduino Nano](/pt-pt/tutorials/robot-arms/amazing-hand/07-arduino/arduino-nano)
    - [Exemplos Arduino e Python](/pt-pt/tutorials/robot-arms/amazing-hand/07-arduino/examples)
    - [Perguntas frequentes (FAQ)](/pt-pt/tutorials/robot-arms/amazing-hand/08-faq/faq)
  - **Lekiwi**
    - [Tutorial de Uso do Robô Móvel Lekiwi](/pt-pt/tutorials/robot-arms/lekiwi/Lekiwi-Tutorial)
    - [Tutorial de Montagem do Robô Móvel Lekiwi](/pt-pt/tutorials/robot-arms/lekiwi/Lekiwi-Assembly)
  - **Tutorial do robô auto-endireitador SR-Support**
    - [Tutorial do robô auto-endireitador SR-Support](/pt-pt/tutorials/robot-arms/sr-support/)
    - [01 Fundamentos](/pt-pt/tutorials/robot-arms/sr-support/01-basics)
    - [02 Preparação do ambiente (venv, ferramentas de gravação e firmware)](/pt-pt/tutorials/robot-arms/sr-support/02-environment)
    - [03 Gravar o firmware principal](/pt-pt/tutorials/robot-arms/sr-support/03-build-flash)
    - [04 Montagem: imprimir, montar, ligar](/pt-pt/tutorials/robot-arms/sr-support/04-assembly)
    - [05 Calibração do ponto zero (teclas de seta; obrigatório para montagens DIY)](/pt-pt/tutorials/robot-arms/sr-support/05-zero-tool)
    - [06 Depuração e calibração](/pt-pt/tutorials/robot-arms/sr-support/06-debug-and-calibrate)
    - [07 Utilização e monitorização do auto-endireitamento](/pt-pt/tutorials/robot-arms/sr-support/07-self-righting)
    - [08 Página de estado WiFi e aprovisionamento](/pt-pt/tutorials/robot-arms/sr-support/08-wifi)
    - [09 Simulação MuJoCo e o gémeo ao vivo](/pt-pt/tutorials/robot-arms/sr-support/09-mujoco)
    - [10 Resolução de problemas](/pt-pt/tutorials/robot-arms/sr-support/10-troubleshooting)
    - [11 Referência: modelo, parâmetros e licenciamento](/pt-pt/tutorials/robot-arms/sr-support/11-reference)

### Acessórios

- [Visão Geral dos Acessórios](/pt-pt/tutorials/accessories/)
  - **Módulo de Reconhecimento de Voz KWS**
    - [Início da Série](/pt-pt/tutorials/accessories/KWS-speech-recognition-module/)
    - [Comunicação Serial Jetson Nano](/pt-pt/tutorials/accessories/KWS-speech-recognition-module/Jetson-Nano-serial-communication)
    - [Comunicação Serial Jetson](/pt-pt/tutorials/accessories/KWS-speech-recognition-module/Jetson-serial-communication)
    - [Comunicação Serial PC](/pt-pt/tutorials/accessories/KWS-speech-recognition-module/PC-serial-communication)
    - [Comunicação Serial Raspberry Pi](/pt-pt/tutorials/accessories/KWS-speech-recognition-module/raspberry-pi-serial-communication)
    - [Visualização ROS2 RViz2](/pt-pt/tutorials/accessories/KWS-speech-recognition-module/ROS2-rviz2-visualization)
    - [Download e Gravação de Firmware de Palavras de Ativação](/pt-pt/tutorials/accessories/KWS-speech-recognition-module/download-and-burn-firmware-for-chinese-and-english-recognition-words)
  - **Servos Feetech**
    - [Tutorial de Depuração STS3215 & SCS0009](/pt-pt/tutorials/accessories/feetech/Feetech-STS3215&SCS0009-Tutorial)
    - [Protocolo de Comunicação SCS](/pt-pt/tutorials/accessories/feetech/Feetech-SCS_Communication_Protocol)
    - [Tabela de Memória do Servo STS com Encoder Magnético](/pt-pt/tutorials/accessories/feetech/Feetech-Magnetic_Encoder_STS_Servo-Memory_Table_Analysis)
    - [Tabela de Memória do Servo SCSCL com Potenciômetro](/pt-pt/tutorials/accessories/feetech/Feetech-Potentiometer_SCSCL_Servo-Memory_Table_Analysis)
    - [Tutorial de utilização da ferramenta de depuração do servo SCS0009](/pt-pt/tutorials/accessories/feetech/SCS0009-Debug-Tool)
    - [Depurador Web de servos de barramento Feetech (SCS0009 / STS3215 / HD1910)](/pt-pt/tutorials/accessories/feetech/Feetech-Web-Debugger)
  - **Módulo de transmissão de vídeo ESP32-NanoCam**
    - [Início rápido do ESP32-NanoCam](/pt-pt/tutorials/accessories/esp32-nanocam/ESP32-NanoCam-Quick-Start)
    - [Especificações de hardware do ESP32-NanoCam](/pt-pt/tutorials/accessories/esp32-nanocam/ESP32-NanoCam-Hardware-Spec)
    - [Manual do protocolo serial do ESP32-NanoCam](/pt-pt/tutorials/accessories/esp32-nanocam/ESP32-NanoCam-Serial-Protocol)
      - **Tutorial de visão IA (11 capítulos)**
        - [Capítulo 1: Configuração do ambiente](/pt-pt/tutorials/accessories/esp32-nanocam/Ch01-Environment-Setup)
        - [Capítulo 2: Início rápido](/pt-pt/tutorials/accessories/esp32-nanocam/Ch02-Quick-Start)
        - [Capítulo 3: Noções básicas da câmara](/pt-pt/tutorials/accessories/esp32-nanocam/Ch03-Camera-Basics)
        - [Capítulo 4: Deteção de rostos](/pt-pt/tutorials/accessories/esp32-nanocam/Ch04-Face-Detection)
        - [Capítulo 5: Deteção de caras de gato](/pt-pt/tutorials/accessories/esp32-nanocam/Ch05-Cat-Face-Detection)
        - [Capítulo 6: Reconhecimento de cores](/pt-pt/tutorials/accessories/esp32-nanocam/Ch06-Color-Recognition)
        - [Capítulo 7: Leitura de códigos QR](/pt-pt/tutorials/accessories/esp32-nanocam/Ch07-QR-Code-Scanning)
        - [Capítulo 8: Reconhecimento facial](/pt-pt/tutorials/accessories/esp32-nanocam/Ch08-Face-Recognition)
        - [Capítulo 9: Conversa por voz](/pt-pt/tutorials/accessories/esp32-nanocam/Ch09-Voice-Chat)
        - [Capítulo 10: Compreensão visual com IA](/pt-pt/tutorials/accessories/esp32-nanocam/Ch10-AI-Vision-Understanding)
        - [Capítulo 11: Controlo por voz ESP-Claw](/pt-pt/tutorials/accessories/esp32-nanocam/Ch11-ESP-Claw-Voice-Control)
  - **Tutoriais da câmara CSI**
    - [Configuração da câmara CSI no Jetson](/pt-pt/tutorials/accessories/csi-camera/01-Jetson-CSI-Setup)
    - [Utilização da câmara com autofoco](/pt-pt/tutorials/accessories/csi-camera/02-Auto-Focus-Camera)
    - [Uso do Jupyter Lab](/pt-pt/tutorials/accessories/csi-camera/03-JupyterLab)
    - [Uso do JetCam](/pt-pt/tutorials/accessories/csi-camera/04-JetCam)
    - [IMX219 no Raspberry Pi](/pt-pt/tutorials/accessories/csi-camera/05-IMX219-RaspberryPi)
  - **Módulo de interação por voz IA**
    - [Iniciação rápida](/pt-pt/tutorials/accessories/ai-voice-module/Quick-Start)
    - [Informações do produto](/pt-pt/tutorials/accessories/ai-voice-module/Product-Info)
    - [Gravação do firmware do módulo](/pt-pt/tutorials/accessories/ai-voice-module/Firmware-Flashing)
    - [Modificar a palavra de ativação e as palavras de comando](/pt-pt/tutorials/accessories/ai-voice-module/Wake-Word-Commands-Edit)
    - [Criação de entradas de protocolo personalizadas](/pt-pt/tutorials/accessories/ai-voice-module/Custom-Protocol-Entries)
    - [Interação por voz ROS1](/pt-pt/tutorials/accessories/ai-voice-module/ROS1-Voice-Interaction)
    - [Interação por voz ROS2](/pt-pt/tutorials/accessories/ai-voice-module/ROS2-Voice-Interaction)
    - [Protocolo de porta série](/pt-pt/tutorials/accessories/ai-voice-module/Serial-Protocol)
    - [Protocolo IIC](/pt-pt/tutorials/accessories/ai-voice-module/IIC-Protocol)
    - [Comunicação PC](/pt-pt/tutorials/accessories/ai-voice-module/PC-Communication)
    - [Arduino: Comunicação de porta série](/pt-pt/tutorials/accessories/ai-voice-module/Arduino-Serial-Communication)
    - [Arduino: Comunicação IIC](/pt-pt/tutorials/accessories/ai-voice-module/Arduino-IIC-Communication)
    - [Jetson: Comunicação de porta série](/pt-pt/tutorials/accessories/ai-voice-module/Jetson-Serial-Communication)
    - [Jetson: Comunicação IIC](/pt-pt/tutorials/accessories/ai-voice-module/Jetson-IIC-Communication)
    - [RDK: Comunicação de porta série](/pt-pt/tutorials/accessories/ai-voice-module/RDK-Serial-Communication)
    - [RDK: Comunicação IIC](/pt-pt/tutorials/accessories/ai-voice-module/RDK-IIC-Communication)
    - [Raspberry Pi: Comunicação de porta série](/pt-pt/tutorials/accessories/ai-voice-module/RaspberryPi-Serial-Communication)
    - [Raspberry Pi: Comunicação IIC](/pt-pt/tutorials/accessories/ai-voice-module/RaspberryPi-IIC-Communication)
  - **Outros Acessórios**
    - [Câmara USB com Foco Automático](/pt-pt/tutorials/accessories/usb-auto-focus-camera)
    - [Câmara CSI Jetson](/pt-pt/tutorials/accessories/jetson-csi-camera)
    - [Gimbal de Câmara 2-DOF](/pt-pt/tutorials/accessories/2dof-camera-gimbal)
    - [Sensor de Frequência Cardíaca e SpO2](/pt-pt/tutorials/accessories/heart-rate-spo2)
    - [Ecrã OLED de 0,91"](/pt-pt/tutorials/accessories/0.91-oled-screen-tutorial)
    - [Captura HDMI 4K](/pt-pt/tutorials/accessories/4k-hdmi-capture-tutorial)
    - [Chaveador KVM](/pt-pt/tutorials/accessories/kvm-switch-tutorial)
    - [Comutador KVM · Visão geral do tutorial](/pt-pt/tutorials/accessories/kvm-switch/00-Overview-and-Quick-Start),    - [01 · Comutação entre dois computadores (botão e comando IR)](/pt-pt/tutorials/accessories/kvm-switch/01-Switching-Between-Two-Computers),    - [02 · Função HUB (um para três)](/pt-pt/tutorials/accessories/kvm-switch/02-HUB-Function-One-to-Three),    - [03 · Bluetooth](/pt-pt/tutorials/accessories/kvm-switch/03-Bluetooth),    - [04 · Porta série TTL (série sem fios)](/pt-pt/tutorials/accessories/kvm-switch/04-TTL-Serial-Port),    - [05 · Conector de expansão de 10 pinos](/pt-pt/tutorials/accessories/kvm-switch/05-10-Pin-Expansion-Header),    - [06 · Host sem monitor (placa de captura + OBS)](/pt-pt/tutorials/accessories/kvm-switch/06-Headless-Host-Capture-Card-and-OBS),    - [07 · Perguntas frequentes e avisos](/pt-pt/tutorials/accessories/kvm-switch/07-FAQ-and-Precautions)
    - [Placa de Som USB sem Driver](/pt-pt/tutorials/accessories/usb-audio-card-tutorial)

### Sensores

- [Visão Geral dos Sensores](/pt-pt/tutorials/sensors/)
  - **Módulo de Navegação Inercial IMU**
    - [Informações do Produto](/pt-pt/tutorials/sensors/imu/product-info)
    - [Consola web do anfitrião](/pt-pt/tutorials/sensors/imu/web-host-console)
    - [Integração MicroDuck](/pt-pt/tutorials/sensors/imu/microduck-integration)
    - [Calibração IMU](/pt-pt/tutorials/sensors/imu/calibration)
    - [Transferência remota de ficheiros](/pt-pt/tutorials/sensors/imu/remote-file-transfer)
    - [Transferência de ficheiros via SSH](/pt-pt/tutorials/sensors/imu/ssh-file-transfer)
      - **Exemplos Multi-Placa**
        - [Visão Geral dos Casos Multi-Host](/pt-pt/tutorials/sensors/imu/multi-board-examples/overview)
        - [Comunicação PC](/pt-pt/tutorials/sensors/imu/multi-board-examples/pc-communication)
          - **Comunicação I2C**
            - [Arduino](/pt-pt/tutorials/sensors/imu/multi-board-examples/i2c-communication/arduino)
            - [Série Jetson](/pt-pt/tutorials/sensors/imu/multi-board-examples/i2c-communication/jetson)
            - [Raspberry Pi 5](/pt-pt/tutorials/sensors/imu/multi-board-examples/i2c-communication/raspberry-pi)
            - [Série RDK](/pt-pt/tutorials/sensors/imu/multi-board-examples/i2c-communication/rdk)
            - [STM32 F103C8T6](/pt-pt/tutorials/sensors/imu/multi-board-examples/i2c-communication/stm32)
          - **Comunicação Serial**
            - [Arduino](/pt-pt/tutorials/sensors/imu/multi-board-examples/serial-communication/arduino)
            - [Série Jetson](/pt-pt/tutorials/sensors/imu/multi-board-examples/serial-communication/jetson)
            - [Raspberry Pi 5](/pt-pt/tutorials/sensors/imu/multi-board-examples/serial-communication/raspberry-pi)
            - [Série RDK](/pt-pt/tutorials/sensors/imu/multi-board-examples/serial-communication/rdk)
            - [STM32 F103C8T6](/pt-pt/tutorials/sensors/imu/multi-board-examples/serial-communication/stm32)
      - **Exemplos ROS**
        - [Aplicação ROS1](/pt-pt/tutorials/sensors/imu/ros-examples/ros1)
        - [Aplicação ROS2](/pt-pt/tutorials/sensors/imu/ros-examples/ros2)
  - **Módulo GPS e BeiDou**
    - [Informações do módulo](/pt-pt/tutorials/sensors/gps/GPS-Module-Info)
    - [51 MCU: análise GPS](/pt-pt/tutorials/sensors/gps/51-MCU-GPS-Parsing)
    - [Arduino: leitura de posição](/pt-pt/tutorials/sensors/gps/Arduino-Location-Reading)
    - [Arduino: análise de posição](/pt-pt/tutorials/sensors/gps/Arduino-Location-Parsing)
    - [STM32F103: saída de análise GPS](/pt-pt/tutorials/sensors/gps/STM32F103-GPS-Parsing)
    - [Jetson: análise GPS](/pt-pt/tutorials/sensors/gps/Jetson-GPS-Parsing)
    - [Jetson: posicionamento AGNSS](/pt-pt/tutorials/sensors/gps/Jetson-AGNSS)
    - [Jetson: API do Baidu Maps](/pt-pt/tutorials/sensors/gps/Jetson-Baidu-Map-API)
    - [Raspberry Pi: análise GPS](/pt-pt/tutorials/sensors/gps/RaspberryPi-GPS-Parsing)
    - [Raspberry Pi: posicionamento AGNSS](/pt-pt/tutorials/sensors/gps/RaspberryPi-AGNSS)
    - [Raspberry Pi: API do Baidu Maps](/pt-pt/tutorials/sensors/gps/RaspberryPi-Baidu-Map-API)
    - [ROS: preparação](/pt-pt/tutorials/sensors/gps/ROS-Preparation)
    - [ROS: leitura de dados GPS](/pt-pt/tutorials/sensors/gps/ROS-Read-GPS-Data)
    - [ROS: desenhar trajeto GPS](/pt-pt/tutorials/sensors/gps/ROS-Draw-GPS-Track)
    - [Erro de localização no mapa](/pt-pt/tutorials/sensors/gps/Map-Location-Error)

## Como Usar

1. **Selecione a Categoria de Tópico**: Escolha a categoria correspondente com base nos seus interesses ou necessidades
2. **Visualize a Lista de Tutoriais**: Em cada categoria, veja os tutoriais e documentos disponíveis
3. **Siga as Etapas**: Siga as etapas dos tutoriais para aprender e usar o produto gradualmente
4. **Pratique e Explore**: Durante a operação real, experimente diferentes funções e configurações para acumular experiência
- **Recursos de Aprendizado**
  - [Recursos de Aprendizado](./learning-resources/index)
  - [Compatibilidade PyTorch no Jetson Orin](./learning-resources/jetson-orin-pytorch-compatibility)

## Outros Recursos

- Para dúvidas ou sugestões, visite nosso repositório no GitHub para abrir uma Issue
- Acompanhe nosso blog e redes sociais para as novidades sobre produtos e informações de tutoriais
