Juxi-Technology/wiki-documents/docs/content/tutorials/robot-arms/index.md

---
title: Robot Arm Series
description: "Juxi Technology robot arms tutorial home — SO-ARM101, AmazingHand, Lekiwi, XLeRobot, plus LeRobot training courses"
---

# Robot Arm Series

Welcome to the robot arm series tutorials! Here you'll find complete guides for various open-source robotic arms and dexterous hands.

---

## Product List

- [Selection Guide](./select-guide.md)

### SO-ARM101

6-axis desktop open-source robotic arm, supporting LeRobot and other AI frameworks.

- [SO-ARM101 Robotic Arm Tutorials](./so-arm101/index.md)
- [SO-ARM101 Tutorial](./so-arm101/SO-ARM101-Tutorial.md)
- [SO-ARM101 Assembly Guide](./so-arm101/SO-ARM101-Assembly.md)
- [SO-ARM101 Jetson Orin PyTorch Compatibility](./so-arm101/SO-ARM101-Jetson-Orin-PyTorch-Compatibility.md)
- [SO-ARM101 Wireless Teleoperation (ESP32-NanoCam Version)](./so-arm101/SO-ARM101-NanoCam-Wireless-Teleop.md)
- [SO-ARM101 Bi-Arm (Dual Follower) Tutorial](./so-arm101/SO-ARM101-Bi-Arm-Tutorial.md)
- [SoARM Series Servo Calibration Tool](./so-arm101/SO-ARM101-Servo-Calibration-Tool.md)
- [So-ARM Series STS3215 Servo Calibration – Web Version](./so-arm101/SO-ARM101-Web-Calibration.md)

#### SO-ARM101 Series
- [Arm Mount & Camera Kit Installation](./so-arm101/SO-ARM101-100-Arm-Mount-Camera-Kit-Installation.md)
- [Overhead Camera Mount Installation](./so-arm101/SO-ARM101-Overhead-Camera-Mount-Installation.md)

#### 1. Environment Setup
- [Step 1: Environment Setup (Ubuntu)](./so-arm101/lerobot/01-Environment-Setup/Ubuntu.md)
- [Step 1: Environment Setup (Windows)](./so-arm101/lerobot/01-Environment-Setup/Windows.md)
- [Step 1: Environment Setup (macOS)](./so-arm101/lerobot/01-Environment-Setup/MacOS.md)

#### 2. Serial Port Check
- [Step 2: Serial Port Check (Ubuntu)](./so-arm101/lerobot/02-Serial-Port/Ubuntu.md)
- [Step 2: Serial Port Check (Windows)](./so-arm101/lerobot/02-Serial-Port/Windows.md)
- [Step 2: Serial Port Check (macOS)](./so-arm101/lerobot/02-Serial-Port/MacOS.md)

#### 3. Arm Calibration
- [Step 3: Arm Calibration (Ubuntu)](./so-arm101/lerobot/03-Calibration/Ubuntu.md)
- [Step 3: Arm Calibration (Windows)](./so-arm101/lerobot/03-Calibration/Windows.md)
- [Step 3: Arm Calibration (macOS)](./so-arm101/lerobot/03-Calibration/MacOS.md)

#### 4. Teleoperation
- [Step 4: Teleoperation (Ubuntu)](./so-arm101/lerobot/04-Teleoperation/Ubuntu.md)
- [Step 4: Teleoperation (Windows)](./so-arm101/lerobot/04-Teleoperation/Windows.md)
- [Step 4: Teleoperation (macOS)](./so-arm101/lerobot/04-Teleoperation/MacOS.md)

#### 5. Camera Teleop
- [Step 5: Camera Teleoperation (Ubuntu)](./so-arm101/lerobot/05-Camera-Teleoperation/Ubuntu.md)
- [Step 5: Camera Teleoperation (Windows)](./so-arm101/lerobot/05-Camera-Teleoperation/Windows.md)
- [Step 5: Camera Teleoperation (macOS)](./so-arm101/lerobot/05-Camera-Teleoperation/MacOS.md)

#### 6. Data Collection
- [Step 6: Teaching & Recording a Dataset](./so-arm101/lerobot/06-Data-Collection/Teaching-and-Recording.md)
- [Step 6: Teaching & Recording a Dataset — Handshake 200](./so-arm101/lerobot/06-Data-Collection/Teaching-and-Recording-Handshake-200.md)
- [Step 6: Viewing & Replaying a Dataset](./so-arm101/lerobot/06-Data-Collection/Browse-and-Replay.md)
- [Step 6: Dataset Collection Notes](./so-arm101/lerobot/06-Data-Collection/Collection-Notes.md)
- [Step 6: Hugging Face Account (Optional)](./so-arm101/lerobot/06-Data-Collection/HF-Account.md)
- [Step 6: Upload Dataset to Hugging Face (Optional)](./so-arm101/lerobot/06-Data-Collection/HF-Dataset-Upload.md)
- [Step 7 (Simulation): Collecting a Dataset — Lightwheel LeIsaac Teleoperation](./so-arm101/lerobot/06-Data-Collection/LeIsaac-Sim.md)

#### 7. Model Training
- [Step 7: Training — Local Ubuntu](./so-arm101/lerobot/07-Training/Local-Ubuntu.md)
- [Step 7: Training — Cloud GPU Setup](./so-arm101/lerobot/07-Training/Cloud-GPU.md)
- [Step 7: Training — wandb Curves](./so-arm101/lerobot/07-Training/WandB-Curves.md)
- [Step 7: Training — Upload Model (Optional)](./so-arm101/lerobot/07-Training/HF-Model-Upload.md)
- [Step 7: Training — Model Weights](./so-arm101/lerobot/07-Training/Model-Weights.md)
- [Step 7: Training — ACT Command](./so-arm101/lerobot/07-Training/Command-ACT.md)
- [Step 7: Training — pi0 Command](./so-arm101/lerobot/07-Training/Command-pi0.md)
- [Step 7: Training — pi0.5 Command](./so-arm101/lerobot/07-Training/Command-pi0.5.md)
- [Step 7: Training — pi0fast Command](./so-arm101/lerobot/07-Training/Command-pi0fast.md)
- [Step 7: Training — smolvla Command](./so-arm101/lerobot/07-Training/Command-smolvla.md)
- [Step 7: Training — Diffusion Command](./so-arm101/lerobot/07-Training/Command-Diffusion.md)
- [Step 7: Training — WALL-OSS Command](./so-arm101/lerobot/07-Training/Command-Wall-OSS.md)
- [Step 7: Training — Training Command Line](./so-arm101/lerobot/07-Training/Train-CLI.md)
- [Step 7: Training — Parameter Tips](./so-arm101/lerobot/07-Training/Training-Parameters.md)
- [Step 7: Training — Imitation Learning Algorithms](./so-arm101/lerobot/07-Training/Imitation-Learning-Algorithms.md)

#### 8. Model Inference
- [Step 8: Inference — CLI Reference](./so-arm101/lerobot/08-Inference/CLI-Reference.md)
- [Step 8: Inference — Common Bugs](./so-arm101/lerobot/08-Inference/Common-Bugs.md)
- [Step 8: Inference — ACT Command](./so-arm101/lerobot/08-Inference/Command-ACT.md)
- [Step 8: Inference — pi0 Command](./so-arm101/lerobot/08-Inference/Command-pi0.md)
- [Step 8: Inference — pi0.5 Command](./so-arm101/lerobot/08-Inference/Command-pi0.5.md)
- [Step 8: Inference — smolvla Command](./so-arm101/lerobot/08-Inference/Command-smolvla.md)
- [Step 8: Inference — Diffusion Command](./so-arm101/lerobot/08-Inference/Command-Diffusion.md)
- [Step 8: Inference — WALL-OSS Command](./so-arm101/lerobot/08-Inference/Command-Wall-OSS.md)
- [Step 8: Inference — NVIDIA DGX Spark](./so-arm101/lerobot/08-Inference/DGX-Spark.md)
- [Step 8: Inference — D-Robotics RDK S100](./so-arm101/lerobot/08-Inference/RDK-S100.md)

#### Basics
- [Understanding LeRobot](./so-arm101/basics/Understanding-LeRobot.md)
- [LeRobot Datasets on Hugging Face](./so-arm101/basics/HF-Datasets.md)
- [Model Training Resources](./so-arm101/basics/Training-Resources.md)
- [SO-ARM100 Official 3D Print Files](./so-arm101/basics/Official-3D-Print-Files.md)
- [URDF Files and Reference Materials](./so-arm101/basics/URDF-Reference.md)
- [Recommended Camera Brackets and Mounts](./so-arm101/basics/Camera-Mounts-Recommended.md)

#### Extras & Advanced
- [ROS2 Simulation Control](./so-arm101/ROS2-Simulation-Control.md)
- [Parallel Finger Gripper Installation](./so-arm101/Parallel-Finger-Gripper-Installation.md)

#### LeLab Tutorial
- [1 · Overview](./so-arm101/lelab/01-Overview.md)
- [2 · Install and run](./so-arm101/lelab/02-Install.md)
- [3 · Connect and calibrate](./so-arm101/lelab/03-Calibration.md)
- [4 · Teleoperation](./so-arm101/lelab/04-Teleoperation.md)
- [5 · Record a dataset](./so-arm101/lelab/05-Record-Dataset.md)
- [6 · Train and run inference](./so-arm101/lelab/06-Train-and-Inference.md)
- [7 · Troubleshooting](./so-arm101/lelab/07-Troubleshooting.md)
,#### MuJoCo Simulation Tutorial,- [SO-ARM101 × MuJoCo Full Workflow Tutorial (Index)](./so-arm101/mujoco/index.md),- [01 · Environment Setup](./so-arm101/mujoco/01-Environment.md),- [02 · Simulation Model Verification (MJCF Loading and Driving)](./so-arm101/mujoco/02-Sim-Model-Verification.md),- [03 · Real-Robot Connection and Calibration](./so-arm101/mujoco/03-Hardware-Calibration.md),- [04 · Keyboard Teleoperation](./so-arm101/mujoco/04-Keyboard-Teleop.md),- [05 · Leader-Arm Digital Twin (Physical Arm Driving the Simulated Arm)](./so-arm101/mujoco/05-Leader-Digital-Twin.md),- [06 · Data Recording and Replay](./so-arm101/mujoco/06-Record-and-Replay.md),- [07 · Troubleshooting and Lessons Learned](./so-arm101/mujoco/07-Troubleshooting.md),- [08 · Roadmap](./so-arm101/mujoco/08-Roadmap.md),- [09 · Complete Usage Tutorial (Arm Bring-Up → Dataset → Watching Videos → Training → Deployment)](./so-arm101/mujoco/09-Usage-Tutorial.md)

### SO-ARM101 Robotic Arm 7-DOF Tutorial

- [SO-ARM101 Robotic Arm 7-DOF Tutorial](/tutorials/robot-arms/so-arm101/lerobot-7dof/)
- **1. Environment Setup**
  - [Ubuntu](/tutorials/robot-arms/so-arm101/lerobot-7dof/01-Environment-Setup/Ubuntu)
  - [Windows](/tutorials/robot-arms/so-arm101/lerobot-7dof/01-Environment-Setup/Windows)
  - [Mac](/tutorials/robot-arms/so-arm101/lerobot-7dof/01-Environment-Setup/MacOS)
- **2. Replace Files (7-DOF Adaptation)**
  - [Replace Files (7-DOF Adaptation)](/tutorials/robot-arms/so-arm101/lerobot-7dof/02-Replace-Files-7DOF)
- **3. Serial Port Check**
  - [Ubuntu](/tutorials/robot-arms/so-arm101/lerobot-7dof/03-Serial-Port/Ubuntu)
  - [Windows](/tutorials/robot-arms/so-arm101/lerobot-7dof/03-Serial-Port/Windows)
  - [Mac](/tutorials/robot-arms/so-arm101/lerobot-7dof/03-Serial-Port/MacOS)
- **4. Arm Calibration**
  - [Ubuntu](/tutorials/robot-arms/so-arm101/lerobot-7dof/04-Calibration/Ubuntu)
  - [Windows](/tutorials/robot-arms/so-arm101/lerobot-7dof/04-Calibration/Windows)
  - [Mac](/tutorials/robot-arms/so-arm101/lerobot-7dof/04-Calibration/MacOS)
- **5. Teleoperation**
  - [Ubuntu](/tutorials/robot-arms/so-arm101/lerobot-7dof/05-Teleoperation/Ubuntu)
  - [Windows](/tutorials/robot-arms/so-arm101/lerobot-7dof/05-Teleoperation/Windows)
  - [Mac](/tutorials/robot-arms/so-arm101/lerobot-7dof/05-Teleoperation/MacOS)
- **6. Camera Teleop**
  - [Ubuntu](/tutorials/robot-arms/so-arm101/lerobot-7dof/06-Camera-Teleoperation/Ubuntu)
  - [Windows](/tutorials/robot-arms/so-arm101/lerobot-7dof/06-Camera-Teleoperation/Windows)
  - [Mac](/tutorials/robot-arms/so-arm101/lerobot-7dof/06-Camera-Teleoperation/MacOS)
- **7. Data Collection**
  - [Browse and Replay the Dataset](/tutorials/robot-arms/so-arm101/lerobot-7dof/07-Data-Collection/Browse-and-Replay)
  - [Dataset Collection Notes](/tutorials/robot-arms/so-arm101/lerobot-7dof/07-Data-Collection/Collection-Notes)
  - [Register a Hugging Face Account (Optional)](/tutorials/robot-arms/so-arm101/lerobot-7dof/07-Data-Collection/HF-Account)
  - [Upload Dataset to HuggingFace (Optional)](/tutorials/robot-arms/so-arm101/lerobot-7dof/07-Data-Collection/HF-Dataset-Upload)
  - [Teaching and Recording a Dataset - Handshake 200](/tutorials/robot-arms/so-arm101/lerobot-7dof/07-Data-Collection/Teaching-and-Recording-Handshake-200)
  - [Teaching and Recording a Dataset](/tutorials/robot-arms/so-arm101/lerobot-7dof/07-Data-Collection/Teaching-and-Recording)
- **8. Model Training**
  - [Cloud GPU Training Environment Setup](/tutorials/robot-arms/so-arm101/lerobot-7dof/08-Training/Cloud-GPU)
  - [Training Command Line - ACT (Recommended for Beginners)](/tutorials/robot-arms/so-arm101/lerobot-7dof/08-Training/Command-ACT)
  - [Training Command Line - Diffusion](/tutorials/robot-arms/so-arm101/lerobot-7dof/08-Training/Command-Diffusion)
  - [Training Command Line - pi0.5](/tutorials/robot-arms/so-arm101/lerobot-7dof/08-Training/Command-pi0.5)
  - [Training Command Line - pi0 (Best Results)](/tutorials/robot-arms/so-arm101/lerobot-7dof/08-Training/Command-pi0)
  - [Training Command Line - pi0fast](/tutorials/robot-arms/so-arm101/lerobot-7dof/08-Training/Command-pi0fast)
  - [Training Command Line - smolvla (Recommended for Advanced Users)](/tutorials/robot-arms/so-arm101/lerobot-7dof/08-Training/Command-smolvla)
  - [Upload the Model to HuggingFace (Optional)](/tutorials/robot-arms/so-arm101/lerobot-7dof/08-Training/HF-Model-Upload)
  - [Imitation Learning Algorithms Supported by LeRobot](/tutorials/robot-arms/so-arm101/lerobot-7dof/08-Training/Imitation-Learning-Algorithms)
  - [Local Ubuntu Training](/tutorials/robot-arms/so-arm101/lerobot-7dof/08-Training/Local-Ubuntu)
  - [Obtain the Model Weight File](/tutorials/robot-arms/so-arm101/lerobot-7dof/08-Training/Model-Weights)
  - [Training Parameter Recommendations](/tutorials/robot-arms/so-arm101/lerobot-7dof/08-Training/Training-Parameter-Tips)
  - [View Real-Time Training Curves on wandb](/tutorials/robot-arms/so-arm101/lerobot-7dof/08-Training/WandB-Curves)
- **9. Model Inference**
  - [Command Line Reference](/tutorials/robot-arms/so-arm101/lerobot-7dof/09-Inference/CLI-Reference)
  - [Inference Command Line - ACT](/tutorials/robot-arms/so-arm101/lerobot-7dof/09-Inference/Command-ACT)
  - [Inference Command Line - Diffusion](/tutorials/robot-arms/so-arm101/lerobot-7dof/09-Inference/Command-Diffusion)
  - [Inference Command Line - pi0.5](/tutorials/robot-arms/so-arm101/lerobot-7dof/09-Inference/Command-pi0.5)
  - [Inference Command Line - pi0](/tutorials/robot-arms/so-arm101/lerobot-7dof/09-Inference/Command-pi0)
  - [Inference Command Line - smolvla](/tutorials/robot-arms/so-arm101/lerobot-7dof/09-Inference/Command-smolvla)
  - [Common Bugs and Fixes](/tutorials/robot-arms/so-arm101/lerobot-7dof/09-Inference/Common-Bugs)
  - [NVIDIA DGX Spark Inference](/tutorials/robot-arms/so-arm101/lerobot-7dof/09-Inference/DGX-Spark)
  - [D-Robotics RDK S100 Inference](/tutorials/robot-arms/so-arm101/lerobot-7dof/09-Inference/RDK-S100)

### AmazingHand Dexterous Hand Tutorials Overview

Unified tutorial entry for the AmazingHand dexterous hand: product selection, hardware wiring, quick start, web control, desktop host software, hand tracking, servo tuning and FAQ for the SCS0009 serial bus version and the PWM servo version.

- [Tutorial index (incl. legacy URLs)](./amazing-hand/index.md)
- [AmazingHand Dexterous Hand Tutorials Overview](./amazing-hand/README.md)
- [AmazingHand Product Information](./amazing-hand/00-product/product-info.md)
- [SCS0009 vs PWM Version Comparison and Selection](./amazing-hand/00-product/version-comparison.md)
- [Downloads and Resources](./amazing-hand/00-product/downloads.md)
- [Hardware Overview: Mechanics, CAD and Assembly](./amazing-hand/01-hardware/overview.md)
- [SCS0009 Wiring, ID and Power](./amazing-hand/01-hardware/scs0009.md)
- [PWM Wiring, GPIO and Power](./amazing-hand/01-hardware/pwm.md)
- [Environmental Camera Kit Installation](./amazing-hand/01-hardware/camera-kit.md)
- [SCS0009 Quick Start](./amazing-hand/02-quick-start/scs0009.md)
- [PWM Quick Start](./amazing-hand/02-quick-start/pwm.md)
- [AmazingHand Web Control](./amazing-hand/03-web-control/README.md)
- [SCS0009 Web Control](./amazing-hand/03-web-control/scs0009.md)
- [PWM Web Control](./amazing-hand/03-web-control/pwm.md)
- [SCS0009 Desktop Host Software (GUI and CLI)](./amazing-hand/04-desktop/scs0009.md)
- [PWM Desktop Host Software (Tkinter GUI)](./amazing-hand/04-desktop/pwm.md)
- [SCS0009 Hand Tracking (Official dora Demo)](./amazing-hand/05-hand-tracking/scs0009.md)
- [PWM Hand Tracking (MediaPipe Built into the GUI)](./amazing-hand/05-hand-tracking/pwm.md)
- [SCS0009 Servo Debugging and Calibration](./amazing-hand/06-servo-tuning/scs0009.md)
- [PWM Servo Protocol, Commands and Calibration](./amazing-hand/06-servo-tuning/pwm.md)
- [Arduino Nano Tutorial](./amazing-hand/07-arduino/arduino-nano.md)
- [Arduino and Python Examples](./amazing-hand/07-arduino/examples.md)
- [Frequently Asked Questions (FAQ)](./amazing-hand/08-faq/faq.md)

### Lekiwi

Fully open-source mobile robot cart, compatible with LeRobot imitation learning framework, supporting SO101 arm.

- [Lekiwi Tutorial](./lekiwi/Lekiwi-Tutorial.md)
- [Lekiwi Assembly Guide](./lekiwi/Lekiwi-Assembly.md)
- [Product Information](./lekiwi/Lekiwi-Product-Info.md)

### SR-Support Self-Righting Robot Tutorial

Complete tutorial for the SR-Support 2-DOF self-righting device, from basics and environment setup to flashing, assembly, zeroing, calibration, self-righting usage and troubleshooting.

- [SR-Support Self-Righting Robot Tutorial](./sr-support/index.md)
- [01 Basics](./sr-support/01-basics.md)
- [02 Environment setup (venv, flash tools and firmware)](./sr-support/02-environment.md)
- [03 Flash the main firmware](./sr-support/03-build-flash.md)
- [04 Assembly: print, build, wire](./sr-support/04-assembly.md)
- [05 Zero-calibration (arrow keys; required for DIY builds)](./sr-support/05-zero-tool.md)
- [06 Debug and calibration](./sr-support/06-debug-and-calibrate.md)
- [07 Self-righting usage and monitoring](./sr-support/07-self-righting.md)
- [08 WiFi status page and provisioning](./sr-support/08-wifi.md)
- [09 MuJoCo simulation and the live twin](./sr-support/09-mujoco.md)
- [10 Troubleshooting](./sr-support/10-troubleshooting.md)
- [11 Reference: model, parameters and licensing](./sr-support/11-reference.md)

### SO-ARM101 + AmazingHand Course

Complete workflow for the SO-ARM101 follower + AmazingHand: setup, calibration, teleoperation, data collection, model training and deployment (Windows / Linux tracks).

- [Course Overview](./so-arm-amazinghand/index.md)

#### Linux

- [Stage 1: Environment Setup (Linux)](./so-arm-amazinghand/01-Environment-Setup-Linux.md)
- [Stage 2: Hand & Arm Calibration (Linux)](./so-arm-amazinghand/02-Hand-Arm-Calibration-Linux.md)
- [Stage 3: Teleoperation (Linux)](./so-arm-amazinghand/03-Teleoperation-Linux.md)
- [Stage 4: Data Collection (Linux)](./so-arm-amazinghand/04-Data-Collection-Linux.md)
- [Stage 5: Model Training (Linux)](./so-arm-amazinghand/05-Model-Training-Linux.md)
- [Stage 6: Model Deployment (Linux)](./so-arm-amazinghand/06-Model-Deployment-Linux.md)

#### Windows

- [Stage 1: Environment Setup (Windows)](./so-arm-amazinghand/01-Environment-Setup-Windows.md)
- [Stage 2: Hand & Arm Calibration (Windows)](./so-arm-amazinghand/02-Hand-Arm-Calibration-Windows.md)
- [Stage 3: Teleoperation (Windows)](./so-arm-amazinghand/03-Teleoperation-Windows.md)
- [Stage 4: Data Collection (Windows)](./so-arm-amazinghand/04-Data-Collection-Windows.md)
- [Stage 5: Model Training (Windows)](./so-arm-amazinghand/05-Model-Training-Windows.md)
- [Stage 6: Model Deployment (Windows)](./so-arm-amazinghand/06-Model-Deployment-Windows.md)

### XLeRobot Tutorials

XLeRobot dual-arm mobile robot tutorials: environment setup, file deployment, and assembled/parts kit assembly.

- [Tutorials Overview](./xlerobot/index.md)
- [Environment Setup (macOS)](./xlerobot/01-Environment-Setup-macOS.md)
- [Environment Setup (Ubuntu)](./xlerobot/01-Environment-Setup-Ubuntu.md)
- [Environment Setup (Windows)](./xlerobot/01-Environment-Setup-Windows.md)
- [Move XLeRobot Files](./xlerobot/02-Move-Xlerobot-Files.md)
- [Assembled-Kit Assembly](./xlerobot/03-Assembly-Assembled-Kit.md)
- [Parts-Kit Assembly](./xlerobot/04-Assembly-Parts-Kit.md)
- [XLeRobot Docker Tutorial — Jetson AGX Orin](/tutorials/jetson-agx-orin/xlerobot-docker/deployment/01-Overview)
- [XLeRobot Docker Tutorial — Jetson Orin Nano](/tutorials/jetson-orin-nano/xlerobot-docker/deployment/01-Overview)

---

## Technical Support

If you have any questions, please contact:

- 📧 Email: support@juxitech.com
- 💬 GitHub Issues: [Feedback](https://github.com/Juxi-Technology/wiki-documents/issues)
