Juxi-Technology/wiki-documents/docs/content/zh-hant/tutorials/index.md

---
title: 教程首頁
titleTemplate: 產品教程與指南
description: "鉅犀科技產品教程首頁：彙整機械臂、靈巧手、感測器與配件等全系列使用教學與指南。"
head:
  - [ meta, { property: "og:title", content: "教程首頁 | 產品教程與指南" } ]
  - [ meta, { property: "og:description", content: "鉅犀科技產品教程首頁：彙整機械臂、靈巧手、感測器與配件等全系列使用教學與指南。" } ]
---

# 產品教程首頁

歡迎訪問產品教程頁面！在這裡，您可以找到所有產品的使用教程、配置指南和最佳實踐，幫助您快速上手並充分發揮產品的功能。

## 主題分類

### 快速開始

- [常見問題 FAQ](/zh-hant/tutorials/faq)
- [ROS 入門](/zh-hant/tutorials/ros-intro)
- [飛書文檔](/zh-hant/tutorials/lark-wiki)

### SO-ARM101機械臂 7軸 教程

- [SO-ARM101機械臂 7軸 教程](/tutorials/robot-arms/so-arm101/lerobot-7dof/)
- **1. 安裝 LeRobot 環境**
  - [Ubuntu電腦](/zh-hant/tutorials/robot-arms/so-arm101/lerobot-7dof/01-Environment-Setup/Ubuntu)
  - [Windows電腦](/zh-hant/tutorials/robot-arms/so-arm101/lerobot-7dof/01-Environment-Setup/Windows)
  - [MAC電腦](/zh-hant/tutorials/robot-arms/so-arm101/lerobot-7dof/01-Environment-Setup/MacOS)
- **2. 替換文件（適配7DOF）**
  - [替換文件（適配7DOF）](/zh-hant/tutorials/robot-arms/so-arm101/lerobot-7dof/02-Replace-Files-7DOF)
- **3. 查看串列埠編號**
  - [Ubuntu](/zh-hant/tutorials/robot-arms/so-arm101/lerobot-7dof/03-Serial-Port/Ubuntu)
  - [Windows電腦](/zh-hant/tutorials/robot-arms/so-arm101/lerobot-7dof/03-Serial-Port/Windows)
  - [MAC電腦](/zh-hant/tutorials/robot-arms/so-arm101/lerobot-7dof/03-Serial-Port/MacOS)
- **4. 校準機械臂**
  - [Ubuntu電腦](/zh-hant/tutorials/robot-arms/so-arm101/lerobot-7dof/04-Calibration/Ubuntu)
  - [Windows電腦](/zh-hant/tutorials/robot-arms/so-arm101/lerobot-7dof/04-Calibration/Windows)
  - [Mac電腦](/zh-hant/tutorials/robot-arms/so-arm101/lerobot-7dof/04-Calibration/MacOS)
- **5. 遙操作**
  - [Ubuntu電腦](/zh-hant/tutorials/robot-arms/so-arm101/lerobot-7dof/05-Teleoperation/Ubuntu)
  - [Windows電腦](/zh-hant/tutorials/robot-arms/so-arm101/lerobot-7dof/05-Teleoperation/Windows)
  - [Mac電腦](/zh-hant/tutorials/robot-arms/so-arm101/lerobot-7dof/05-Teleoperation/MacOS)
- **6. 連接攝像頭的遙操作**
  - [Ubuntu電腦](/zh-hant/tutorials/robot-arms/so-arm101/lerobot-7dof/06-Camera-Teleoperation/Ubuntu)
  - [Windows電腦](/zh-hant/tutorials/robot-arms/so-arm101/lerobot-7dof/06-Camera-Teleoperation/Windows)
  - [Mac電腦](/zh-hant/tutorials/robot-arms/so-arm101/lerobot-7dof/06-Camera-Teleoperation/MacOS)
- **7. 採集數據集(實機)**
  - [回看、回放數據集](/zh-hant/tutorials/robot-arms/so-arm101/lerobot-7dof/07-Data-Collection/Browse-and-Replay)
  - [採集數據集注意事項](/zh-hant/tutorials/robot-arms/so-arm101/lerobot-7dof/07-Data-Collection/Collection-Notes)
  - [註冊Hugging Face賬號（可選）](/zh-hant/tutorials/robot-arms/so-arm101/lerobot-7dof/07-Data-Collection/HF-Account)
  - [上傳數據集到HuggingFace（可選）](/zh-hant/tutorials/robot-arms/so-arm101/lerobot-7dof/07-Data-Collection/HF-Dataset-Upload)
  - [示教採集數據集-握手200](/zh-hant/tutorials/robot-arms/so-arm101/lerobot-7dof/07-Data-Collection/Teaching-and-Recording-Handshake-200)
  - [示教採集數據集](/zh-hant/tutorials/robot-arms/so-arm101/lerobot-7dof/07-Data-Collection/Teaching-and-Recording)
- **8. 訓練模型**
  - [雲GPU訓練環境配置](/zh-hant/tutorials/robot-arms/so-arm101/lerobot-7dof/08-Training/Cloud-GPU)
  - [訓練命令行-ACT（推薦入門）](/zh-hant/tutorials/robot-arms/so-arm101/lerobot-7dof/08-Training/Command-ACT)
  - [訓練命令行-Diffusion](/zh-hant/tutorials/robot-arms/so-arm101/lerobot-7dof/08-Training/Command-Diffusion)
  - [訓練命令行-pi0.5](/zh-hant/tutorials/robot-arms/so-arm101/lerobot-7dof/08-Training/Command-pi0.5)
  - [訓練命令行-pi0（效果最好）](/zh-hant/tutorials/robot-arms/so-arm101/lerobot-7dof/08-Training/Command-pi0)
  - [訓練命令行-pi0fast](/zh-hant/tutorials/robot-arms/so-arm101/lerobot-7dof/08-Training/Command-pi0fast)
  - [訓練命令行-smolvla（推薦進階）](/zh-hant/tutorials/robot-arms/so-arm101/lerobot-7dof/08-Training/Command-smolvla)
  - [上傳模型到HuggingFace（可選）](/zh-hant/tutorials/robot-arms/so-arm101/lerobot-7dof/08-Training/HF-Model-Upload)
  - [LeRobot支持的模仿學習算法](/zh-hant/tutorials/robot-arms/so-arm101/lerobot-7dof/08-Training/Imitation-Learning-Algorithms)
  - [本地Ubuntu訓練](/zh-hant/tutorials/robot-arms/so-arm101/lerobot-7dof/08-Training/Local-Ubuntu)
  - [獲得模型權重文件](/zh-hant/tutorials/robot-arms/so-arm101/lerobot-7dof/08-Training/Model-Weights)
  - [訓練參數建議](/zh-hant/tutorials/robot-arms/so-arm101/lerobot-7dof/08-Training/Training-Parameter-Tips)
  - [wandb查看實時訓練曲線](/zh-hant/tutorials/robot-arms/so-arm101/lerobot-7dof/08-Training/WandB-Curves)
- **9. 模型推論**
  - [命令行說明](/zh-hant/tutorials/robot-arms/so-arm101/lerobot-7dof/09-Inference/CLI-Reference)
  - [推理命令行-ACT](/zh-hant/tutorials/robot-arms/so-arm101/lerobot-7dof/09-Inference/Command-ACT)
  - [推理命令行-Diffusion](/zh-hant/tutorials/robot-arms/so-arm101/lerobot-7dof/09-Inference/Command-Diffusion)
  - [推理命令行-pi0.5](/zh-hant/tutorials/robot-arms/so-arm101/lerobot-7dof/09-Inference/Command-pi0.5)
  - [推理命令行-pi0](/zh-hant/tutorials/robot-arms/so-arm101/lerobot-7dof/09-Inference/Command-pi0)
  - [推理命令行-smolvla](/zh-hant/tutorials/robot-arms/so-arm101/lerobot-7dof/09-Inference/Command-smolvla)
  - [常見Bug及解決](/zh-hant/tutorials/robot-arms/so-arm101/lerobot-7dof/09-Inference/Common-Bugs)
  - [英偉達DGX Spark推理](/zh-hant/tutorials/robot-arms/so-arm101/lerobot-7dof/09-Inference/DGX-Spark)
  - [地瓜機器人 RDK S100推理](/zh-hant/tutorials/robot-arms/so-arm101/lerobot-7dof/09-Inference/RDK-S100)

### Jetson AGX Orin 開發套件

- [快速開始](/zh-hant/tutorials/jetson-agx-orin/quick-start)
- [刷機與更新](/zh-hant/tutorials/jetson-agx-orin/flashing-and-updates)
- [驗證你的系統](/zh-hant/tutorials/jetson-agx-orin/verify-your-system)
- [接口與硬件佈局](/zh-hant/tutorials/jetson-agx-orin/interfaces)
- [產品概述](/zh-hant/tutorials/jetson-agx-orin/overview)
- [本地 LLM 推論](/zh-hant/tutorials/jetson-agx-orin/local-llm)
- [智能體 AI (NemoClaw)](/zh-hant/tutorials/jetson-agx-orin/agentic-ai)
- [DeepStream 視頻分析](/zh-hant/tutorials/jetson-agx-orin/deepstream)
- [機器人(現狀)](/zh-hant/tutorials/jetson-agx-orin/robotics)
- [記憶體效率](/zh-hant/tutorials/jetson-agx-orin/memory-efficiency)
- [從 JetPack 6.x 遷移](/zh-hant/tutorials/jetson-agx-orin/jetpack-6-to-7)
- [下載](/zh-hant/tutorials/jetson-agx-orin/downloads)
- [常見問題 FAQ](/zh-hant/tutorials/jetson-agx-orin/faq)
- [故障排除](/zh-hant/tutorials/jetson-agx-orin/troubleshooting)
- [術語表](/zh-hant/tutorials/jetson-agx-orin/glossary)
- [更新日誌](/zh-hant/tutorials/jetson-agx-orin/changelog)
- [XLeRobot Docker — 01 · 總覽](/zh-hant/tutorials/jetson-agx-orin/xlerobot-docker/deployment/01-Overview)
- [XLeRobot Docker — 02 · 環境準備](/zh-hant/tutorials/jetson-agx-orin/xlerobot-docker/deployment/02-Environment-Setup)
- [XLeRobot Docker — 03 · 部署](/zh-hant/tutorials/jetson-agx-orin/xlerobot-docker/deployment/03-Deployment)
- [XLeRobot Docker — 原版 LeRobot 執行指令](/zh-hant/tutorials/jetson-agx-orin/xlerobot-docker/lerobot/01-Operation)
- [XLeRobot Docker — XLeRobot 執行指令](/zh-hant/tutorials/jetson-agx-orin/xlerobot-docker/xlerobot/01-Operation)
- [XLeRobot Docker — 常見問題與速查](/zh-hant/tutorials/jetson-agx-orin/xlerobot-docker/troubleshooting/01-Troubleshooting)

### Jetson Orin Nano 開發套件

- [快速開始](/zh-hant/tutorials/jetson-orin-nano/quick-start)
- [刷機與更新](/zh-hant/tutorials/jetson-orin-nano/flashing-and-updates)
- [驗證你的系統](/zh-hant/tutorials/jetson-orin-nano/verify-your-system)
- [接口與硬件佈局](/zh-hant/tutorials/jetson-orin-nano/interfaces)
- [產品概述](/zh-hant/tutorials/jetson-orin-nano/overview)
- [本地 LLM 推論](/zh-hant/tutorials/jetson-orin-nano/local-llm)
- [智能體 AI (NemoClaw)](/zh-hant/tutorials/jetson-orin-nano/agentic-ai)
- [DeepStream 視頻分析](/zh-hant/tutorials/jetson-orin-nano/deepstream)
- [機器人(現狀)](/zh-hant/tutorials/jetson-orin-nano/robotics)
- [記憶體效率](/zh-hant/tutorials/jetson-orin-nano/memory-efficiency)
- [從 JetPack 6.x 遷移](/zh-hant/tutorials/jetson-orin-nano/jetpack-6-to-7)
- [下載](/zh-hant/tutorials/jetson-orin-nano/downloads)
- [常見問題 FAQ](/zh-hant/tutorials/jetson-orin-nano/faq)
- [故障排除](/zh-hant/tutorials/jetson-orin-nano/troubleshooting)
- [術語表](/zh-hant/tutorials/jetson-orin-nano/glossary)
- [更新日誌](/zh-hant/tutorials/jetson-orin-nano/changelog)
- [XLeRobot Docker — 01 · 總覽](/zh-hant/tutorials/jetson-orin-nano/xlerobot-docker/deployment/01-Overview)
- [XLeRobot Docker — 02 · 環境準備](/zh-hant/tutorials/jetson-orin-nano/xlerobot-docker/deployment/02-Environment-Setup)
- [XLeRobot Docker — 03 · 部署](/zh-hant/tutorials/jetson-orin-nano/xlerobot-docker/deployment/03-Deployment)
- [XLeRobot Docker — 原版 LeRobot 執行指令](/zh-hant/tutorials/jetson-orin-nano/xlerobot-docker/lerobot/01-Operation)
- [XLeRobot Docker — XLeRobot 執行指令](/zh-hant/tutorials/jetson-orin-nano/xlerobot-docker/xlerobot/01-Operation)
- [XLeRobot Docker — 常見問題與速查](/zh-hant/tutorials/jetson-orin-nano/xlerobot-docker/troubleshooting/01-Troubleshooting)

### 學習資源

- [學習資源首頁](/zh-hant/tutorials/learning-resources/)
- [Jetson Orin PyTorch 相容性](/zh-hant/tutorials/learning-resources/jetson-orin-pytorch-compatibility)

### 機械臂
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
