Juxi-Technology/wiki-documents/docs/content/tutorials/accessories/index.md

---
title: Robot Accessories
description: "Juxi Technology accessories tutorial home — KWS voice, ESP32-NanoCam, Feetech servos, cameras"
---

# Robot Accessories

Welcome to the robot accessory tutorials! Here you'll find guides for various robot accessories and peripherals.

---

## Product List

- [USB Auto-Focus Camera](./usb-auto-focus-camera.md)
- [Jetson CSI Camera](./jetson-csi-camera.md)
- [2-DOF Camera Gimbal](/tutorials/accessories/2dof-camera-gimbal/)
  - [Quick Start Guide](/tutorials/accessories/2dof-camera-gimbal/01-Quick-Start-Guide)
  - [Hardware and Environment Setup](/tutorials/accessories/2dof-camera-gimbal/02-Hardware-and-Environment-Setup)
  - [Basic Usage](/tutorials/accessories/2dof-camera-gimbal/03-Basic-Usage)
  - [Advanced Features and Tracking](/tutorials/accessories/2dof-camera-gimbal/04-Advanced-Features-and-Tracking)
  - [Troubleshooting](/tutorials/accessories/2dof-camera-gimbal/05-Troubleshooting)
  - [Product Info](/tutorials/accessories/2dof-camera-gimbal/Product-Info)
- [Heart Rate & SpO2 Sensor](./heart-rate-spo2/index.md)

### KWS Speech Recognition Module

AI wake-up sound card, supporting offline voice wake-up, custom wake-up words, and low-power operation.

- [KWS Speech Recognition Module Home](./KWS-speech-recognition-module/index.md)
- [Jetson Nano Serial Communication](./KWS-speech-recognition-module/Jetson-Nano-serial-communication.md)
- [Jetson Serial Communication](./KWS-speech-recognition-module/Jetson-serial-communication.md)
- [PC Serial Communication](./KWS-speech-recognition-module/PC-serial-communication.md)
- [ROS2 RViz2 Visualization](./KWS-speech-recognition-module/ROS2-rviz2-visualization.md)
- [Chinese and English Recognition Word Firmware Download and Burn](./KWS-speech-recognition-module/download-and-burn-firmware-for-chinese-and-english-recognition-words.md)
- [Raspberry Pi Serial Communication](./KWS-speech-recognition-module/raspberry-pi-serial-communication.md)

### ESP32-NanoCam Video Module

ESP32-S3 video streaming and AI vision module, supporting 8 AI modes, AP+STA dual-mode streaming and voice interaction.

- [ESP32-NanoCam Tutorial](./esp32-nanocam/)
- [Quick Start](./esp32-nanocam/ESP32-NanoCam-Quick-Start.md)
- [Hardware Spec](./esp32-nanocam/ESP32-NanoCam-Hardware-Spec.md)
- [Serial Protocol Manual](./esp32-nanocam/ESP32-NanoCam-Serial-Protocol.md)
- [Code Downloads](./esp32-nanocam/ESP32-NanoCam-Code-Downloads.md)
- [AI Vision Tutorial Chapter 1: Environment Setup](./esp32-nanocam/Ch01-Environment-Setup.md)

#### AI Vision Tutorial (11 chapters)
- [Chapter 3: Camera Basics](./esp32-nanocam/Ch03-Camera-Basics.md)
- [Chapter 4: Face Detection](./esp32-nanocam/Ch04-Face-Detection.md)
- [Chapter 5: Cat Face Detection](./esp32-nanocam/Ch05-Cat-Face-Detection.md)
- [Chapter 6: Color Recognition](./esp32-nanocam/Ch06-Color-Recognition.md)
- [Chapter 7: QR Code Scanning](./esp32-nanocam/Ch07-QR-Code-Scanning.md)
- [Chapter 8: Face Recognition](./esp32-nanocam/Ch08-Face-Recognition.md)
- [Chapter 9: Voice Chat](./esp32-nanocam/Ch09-Voice-Chat.md)
- [Chapter 10: AI Vision Understanding](./esp32-nanocam/Ch10-AI-Vision-Understanding.md)
- [Chapter 11: ESP-Claw Voice Control](./esp32-nanocam/Ch11-ESP-Claw-Voice-Control.md)

### CSI Camera Tutorials

Complete guides for Jetson / Raspberry Pi CSI cameras, auto-focus cameras, JetCam and Jupyter Lab.

- [Jetson CSI Camera Setup](./csi-camera/01-Jetson-CSI-Setup.md)
- [Auto-Focus Camera Usage](./csi-camera/02-Auto-Focus-Camera.md)
- [Using JupyterLab](./csi-camera/03-JupyterLab.md)
- [Using JetCam](./csi-camera/04-JetCam.md)
- [IMX219 on Raspberry Pi](./csi-camera/05-IMX219-RaspberryPi.md)

### AI Voice Interaction Module

CI1302 offline voice module tutorials: quick start, firmware flashing, wake-word/command editing, protocol manuals, and multi-board communication (serial + IIC).

- [Quick Start](./ai-voice-module/Quick-Start.md)
- [Product Info](./ai-voice-module/Product-Info.md)
- [Firmware Flashing](./ai-voice-module/Firmware-Flashing.md)
- [Wake Word & Command Editing](./ai-voice-module/Wake-Word-Commands-Edit.md)
- [Custom Protocol Entries](./ai-voice-module/Custom-Protocol-Entries.md)
- [ROS1 Voice Interaction](./ai-voice-module/ROS1-Voice-Interaction.md)
- [ROS2 Voice Interaction](./ai-voice-module/ROS2-Voice-Interaction.md)
- [Serial Protocol](./ai-voice-module/Serial-Protocol.md)
- [IIC Protocol](./ai-voice-module/IIC-Protocol.md)
- [PC Communication](./ai-voice-module/PC-Communication.md)
- [Arduino: Serial](./ai-voice-module/Arduino-Serial-Communication.md)
- [Arduino: IIC](./ai-voice-module/Arduino-IIC-Communication.md)
- [Jetson: Serial](./ai-voice-module/Jetson-Serial-Communication.md)
- [Jetson: IIC](./ai-voice-module/Jetson-IIC-Communication.md)
- [RDK: Serial](./ai-voice-module/RDK-Serial-Communication.md)
- [RDK: IIC](./ai-voice-module/RDK-IIC-Communication.md)
- [Raspberry Pi: Serial](./ai-voice-module/RaspberryPi-Serial-Communication.md)
- [Raspberry Pi: IIC](./ai-voice-module/RaspberryPi-IIC-Communication.md)

### Other Accessories

- [0.91 OLED Screen Tutorial](./0.91-oled-screen-tutorial.md)
- [4K HDMI Capture Card Tutorial](./4k-hdmi-capture-tutorial.md)
- [KVM Switcher Tutorial](./kvm-switch-tutorial.md)
- [KVM Switch · Tutorial Overview](./kvm-switch/00-Overview-and-Quick-Start.md),- [01 · Switching Between Two Computers (Button & IR Remote)](./kvm-switch/01-Switching-Between-Two-Computers.md),- [02 · HUB Function (One to Three)](./kvm-switch/02-HUB-Function-One-to-Three.md),- [03 · Bluetooth](./kvm-switch/03-Bluetooth.md),- [04 · TTL Serial Port (Wireless Serial)](./kvm-switch/04-TTL-Serial-Port.md),- [05 · 10-Pin Expansion Header](./kvm-switch/05-10-Pin-Expansion-Header.md),- [06 · Headless Host (Capture Card + OBS)](./kvm-switch/06-Headless-Host-Capture-Card-and-OBS.md),- [07 · FAQ and Precautions](./kvm-switch/07-FAQ-and-Precautions.md)
- [USB Sound Card Tutorial](./usb-audio-card-tutorial.md)

---

#### Feetech Servos
- [STS3215 & SCS0009 Tutorial](./feetech/Feetech-STS3215&SCS0009-Tutorial.md)
- [SCS Communication Protocol](./feetech/Feetech-SCS_Communication_Protocol.md)
- [Magnetic Encoder STS Servo Memory Table](./feetech/Feetech-Magnetic_Encoder_STS_Servo-Memory_Table_Analysis.md)
- [Potentiometer SCSCL Servo Memory Table](./feetech/Feetech-Potentiometer_SCSCL_Servo-Memory_Table_Analysis.md)
- [SCS0009 Servo Debug Tool Tutorial](./feetech/SCS0009-Debug-Tool.md)
- [Feetech Bus Servo Web Debugger (SCS0009 / STS3215 / HD1910)](./feetech/Feetech-Web-Debugger.md)

## Technical Support

If you have any questions, please contact:

- 📧 Email: support@juxitech.com
- 💬 GitHub Issues: [Feedback](https://github.com/Juxi-Technology/wiki-documents/issues)
