Juxi-Technology/wiki-documents/docs/content/tutorials/sensors/index.md

---
title: Sensors and Perception
description: "Juxi Technology sensors tutorial home — IMU inertial modules and GPS & BeiDou positioning"
---

# Sensors and Perception

Welcome to the sensor and perception tutorials! Here you'll find guides for various sensors and perception modules.

---

## Product List

### IMU Inertial Navigation Module

High-precision 6/9/10-axis inertial measurement unit, built-in sensor fusion algorithm, providing stable real-time attitude data.

- [IMU Module Home](./imu/index.md)
- [IMU Product Info](./imu/product-info.md)
- [Web Host Console](./imu/web-host-console.md)
- [MicroDuck Integration](./imu/microduck-integration.md)
- [ROS1 Example](./imu/ros-examples/ros1.md)
- [ROS2 Example](./imu/ros-examples/ros2.md)
- [Multi-Board Example](./imu/multi-board-examples/overview.md)

#### IMU Inertial Module
- [IMU Calibration](./imu/calibration.md)
- [Remote File Transfer](./imu/remote-file-transfer.md)
- [SSH File Transfer](./imu/ssh-file-transfer.md)

#### Multi-Board Examples
- [PC Communication](./imu/multi-board-examples/pc-communication.md)

#### I2C Communication
- [Arduino](./imu/multi-board-examples/i2c-communication/arduino.md)
- [Jetson Series](./imu/multi-board-examples/i2c-communication/jetson.md)
- [Raspberry Pi 5](./imu/multi-board-examples/i2c-communication/raspberry-pi.md)
- [RDK Series](./imu/multi-board-examples/i2c-communication/rdk.md)
- [STM32 F103C8T6](./imu/multi-board-examples/i2c-communication/stm32.md)
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
