Juxi-Technology/wiki-documents/docs/content/tutorials/robot-arms/amazing-hand/AmazingHand-TTL-Debugging.md

# Page moved

This page has moved to [SCS0009 Servo Debugging and Calibration](06-servo-tuning/scs0009.md).
