Juxi-Technology/wiki-documents/docs/content/es/tutorials/jetson-agx-orin/troubleshooting.md

---
title: Solución de problemas
sidebar_label: Solución de problemas
slug: /support/troubleshooting
description: >-
  Solución de problemas guiada por síntomas para el kit de desarrollo
  Jetson AGX Orin — arranque y pantalla, alimentación, flasheo y problemas
  conocidos, con base en la documentación oficial de NVIDIA.
applies_to:
  product: NVIDIA Jetson AGX Orin Developer Kit (64GB)
  jetpack: "7.2.1"
status: draft
hardware_verified: false
verified_against:
  - source: https://docs.nvidia.com/jetson/agx-orin-devkit/user-guide/latest/quick_start.html
    checked: 2026-09-23
  - source: https://docs.nvidia.com/jetson/agx-orin-devkit/user-guide/latest/setup_bsp.html
    checked: 2026-09-23
  - source: https://docs.nvidia.com/jetson/archives/r39.2/ReleaseNotes/Jetson_Linux_Release_Notes_r39.2.pdf
    checked: 2026-09-23
review_owner: cheny
---
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
