Juxi-Technology/wiki-documents/(commit log)

2026-05-26 修改公司名称：钜犀科技，完善样式和多语言
2026-05-28 更新文档网站：添加多语言支持、技术专题和产品教程
2026-05-28 添加 GitHub Pages 自动部署工作流
2026-05-28 修复构建脚本名称
2026-05-28 添加忽略死链接配置
2026-05-29 优化Wiki平台：新增教程分类、侧边栏可收缩展开、新增KWS语音识别模块等
2026-06-05 Add Feetech servo tutorials, Lekiwi tutorials, Lark Wiki page, and update navigation
2026-06-17 创建项目进度表并更新SO-ARM101教程图片（移除视频大文件）
2026-06-17 更新所有教程的图片：AmazingHand、Lekiwi、KWS模块、USB声卡三个语言版本都已更新，统一使用public/images下的相对路径
2026-06-17 更新SO-ARM101的三个教程三个语言版本的图片链接
2026-06-17 修复教程中的转义字符问题
2026-06-17 升级 GitHub Actions Node.js 版本到 22
2026-06-17 修复教程图片路径，使用 /images/ 绝对路径
2026-06-17 升级 GitHub Actions 的 checkout 和 setup-node 版本
2026-06-17 升级到 Node.js 24，移除 npm 缓存
2026-06-17 恢复 GitHub Actions 到能正常工作的配置（Node.js 20）
2026-06-17 修复所有教程的图片路径，现在本地构建成功了！
2026-06-18 添加 Lekiwi 的教程到中文、英文、繁体的侧边栏和教程首页中，并修复图片路径
2026-06-18 调整 IMU 教程的图片目录结构
2026-06-25 添加百度网站验证 meta 标签
2026-08-01 chore: init git baseline
    内容副本基线提交(来自 7 月 9 日快照),配置侧(.vitepress/.github)缺失待重建。
2026-08-01 chore: 内部文件移出 docs/ 到项目根
    - docs/superpowers/ → superpowers/(计划与设计文档)
    - docs/test.md → test.md
    - docs/tutorials/so-arm101/(占位目录) → archive/so-arm101-drafts/
2026-08-01 docs: 补建三语缺失页面
    - en/zh-HK learning-resources/jetson-orin-pytorch-compatibility.md(翻译自 zh)
    - en/zh-HK community/contributing.md(翻译自 zh)
2026-08-01 feat: 重建 VitePress 配置(三语 nav/sidebar + SEO + base)
    - config.ts:三语 locale(nav/sidebar 各语言独立)、SEO head 元标签、base=/wiki-documents/
    - srcExclude 排除 public 下占位 md、test.md、superpowers 残留
    - 构建通过:208 页,og:title/flexsearch/giscus 检查通过
2026-08-01 feat: 主题基础文件(theme/index.ts + style.css)
    - 品牌辅助色 --vp-c-brand-soft/mute
    - 导航/侧边栏背景改 CSS 变量适配暗色
    - 导航高度 56px(覆盖 --vp-nav-height)
    - 合并 public/style.css 的 logo 尺寸规则
    - Layout.vue 最小骨架(阶段 7 填充)
2026-08-01 feat: 搜索 + 评论 + 布局组件(SearchModal/PageComments/Layout)
    - search.data.ts:createContentLoader 构建期搜索索引
    - SearchModal.vue:flexsearch 弹窗(/ 快捷键、键盘导航、三语提示)
    - PageComments.vue:Giscus 评论(占位符 ID,未配置零渲染,index.md 默认关闭)
    - Layout.vue:DefaultTheme.Layout + nav-bar-content-after/page-bottom slots
    - 构建通过:flexsearch/giscus 注入 theme chunk,页面无 giscus 脚本
2026-08-01 feat: GitHub Actions 部署 workflow + PR 模板
    - deploy.yml:checkout → node 20 → npm ci → docs:build → touch .nojekyll → pages
    - PULL_REQUEST_TEMPLATE.md:变更类型/截图/测试/AI 辅助声明
2026-08-01 fix: 三语首页原生 HTML 链接 withBase 修复
    - <a href> 和 <img src> 改为 :href/:src withBase 绑定
    - 构建产物验证:href/src 均带 /wiki-documents/ 前缀
    - 修复 base 子路径下部署后首页卡片/图片 404 问题
2026-08-01 chore: 构建验证通过,配置重建完成
    - 构建:208 页全部渲染
    - SEO:三语 og:title 注入
    - 搜索:flexsearch 注入 theme chunk
    - 评论:占位符未配置,giscus 零渲染
    - 幽灵页:test/superpowers/public 占位 md 全部排除
    - 预览:首页/en/zh-HK/贡献指南均 200
2026-08-01 chore: 修正残留文件暂存 + .gitignore 补充
    磁盘上 root 所有的 docs/superpowers、docs/test.md、docs/tutorials/so-arm101
    残留目录被 git add -A 误暂存,已取消并加入 .gitignore(待 sudo 物理清理)
2026-08-01 chore: 保留 docs/superpowers 与 docs/tutorials/so-arm101,删除 test.md
    - docs/superpowers/(计划文档)与 docs/tutorials/so-arm101/(占位目录)回到 docs/ 并重新纳入 git
    - docs/test.md 从索引移除(用户已删除,物理残留由 .gitignore 兜底)
    - 根目录副本(superpowers/、test.md、archive/)清理
    - srcExclude 更新:superpowers/、test.md、tutorials/so-arm101/ 构建排除
    - 构建验证:206 页,无 so-arm101/superpowers/test 幽灵页
2026-08-01 feat(seo): 添加 sitemap.xml + robots.txt
    - sitemap:205 条 URL(cleanUrls 格式)
    - robots:允许全站 + 指向 sitemap
2026-08-01 feat(geo): 添加 llms.txt 内容索引(AI 爬虫)
    - 167 条三语页面索引(标题 + URL + 摘要)
    - 为 AI 搜索引擎提供机器可读的全站内容清单
2026-08-01 feat(seo): 批量补 frontmatter description + 修复 meta 覆盖
    - 144 个教程文件补充 frontmatter(title + description)
    - 161 个 description 统一 YAML 引号(修复冒号/列表解析错误)
    - 修复 locale head 中 description meta 覆盖页面级 description 的问题
    - 构建验证:教程页有独立 meta description,首页回退全局
2026-08-01 feat(seo): JSON-LD 结构化数据(transformHead 动态注入)
    - 首页 Organization(名称/logo/联系邮箱)
    - 教程页 Article(headline/description/URL/publisher/inLanguage)
    - 校验:3 个页面 JSON-LD 语法正确
2026-08-01 feat(analytics): 注入百度统计(占位 ID + localhost 保护)
    - globalHead 注入百度统计脚本
    - localhost 环境自动跳过(开发不产生脏数据)
    - 替换 YOUR_BAIDU_ID 为真实统计 ID 后生效
2026-08-01 revert: 移除 Giscus 评论功能(暂不注册启用)
    - 删除 PageComments.vue 组件
    - Layout.vue 移除 #page-bottom slot 注入
    - 构建验证:giscus 产物归零,flexsearch 搜索保留
2026-08-01 feat: 教程页购买入口组件(PurchaseLinks)
    - 教程页正文上方显示购买提示条(淘宝店 + 官网)
    - 三语文案(zh-CN/en/zh-HK)
    - 首页与各 section 首页自动隐藏
    - 构建验证:三语渲染正确
2026-08-01 feat: 首页产品系列区(三语)
    - 首页新增产品区:机械臂/传感器/配件卡片
    - 链接到各教程首页,带 withBase
    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
2026-08-01 feat: 下载中心聚合页(三语 + nav/sidebar)
    - docs/downloads/:固件/SDK/上位机/开源仓库集中下载
    - 三语 nav 加'下载'入口,sidebar 加分组
    - 构建验证:三语下载页 + nav 入口正常
2026-08-01 feat: 机械臂选型对比表(三语)
    - SO-ARM101 vs AmazingHand vs Lekiwi 对比(类型/自由度/控制/场景)
    - 选型建议 + 组合推荐
    - 三语 sidebar 机械臂分组加入口
2026-08-01 feat: 域名统一 wiki.juxitech.com
    - base 从 /wiki-documents/ 改为 /(自定义域名根路径)
    - canonical/og/JSON-LD/sitemap/llms/robots 域名全部替换
    - 创建 CNAME(部署时 GitHub Pages 读取)
    - README 三语链接更新
    - 构建验证:链接/canonical/JSON-LD/sitemap 均指向新域名
2026-08-01 feat: About 页(公司/核心技术/开源承诺/生态/招聘)
    - 基于 Shopify 官网真实素材(深圳前海/具身智能/开源承诺)
    - 三语 nav+sidebar 加入口
    - 构建验证:三语 About 页正常
2026-08-01 feat: 成功案例用真实社区证言填充(三语)
    - 替换旧占位页(Unsplash 假图 + 虚构案例 + 死链)
    - 3 条真实证言:HKUST 机器人研究者/边缘 AI 开发者/欧洲实验室
    - 死链清零,加入'分享你的案例'CTA
2026-08-01 feat: 社区页清理占位 + 真实渠道汇总
    - 移除 Discord 假链接/虚构贡献者 A/B/C/死链
    - 新增社区渠道表(GitHub/Lark/B站/商城/邮箱),即时社群标记'即将开放'
    - 三语同步,构建通过
2026-08-01 feat: 更新日志页(三语 + nav/sidebar 入口)
    - 记录 2026-08-01 站点建设里程碑
    - 计划中事项预告(社群/翻译/优化/AI 问答)
2026-08-01 feat: 购买链接按产品映射 Shopify 商品页
    - PRODUCT_MAP:教程路径 → Shopify 商品页(14 个产品)
    - 淘宝店链接改为官方商城(Shopify)
    - 三语验证:SO-ARM101/AmazingHand/IMU/KWS/2dof 映射正确
2026-08-01 feat: 购买链接按 Wiki 语言跳转对应 Shopify 三语页面
    - zh-CN → /zh-hans/,zh-HK → /zh-hant/,en → 无前缀
    - 商品页 + 官网首页均按语言跳转
    - 验证:SO-ARM101/AmazingHand/IMU/KWS 三语映射正确
2026-08-01 feat: 站内官网入口链接三语同步
    - 首页/About/社区/下载中心/topics 的官网链接按语言加前缀
    zh→/zh-hans,zh-HK→/zh-hant,en→无前缀
    - 教程页'技术支持'区官网链接保持无前缀(联系信息性质)
    - 验证:9 个页面三语跳转全部正确
2026-08-01 feat: 移动端适配(搜索弹窗/按钮/表格)
    - 搜索弹窗 max-width: calc(100vw - 32px) 防溢出
    - 搜索按钮 <768px 压缩为图标,隐藏 / 提示
    - 表格 <768px 横向滚动兜底(选型表/对比表)
    - 移动端验证:viewport/汉堡菜单/侧边栏抽屉/产品区正常
2026-08-21 fix: 搜索排除冗余副本(transform 过滤)+ 移动端 Safari 验证
    - search.data.ts:glob 否定模式不生效,改用 transform 阶段 EXCLUDED_URLS 过滤
    - config.ts srcExclude:排除 4 个 so-arm101-tutorial 冗余副本
    - Safari iPhone 375px 实测:首页/教程页/搜索弹窗/购买条正常
    - 搜索'机械臂'只返回合法结果,冗余副本清零
2026-08-22 docs: P0 内容四篇(Jetson Kit/RealSense/IMU校准/FAQ,三语)
    - products/jetson-orin-nx-super-kit:117/157 TOPS 边缘 AI 平台,规格/套件变体/版本对比
    - products/realsense-depth-camera:D435i/D405/D405CB 三型号对比与 LeRobot 集成
    - tutorials/sensors/imu/calibration:整体/磁力计/温度校准,串口+I2C 双模式
    - tutorials/faq:全产品常见问题合集
    - 全部三语(zh/en/zh-HK),sidebar 入口 + sitemap/llms 同步(225 条/195 行)
    - 构建验证:12 页全部渲染
2026-08-22 docs: 移除 RealSense 页中国大陆发票/包邮内容(三语)
2026-08-22 docs: P1/P2 内容六篇(舵机驱动板/GPS/ESP32/夹爪/视觉套件/ROS入门,三语)
    - 舵机驱动板:253 舵机单总线,7-12.6V,SO-ARM 2 分钟安装
    - GPS/北斗:ATGM336H-5N,四系统,2.5m,ROS 集成
    - ESP32-S3:200 万像素,AP/STA 图传,AI 识别
    - TPU 柔性夹爪:软材质安全抓取,相机套件可选
    - 机械臂视觉套件:腕部/侧方/俯视,ACT/Pi0/GR00T 兼容
    - ROS 入门:环境安装/话题服务/IMU 与 SO-ARM 实践
    - 全部三语,sitemap/llms 同步,构建 18 页验证通过
2026-08-22 docs: industry 行业知识库三篇(JetPack/边缘AI/具身智能,三语)
    - JetPack 刷机与系统配置:SDK Manager/官方镜像双方式,排错清单
    - 边缘 AI 部署入门:PyTorch→ONNX→TensorRT 全路径,性能清单
    - 具身智能入门(LeRobot):SO-ARM101 采集/训练/评估全流程,ACT/扩散/Pi0 选型
    - 全部三语,topics sidebar 入口,sitemap 更新
    - 构建验证 9 页通过
2026-08-22 feat: 9 语适配(ja/ko/de/fr/es/it)+ 12 产品手册补全 + 内容校验
    【9 语扩展(对应 Shopify 多语言)】
    - config:6 新 locale(ja/ko/de/fr/es/it),nav/sidebar 完整
    - 每新语:首页/About/下载/products 索引/5 旗舰产品页/4 入口页
    - 购买链接自动对应 Shopify 语言前缀(/ja//ko//de/…)
    - 语言切换器 9 语验证:html lang 各正确
    【产品手册补全(19→19 三语对齐)】
    - 12 个 SKU 新增独立产品页:SO-ARM101/AmazingHand/Lekiwi/2DOF 云台/
    KWS/IMU/IMX219/Feetech/KVM/声卡/HDMI/顶置支架(三语)
    【内容校验】
    - 死链扫描:唯一死链来自已排除构建的占位目录(无效),真实死链 0
    - frontmatter:19 个缺 descriptio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
2026-08-22 feat: 6 新语核心教程同步(48 篇)+ 同步追踪机制
    - ja/ko/de/fr/es/it 各 8 篇核心教程:快速入门/硬件/软件/ROS入门/FAQ/选型/IMU校准/Jetson-PyTorch
    - 6 新语 tutorial sidebar 完善
    - 建 sync-status.md 同步状态追踪(13/82 完全同步)
    - 修复 sidebar 括号语法错误,构建 414 页通过
2026-08-22 feat: 6 新语深度教程同步 II(36 篇)
    - 组装/顶置支架/AmazingHand 控制/IMU 介绍/2DOF 云台/KVM × 6 语
    - 6 语 sidebar 补配件分组
    - 同步状态 19/82,全站 450 页
    - 构建通过
2026-08-22 fix: 6 语 sidebar 数组结构修复(引号/闭合)
2026-08-22 feat: 6 新语配件教程同步(36 篇)+ sidebar/sitemap 更新
    - 6 语同步 6 个配件教程:心率血氧/4K HDMI/声卡/OLED/CSI 相机/USB 相机
    - 图片路径修正(../../public → ../../../public,6 语多一层目录)
    - sidebar accessories 分组补齐(每语 8 项)
    - sitemap 重建(486 条),sync-status 25/82
2026-08-22 feat: Feetech/KWS/IMU 系列 6 新语同步(150 篇)+ sidebar 分组
    - Feetech 4 篇 ×6 语(协议/内存表/调试教程)
    - KWS 语音识别 6 篇 ×6 语(串口/固件/ROS2)
    - IMU 多板卡 14 篇 ×6 语(I2C/串口/ROS 示例/概览/PC)
    - sidebar 补齐 KWS/Feetech/IMU 三组(每语)
    - 图片路径修正(KWS 4 级相对路径)
    - sitemap 486→636,sync-status 50/82
2026-08-22 feat: 产品页 15 个 6 新语同步(90 篇)+ products sidebar
    - 15 产品页 ×6 语(参数化渲染,Shopify 链接按语言前缀)
    - products sidebar 补齐(每语 19 项)
    - sitemap 636→726,sync-status 65/82
2026-08-22 feat: tech/topics/learning/community 等 13 文件 6 语同步(78 篇)
    - tech API/开发指南、topics 3 篇(JetPack/边缘AI/具身智能)
    - learning-resources 3 篇、Lark Wiki、贡献指南
    - SO-ARM101 安装/兼容性、AmazingHand TTL 调试
    - sync-status 78/82
2026-08-22 feat: 最后 4 个基准教程 6 语同步——全部 82/82 完成
    - AmazingHand 官方示例(451 行)、Lekiwi 组装/教程(759 行)、SO-ARM101-Tutorial(1064 行)
    - 82 个基准文件 × 9 语全部同步完成
    - sitemap 全站覆盖
2026-08-22 fix: 补齐 ko/fr AmazingHand TTL 调试 + 全站对称校验(6 语各 89 文件)
2026-08-24 feat: 品牌文「我们为何构建开源」迁入 wiki(topics/open-source-hardware,9语)+ sidebar 入口
    来源:Shopify 博客 why-we-build(唯一无 wiki 对应的原创文章)
    - 9 语:zh/en/zh-HK(博客原有 3 语整理)+ ja/ko/de/fr/es/it 翻译
    - 9 语 sidebar topics 组加入口(fr/it 双引号包裹含撇号文案)
    - .gitignore:精确忽略 docs/node_modules symlink,替代每次提交前 unlink
2026-08-24 docs: 博客增量合并——6 处 products 页补全(zh/en/zh-HK)+ sync-status 83/83 + backlog 更新
    来源:9 篇公开博客的增量审查结论(博客=wiki 摘要版,增量并入产品页)
    - so-arm101: 规格表 +负载500g/±0.1mm/520mm/USB-C
    - amazinghand: 核心特性 +手部追踪/仿真/手指角度/5V3A 供电
    - feetech: +TTL·RS485 双通信/254 舵机/1M 波特率/多重保护
    - imu: +工作温度/抗冲击 20kg
    - kws: +100%离线/>95%准确率/300ms/100 指令/<50mA
    - usb-sound-card: +采样率 16KHz/48KHz
    - sync-status: 基准文件 83/83(topics/open-source-hardware 新基准)
    - backlog: 博客任务完成状态 + 新增第4项(6语 products 页结构不对齐,待排期)
2026-08-24 docs: sitemap 重生成(831 条,+9 个 open-source-hardware 页面)
2026-08-24 feat: products 页 6 语对齐 批 1(so-arm101/amazinghand/imu-module/usb-sound-card × 6 语)
    以 zh 完整版为源,补齐 6 语简版缺失的产品概述/核心特性/规格表全行/相关教程
2026-08-24 feat: products 页 6 语对齐 批 2(2dof-gimbal/4k-hdmi-capture/kvm-switch/overhead-camera-mount × 6 语)
2026-08-24 feat: products 页 6 语对齐 批 3(esp32-s3-wifi-module/gps-beidou-module × 6 语)
2026-08-24 feat: products 页 6 语对齐 批 4(jetson-orin-nx-super-kit × 6 语)
2026-08-24 feat: products 页 6 语对齐 批 5(imx219-csi-camera/lekiwi × 6 语)
2026-08-24 feat: products 页 6 语对齐 批 6(feetech-servo/kws-voice-module × 6 语)
2026-08-24 feat: products 页 6 语对齐 批 7(robot-vision-kit/servo-driver-board × 6 语)
2026-08-24 feat: products 页 6 语对齐 批 8(tpu-flexible-gripper/realsense-depth-camera × 6 语)
    全部 19 个产品 × 6 语对齐完成:构建通过、占位符零残留、内链 0 缺失
2026-08-25 feat: 补齐 6 语缺失的 7 个导航页(cases/changelog/robot-learning/accessories/learning-resources/robot-arms/sensors/imu-index × 6 语)
2026-08-25 fix: IMU 教程页 frontmatter/H1 修复(6 语,构建恢复到 12.64s 通过)
2026-08-25 docs: 归档 4 类孤立页到 archive/(10 个文件)
    - products/index × 6(6 语独有目录页)→ archive/products-index/
    - tutorials/so-arm101-tutorial(zh/en/zh-HK 冗余副本)→ archive/so-arm101-tutorial-{zh,en,zh-HK}.md
    - tutorials/so-arm101/index + template-tutorial(占位/模板)→ archive/so-arm101-drafts/
    - 磁盘残留(root 所有)由 srcExclude 兜底,待 sudo 清理
    - sitemap 重生成(873 条)
2026-08-25 chore: gitignore 收录磁盘残留(root 所有,待 sudo 清理,防误 add 复活)
2026-08-25 feat: 全站语言 URL 结构与 Shopify 对齐(root=en 前置)
    - 新增 srcDir: 'content' 内容树(无需变更 root 权限):en→root / zh-hans / zh-hant, 其余 6 语不变
    - config.ts: locales { root: en, 'zh-hans': zhCN, 'zh-hant': zhHK, ... } + 93 处 sidebar 前缀修正
    - 内容层:249 处语言前缀链接修正 + 909 处图片引用相对化(随 content 深度)
    - content/public → ../public symlink(public 复制回归,236MB)
    - 9 语 97/97 完全对称;构建通过;sitemap 873 条
    - .gitignore: 旧 docs/ 内容树防复活
2026-08-25 feat: 多语 SEO hreflang + 教程页购买链接(7 语 182 教程页)
    - transformHead 注入 9 语言 alternate + x-default(含 JSON-LD 合并)
    - 26 个教程 × 7 语(en/ja/ko/de/fr/es/it)头部加 Shopify 商品链接
    - 构建通过,dist 验证 hreflang/购买链接均渲染
2026-08-25 feat: 简繁购买链接接入淘宝店铺(juxitechnology.taobao.com)
    - 26 教程 × 简/繁 插入『淘宝店铺』购买块(与 7 语 Shopify 块并齐)
    - 19 products × 简/繁 购买按钮从 Shopify 换为淘宝店铺
    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
2026-08-25 fix: 简繁 products 淘宝链接残留 slug 修复(38 文件,构建验证通过)
2026-08-25 feat: 简繁 products 页升级为淘宝商品级直达链接(18 商品 × 2 语)
    - 27 个淘宝 item 链接逐一匹配(标题核对)写入 18 个产品;jetson-orin-nx-super-kit 店铺未上架,保留店铺级
    - 简体[淘宝购买]/繁体[淘寶購買],格式校验通过
2026-08-26 feat: 语言自动切换(浏览器语言 + 手选记忆,GitHub Pages 兼容)
    - theme/auto-lang-redirect.ts:仅根语言(无前缀)URL 触发,按 localStorage 偏好或 navigator.language 重定向
    - 手动点击语言切换 → 写入偏好;已带语言前缀 URL 永不跳转(SEO 安全)
    - 构建验证通过,脚本打包于 theme chunk
2026-08-27 feat: 界面完善(对照 Seeedstudio —— 6 项优化)
    - TopBanner 公告条(9 语文案,深浅色双配色)
    - LanguageSwitcher 导航外显(替换默认隐藏菜单,9 语下拉)
    - Breadcrumb 面包屑(首页 / 一级分类,9 语)
    - PrevNext 上一篇/下一篇(sidebar 序列计算,递归收集+语言前缀修正,doc-footer-before slot)
    - 品牌 404 页(简/繁/英,覆盖默认 NotFound)
    - SearchModal 支持 Ctrl/Cmd+K 快捷键与提示
    - 附带修复:zhCN 块 11 行缺 /zh-hans 前缀 + 全站双前缀清理(0 残留)
    - 构建通过(11.9s),SSR 产物逐项验证
2026-08-27 chore: gitignore .playwright-mcp/(测试截图目录)
2026-08-27 fix: LanguageSwitcher 跳转校验(Open Redirect 防护,站内相对路径白名单)
2026-08-27 fix: LanguageSwitcher 同源强校验(new URL + origin 比对,复审通过)
2026-08-27 feat: UI 验收修正(公告条占位/品牌404组件方案/安全复审项)
    - style.css: --vp-layout-top-height:36px(nav 下移,公告条不再被 fixed nav 遮挡)
    - NotFound404.vue:Layout 内 isNotFound 整页替换(9 语文案,404.html 为 CSR 骨架故采用客户端方案)
    - LanguageSwitcher: new URL+origin 同源强校验(安全复审通过)
    - 删除无效 404.md(改组件方案)
2026-08-27 chore: 清理废弃 NotFound.vue(统一 NotFound404),忽略验收截图
2026-08-28 feat: 9 语首页 hero 统一美化 + 商店按钮;修复 4 处遗留 bug
    - 首页 hero 卡片化(渐变+圆角),按钮:快速开始 + 淘宝店铺(中/繁,淘宝橙)
    + 官方商城(Shopify 绿)+ GitHub;6 语简版首页补齐样式段(原为裸样式)
    - 修复 root 首页 12 处 /en/ 前缀、zh-hant 首页 12 处 /zh-HK/ 前缀(均 404)
    - 修复 topics 两页 8 处原生 HTML 旧前缀链接 /en//zh-HK/
    - 修复 PurchaseLinks.vue:locale 判断仍是 6-lang 写法致英文页指向
    zhanzh 商店、中文页指向英文店铺、繁体页显示简体文案
    - 修复 auto-lang-redirect.ts:手选英文(pref=en)后仍被浏览器语言强制跳回,
    英文根页对中文环境用户不可达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
2026-08-28 style: 首页 hero 按钮改等宽 grid 对齐(中/繁 2×2,其余 3 列一行)
    - .hero-links 由 flex(宽度随文字)改为 grid 等宽:按钮同宽同高,
    消灭两行宽度参差与 2+1 缺角
    - 中/繁 4 按钮 → .four 2×2;英文+6 语 3 按钮 → .three 一行 3 列
    - 窄屏(<640px).three 自动降为 2 列(auto-fit minmax 150px)
2026-08-28 fix: 首页居中/导航挤占;zh-hans 首页 11 处站内链接缺 /zh-hans 前缀
    - 首页不居中:根因是空 aside 占位(hasAside 判定只认 themeConfig.aside/
    frontmatter.aside,与 outline 无关,404 之前靠 layout:home 误判) →
    9 首页加 aside: false;hero-links grid 补 margin: 0 auto 使按钮组居中
    - 导航挤占:官方 VPNavBarTranslations 类名曾写错(VPLocaleSwitcher,从未命中)
    致默认语言切换器重复;VPNavBarExtra(...)与空 VPNavBarSearch 一并隐藏;
    LanguageSwitcher 文字标签 ≤959 收成图标
    - 768-959 官方 menu 7 项必然溢出:收进汉堡;VPNavScreen 官方 ≥768 强制
    display:none 需覆盖,否则汉堡点击仅 ✕ 无菜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
2026-08-28 fix: 全站 doc 页 sidebar 缺失(zhCN sidebar keys 无前缀)+ 搜索索引/404 多处修复
    - config: zhCN 9 个 sidebar keys 补 /zh-hans 前缀(旧"简体=root"残留,
    导致所有简体文档页 sidebar 为空、内容列布局不居中)
    - 搜索: createContentLoader glob 改 **/ 覆盖 9 语言+排除 public/ 草稿
    (旧模式只搜英文 root);剔除过时 EXCLUDED_URLS(/en/、/zh-HK/)
    - SearchModal: isInLocale 按现 9 语言目录过滤;占位/无结果文案按
    zh-hans/zh-hant/其他(旧 en/zh-HK 判断失效,英文页显示中文占位)
    - NotFound404: base 原硬编码 /zh-hans/(英文/日文 404 全跳简体),
    改为按请求路径推断语言与 base;"查看全部教程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
2026-08-28 fix: 切换 English 后跳回简体(语言偏好未记录导致 auto-lang-redirect 拉回)
    - switchTo 从不写 localStorage,而 auto-lang-redirect 的 click 监听只记录
    非英文链接 → 选择 English(code='')时无任何路径把 wiki-lang 写成 'en',
    跳转到无前缀英文页后按旧偏好(如 zh-hans)立即被拉回简体
    - 修复:switchTo 里同步写入偏好(English → 'en',其余 → code)
2026-08-28 chore: 删除 public/images/tutorials 下 13 个旧版草稿 md(用户确认)
    - 均为旧单语教程草稿(无 frontmatter/旧链接),已被 content 树多语正版取代;
    曾污染搜索索引(index glob 已加 !**/public/** 排除)并冗余复制到 dist
    - 图片资源无改动(229 张 git 追踪图片完好);README.md/DIMENSIONS.md 保留
    - 所有权:docs/public 已 chown 归位(271 个 root 文件 → 用户)
2026-08-28 fix: 语言菜单从按钮滑向列表时被 mouseleave 误关(悬停空窗桥接)
    - 列表 top: calc(100% + 6px),按钮与列表间 6px 悬停间隙无归属,
    鼠标经过时触发 .lang-switcher 的 mouseleave → 列表在到达前关闭
    - 修复:伪元素::after 高度 12px 把缝隙(6px gap + 列表顶部重叠 6px)
    收入 switcher 悬停区,鼠标路径全程有归属
    - Playwright 鼠标逐点移动验证:缝隙后列表仍 9 项保留;
    移出区域正常收起;点击语言项跳转正常
2026-08-28 fix: 商店链接按 wiki 语言显式对应 9 语言(原仅中/繁,其余落 root 被 302)
    - 实测 juxitech.com root 按访客浏览器语言 302(zh-TW→/zh-hant、en→不动),
    非中/繁页面指向无前缀 root 会跳到"浏览器语言"而非 wiki 页面语言
    - index.md storeUrl 与 PurchaseLinks localePrefix 均改为 8 语显式
    (en root 保留无前缀:Shopify 英文=root,/en/ 为 404)
    - 顺手修复 config.ts 重复 srcDir 键(疑似上次迁移留痕)
    - 都验过 /ja/ /ko/ /de/ /fr/ /es/ /it/ 及各自商品路径返回 200
    - 修语法:md script setup 与 PurchaseLinks.vue(非 lang=ts)去掉 TS 注解
2026-08-28 fix: 暗色开关与语言切换按钮 0 间距叠边,resize 时相互覆盖
    - .nav-right 无 margin 且可被 flex 压缩,与官方 VPNavBarAppearance 紧贴
    - 修复:margin-left: 12px 呼吸间距 + flex-shrink: 0 防挤压重叠
    - 档位验证:1419(间隙12px)/1300/1024(官方自动收起暗色开关)/
    966(菜单+语言+搜索全可见无覆盖)
2026-08-29 feat: 品牌页脚(9 语)+ hero 渐变标题 + 分区标题装饰线;修复 9 首页 CSS 游离文本
    - SiteFooter(layout-bottom):品牌标语 + 文档/社区/支持 三组链接 + 版权行,
    9 语本地化;移除 config 默认 footer 避免双版权行
    - 首页 hero 副标题改为绿→青渐变(bgclip),h2 分区标题加渐变短横线
    - Bug:6 语首页首轮样式端 BEAUTIFY 拼在 </style> 之外、本轮 DECO 追加又复现,
    导致所有 9 个首页渲染出裸露 CSS 文本(如 de 页底部整段 .hero-btn 规则);
    已将各文件游离段全部归位,并写全站体检脚本确认 0 游离
    - 对照 wiki.seeedstudio.com 设计语言(大标题/品牌渐变/card 卡片/三栏页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
2026-08-29 fix: 固定 sidebar 面板遮挡全宽页脚左侧列
    - site-footer 背景为全宽,有 sidebar 页面其左侧落在 fixed 侧栏面板
    之下,品牌标语列被白色底板遮盖(如 zh-hans/about/)
    - 修复:≥960px 时 body:has(.VPDoc.has-sidebar) .site-footer
    margin-left: var(--vp-sidebar-width),页脚跟随内容列避让
2026-08-29 chore: 移除 changelog(不再公开)
    - config: 删除 3 语 nav 条(更新日志/Changelog/更新日誌)与 sidebar 分组
    - 内容: 删除 9 语言 changelog/index.md(git rm)
    - Breadcrumb: 删除 changelog 路径映射
    - sitemap.xml: 删除 9 条 changelog URL(静态清单,873→864)
    - 验证: dist 无 changelog 页/sitemap 0 引用;/zh-hans/changelog/ 404
2026-08-29 chore: 移除误提交的 seeed 参考截图并忽略该类文件
2026-08-29 feat: sitemap 改 VitePress 内置自动生成(弃手工静态清单)
    - 验证发现 VitePress 1.6 内置 sitemap 生成(@experimental,config.sitemap),
    零依赖;config 配置 hostname 后构建自动产出 sitemap.xml
    - 删除 public/sitemap.xml(手工维护 873 条,changelog 等增删需手动同步)
    - 自动清单 864 条与手工清单一致(无偏差);附 9 语 hreflang alternate,
    且删除页面(如 changelog)后构建自动除名
    - 注意构建须用线上 hostname 输出,这是部署侧无额外步骤的静态产出
2026-08-29 fix: 滚动后导航未贴顶--公告条滚出后残留 36px 顶部空隙
    - VPNav sticky top: var(--vp-layout-top-height),banner 在文档流中滚出后
    变量仍为 36px → 导航悬停在 36px,顶部空隙且滚动内容从缝隙穿过
    - 修复:scroll-top-offset.ts 监听滚动,scrollY>36 时变量清零(nav 贴顶),
    回顶恢复 36px(banner 置顶);注意 SSR typeof window 守卫
    - 实测:y=500 → --vp-layout-top-height=0px, navTop=0;回顶 → 36px/0/36
2026-08-29 fix: 导航贴顶过渡阶跃改为连续函数(滚动时平滑升至顶端)
    - 原实现 scrolled ? 0 : 36 为阶跃:越过 36px 阈值时导航瞬间上跳
    - 改为 offset = max(0, 36 - scrollY):y 0→36 期间导航与公告条联动
    线性上升(y=12→24px / y=24→12px / y=35→1px),与 sticky 锁定值无缝衔接
    - 采样验证:navTop 36/24/12/1/0/0/0 全程连续
2026-08-29 chore: about 页官方话述改为政府口径(用户提供)
    - 中:依托香港、服务内地、面向世界(zh 平/繁)
    - 英:With Hong Kong · For the Mainland · To the World(en+6 语引用)
    - 原 "Leverage HK, serve mainland, go global" 为企业黑话直译腔,
    非官方话述;官网 meta description 用户改在 Shopify 后台同步更新
    - 修复替换时误吞的粗体闭合(**)
2026-08-31 fix: 窄窗口公告条留白/宽度错位--官方移动端 VPNav 非 fixed 所致
    - 官方 VPNav 仅 ≥960 fixed;<960 为 relative+top:var →
    ① 滚动后导航随文档流走(无置顶)② top:36 与 banner 之间空 36px
    ③ banner 行盒基线致容器高度漂移到 51px(与占位 36 错位)
    - 修复:VPNav 全断点 fixed + top 跟随 --vp-layout-top-height
    (scroll-top-offset.ts 已联动连续调整);
    banner 锁高 36px(overflow:hidden+box-sizing)消除行盒漂移
    - 实测 500/860/1196:顶部 banner0+nav36(gap=0)、滚动 nav0(贴顶)
2026-08-31 chore: about 页定位话述与官网 Shopify 宣传语对齐
    - 官方:"Juxi Technology, based in Qianhai Shenzhen, follows
    "With Hong Kong · For the Mainland · To the World". We develop physical AI,
    embodied robotics and edge AI, delivering open-source solutions..."
    - 9 语 about 首段同步(中/繁保留政府中文标语,余 6 语引用英文标语),
    内容三领域统一为 physical AI / 具身机器人与边缘 AI + 开源解决方案
    - 顺带修复 zh-hant 首段混用简体字(智能硬件->硬體、通过->透過)
2026-08-31 fix: 页脚 9 语链接双前缀(zh-hans/zh-hans/...)导致 About 等 404
    - withBase 实现:path 不以 "/" 开头时原样返回(相对 URL),
    页脚 pref='zh-hans/' 拼出 'zh-hans/about/' -> 浏览器在当前页
    /zh-hans/ 下解析成 /zh-hans/zh-hans/about/ -> 404
    - 修复:pref 全部带前导斜杠(/zh-hans/、/zh-hant/、各语目录、en → /)
    - 全站巡检:withBase 字面量均带斜杠无同类问题;
    sitemap 864 URL 并发检查仅剩 &amp; 解码假阳性(真 URL 全 200)
2026-08-31 chore: 同步依赖锁到 vitepress 1.6.4(CI 部署前准备)
    - 根 package-lock.json 原锁 1.4.x,本地工作于 1.6.4(内置 sitemap 等)
    → GitHub Actions npm ci 会装 1.4 导致部署产物缺 sitemap.xml
    - 同步 lock + package.json(^1.6.4 / vue ^3.5),与 node_modules 一致
2026-09-01 fix: <960px 文档页 Menu/On this page 本地导航被 fixed 导航裁切,补回流位并对齐吸附基准
    官方 <960 布局里 VPNav 用 relative 占文档流,localNav(sticky top:0)依托它排位;
    将 nav 强制为 fixed 后流内缺失 nav 高度,localNav 上移钻进 nav 底下被裁上半。
    - margin-top: var(--vp-nav-height) 补回流位,未滚动时从 nav 底边(92px)完整显示
    - sticky 吸附基准从视口顶改为 nav 底边(calc(layout-top-height + nav-height)),
    滚动后贴住固定 nav,不再被覆盖
    已验证 850/375/1160 三档宽度 × 未滚/滚动,zh-hans/en 与教程页均无重叠
2026-09-01 fix: 本地导航顶部空带与首页 Return to top 偏移两处残局
    - .VPLocalNav padding-top 清 0:官方该内边距为 sticky 吸附预留 banner 高度,
    nav 固定顶部后顶部态它表现为 Menu 行上方 36px 真实空白带;清空后
    Menu 行全程紧贴导航底(滚动后 var 归零本为 0,无回归)
    - .VPLocalNav.fixed margin-top:0:空态(首页滚动后 Return to top 条)转
    position:fixed 后 top 与 margin-top 叠加 56+56=112px 偏移,
    fixed 不占流无需补位
2026-09-01 feat: 首页 hero 改版,参考 Seeed Studio Wiki 布局(左文右巨型品牌字)
    - 结构升级:hero 全宽冲破 vp-doc 限宽,左列(大标题+渐变副标题+描述+按钮一排)
    右列(Wiki 渐变巨字 + JUXI TECHNOLOGY 大字)
    - 恢复主标题显示(早前 vp-doc h1 display:none 隐藏)
    - 主按钮改品牌绿大胶囊,副按钮增大圆角 999
    - 全站隐藏标题锚点 # 符号(h1 特例常显,遮挡视觉;原生锚点跳转不受影响)
    - 9 语首页同步,桌面/平板/手机三档响应式验证,浅色/深色双模式通过
2026-09-01 feat: hero 移动端重排(参考 Seeed 手机版)+ 补全 9 语公司介绍段
    - 移动端(≤767):巨型品牌字置顶 → JUXI TECHNOLOGY → 标题 → 副标题 → 介绍 → 按钮;
    左对齐、主按钮整行,其余两枚一行
    - hero 描述升级为完整公司介绍(依托香港/前海+物理 AI 生态),9 语与 about 页文案一致
    - 桌面/手机/深色双模式三档验证通过
2026-09-01 fix: hero 按钮 1×4/2×2 等宽网格 + Wiki 字体换圆润几何字
    - 根因:hero-brand flex 1 1 42% 与主列争夺 grow,左列被压窄致按钮单列;
    brand 改 0 0 42% 固定宽度,左列恢复宽度
    - 按钮按语言数等宽网格:zh 四枚 1×4(手机 2×2),其余 3 枚 1×3;nowrap 防断行
    - brand 字换 Avenir Next/Century Gothic 圆润几何字体栈,单行化(letter-spacing 0.1em)
2026-09-01 style: 品牌字换正式系统字体栈(Wiki/JUXI TECHNOLOGY 简洁大气)
    - Wiki:Avenir 圆润字体 → -apple-system/Segoe UI/Helvetica Neue 中性栈,800 重
    - JUXI TECHNOLOGY:700 重 + 0.16em 宽字距单行,正式标识感
    - 9 语同步
2026-09-02 fix: 首页卡片网格统一(最新文档与分类区同列数规则)
    card-grid 原 minmax(280px) 导致桌面/平板 2×2,与分类区的
    minmax(240px) 列数不一致;统一为 240px,三区域卡片同尺寸同间距
2026-09-02 feat: 新增 9 语产品中心索引页(products/ 曾 404)
    原 products/ 仅含 19 个产品页,无 index.md 路由导致 404;
    自动生成 9 语索引(标题+简介卡片网格,素材来自各语言产品
    frontmatter),并全站核验页脚/导航 30 条路由 × 9 语均无 404
2026-09-02 fix: 全站 FAQ Q/A 分行显示(96 文件空行分隔)
    FAQ 标记行与答案间缺空行,markdown 单换行被合并同一段渲染成
    一行;全站扫描 products/tutorials/topics 共 96 个文件补齐空行
2026-09-02 feat: FAQ 答案前加 A: 标记(与 Q 对称,全站 9 语)
    - 每个 Q 后的答案段前缀 **A:**,排版与 Q 对称
    - 列表/表格型答案拆为 A: 标记+内容独立成段(10 文件修正防渲染破坏)
2026-09-02 fix: AmazingHand 更正为 4 指仿生手(全站 9 语 + 侧边栏)
    用户核实产品事实:AmazingHand 为 4 指仿生手,此前后台文案
    写作 5 指多关节灵巧手。全站 35 个 md 文件 + config.ts 侧边栏
    (9 语)一并改正,保留教程内'右/左灵巧手'部件名
2026-09-02 fix: AmazingHand 名称用回灵巧手(保留 4 指事实修正)
    用户确认类目名称沿用'灵巧手':'4 指仿生手'→'4 指灵巧手'
    (34 md + config 侧边栏 9 语),'5 指多关节'→'4 指'的事实修正保留
2026-09-04 fix: 9 语站完整性整改(导航对齐/搜索正文/FAQ 补齐/教程图片回填/仓库清理)
    - 修复 package-lock 与 package.json 不同步(flexsearch/@vueuse14 缺失,
    npm ci 本地与 CI 一直失败),依赖恢复安装
    - 6 小语种 sidebar 对齐中英文:tutorials 42→61 链接、topics 2→6、tech 1→3、
    community 1→2,新增 cases sidebar;9 语 nav 统一 8 项(补 Products/Cases)
    - 清除 6 语 products sidebar 各 14 行重复项(曾导致 PrevNext 序列错乱)
    - 搜索索引升级为正文级(render html 提取纯文本)+ CJK 单字/双字分词,
    中文可搜;搜索占位/无结果文案补齐 6 语
    - FAQ 补齐 6 语各 23 组问答(原 5 组),结构对齐英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
2026-09-04 fix: 小语种 3 教程补全为英文完整版(文本+图片)+ 回补英文漏译节
    6 语(ja/ko/de/fr/es/it)的 SO-ARM101 组装、AmazingHand 官方示例、
    Lekiwi 教程原为机翻删减版(文本精简、部分图片丢失),重写为与
    英文金标准等价:
    - 恢复全部图片引用(5/33/21 张,文件名与顺序同英文,
    路径统一 4 层),补齐删减文本(LEEPROM 说明/校准/遥操作/评估等节)
    - 代码块与英文逐字节一致;frontmatter 保留各语 title
    - 一致性:图片数/标题序列/代码块均与英文核对通过,构建成功
    同时回补英文版漏译的一节(9 语对齐):Lekiwi "### 7 设置连接时间"
    (config_lekiwi.py connection_time_s,英文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
2026-09-04 feat: 英文独有 3 小节补入 6 语(Windows 上位机/ROS2 仿真/网页设 ID,含图 26-29)
    SO-ARM101-Tutorial 英文版末尾的 Windows 查舵机(Feetech 上位机)、
    ROS2 仿真控制、网页设置舵机 ID 与中位校准 3 节此前仅英文存在,
    现补齐 ja/ko/de/fr/es/it,含 4 张截图(26-29.png);
    9 语教程图数一致(29/29),全站链接校验与生产构建通过
2026-09-04 feat: 首页/文档页交互升级(对标 Seeed wiki,P1+P2)
    P1 通用质感:
    - 卡片 hover 力反馈(上浮+阴影+缩略图缩放)
    - 区块滚动渐入(逐帧视口检测,兼容快速滚动/锚点跳转;reduced-motion 停用)
    - 文档页顶部阅读进度条(随滚动推进,首页隐藏)
    - 正文图片灯箱(点击放大,←/→ 切换,ESC/遮罩关闭,alt 显示)
    P2 结构补强:
    - 首页"最新文档"组件化(HomeLatestDocs):分类筛选行(全部/机械臂/
    传感器/配件)、卡片分类标签与最后更新日期(git 时间,CI 配 fetch-depth: 0);
    6 小语种首页首次获得该区块
    - 首页"参与与支持"社区区块(CommunityStrip,9 语):贡献指南/GitHub/Bilibili/邮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
2026-09-04 fix: 补交首页交互组件源文件(上轮 add -u 漏了新建文件)
    3285b4a 提交时仅暂存了修改文件,HomeLatestDocs.vue/CommunityStrip.vue/
    effects.ts/home.data.ts 四个新建文件未入库——main 构建会因组件缺失失败。
    本提交补齐,与 3285b4a 合并后构建完整。
2026-09-04 feat: 正文图片懒加载(SSR 注入 loading="lazy",仅 config.ts 单文件)
    markdown 渲染阶段给所有正文图片注入 loading="lazy" + decoding="async,
    教程页(如 SO-ARM101 29 图/7.3MB)视口外图片滚动到才下载,首屏更快;
    不改任何内容与图片文件。回退:git revert 本提交即可。
2026-09-04 feat: SEO/GEO 技术底子(大图压缩/alt 补全/schema 增强/hreflang 修复/llms 自动化)
    任务 1 大图压缩:Lekiwi-Assembly 全部 22 张 PNG 转 JPEG q88
    (约 130MB → 4.2MB,单张 19MB→0.18MB),该页流量约 200MB → 8MB;
    引用同步改 .jpg,全站链接校验通过
    任务 2 图片 alt:全站 244 文件 2115 处 alt 由 "Image" 补为
    "小节标题 - 序号" 语义描述(Google Images 可见性 + a11y)
    任务 3 结构化数据:
    - FAQ 页 → FAQPage JSON-LD(构建期解析 9 语 FAQ Q/A,每语 20-22 问)
    - 全站面包屑 BreadcrumbList(URL 段生成,首页除外)
    - Organization 补 sameAs(GitHub/B站/官网)
    - 未注 SearchAction(站内搜索无独立 URL,注了反而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
2026-09-05 feat: 产品分类体系——侧边栏按产品属性分 4 组 + 全站 category 字段
    19 个产品按属性分 4 组(9 语同步):
    - 机器人(7):SO-ARM101 套件/视觉套件/TPU 夹爪/顶置支架/舵机驱动板/AmazingHand/Lekiwi
    - 计算与视觉(4):Jetson Orin NX Super/RealSense/IMX219 CSI/ESP32-S3 视频模块
    - 传感器(2):IMU/GPS & 北斗
    - 配件(6):2-DOF 云台/KWS/Feetech/KVM/USB 声卡/4K HDMI
    - products 侧边栏从 20 项平铺改为分组嵌套(各语组名本地化)
    - 171 个产品页(19 产品 × 9 语)frontmatter 加 category
    (枚举:robot/compute-vision/sensor/accessory,机器读取用,前端组名翻译)
    - 验证:构建通过、852 sidebar+873 正文链接全绿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
2026-09-05 feat: 教程页"相关产品"互链块 + 修复 fr 缺 KWS 侧边栏项
    - 新增 RelatedProducts 组件(9 语产品名/标题字典,卡片式,复用全局 hover 动效)
    - 4 个旗舰教程 × 9 语 共 36 文件页尾插入相关产品块:
    SO-ARM101 教程(开发套件/视觉套件/TPU 夹爪)、组装(开发套件/驱动板/顶置支架)、
    AmazingHand 示例(灵巧手/驱动板)、Lekiwi 教程(机器人/开发套件/驱动板)
    → 教程与站内产品页形成双向互链(hub-spoke),权重与用户路径双受益
    - fr 语言 products 侧边栏补回 KWS 语音交互模块(文件一直在,仅漏链;
    现 fr 与其余 8 语同为 19 项)
    - 验证:构建通过、链接全绿、浏览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
2026-09-05 feat: 搜索索引收录产品页(products/ 曾不在检索范围)
    search.data.ts 的 glob 补 '**/products/**/*.md'——此前搜"SO-ARM101"
    只能出教程,搜不到产品页;现生产构建实测搜索返回产品页(开发套件/
    视觉套件/TPU 夹爪/顶置支架),发现路径补齐
    另:launch.json 增加 docs:preview 配置(生产构建验收用,port 4173)
2026-09-05 fix: 代码审查修复——canonical 全站指向首页(重灾 SEO)+ 面包屑链接错算
    - canonical:globalHead 里固定指向 https://wiki.juxitech.com/(首页),
    导致所有页面声明 canonical=首页,Google 会把全站视为首页重复、
    非首页收录降权;改为 transformHead 逐页生成(与 hreflang 同源 URL
    推导,404 不注入)。构建实测:教程/FAQ/产品页/各语首页 canonical
    均指向自身
    - Breadcrumb.vue:一级目录链接此前算成 /zh-hans(丢目录段),点击
    面包屑"教程"会跳中间死路径;修正为 /zh-hans/tutorials(带语言前缀)
    - home.data.ts 性能:873 次逐文件 git log(fork 进程,拖慢构建 ~6s)
    → 单次 git log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
2026-09-05 fix: 审查收尾 4 项(页脚本地化/购买文案 6 语/分类枚举统一/搜索正文命中)
    1. SiteFooter 链接文字 9 语本地化(此前 9 语页脚链接固定英文)
    2. PurchaseLinks 购买条文案补 6 语(ja/ko/de/fr/es/it)
    3. HomeLatestDocs 卡片分类枚举对齐产品页 category
    (arm → robot,现全站统一 robot/compute-vision/sensor/accessory)
    4a. 搜索分字段查询:标题优先、正文补全、去重——修复 flexsearch
    Document.search 按字段分组返回而旧代码只取 [0](title 组),
    正文命中(text 组)一直被丢弃;"Magnitude 30841"(仅 FAQ 正文)
    此前搜不到,现正确返回 FAQ
    4b. scroll-top-offset 加 rAF 节流(高频率 scrol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
2026-09-06 fix: 深度审查第 3 轮——9 语内容对称化 + SEO/meta 修复(20+ 项,139 文件)
    代码层:
    - 面包屑 JSON-LD 语言化 + item 补语言前缀(此前 zh 等页面 item 指向无前缀 en URL);
    Article inLanguage 错标 zh-CN 一并修复(PageData 无 lang 字段,改由 relativePath 推导)
    - 404 页跳过 hreflang(与 canonical 同步);新增 favicon(logo png)
    - 购买条收敛到 tutorials/products 栏目,无产品映射时不再显示误导性"购买此产品"
    - 首页 .reveal 渐入加 html.js-anim 门控(无 JS 时内容直接可见)
    - FAQPage JSON-LD 答案清洗为纯文本(去列表记号/链接语法)
    - en/zh 侧边栏补 IMU calibration 项(对齐 7 语)
    内容层(9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
2026-09-06 chore: 遗留项清理——死依赖移除/search 收录 downloads/llms.txt 修复扩容
    - 移除顶层 @vueuse/integrations(全库无引用;VitePress 自身传递依赖不受影响)
    - 搜索索引收录 downloads/ 与 about/ 栏目(downloads 页本轮扩至 65 行后检索价值明确;
    transform 顺带清理未使用的 description 字段)
    - llms.txt:修复 5 个失效旧链接(so-arm101-tutorial 旧路径 → 现行教程页)、
    删除模板占位条目,产品收录从 7 个补全到 19 个 × 3 语言区块
    (描述取自各语产品页 frontmatter);总链接 235 条本地核验 0 失效
    验证:build 17.2s、搜索实测"下载中心"命中 /zh-hans/downloads/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
2026-09-06 docs: README 扩展至 9 语 + issue 模板 + 徽章/部署说明
    - 新建 6 语 README(ja/ko/de/fr/es/it),与英文版同构(71 行 × 7 节),
    与既有 3 语 README 形成 9 语互链(每文件指向其余 8 语言,不含自链)
    - 官网链接按 Shopify 语言尾缀(zh-hans/zh-hant/ja/ko/de/fr/es/it,
    en 保持 root),读者直达对应语言商店页,避免 root 的浏览器语言 302
    - 全部 README 增补：徽章 4 枚(Deploy/9 Languages/LLM ready/VitePress，
    href 指向有效目标)、Deployment 小节(CNAME/DNS/fetch-depth/CI 检查)、
    贡献指南链接指向本语言 wiki 贡献页
    - 新增 .github/ISSUE_TEMPLATE：文档问题/内容建议(双语表单)+ config.yml
    Co-Au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
2026-09-06 feat: Hugging Face 组织页全站接入(社区条/页脚/README 9 语/about/community/sameAs)
    - 社区条 CommunityStrip 与页脚 SiteFooter:GitHub 旁并列 Hugging Face 链接
    - README 9 语联系区:新增 GitHub 组织 + Hugging Face 两行(位于官网之后)
    - about 9 语:开源资源段落(与 GitHub 并列)+ 联系区新增 Hugging Face 行
    - community 9 语:渠道表新增 Hugging Face 行(模型/数据集/开源权重)
    - Organization JSON-LD sameAs 增加 HF 组织页(SEO 实体对齐)
    验证:check-links 全绿、build 17.2s、dist 确认链接与 sameAs 输出正确
2026-09-06 chore: 仓库卫生——llms-full.txt 生成物移出 git + .gitignore 死路径清理
    - docs/public/llms-full.txt(3.5MB,gen:llms 生成物)移出 git 跟踪:
    每次内容变更不再膨胀仓库历史(当前 pack 已 220MB);CI 构建前
    由 gen:llms 重新生成,部署产物不受影响;工作树文件保留
    - .gitignore:删除 8 行已不存在的"磁盘残留"死路径;新增
    llms-full.txt 忽略规则;保留旧内容树防御条目(作者有意)
    - README 9 语构建小节补充 gen:llms 命令与说明
2026-09-06 feat: Article JSON-LD 补充 dateModified(git 最后修改时间)
    从 pageData.lastUpdated(毫秒,getGitTimestamp 返回 +new Date)生成
    ISO8601;文章页结构化数据现包含修改日期,利于搜索/知识图谱新鲜度判定。
    FAQ/首页走各自 schema 分支,不注入。
    验证:build 17.5s,输出 2026-09-06 日期正确
2026-09-08 feat: 新增葡萄牙语双变体(pt-BR/pt-PT)——第 10/11 种语言
    - config.ts:locale 拆 'pt-br'(lang pt-BR)/'pt-pt'(lang pt-PT),nav/sidebar 葡语
    全量翻译;hreflang 增 pt-BR/pt-PT 双 alternate;LANG_CODE/LANG_SEGS/PREFIX 同步
    - 内容:97 文件 × 2(4 并行 agent 从 en 翻译 pt-BR;pt-PT 由 pt-BR 词汇表转换,
    欧洲葡语差异词 câmera→câmara、usuário→utilizador、arquivo→ficheiro、
    tela→ecrã、gerúndio→a+infinitivo 等)
    - 组件 11 个:双 pt 文案与目录前缀(/pt-br/, /pt-pt/);语言切换器 11 项;
    auto-lang-redirect 按浏览器语言 pt-BR→pt-br、其余 pt-*→pt-pt
    - Shopify 映射(用户确认:商店仅有 pt,实为巴西):购买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
2026-09-08 fix: Shopify 语言映射按实际语言站修正(pt-br→pt,pt-pt→en)
    用户确认 Shopify 仅有 pt(巴西):wiki /pt-br/ 购买链接 → juxitech.com/pt/,
    wiki /pt-pt/ → juxitech.com/(英文店 root)。修正:
    - PurchaseLinks:pt-br 映射 'pt/',pt-pt 映射 ''(root)
    - 内容 12+12 文件店铺链接:pt-br 树 pt-br→pt,pt-pt 树 pt-pt→root
    - 首页 storeUrl / README_pt-BR / README_pt-PT 同步
    验证:build 22.4s,dist 实测 pt-br 教程页 → juxitech.com/pt/products/...,
    pt-pt → juxitech.com/products/...
2026-09-08 fix: pt-pt 残留巴葡词汇清理 + 11 语语言数同步 + 多语首页 JSON-LD 类型修正
    - pt-pt 内容 74 处巴葡→欧葡词汇替换(tela→ecrã 含阴阳性修正、
    arquivo→ficheiro、registro→registo、baixar→descarregar、salvar→guardar、
    celular→telemóvel、usuário→utilizador、senha→palavra-passe、gerenciamento→gestão);
    config.ts pt-pt 区块 2 处同步
    - 11 个 community/contributing.md 语言数 9/10→11,目录列表补 pt-br/pt-pt
    - JSON-LD:修复 isHome 仅匹配 root index.md 的 bug——10 个多语首页此前误注
    Article(现统一 Organization),目录 index 页不再误判为首页
    - config.ts 注释 9→11 语言
    验证:构建通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
2026-09-08 fix: 11 个 README 徽章 alt 对齐 11 语 + pt-br 变体纯化(guarde→salve)
    - README*.md 徽章 alt 文本 9/10 Languages→11 Languages(与 badge 参数 11 locales 一致)
    - pt-br 2 处 'Guarde o nome...' → 'Salve o nome...'(巴葡保存惯用 salvar;
    pt-pt 保留 guardar 为欧葡正确形式)
    验证:全页断言 0 错误(11 Org/11 FAQ/1045 Article)、sitemap 1067、
    11 语拓扑一致、pt 双变体词汇双向 0 残留
2026-09-08 fix: BreadcrumbList 最后一项对齐页面 canonical(尾斜杠)
    - buildBreadcrumbLd 最后一项改用传入页面 URL(保留尾斜杠):
    index 页 canonical '/about/' 此前面包屑写 '/about'(两者是不同 URL,
    且面包屑最后一项应等于页面 URL)
    - 值级验证脚本:canonical 提取需 html.unescape(JSON-LD & // HTML &amp; 属
    不同编码上下文的等价表示,非错误)
    验证:F 值级 1067 页 0 错误;A canonical/hreflang 回归 0 错误;
    check:links 全绿;构建 22.6s
2026-09-10 fix: 全盘内容审查——en 缺失译文补齐 + 6 语言漏翻修复 + zh-hant 简繁混杂清理
    - en/tutorials/sensors/imu/ros-examples/ros1.md+ros2.md:整个文件此前仍为中文
    (各语言均已翻译,唯独源语言漏翻),现补全英文译文;代码块/飞书链接保持原样
    - de/fr/es/it/ja/ko 六语言:3 个产品页(快速上手步骤)与 6 个 IMU 教程
    (MobaXterm 段落)的漏翻中文补齐为各语言译文(90 处)
    - ja:SO-ARM101-Tutorial 中文句式残留修正(参考公式教程/本教程/教程用词→
    公式チュートリアル/本チュートリアル/チュートリアル,11 处)+ config sidebar 同步
    - zh-hant 简繁混杂修复:SO-ARM101-Assembly(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
2026-09-10 fix: 内容完整性深查——跨语言结构对等修复(标题 18→0,图片 7→0)
    - ja/it/de/ko/fr/es:topics/robot-learning 补缺失三节
    (Verwandte Tutorials / 贡献征集 / 技术支持——此前 6 语言均缺)
    - de/ja/ko/fr/es/it + en/zh-hant/pt-br/pt-pt:imu/index 补齐
    "官方仓库示例"节(zh-hans 独有的 3 小节结构:ROS1/ROS2 示例 + Python 校准工具)
    - en/zh-hant/pt-br/pt-pt:0.91-oled 补"官方仓库示例"节(I2C 驱动示例)
    - ko:kvm-switch-tutorial 补回 12 张图(全站唯一缺图语言)
    - it/fr:select-guide 补齐 3 个选型建议小节(并修正 AmazingHand "5指"事实错误→4指)
    - zh-hans/zh-hant:jetson-orin 兼容页问题段升级为 ##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
2026-09-10 fix: 坏链与内容修复——GitHub 组织名 404(17处)+ ja 缺失命令块 + 引号精确性
    - 全库 16 处 github.com/JuxiTechnology/(组织不存在,API 404)→ Juxi-Technology/;
    zh-hant AmazingHand-Interface-Control 的 JuxiTechnology/AmazingHandControl
    → Betatester777/AmazingHandControl(与其余 10 语言一致,上游仓库)
    (经 api.github.com 对照验证:orgs/Juxi-Technology=200, orgs/JuxiTechnology=404)
    - ja SO-ARM101-Tutorial 补 6 个缺失命令块:Pi0.5 章节(pip/训练/验证 3 块,
    此前为简版文字)+ F4 conda 初始化 3 块(此前只有截图);
    ja 其余差异为新版 LeRobot CLI 写法(hf auth/lerobot-record --replay),保持
    - en SO-ARM101-Tutorial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
2026-09-10 feat(seo): Open Graph 重构为页面级 + 拉丁语系全角标点清理
    - og 重构:此前 og:title/og:description 是每语言静态站点值(1067 页分享卡片
    完全相同)且 og:url/og:locale 全缺。现改为 transformHead 页面级注入:
    og:title 逐页(复刻 VitePress <title> 规则:frontmatter titleTemplate 优先、
    站点同名首页不加后缀)、og:description 用页面描述、og:url=canonical、
    og:locale 按语言(zh_CN/pt_BR 等标准格式)、og:site_name 全局;404 页跳过
    验证:og:title 与 <title> 1067/1067 一致;og 五字段 0 缺失
    - 全角标点清理:de/fr/es/it/pt-br/pt-pt 正文 287 行(全角冒号/括号/分号/顿号
    →半角;E-Mail：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
2026-09-10 fix(a11y): 面包屑/语言切换器 aria-label 本地化 + markdown 细节
    - Breadcrumb aria-label 由中文硬编码改为 11 语言映射
    (de: Brotkrümelnavigation, ja: パンくずリスト 等)
    - breadcrumb 分隔符由无 href 的 <a> 改为 <span>(纯装饰语义)
    - LanguageSwitcher aria-label 由双语硬编码改为 11 语言动态
    - de imu/calibration 清理 1 处链接前导空格
    验证:构建通过;dist 断言 11 语言 aria 值正确;check:links 全绿;
    markdown 语法扫描(链接/表格结构)0 问题;frontmatter 键全部有效
    (category 为有意元数据,与 HomeLatestDocs 分类枚举对齐)
2026-09-10 fix: 语义审查批次——代码正确性/命令损坏/术语系统修复(57 文件)
    代码正确性(0.91-oled 教程,11 语言):
    - lstrip/rstrip 引号配对事故 220 处('b'' → "b'"),星号污染 190+8 处
    (*# 注释* 行级 + 行内 *#...* + shebang),return 缩进 14 处(12→8 空格,
    修 index 0-3 返回 None),ip.find 双重转义 24 处(\n → \n,修 IP 截断)
    - 11 语言 python 代码块经 ast 语法验证全部通过
    zh-hant 机械转换事故(Lekiwi-Tutorial 等 3 文件,49 处):
    - 命令损坏恢复:source ~/.bashrc、ffmpeg -encoders、conda install ffmpeg、
    which ffmpeg、conda activate lerobot、ssh pi@、File exists 报错串、INFO 日志
    - 专名恢复:Anacond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
2026-09-10 fix: 6 语言补数据采集段 + 代码块星号污染全量清理(11 语言)
    内容补齐(ja/ko/de/fr/es/it 的 SO-ARM101-Tutorial,各 +28~29 行):
    - 键盘表 ESC 行;数据采集技巧列表(任务建议/规模≥50/一致性/渐进);
    Rule of Thumb;blog 链接;箭头/ESC/resume 操作提示;pynput 降级提示
    - 各 agent 逐行比对 en 460-514,已存在译文(push_to_hub 提示等)不重复添加;
    字节级验证(URL/码点/反引号配对)
    代码块星号污染全量清理(命令复制即失败的级别):
    - Lekiwi 11 语言×9 行:mkdir *-p*、wget *-O*、conda create *-y* *-n*、
    *--robot.type*= 等 → 去星号
    - SO-ARM101 11 语言×8 行:lerobot-train 的 *--dataset.repo_i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
2026-09-10 feat: 品牌色改暗蓝海军蓝+首页元素颜色集中至全局样式
2026-09-10 feat: 公告条改淡蓝双模式(含暗色文字对比修复)
2026-09-10 feat: 11 语言首页颜色迁移至全局样式+装饰线改蓝
2026-09-10 fix: 页尾双份翻页导航删除自定义简版+11语文案本地化
2026-09-10 feat: 阅读体验包(引用块/表格表头/图片圆角/外链标记,语言标签用官方内置)
2026-09-10 feat: 微交互(分类卡hover/回顶按钮/路由淡入)
2026-09-10 fix: 移动端菜单/回顶/目录标题 11 语本地化(VitePress 默认英文 fallback)
2026-09-10 fix: 补 skipToContent/主题开关/筛选 aria 11 语本地化
2026-09-10 fix: 页尾日期格式跟随页面语言(forceLocale)+ 统一 UTC 时间
2026-09-10 fix: 页尾日期统一 24 小时制+UTC 标记移入文案(简繁同构,消除 zh-HK 方括号)
2026-09-12 chore: Cloudflare Pages 部署配置整理(wrangler.jsonc 改 Pages 版+deploy/preview 脚本修正)
2026-09-12 feat: 导航栏新增 GitHub/Hugging Face/官方商城图标(暗色开关左侧,Seeed 式布局)
2026-09-12 fix: 导航多语言溢出修复(菜单<1600收汉堡/商城按钮窄屏图标化)+商城按钮配文字+显示模式文案本地化
2026-09-12 feat: 导航重构为 3 平铺+更多下拉(菜单回归导航栏,断点降到1152;商城文字1280起显示)
2026-09-12 feat: IndexNow 收录推送(key文件+部署链自动提交,Bing/Yandex等即时收录)
2026-09-12 fix: IndexNow 403 边缘未就绪时延迟重试
2026-09-13 fix: 导航平铺断点 1152→960(996px 窗口可见完整菜单)
    - 汉堡区间收窄至 768-959;960 起菜单平铺,11 语实测最宽 ~913px(996/1100/1280 无溢出)
    - 960-1279 收紧间距:菜单项 padding 12→8、图标组 gap/margin、nav-right margin
    - 搜索按钮 <1280 压缩为纯图标(隐藏 "/" 提示、min-width 0),让出 ~80px
    - 商城标签改单词短版(Store/Boutique/Shop 等),完整名称保留在首页 hero
2026-09-14 feat: ESP32-NanoCam 图传模块与 SO-ARM 系列新资料入 wiki(11 语,20 个新页面)
    - ESP32 图传模块(现有产品页更新):NanoCam 型号名/ES8311 音频/8 种 AI 模式/规格表扩充/教程入口
    - 新教程树 tutorials/accessories/esp32-nanocam/:快速开始、硬件规格书、串口协议手册 + 11 章 AI 视觉教程
    - SO-ARM101 系列:tutorials/robot-arms/so-arm101/ 新增 无线遥操作(NanoCam 版)、无线遥操作排障、双臂(双从臂)教程、7-DOF 改造与 LeRobot、舵机校准工具
    - 配件:feetech/ 新增 SCS0009 舵机调试工具教程
    - 11 语全量翻译(220 个文件)+ 11 语 sidebar/index/购买条映射;check:links 全绿(1265 sidebar / 1287 正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
2026-09-15 fix: 全量复查修复(工具页多语言 UI 文案本地化、审计补漏、两处笔误)
    - SCS0009/校准工具页:各语言界面标签与引号内工具输出文案本地化(en 采用工具真实英文 i18n 串;it 补 12 处清单外遗漏)
    - 审计补漏(11 语):遥操作页补 EXPECTED_WIFI_SSID;校准工具页补 macOS 命令行示例;两工具页补字体默认值说明;SCS0009 页补第二端口提示
    - 修正两处笔误:zh-hans Ch03「传图传模块」→「图传模块」;zh-hant 索引「冷巧手」→「灵巧手」
    - de 硬件规格书表格单元格半句混排修正
2026-09-15 feat: CSI 摄像头 / GPS 北斗 / SO-ARM101+AmazingHand 三系列教程入 wiki(11 语,363 页)
    - 素材已含 11 语翻译,经全量体检(行数奇偶 0 偏差/代码块与中文基准一致/零中文泄漏/图片引用全解析)后集成
    - CSI 摄像头使用教程 5 页 → tutorials/accessories/csi-camera/(49 图重编号)
    - GPS 北斗定位模块教程 15 页 → tutorials/sensors/gps/(147 图)
    - SO-ARM101 + AmazingHand 教程 13 页(6 阶段 × Win/Linux + 总览)→ tutorials/robot-arms/so-arm-amazinghand/
    - 统一加工:补 frontmatter(title/description)、清飞书转义、H1 规范化、图片路径重写、分类首页与新 sidebar 组(11 语)、RelatedProducts 词典补 gps-be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
2026-09-15 feat: AI 语音交互模块 / XLeRobot 两系列教程入 wiki(11 语,275 页)
    - AI语音交互模块(CI1302,与 KWS 模块为两个独立产品):18 页 → tutorials/accessories/ai-voice-module/(快速上手/产品资料/固件烧录/唤醒词命令词/自定义词条/ROS1·ROS2/协议手册/多主控通讯 Arduino·Jetson·RDK·树莓派·PC 串口+IIC),72 图
    - XLeRobot 双臂移动机器人:7 页 → tutorials/robot-arms/xlerobot/(环境搭建 macOS/Ubuntu/Windows、文件部署、成品/散件组装),66 图
    - 素材已含 11 语翻译;体检:行数/代码块 0 偏差、图片全解析、零中文泄漏;统一补 frontmatter、清飞书转义(含 \> 等 YAML 非法转义)、H1 规范化(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
2026-09-15 feat: 产品中心补 AI 语音交互模块 / XLeRobot 两个新品页(11 语)+ 教程↔产品互链
    - products/{ai-voice-module,xlerobot} × 11 语:zh-hans/en 依素材(教程+产品资料)撰写,
    9 语译稿术语对齐各语既有教程;含概述/规格/快速开始/完整教程/应用场景/FAQ/技术支持
    - 产品中心索引卡片 × 22、products 侧边栏分组条目 × 22(机器人组: XLeRobot;配件组: AI 语音)
    - 275 个教程页补 <RelatedProducts>(AI 语音 18 页 + XLeRobot 7 页 × 11 语),
    组件 NAMES 词典补两 slug(补齐批 3 遗漏的教程→产品互链)
    - 修复 XLeRobot 教程索引页 11 语 title/H1/description(原为素材原文 "Xlerobot"/"使用教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
2026-09-15 feat: 补 USB 自动对焦摄像头产品页(11 语);新入站教程页标题统一;CSI 系列补产品互链
    - products/usb-auto-focus-camera × 11 语:依同产品教程页(规格/特性/FAQ)撰写 zh-hans/en,
    9 语译稿术语对齐各语教程;产品中心卡片 + 侧边栏「计算与视觉」组
    - 标题统一(用户要求):新入站 825 页的 title/H1 与侧边栏标签一致——
    素材痕迹型标题以标签为准(CSI/XLeRobot/AmazingHand/GPS,418 页);
    页面名更完整者以页面为准回写标签(ESP32/SO-ARM101/Feetech/AI 语音,247 处);
    矩阵页标签补全为「主控板: 完整通讯名」(72 处)
    - CSI 系列 5 页补 <RelatedProducts>:相机使用/工具页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
2026-09-15 refactor: 旧页面标题与侧边栏标签全站统一(11 语,1500+ 页)
    用户要求「旧页面也统一」:口径与新入站页面一致,以侧边栏标签为唯一命名源——
    - 产品页(19 个)反向处理:侧边栏标签升级为页面上的官方产品全名(如 IMU Module →
    IMU High-Precision Inertial Module;Feetech Bus Servos → …(SCS0009 / STS3215)),
    顺带消除 '79°' 转义标签
    - 专题文章页(开源硬件理念)保留标题句,侧边栏标签升级为标题句(11 语)
    - 其余页面(旧教程/技术/学习资源等)title+H1 := 侧边栏标签共 399 页;修掉
    旧标题里的素材痕迹(如「Lerobot机械臂组装教程」「ツリーパイ5」错字、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
2026-09-15 fix(seo): 英文等页面 <title> 去掉中文后缀 + 首页摘要含产品关键词(11 语)
    问题:VitePress 的 :siteTitle 取「各 locale 的 title」,而各语 locale 配置均未设 title,
    全部落回根配置的中文 title——因此英文/日文/德文等页面 <title> 后缀是「钜犀科技 Wiki」,
    对英文搜索不利(用户反馈"英文 wiki 搜不到")。
    - 11 个 locale 各补 title(zh-hans 钜犀科技 Wiki / zh-hant 鉅犀科技 Wiki / 其余 Juxi Technology Wiki)
    → 英文页标题变为「Products | Juxi Technology Wiki」,首页不再出现「X | X」
    - og:site_name 改为逐页按语言注入(此前全局硬编码中文);og:title 同源修正
    - 首页 meta desc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
2026-09-15 fix(content): 全站 meta 描述重写(744 条)+ 重复消重 + 附件占位链接与隐形字符清理
    - meta description 重写 744 条(11 语):原为脚本从正文截取,存在截断到词中带「…」、
    抓到步骤行/列表/命令/URL/文件名/残留符号等毛病;现按各语页面内容重写为一句摘要
    (Latin 60-160 字符 / CJK 25-90 字),同系列平台版本(OS/接口/主控板/栏目)彼此区分
    - 同语种内重复描述消重 33 组 / 162 页(写明接口、系统、栏目、支架等差异)
    - 附件占位链接 [xxx.zip] → xxx.zip(323 处;素材里丢失下载目标的附件引用,
    页面此前渲染为裸方括号);GPS AGNSS 页 22 处空链接 ]() 补上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
2026-09-15 fix(content): 8 个旧教程页的多余 H1 降级(88 文件,1452 个标题),统一为一页一个 H1
    旧批次整合时未做 H1→H2 归一,这些页面把章节标题写成了 H1(feetech×3、lekiwi×2、
    SO-ARM101-Assembly、usb-audio-card、imu/product-info),全站复扫共 88 文件受影响。
    现保留每页首个 H1(页标题),其后的标题层级整体降一级(子标题同步下移,层级关系不变)。
2026-09-16 feat: 六个素材包入站——1179 处飞书断图全部本地化 + 10 个新页(11 语)
    上轮审计发现的「全站 1179 处图片指向飞书内链、对外 400 断图」由本批素材修复:
    - **图片本地化**:0.91 寸 OLED / KVM / 4K HDMI / 飞特舵机 / IMU(16 页)/ AmazingHand 系列,
    按「素材小节号 + 图内序号 ↔ 站内 alt 的节号/序号」跨语种精确对齐,替换全部飞书引用;
    补齐 6 个语种缺失的图片引用(ja/ko/de/fr/es/it 共 36 处);全站飞书图残留 = 0
    - **下载文件托管**(public/downloads/,8 个 <25MB):飞特 4 件(STS3215/SCS009 资料 zip + 两个 step)、
    IMU 3 件(Arduino.rar/IMU_ROS2.zip/STM32.zip)、AH 1 件(FD.ra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
    [SCS009-20230110-S.stp, ST3215-20200328-to-customer.stp]
2026-09-16 fix(content): 全站复查修复——副标题转义/孤儿图/粘连 URL/描述差异化
    - 修 11 个 AH PWM 页 `**\# …**` 副标题转义(YAML 描述与正文),description 重算
    - 22 处新页伪链接 [xxx.zip] → 纯文本(指向未托管的大文件:106MB 等)
    - 修 URL 与中文粘连:AH 官方示例页 dora-rs 链接(11 语)、XLeRobot 移动文件页(2 语)
    - 手势追踪三页 description 按系统(Ubuntu/Windows/macOS)差异化 ×11 语 → 全站同语种描述重复清零
    - 清理 47 个未被任何页面引用的图片文件(编号重名的另一扩展 + 素材多余图)
    - 核验:check:links 2046/2068、frontmatter 0 错、build 50s、无行尾噪声(180=180)、
    11 语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
2026-09-16 fix(content): 描述长度统一 ≤160 + 修正截断/结尾标点等遗留(11 语)
    新一轮全局检查(新增维度:表格列数、图片 alt、站内锚点、标题/描述长度):
    - 165 条 >160 字符的描述压缩(优先句末、次分句),全站描述现均 ≤160(SERP 展示友好)
    - 27 条以「…」结尾的描述(新页集成时沿用了旧的 110 字截断规则)按新规则重算
    - 修正 135 条误加中文句号结尾的非 CJK 语种描述
    - ssh-file-transfer ×11、01-GUI-Visual-Control ×11 人工描述(原为文件名/副标题行)
    - 表格列数一致性、图片 alt 空值、站内锚点链接均 0 异常;5 个超长标题为文章标题句
    与统一后的导航名,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
2026-09-16 fix(content): 清理 tech 栏目的虚构内容 + 大图压缩(第四轮全局检查)
    - **虚构内容清理**:tech/api-reference 与 tech/dev-guide(11 语)原是占位模板,
    含不存在的 CLI(@juxi/cli / juxi init)、SDK(@juxi/sdk)与云 API
    (api.juxi-tech.com/v1,且域名非其真实 juxitech.com)——以真文档面目挂导航会误导读者,
    已替换为如实的「内容筹备中」说明 + 指向教程中心/社区(33 文件)
    - **大图压缩**:15 张 >1.2MB 转 JPEG q85;0.91 OLED 页 4894×3672 的 3.4MB 截图
    缩至 2000px → 376KB;全站现无 >1.2MB 图片(此前最大 14.6MB)
    - 图片扩展名引用同步(png→jpg,193 处);站点图片总量 159MB
    - 第四轮新增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
2026-09-16 fix(content): 删除 learning-resources 通用占位页 + 旧 URL 301 重定向
    - 删除 tutorials/{getting-started,hardware-setup,software-config} 及
    tutorials/learning-resources/ 下同名 3 页(6 路径 × 11 语 = 66 文件):
    建站脚手架遗留的空壳流程页(635–851 字节,"插 USB → npm install → npm start"),
    无工程/教程内容,且两处互为近似重复
    - config.ts 摘除对应 66 行侧边栏条目;「快速开始」「学习资源」两分组仍保留
    FAQ/ROS 入门/飞书文档 与 学习资源首页/Jetson 兼容性页
    - 新增 docs/public/_redirects:66 条 301 → 各语 /tutorials/
    (这批 URL 已经 IndexNow 推给 Bing,避免直接 404)
    - 闸门:che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
2026-09-16 feat(content): 3 个产品页补淘宝购买行(ai-voice-module / xlerobot / usb-auto-focus-camera)
    - 用户提供淘宝 item id,沿用站内既有产品页格式(H1 下方加粗引用块,33 文件)
    - URL 统一为干净形式 item.htm?id=NNNN,去掉 mi_id/skuId/spm/xxc/ns/abbucket 跟踪参数
    (与站内既有亚马逊/淘宝链接只留 id 的惯例一致)
    - 措辞:zh-hans「淘宝购买」/ zh-hant「淘寶購買」直接沿用站内既有行;
    其余 9 语用 Taobao 品牌名 + 各语既有商店行的句式(e.g. Auf Taobao kaufen)
    - 这 3 个产品在 Shopify 尚无商品页,故 11 语统一挂淘宝链接
    - 闸门:check:links 1980/2002 全绿、frontmatter 全树 0 错、build 50s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
2026-09-17 fix(content): 第五轮全局检查——修复吞字符断链 + 清理 47 张重复图 + 去 URL 跟踪参数
    - 修复 zh-hans AmazingHand-Official-Example 的断链:裸 URL 后紧跟中文,markdown-it
    自动链接把整句吞进 href(线上点开是 GitHub 404),按 zh-hant 同形补空格
    - 删除 47 张「存在仍在用的同内容副本」的重复图(9.6MB):GPS 批量入站时整份图池
    被复制进 4 个页面目录,每页只引用其中一段编号;删除前逐张 md5 校验
    - XLeRobot 散件教程淘宝链接去掉 ft/spm 跟踪参数(11 语),保留 id + skuId
    (该链接文字明确指"预组装套件",SKU 预选有意义)
    - 保留 10 张内容独有但无人引用的图(心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
2026-09-17 fix(seo): 全站 meta description 统一——262 条重写 + 284 条补引号 + 46 条欧葡改写
    第五轮全局检查的描述维度:严格校验器此前报 577 条(此前"0 问题"结论来自另一把更宽松的尺子,
    两条规则之差=强制双引号 + 精确长度带),现全站 2002 条 0 问题。
    - 长度越界 262 条重写(11 语并行代理产出、主会话统一落盘):拉丁 60–160 / CJK 25–90 字符,
    依据=摘要面板约 920px、CJK 全角字宽约为拉丁两倍;产品页保留关键指标,系列页点明版本差异
    - 284 条长度合规但未加双引号的描述补引号(与 744 条重写流水线的惯例统一,YAML 更健壮)
    - 46 条 pt-pt 描述原与 pt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
2026-09-17 feat(home): 首页三区块改版——产品系列 8 卡 / 最新文档 8 卡+视觉筛选 / 浏览分类 4 卡
    原「产品系列」与「浏览分类」是同一套 3 张卡(机械臂/传感器/配件)重复两遍,新入站的
    XLeRobot、ESP32-NanoCam 图传、AI 语音交互模块、GPS 北斗、CSI 摄像头在首页完全不可见。
    - 产品系列:3 → 8 卡,链到产品页(SO-ARM101/AmazingHand/XLeRobot/ESP32-NanoCam/
    AI 语音/IMU/GPS/CSI);新卡图取自官方 Shopify 店铺主图(自家产品照)
    - 浏览分类:改为 4 张教程枢纽卡(机械臂/移动机器人/传感器/配件),与产品系列分工明确
    - 最新文档:4 → 8 卡,新增「视觉」筛选(对应产品类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
2026-09-17 style(home): 首页卡片网格改满宽(桌面 4 列)+ XLeRobot 换官方整机渲染图
    满宽:
    - .card-grid / .category-grid 由「文档容器 688px 内」改为按视口定宽:
    --grid-w: min(1320px, 100vw - 48px),再用 margin-left 偏移居中
    (没沿用 hero 的 50vw 负 margin——50vw 把滚动条宽度也算进去,会挤出横向滚动条)
    - 列宽 240px → 260px:1320px 下正好 4 列,产品系列 8 卡 4+4、浏览分类 4 卡一行
    - 实测 1440/1000/768 三档:无横向溢出(overflow 0),列数 4/3/2,两侧留白 60/24/24px
    XLeRobot 卡片图:
    - 原先用教程里的底盘渲染图(店铺未上架、素材无整机产品照);现换为官方仓库的
    整机 3D 渲染图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
2026-09-18 feat(tutorials): SO-ARM101 新版分步课程入站(43 页 × 11 语)+ 散件组装页更新
    素材:SO-ARM101机械臂使用教程(11 语已翻译,131 张图)
    - 新增 43 页 × 11 语 = 473 页:lerobot/ 八步课程(环境安装/串口设备/校准/遥操作/
    摄像头遥操作/采集数据集/训练模型(ACT·pi0·pi0.5·pi0fast·smolvla 命令行、云GPU、
    wandb、HF 上传)/模型推理(命令行说明+常见 Bug))+ basics/(了解 LeRobot、HF 数据集、
    训练资料、官方 3D 打印文件、URDF 参考)+ ROS2 仿真控制 + 平行指夹爪安装
    - 散件组装页换新版(素材为超集):新增 3D 打印件/去支撑/四种舵机区分/两种电源适配器区分/
    飞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
    [PincOpen装配体.step]
2026-09-18 feat(products): SO-ARM101 产品页补入素材产品资料(硬件/软件/应用 + 尺寸与材质)
    - 并入素材三节:硬件设计(结构材料/驱动配置 12V 30KG 磁编码舵机/双摄视觉系统/
    USB-C 控制连接)、软件生态(LeRobot 深度适配/DORA 低延迟引擎/全链路开源)、
    核心应用场景(入门教育/科研算法验证/轻量化工业原型)
    各语种文本直接取素材译文,未重译;素材的过度转义(如 USB\-C)已清理
    - 规格表新增两行:材质(拓竹 PLA+)、尺寸(主动臂 111×239×525mm / 从动臂 111×173×532mm)
    - 新增尺寸图(素材「产品参数」的三视图),压缩为 JPEG q92 / 1100px(293KB),
    放 images/products/so-arm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
2026-09-18 fix(i18n): 修译文里的中文残留——路径占位符与大文件说明按语种本地化
    第七轮全局检查的翻译质量专项发现两类问题(命令与结构均 0 异常,问题只在这两类):
    - ① 我在 SO-ARM101 入站时,给 4 个超限大视频写的说明句是中文,却插进了全部 11 语
    → 按语种本地化(zh 保留中文)
    - ② 素材遗留:非中文页面里的路径占位符仍是中文(`C:\Users\<你的Windows用户名>\…`、
    `<用户名>`、`~/用户名/…`),站内既有页面(前几轮入站)同样存在
    → 按语种本地化:en `<username>` / ja `<ユーザー名>` / ko `<사용자명>` / de `<Benutzername>` /
    fr `<nom-utilisateur>` / es `<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
2026-09-18 fix(home): 修首页横向滚动(hero 的 50vw 负 margin 含滚动条宽度)+ 满宽写法统一
    问题:首页在 Windows / 常显滚动条的系统上会出现约 7px 的横向滚动条,页面可被横向拖动。
    根因:hero 用 `margin: 0 calc(50% - 50vw)` 实现满宽,而 `50vw` 把纵向滚动条的宽度
    也算进视口宽度 → 元素向左多伸约 7px(半个滚动条),整页因此产生横向溢出。
    macOS 默认悬浮滚动条下不出现,所以此前几轮在 Mac 上测都是 0px。
    修法:满宽由 .hero-section 移到 .hero-inner,改用与卡片网格同一套安全写法——
    `--hero-w: min(1320px, 100vw - 48px)` + `margin-left: calc(50% - var(--hero-w)/2)`
    (48px 余量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
2026-09-18 fix(home): 修首页横向溢出真因——与产品页同名类互相覆盖
    VitePress 把 11 份 index.md 与 products/index.md 的 <style> 合并进同一个
    全局 CSS(全站只有 1 个 css 文件),产品页的 .category-grid 规则在包内靠后,
    覆盖掉首页满宽所用的负 margin → 首页/产品页在 ≥768px 均横向溢出 248px
    (1440 下 clientWidth 1425 / scrollWidth 1673),这正是「首页没有自适应」的
    真因;上一轮修的 50vw 是另一处独立隐患(已一并保留)。
    - 首页 .category-grid/.category-card → .home-category-grid/.home-category-card
    - 首页 .hero-subtitle → .home-hero-subtitle(产品页 20px 曾覆盖首页 22px 设定)
    - 主题 style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
2026-09-18 chore(check): 加跨页 CSS 选择器碰撞闸门 check:css
    markdown 的 <style> 会被 VitePress 合并成 1 个全局 CSS(产物仅 assets/style.*.css),
    类名因此是全站命名空间:两个页面写同名选择器就互相覆盖,赢家由打包顺序决定
    (2026-09-19 首页与产品页横向溢出 248px 的真因)。新增脚本把它变成可拦截的检查。
    - 判据:同一 (媒体条件, 选择器) 下「声明不一致的变体分属不同页面」→ 退出码 1,
    并打印两侧拥有者、两份声明与修法提示
    - 页面 vs 全局源(theme/style.css、Layout.vue 的非 scoped <style>)只提示不计错
    (主题对卡片动效的叠加是有意的),--verbose 列出
    - 11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
2026-09-19 feat(tutorials): 索引页补齐——/tutorials/ 与分类枢纽不再漏链自家页面
    用户反馈 /tutorials/「好像没有更新」:该页与 3 个分类枢纽都是手写目录,近半年入站的
    内容(LeRobot 课程 43 页、XLeRobot、ESP32-NanoCam、CSI 摄像头、AI 语音模块、
    GPS 北斗、SO-ARM101 新增页)全都没同步进去。
    - 审计判据:每个 index.md 必须 2 跳内到达自家子树每一页(索引直链=1 跳,经由产品枢纽=2 跳)
    - 补齐 4 类页面 ×11 语:robot-arms / accessories / sensors 枢纽 + /tutorials/,
    共 1012 条链接;文案(标签与分组名)全部取自 config.ts 侧边栏,不新写译文
    - 3 个「孤岛页」:课程首页把「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
2026-09-19 feat(tutorials,downloads): /tutorials/ 正文改由侧边栏树生成 + downloads 页补托管文件
    用户反馈「/tutorials/ 看了还是旧的」:上一轮虽补齐了链接,但正文结构与标签照旧
    (3 个 H3 + 文件名式标签),新增内容夹在长列表中间,看不出更新过。本次:
    - /tutorials/ ×11:正文首节改为按 config.ts 侧边栏层级渲染的嵌套列表
    (5 个顶层组 / 185 链接,与侧边栏逐条一致;标签与分组名全部取自侧边栏,
    不再出现 SO-ARM101-Tutorial 这类文件名式标签);How to Use/Other Resources 保留
    - downloads ×11:补入 14 个本站托管文件(该页自称"集中下载"却一个都没列),
    新增 Feetech 小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
2026-09-19 chore(check): 加托管文件链接闸门 check:downloads
    check-links 的 SKIP_EXT 跳过 zip/rar/stp/step,这类断链此前无人检查——本轮就发现
    AmazingHand-main.zip(106MB,超 CF Pages 单文件上限,从未托管)在 11 个语种挂着死链。
    - 新脚本 scripts/check-downloads.mjs:md 里所有 /downloads/<文件> 必须指向
    docs/public/downloads/ 下真实存在的文件;已用「注入死链→退出码 1→清理→0」验证
    - npm run check 现为四项(links + css + index + downloads)
    - CLAUDE.md 补 check:index 与 check:downloads 两行(上一轮的 check:index 那行因
    替换脚本静默失配,其实从未写进文件),并新增「索引页会静默漂移」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
2026-09-19 fix(downloads): 托管文件链接文案对齐各语种教程页的译名
    同一文件在各语种教程页里多有译名(如 fr 的 "Logiciel PC Feetech pour servomoteurs.zip"),
    downloads 页此前取「出现次数最多」的写法 → 常落到中文文件名上。改为优先取非文件名的译名,
    与教程页一致;中文页仍保留真实文件名(站内惯例)。
    顺带修正我脚本里的老坑:枚举 en 内容树时未跳过语种子目录 → en 曾取到葡萄牙语标签。
2026-09-19 chore(check): 加绑定式链接闸门 check:bindings
    首页/产品/专题的卡片链接是 `:href="withBase('/x')"` 或裸 `href="/x"`,check-links 只扫
    markdown 链接、config.ts 的 nav/sidebar 另扫 → 这一整类此前无人校验,改页面文件名
    就会静默打断首页卡片。实测 484 处目标全部存在(0 错),已用「注入失效卡片→退出码 1
    →还原→0」验证闸门有效。npm run check 现为五项。
2026-09-19 feat(home,course): 首页卡片改指 LeRobot 课程;课程按操作系统分组
    - 首页「最新文档」首卡 SO-ARM101-Tutorial → LeRobot 完整课程(11 语卡片标题取各语
    侧边栏的课程组名,不新写译文;卡片图/分类不变)
    - 「SO-ARM101 + AmazingHand 课程」按系统分类:侧边栏 13 条平铺 → 课程总览 +
    Linux(6 阶段)+ Windows(6 阶段);分类枢纽页加 #### Linux / #### Windows;
    /tutorials/ 由侧边栏生成,自动跟上同一分组
    - 课程首页两张表列序统一为 Linux|Windows(单元格内容随列一起交换,已核对
    Linux=Miniforge、/dev/ttyACM*;Windows=Miniconda、COM*,未错位)
    - 附带效果:该课程各页的上一页/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
2026-09-19 fix(course): 课程首页的「目录结构」一节改为站内真实结构
    该节描述的是**素材原始布局**(tutorials/README.md、01-environment/win.md),站内实际是
    01-Environment-Setup-Linux.md 这类平铺文件——正文里 `win.md`/`linux.md` 也各语种各出现两处。
    本轮按「系统分类」调整后该节更显突兀,一并修正:
    - 正文令牌替换为 Linux/Windows(代码 span 名字固定,不涉及译文改写);
    中日文补回拉丁词与汉字之间的空格(韩文助词紧贴属正确,未动)
    - 代码块整棵换成站内真实结构(按 Linux/Windows 分组,无注释——原先各语种都带英文注释)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
2026-09-19 fix(course): 阅读路径表的链接文字改为实际文件名
    表中链接文字仍是素材路径(01-environment/linux.md),点进去却是 01-Environment-Setup-Linux.md,
    表里表外两个名字。改为「链接文字 = 目标文件名」,与上方目录树、侧边栏一致(132 处,11 语×12)。
2026-09-19 fix(i18n): 第九轮全局检查——修 4 类残留 + 补闸门盲区
    全局检查发现并修:
    - 空文本链接 `[ ](url)`(en AmazingHand-TTL-Debugging:同一飞书链接连着两次,
    后一个文字只有空格 → 渲染成看不见的链接)
    - 目标含裸空格的链接 6 处(fr/es/it downloads 页:markdown 在空格处截断,
    链接退化成纯文本;来源是我上一轮补 downloads 时的兜底写法没编码空格)→ 改 %20
    - en/ja 的漏译:`**位置**:`→`**Location**:`(3)、`**sdk名称:**`→`**SDK name:**`(1)
    (其余 10 语早已翻译,ja 用的是「場所」)
    - es/it/pt-br/pt-pt 的 GPS 教程里 64 处中文品牌名 `百度地图` → `Baidu Maps`(与 en/fr/de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
2026-09-19 chore(check): 加链接书写形态闸门 check:linkformat
    本轮全局检查靠人工扫才发现两类「静默坏链」——它们不报错,但用户点不到:
    空文本链接 [ ](url)(渲染成看不见的链接)与目标含裸空格(markdown 在空格处截断)。
    固化为闸门:扫描全部 18956 条 markdown 链接,两类都拦;注意要排除
    「链接文字本身是行内代码」的合法写法(判据里保留行内代码,只剥围栏块)。
    已用「注入两类坏链 → 退出码 1 → 清理 → 0」验证。npm run check 现为六项。
2026-09-19 i18n(comments): 代码块内的中文注释译为各语种语言(8 语种,西语待补)
    早期从中文素材导入时,代码示例里的中文注释没翻译,一直留在 8 个语种页面里
    (en 474 行、de 468、fr 456、it 468、pt-br 483、pt-pt 474、ja 479、ko 433)。
    做法:跨语种去重成 558 条唯一注释 → 每语种一份词典(代理产出,术语对齐站内既有译文;
    命令/路径/URL/标识符/数字原样;中文软件界面名保留在引号内,便于对照中文界面) →
    脚本只替换注释片段。ja 页面跳过含假名的条目(本来就是日文,187 条)、ko 同理(含谚文)。
    - 348 个文件:剥离注释后的**代码投影与 HEAD 逐字节一致**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
2026-09-19 i18n(comments): 西语代码块注释落地,9 语种收尾
    西语 468 行 / 48 个文件(其余 8 语种见 9974c11a)。西语的词典也是"跨语种去重后 558 条"
    一并译出,术语对齐站内既有西文页(servo/calibración/puerto serie/teleoperación 等)。
    复核方式:用最终词典对 9 个语种全部空跑 —— **0 文件待替换**,证明落地内容与词典完全一致
    (此前法语、葡-葡的词典在应用后又修订过,故整批还原后用最终版重做)。
    西语这 48 个文件同样通过"剥离注释后代码投影与 HEAD 逐字节一致"的独立校验。
2026-09-19 i18n: 第 11 轮全局检查——代码块散行/占位符/繁简/Windows 路径四类修正
    - zh-hant 代码块注释与 docstring 简→繁(355 行/33 文件):以 OpenCC 单字表为底、
    按站内正文用字校正(為/啟/裡 归并;台/干/斗/峰/群 属正常繁体用法不转),逐行逆映射校验
    - en/pt-br/pt-pt 补齐:单行三引号 docstring、示例程序日志串(38 行),取其余 6 语既有英文
    - 9 语种代码块散行 538 行/116 文件:操作说明、箭头流程图、--mode 参数说明、
    中文占位符(你的WiFi名称/目录名/校准文件.json 等),ASCII 对齐符号与行内空格原样保留
    - 正文级:中文序号「一、」→ 各语种数字序号(j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
2026-09-20 i18n: 第 12 轮全局检查——zh-hant 简繁补完 + 跨语种内容奇偶校验
    - zh-hant 补完(415 行/53 文件):上一轮只覆盖「行首注释与 docstring」,
    本轮把正文、块注释(含行尾 /* */)、文件树标注、协议图标签、单行三引号
    docstring、示例程序日志串一并转繁;固件命令词、真实文件名、软件界面名
    按站内惯例保留。简繁是 1:1 等宽变换,框线图列宽不受影响
    - 新增「跨语种结构奇偶」审计(225 组页面 × 标题/表格/围栏/图片):
    对 11 语逐项比对,补 9 处缺失内容——kvm-switch 的 Support 节(5 语)、
    usb-audio 官方仓库节(4 语)、jetpack-setup 的 4.1 网络与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
2026-09-20 i18n: 第 13 轮——全局检查换成精确跨语种不变量 + 新闸门 check:parity
    把启发式/多数投票式检查换成「设计上必然相同」的精确判据,并把判据落成永久闸门
    (scripts/check-parity.mjs,已并入 npm run check,共七项):逐页 × 11 语比对
    围栏转义、标题层级与表格、图片目标、/downloads/ 目标、围栏语言标签序列,
    并按「行覆盖」与「行出现次数」比对围栏内代码(默认提示,--strict 判失败)。
    据此修出的真实缺陷:
    - 36 行围栏被转义(\`\`\`PowerShell,3 页 × ja/ko/de/fr/es/it):渲染时显示字面
    反引号、代码块失效;构建与 check:links 都不报错
    - fr/es/it 的 Feetec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
2026-09-20 i18n: 按「不改原意」回退语义改动,rdk.md 恢复为「原文 + 素材」并集
    用户要求「改归改,不要变了原来的意思」。据此复核本轮全部改动,把**动到原文/命令**
    的三处处置如下:
    1. rdk.md(6 语)原先被我删掉了「安装 i2c-tools + i2cdetect -y -r -a 0」两段
    (理由是素材的 RDK 页没有这段),属删减教程内容 → 现全部恢复:11 个语种的 §2
    改为「原有文字逐字保留 + 素材里的 python3 方法」的并集,新增句全部取自厂商
    素材自带 11 语译文的 Jetson 页(不新增任何自造译文);顺带解除该段的围栏转义。
    2. pt-pt 的 `HF_USER=$(hf auth whoami | head -n 1)` 被我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
2026-09-20 i18n: rdk.md 回到第 13 轮之前的原样(仅修好被转义的围栏),闸门加按页豁免
    用户要求「不要变了原来的意思」。据此把 rdk.md 的处置改为最忠实的一种:
    **11 个语种全部恢复到第 13 轮之前的内容**——各语种原有什么命令、什么说明文字就
    保留什么,不增不删不改(此前我删掉了 6 语的 i2c-tools 段、又给 5 语补了素材措辞,
    两个方向都动了原文,现一并撤销)。唯一保留的改动是把该页被转义的围栏
    (\`\`\`PowerShell)修回真代码块,否则这 6 个语种的该段在线上显示为字面反引号。
    该页因此保留一处历史内容差异:「查看 I2C 设备」这一步,5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
2026-09-21 fix(parity): 修掉语义审计发现的真回归 + 让 ④ 判据更精确(去掉掩盖信号的白名单)
    用 146 个代理(12.6M token)对第 13 轮 136 个改动单元做了逐文件语义审查 + 对抗性
    反驳 + 完整性批判。136 个单元无一被判「无理由改意」,但批判者复查出三处我与审查员
    都漏掉的问题,逐条核实后处置:
    1)【真回归,已修】pt-pt SO-ARM101-Tutorial.md 第 896 行 `HF_USER=$(huggingface-cli
    whoami | head -n 1)` 被上一提交改成了 `hf auth whoami`。根因:我那个「回退」脚本
    用 Python str.replace(全量替换),把第 431 行(该回退的)与第 896 行(原始就是
    huggingface-cli、我根本不该动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
2026-09-22 i18n: 零风险批——55 处 %USERPROFILE% 缺分隔符 + 2 页图片顺序 + ByteDance 误译
    三组改动全部以「同事提供的原资料写的是别的」为据(用户 2026-09-23 批准):
    1. %USERPROFILE% 缺路径分隔符 55 处 / 33 文件(11 语 × 3 页:AmazingHand
    手势追踪 02-Windows、SO-ARM101+AmazingHand 04-Data-Collection-Windows、
    02-Hand-Arm-Calibration-Windows)。原文写作 `%USERPROFILE%.cargo\bin`,
    Windows 展开后是 `C:\Users\名.cargo\bin` —— 静默错误路径,七道闸门都
    看不见(两种写法都是合法行文)。素材 86 处全部写作 `%USERPROFILE%\.…`。
    逐行在点号前补反斜杠;行尾与行数不变。
    2. 图片顺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
2026-09-23 feat(jetson): 上线 Jetson AGX Orin 官方套件文档系列(16 页 × 11 语 + 产品页)
    内容来自预适配上传包(资料侧整理,源工作稿含全量元数据):16 篇教程 + 13 张官方配图 +
    1 个产品页,JetPack 7.2.1 基线,每页 frontmatter 带 verified_against(锚定 NVIDIA 官方
    文档+日期)与 hardware_verified: false;链接与图片路径已按本站约定预改写。
    - 翻译:170 个单元(17 页 × 10 语)由工作流扇出,180 代理 0 失败;术语按各语种站内
    既有译法对齐,专名保留英文
    - 修掉上传包自带的两处确定性缺陷(均先自证再修,修后复核 0 残留):
    A) 断链 252 处:8 个 slug 首字母被吃(uick-start / ocal-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
2026-09-24 check(linkfmt): 补第三类静默坏链——协议相对目标(//host/…)
    用户报告:中午访问 /zh-hans/tutorials/jetson-agx-orin/quick-start 时,浏览器地址栏
    显示 https://zh-hans 并报 DNS_PROBE_FINISHED_NXDOMAIN。该形态(把路径首段当主机名)
    是协议相对链接 `](//zh-hans/…)` 的典型后果,但全站核查后**未发现任何此类链接**:
    - 正文/config.ts/主题/构建产物里 `](//` 与 `href="//` 均为 0 处
    - _redirects 66 条全为 /xxx → /xxx 301,无 // ;无 _headers
    - 该 URL 实测 HTTP 200 且无跳转;.html 与尾斜杠变体均 308 回到正确的绝对路径
    - auto-lang-redirect.ts 只处理无语言前缀的根语言页面,且目标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
2026-09-25 feat(so-arm101): 上线 7-DOF 完整课程(45 页 × 11 语)+ 独立产品页,退役旧 7DOF 单页
    按用户决定:7-DOF 单列为独立产品 SO-ARM101-7DOF,内容以新素材包为准(上传包:SO-ARM101 7轴机械臂使用教程/)。
    **内容**
    - 课程 45 页 × 11 语 = 495 页(素材包自带译文,无需重译):前提准备 + 第一~九步,
    中文路径映射为 ASCII(镜像 6 轴课程命名:01-Environment-Setup/Ubuntu、08-Training/Command-ACT…)
    - 图片 109 张:73 张与站内既有内容逐字节相同 → 复用既有托管(零重复),36 张新增落盘
    - 4 个 mp4 复用既有 /downloads/(逐字节相同);新增托管 lerobot-7dof.zip(7MB)+ so_follower.py + so_leader.py
    -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
2026-09-25 fix(i18n): 语言自动跳转收窄为「仅首页」——内页不再自动换语种
    用户反馈:打开 wiki.juxitech.com 从 **en** 页面点进教程,却莫名其妙落到 /zh-hans/tutorials/。
    定位:这是 theme/auto-lang-redirect.ts 的既有行为 —— 凡「无语言前缀」的页面都按
    localStorage 偏好/浏览器语言自动重定向,于是点英文内页也会被拽到中文页。
    改法:重定向条件由「无前缀」收窄为「根路径 /」——
    - 首页(/)仍按偏好/浏览器语言自动进入对应语言首页(原功能保留)
    - 内页一律不跳:用户从哪个语种的页面点进来就停在哪个语种
    - 已带前缀的 URL(爬虫/直接链接)行为不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
2026-09-25 docs(theme): 同步 LanguageSwitcher 里因跳转收窄而过时的注释(仅注释,行为不变)
2026-09-25 fix(7dof): ja/ko/it 的 `<官方clone>` 占位符本地化(与各页自身用词一致)
    全局检查发现的素材缺口:7DOF 课程的 Option B 段落里,ja/ko/it 三语种的代码块
    占位符仍是中英混排的 `<官方clone>`(zh-hans/zh-hant 用中文、en/de/fr/es/pt 均已本地化)。
    改为与**各页自身已有用词**一致(不新造术语):
    - ja: `<公式クローン>`(该页 46/50-52 行本就用「公式クローン」)
    - ko: `<공식 clone>`(该页 38/44/46 行本就用「공식 clone」)
    - it: `<clone ufficiale>`(该页 46/50-52 行本就用「clone ufficiale」)
    另:全局检查中并列的另一条(zh-hant 用「硬件」而非「硬體」)**经复核不成立,未改*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
2026-09-26 feat(jetson): 新增 Jetson Orin Nano 官方套件文档系列(英文 16 页 + 产品页)
    - 16 篇英文文档 → content/tutorials/jetson-orin-nano/(quick-start / flashing-and-updates /
    verify-your-system / interfaces / overview / local-llm / memory-efficiency / deepstream /
    robotics / agentic-ai / jetpack-6-to-7 / downloads / faq / troubleshooting / glossary / changelog)
    - 13 张 NVIDIA 官方配图 → public/images/jetson-orin-nano/
    - 产品页 → content/products/jetson-orin-nano-devkit.md(Buy in Store 直连商店 SKU JX00110)
    - 接线(英文段): /tutorials/ 侧边栏新分组(紧随 AGX 组)、/products/ Compute & Vision 组新增条目、
    tutorials/index.md 与 products/inde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
2026-09-26 feat(jetson): Orin Nano 系列 10 语言上线 + 集成后修正
    语言与接线
    - 10 语言(zh-hans/zh-hant/ja/ko/de/fr/es/it/pt-br/pt-pt)各 16 页 + 产品页
    - 各语言接线:/tutorials/ 侧边栏新分组、/products/ Compute & Vision 条目、tutorials+products 索引、
    topics/jetpack-setup.md 顶部指引行与版本映射表新增行(原有 6.x 行保留,两种口径并存)
    - 译稿以各语言既有 AGX 系列为术语与风格基准(如 zh-hant 统一用「固件」而非「韌體」),并做过逐语言审校
    集成后修正(英文更正后逐语言传播)
    - VPI 4.1.3 → 4.1.4:依据 NVIDIA apt 仓库的依赖锁(nvidia-vpi (= 7.2.1-b49) → libnvvpi4 (= 4.1.4));
    与 AGX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
2026-09-26 docs(jetson): Orin Nano 系列收敛至 8GB 单一 SKU(移除 4GB 模组内容)
    按项目既定决策(AGX 系列同样只覆盖单一 SKU), 11 个语言副本一并收敛:
    - overview 页:删除"其他 Orin Nano 模组 SKU:P3767-0003(8GB 商用)和 P3767-0004(4GB)"及
    载板接受 SKU 0/1/3/4/5 的枚举;改为一句聚焦说明(本文档系列仅覆盖 8GB 开发者套件 +
    商用 8GB 是不同料号、在刷机工具中是独立目标,指向刷机页的模块 SKU 说明)
    - overview 页 Juxi note:量产模组选项去掉 4GB(Orin Nano 8GB 或 Orin NX)
    - 保留 P3767-0003 的提及 —— 刷机时的目标选择必须区分它, 属操作必需, 与 4GB 情形无关
    验证:全库无 P376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
2026-09-26 feat(jetson): AGX Orin 资料 9/26 修订同步进 11 语;docs:build 加堆上限
    **AGX Orin 9/26 修订**(资料方更正:组件版本 CUDA 13.2.1→13.2.2、VPI 4.1.3→4.1.4;
    Isaac ROS 状态由"即将推出"更正为 4.6.0 起支持 JetPack 7.2;若干"组件表滞后"提示):
    - en 8 页 + 产品页用包内新版覆盖;10 语种的 verified_against 元数据块机械同步(80 文件)
    - 正文本地化:80 个单元(8 页 × 10 语)由工作流就地同步,0 失败;版本号/命令/链接逐字对齐
    - 产品页购买链接重新落定为**商店首页**(包内版本退回 TODO;AGX Orin 套件目前仍不在售)
    - 修正包内一处死锚点:en 的 `#isaac-ros-on-jetpack-72` → `-7-2`
    (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
2026-09-26 docs(7dof): 11 语推理页顶部加一行 rollout 拆分提示(增量,不动原文)
    上游 huggingface/lerobot@main(0.6.2)的 [project.scripts] 同时注册 lerobot-record 与
    lerobot-rollout,且 lerobot_record.py 要求 teleop(记录=纯数据采集),报错文案直接指向
    lerobot-rollout;课程 02-Replace-Files 页确认学生克隆的官方代码即该版本 → 页面保留的
    `lerobot-record --policy.path` 写法适用于更早版本,提示读者改用 lerobot-rollout。
    77 文件 × (+2 / -0):提示行插在 H1 下方,原文一字未动。七道闸门全绿(parity 304 组)。
2026-09-26 docs(lerobot): 4 页旧推理命令整段迁移到 lerobot-rollout(11 语 × 8 命令块)
    上游 huggingface/lerobot@main(0.6.2)已移除 lerobot-record 的策略推理:传
    --policy.path 报未知参数、缺 teleop 直接抛 ValueError、repo_id 以 eval_ 开头被显式
    拒绝;rollout 侧 context.py 强制 dataset 名以 rollout_ 开头。按 6 轴课程样板把
    SO-ARM101-Tutorial(5 块)、AmazingHand 06 部署页(Linux/Windows 各 1)、
    embodied-ai-intro(1)的推理命令整段改为 lerobot-rollout --strategy.type=episodic
    (参数面与上游 rollout/strategies/episodic.py 逐项核对:episode_time_s /
    reset_time_s / num_episodes / single_task 均有效,teleop 可选)。
    44 文件 × (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
2026-09-26 docs(7dof): 第九步推理页迁移到 lerobot-rollout --strategy.type=episodic(11 语 × 17 命令块)
    按用户选定口径(episodic 保记录、参数 1:1 映射)把 lerobot-7dof/09-Inference 的 7 页
    (CLI-Reference / Command-{ACT,Diffusion,pi0,pi0.5,smolvla} / DGX-Spark)从
    lerobot-record --policy.path 整段迁移到 lerobot-rollout:
    ① 187 个命令块:换名 + 插入 --strategy.type=episodic(其余参数逐字保留,含 episode_time_s=1000
    与双向空格续行;DGX-Spark 的 WALL-OSS 块参数序不变);
    ② 132 处清理步骤路径 eval_→rollout_,与同页命令的 repo_id 同名(脚本断言校验);
    ③ 11 处 "starting with eval" 文案(10 bullet + DGX-Spark 一个 ## 标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
2026-09-26 docs(so-arm101): FAQ 报错样例的 eval_xxxx 与迁移后的说明对齐(11 语)
    上批 b355792b 把该页说明与回显改成 "delete the folder starting with rollout_",但同一
    FAQ 条目里围栏内的报错样例仍印着 juxi/eval_xxxx,与紧邻说明自相矛盾(该样例是读者
    按图形比对报错的依据)。按 11 语把样例里的 eval_xxxx 改为 rollout_xxxx;同页 pi0/pi0.5
    训练块读取 juxi/eval_test123 属训练命令口径,仍留待用户决策,未动。
    11 文件、+11/−11;七闸门全绿。
2026-09-26 docs(7dof): CLI-Reference 补 6 轴「版本说明 + rollout 参数表」;修 6 轴 pt 提示行句号
    ① 7dof CLI-Reference(11 语)在 H1 后补入 6 轴同款两节:版本说明(0.6.0 起用
    lerobot-rollout、0.5.2 起移除 --policy.path、两命令分工)+ rollout 参数表(7 行:
    --strategy.type 的 base/episodic、--policy.path、--task、--duration、--interactive、
    --display_data、--policy.device)。文本逐字取自已上线的 6 轴同名页,仅两处机械修正:
    分工条目里的数据采集步骤号 6→7(7dof 课程为 07-Data-Collection)、ja 的中文「步」字
    (第一步/第六步)按站内日语惯例改为「ステップ1/ステップ7」。此改动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
2026-09-26 docs(ja): 内容里的中文「第X步」按日语课程惯例改为「ステップX」(9 文件 19 处)
    ja 课程自己的标题/正文惯例是「ステップN」(6 轴 01/06/07 各页标题、7dof 01 系列
    标题均如此);残留的「第一步/第二步/第六步/第七步/第八步」是早期从中文素材导入时
    未转换的字形。按 11 语中该词的一贯写法逐处替换(6 轴:CLI-Reference、07-Training
    ×5、06-Data-Collection;7dof:02-Replace-Files 的 title+H1),并把该页标题的分隔符
    按 ja 课程写法从全角「：」归一为「:」。真实中文文件名(平行指夹爪安装步骤.mp4)
    与 ja 侧边栏标签(config.ts 无「步」)均未触碰。
    9 文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
2026-10-08 ci: GitHub Pages 部署改为仅手动触发(停用 push 自动部署)
    原因:①npm ci 在 runner 上因锁文件与 npm 版本错配失败(EBADPLATFORM @esbuild/*);②即便修复,站点构建产物达数 GB,超出 GitHub Pages 单站 1GB 上限。主站由 Cloudflare(wiki.juxitech.com)承担;本工作流保留 workflow_dispatch 供手动/实验使用。
2026-10-08 chore: 移除内部工作文件(agent 指令/计划/报告/旧草稿),不再公开发布
    本地保留并忽略: CLAUDE.md、AGENTS.md、.claude/;彻底删除: archive/、docs/superpowers/、ANALYSIS_REPORT.md、PROJECT_PROGRESS.md、使用指南.md、docs/public/images/{README,DIMENSIONS}.md、docs/public/style.css(后三者同时从线上站点移除:docs/public/ 会被原样发布)。
2026-10-08 docs: 清理内容层小瑕疵(设计参考注释中性化/示例路径中性化/移除失效 Deploy 徽章)
    11 语同步:①11 个 index.md 的 CSS 注释去除第三方设计参考字样;②11 语 amazing-hand 02-Windows.md 示例路径改为通用的中文目录名;③11 份 README 移除已失效的 Deploy 徽章(GitHub Pages 自动部署已停用)。七闸门全绿;构建产物复核零残留。
2026-10-10 fix(i18n): 修复语言偏好带斜杠拼出协议相对 URL '//zh-hans/' 跳飞站点的 404 事故
    读取端(auto-lang-redirect):偏好值剥首尾斜杠+小写归一;新增 KNOWN_LANGS 白名单作跳转前终检。历史脏值视为无偏好回退浏览器语言,已中毒浏览器首访自动自愈;异常值最坏停留英文首页,不再可能拼出跨站 URL。
    写入端(LanguageSwitcher):存偏好时剥掉 code 前导斜杠('/zh-hans'到'zh-hans'),与读取端格式统一。
    验证:13 组 localStorage×浏览器语言组合用例(含各类脏值)全部通过。
2026-10-10 feat(content): 三个产品教程更新——ESP32-NanoCam 新翻译整轮同步、二自由度云台多页教程上线、LeKiwi 飞书导出版更新
    ESP32-NanoCam(11 语 × 16 页):Ch01-11 与快速开始/硬件规格书/串口协议手册替换为新翻译整轮内容(修复源中节号错位、自动补回同门互链);新增 教程总览(index)与代码下载页,侧边栏与索引页接线。
    二自由度云台(11 语 × 7 页):单页教程升级为多页教程(总览/快速开始/硬件与环境/基础使用/高级功能/故障排除/产品信息),原 URL 由新总览页承接;上位机软件包托管 /downloads/2dof-camera-gimbal.zip。
    LeKiwi(11 语 × 3 页):使用/组装教程更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
2026-10-10 feat(home): showcase both Jetson Developer Kits across the homepage in all 11 languages
    - Product Series: pin 2 cards (AGX Orin first, then Orin Nano Super) to the top
    of the grid in each of the 11 index.md files; links target the existing
    product pages with per-locale prefixes; labels reuse the site-wide
    "Developer Kit" naming (consistent with sidebar and product pages)
    - Browse Categories: pin 2 tutorial cards (-> {locale}/tutorials/jetson-*/
    quick-start) to the top of the second grid on each homepage, reusing the new
    category images
    - Latest Documents (HomeLatestDocs.vue): prepend the two kits to the curated
    card list, add titles for all 11 languages, and add a new "Kits" filt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
2026-10-10 fix(home): correct git-date parsing in home.data loader (card dates never rendered)
    The commit header line is \x1e<date>\x1f, so the date is split('\x1f')[0];
    index [1] is the empty string after the trailing separator. With cur always
    empty the date map never got entries, and filter(x => x.lastUpdated) then
    dropped every row — so the Latest Documents cards have never shown their
    last-updated dates (confirmed absent on the production build 140abb12).
    Verified: loader now yields 2992 dated entries; all 10 Latest Documents cards
    show dates in the browser; production build passes.
2026-10-10 docs(jetson): mark AGX Orin / Orin Nano Super pages as reviewed (11 languages, 363 files)
    Footer status notice on every Jetson page (both series, all 11 languages) changed
    from "draft, pending review by cheny" to "reviewed on 2026-10-11". Only the
    status clause was replaced; the remaining sentences (upstream-availability
    caution, hardware-verification note) are kept as-is. Historical rows in the
    changelog pages ("initial documentation set published as draft") are
    intentionally untouched.
    Variant phrasings covered across languages (審核/審閱/評審, による/の, cheny의,
    Überprüfung ... ausstehend/steht aus, révision, bare "Status: draft." forms,
    halfwidth/fullwidth punctuation etc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
2026-10-12 feat(jetson): XLeRobot Docker 教程系列上线 + 两套件 16 页正文同步最新修订
    XLeRobot Docker(新增,6 页 × 11 语 × 2 套件 = 132 页):deployment(总览/环境准备/部署)、lerobot 操作、xlerobot 操作、故障排查;侧边栏(XLeRobot Docker 分组)与 tutorials 索引接线;源里目录自链接/死链/多余 H1 均已规整。
    16 页修订(352 页对照,285 文件实际变更):以两个开发套件仓库(10-12 版)为内容源同步正文修订(措辞/版本事实/外链修正/多语言引文重译),保留 wiki 侧富 frontmatter 与审校标记;Nano 仓库无前缀相对链接(1309 处)统一改为 wiki 绝对路径。
    构建适配:docker 模板语法 {{...}}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
2026-10-13 feat(tutorials): SO-ARM101 教程整批补全——课程补页 + LeLab 教程集 + XLeRobot 镜像教程入口(11 语)
    SO-ARM101(11 语 × 13 页 + 教程首页):补入仓库初版即有、此前未导入的页面——握手200 采集示例、回看与回放、LeIsaac 仿真采集、训练侧 5 页(Diffusion、WALL-OSS、训练命令行、训练参数建议、模仿学习算法)、推理侧 4 页(Diffusion、WALL-OSS、DGX Spark、RDK S100)、摄像头支架推荐;新增教程首页(产品落地页)含教程导航区块,机械臂枢纽/课程索引/教程首页三处索引接线。
    LeLab(11 语 × 7 页):浏览器端教程集入站 so-arm101/lelab/,侧边栏新增「LeLab 教程」分组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
2026-10-13 feat(sidebar): SO-ARM101 系列新增「XLeRobot Docker 镜像教程」折叠分组(11 语)
    置于 7 轴教程分组之后:两个 Jetson 套件(AGX Orin / Orin Nano)各 6 条(总览、环境准备、部署、两项运行指令、常见问题),直链各套件章节下已发布的镜像教程页面,不复制第三份内容;条目文案复用各套件侧边栏既有文案。
2026-10-15 fix(jetson): remove duplicated status notice on Orin Nano pages (176 files, 16 pages x 11 languages)
    The 2026-10-12 sync (8e1eed7e) inserted the footer status notice a second time
    on every Orin Nano page while syncing page bodies. This removes exactly the
    inserted occurrence per file — identified from that commit's diff rather than
    by position heuristics — including its companion blank lines. On three files
    (ko/it/pt-br troubleshooting) the two copies carried different wording
    variants: the rewritten footer copy is kept and the stale mid-document copy is
    removed. Body revisions from the sync are untouched; AGX Orin pages were never
    affected.
    Verified: 176/176 files contain exactly one s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
2026-10-15 fix(tutorials): align XLeRobot Docker command lines to the English reference (5 languages, 26 files)
    The translated XLeRobot Docker series localized sample values inside shell
    commands in five languages (zh-hans, zh-hant, de, pt-br, pt-pt) — e.g.
    "--dataset.repo_id=你的用户名/我的第一个数据集" or
    "<benutzername>/mein-erster-datensatz" — while the other six languages kept
    the English text; the parity gate's code-line coverage flagged 22 resulting
    mismatches. This aligns 110 command lines byte-for-byte with their English
    counterparts. Comments and diagram/description text inside code blocks keep
    their translations, per the established convention. Also verified that the
    pre-exi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
2026-10-15 fix(tutorials): align remaining mask-hidden placeholders in XLeRobot Docker commands (5 languages, 22 files)
    Follow-up to 3c7dd577: the parity gate's masking treats angle-bracket
    placeholders and quoted strings as opaque, so translated sample values in
    those positions (de "<benutzername>/<modellname>", zh "你的用户名/数据集名",
    pt "seu-usuário/...", also "git clone <本仓库地址>") passed the gate while
    still diverging from the English reference. This aligns the remaining 48
    value lines byte-for-byte to English (de 24; 6 each for zh-hans, zh-hant,
    pt-br, pt-pt; 22 files across both kits). Diagram blocks, table rows and
    inline comments keep their translations per the established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
2026-10-15 feat(products): Product schema, category filter chips and store buy buttons (11 locales)
    - config.ts: Product JSON-LD for product pages (name/image/description/brand/
    category/inLanguage per locale; no offers — the wiki does not show prices),
    replacing the generic Article; shared hub/product page detection feeds og:image
    - products-data.mjs: SHOP_URL + SHOP_LOCALE_PREFIX (same Shopify locale-prefix
    convention as PurchaseLinks; shop=null products get no button)
    - gen-products-index.mjs: cards restructured (page link + store buy button),
    5 category filter chips (pure-DOM toggle, all cards visible without JS),
    .vp-doc-prefixed link/button styles to beat the theme's .vp-doc a rule
    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
2026-10-15 feat(products): add five store-only product pages sourced from the official shop (11 locales)
    New product pages, each in 11 locales, converted from the official Shopify
    product pages' own localized text (no machine translation):
    - jetson-orin-radiator (accessory)
    - pincopen (robot)
    - heart-rate-spo2 (sensor)
    - feetech-scs0009-servo (accessory)
    - so-arm101-amazinghand (robot)
    - products-data.mjs: 5 new products; names/blurbs derive from the store's
    localized titles and overview sentences; 5 new 800x400 card images
    - config.ts: sidebar entries for all 11 locales (55 links)
    - PurchaseLinks.vue: exact-match store mappings (so-arm101-amazinghand placed
    before so-arm101); heart-rate now targe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
2026-10-16 fix(products): restore side padding on hub card blurbs
    The theme's .vp-doc p rule (specificity 0,1,1) overrode .pc-desc (0,1,0)
    and zeroed its horizontal margins, so blurb text touched the card edges.
    Prefix .pc-desc, .hub-filters and .hero-subtitle with .vp-doc — same
    treatment .pc-link/.pc-buy received for the .vp-doc a rule — and note the
    specificity trap in the shared style comment.
2026-10-16 feat(products): hub hero store buttons and desktop side category nav
    - Hero: add Taobao (zh-hans/zh-hant only, the site's convention — Taobao
    links appear only in the Chinese trees) and Official Store buttons under
    the hero subtitle, reusing the homepage .hero-btn design. Labels are
    extracted from each locale homepage at generation time, so wording stays
    in sync; store links carry utm_source=wiki&utm_medium=referral&
    utm_campaign=products-hub&utm_content=hero-store.
    - Categories: at >=1280px the chip row moves to a fixed left-side directory
    (Contents + All + 4 sections, 184px wide at the left margin); below that
    the chip row stays as before. Clicking either control filters th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
2026-10-16 feat(products): Taobao store button on all 11 locales
    Per user decision: overseas customers can shop through Taobao's overseas
    service, so the hub hero now shows the Taobao button in every locale.
    Non-Chinese labels are built from each locale's existing official-store
    wording (Taobao Store / Taobao ストア / Taobao Shop / Boutique Taobao /
    Tienda Taobao / Negozio Taobao / Loja Taobao); the Chinese labels keep the
    homepage wording (淘宝店铺 / 淘寶店鋪).
2026-10-19 feat(tutorials): 三套教程入站——SO-ARM101 MuJoCo 仿真 + KVM 切换器分模块教程 + AmazingHand 网页控制(11 语)
    MuJoCo 仿真(11 语 × 10 页):SO-ARM101 × MuJoCo 全流程(环境、模型验证、实机标定、键盘遥操、数字孪生、录制回放、排障、路线图、使用教程 + 索引),落位 so-arm101/mujoco/,侧边栏/机械臂枢纽/教程首页/落地页导航接线。
    KVM 切换器(11 语 × 8 页):按功能模块拆分的新版教程(总览、双机切换、HUB、蓝牙、TTL 串口、扩展口、采集卡+OBS、FAQ),文件名按编号统一为英文规范名;旧版 kvm-switch-tutorial 保留,侧边栏升级为分组。
    AmazingHand 网页控制(11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
2026-10-20 feat(tutorials): IMU 网页上位机教程入站 + 通信页同步源端修订(11 语)
    - 新增 Web Host Console(JX IMU Studio)教程 11 语,含 5 张截图,接入侧边栏与索引
    - PC 通信页:补充通信协议 xlsx 下载链接,ch34x 更正为 ch340
    - Jetson/RDK/树莓派/STM32 通信页:标题对齐源端,IMU_ROS2.zip 改为下载链接
    - 串口 Arduino/STM32 页代码注释对齐源端
    - 文件远程传输页补充源文档目录链接;快速开始安装路径修正为 ~/IMU_Library/IMU_Library
    - 新增 docs/public/downloads/IMU-Protocol.xlsx
2026-10-20 feat(tutorials): IMU MicroDuck 集成页入站(11 语)
    - 新增 Using the IMU Module with MicroDuck 教程 11 语,接入侧边栏与 IMU/传感器/教程三处索引
    - 内容为桥接页:状态、接线、验证命令、参考装法、为什么不是 Dynamixel ID 200,完整教程链到 imu-displace-microduck 仓库
    - llms 索引重新生成(4092 篇)
2026-10-30 feat(tutorials): 心率血氧教程重构 + AmazingHand 目录重整 + PWM 全流程 + 网页版工具(11 语)
    - 心率血氧 MAX30102：按飞书结构重建为 7 页子教程，旧单页移除，配图入站
    - AmazingHand：按飞书目录新增首页 / Camera Kit / Arduino Nano 三页，重写接口控制页，
    网页控制补在线地址与本地部署包，手势追踪补 MuJoCo 模型与截图，PWM 新增全流程教程
    - 下载：新增 delivery_package.zip / Amazinghand-web.zip / Juxi_ServoController.zip
    - 新增飞特总线舵机网页版调试、So-ARM STS3215 网页端校准两篇教程
    - 侧边栏、教程索引、下载页在 11 个语种同步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
2026-11-06 feat(tutorials): SR-Support 自扶正装置教程入站(11 语)
    - 新增 tutorials/robot-arms/sr-support：目录 + 10 章 × 11 语种，共 121 页
    - 机械臂侧边栏新增独立分组，分类索引与教程总索引同步 11 语
    - frontmatter 的 title/description 统一加引号，修复标题含冒号导致的 YAML 解析失败
    - 飞书已同步：父文档 + 10 章子文档（作者信息已隐藏）
2026-11-09 feat(tutorials): SR-Support 教程更新——拆分 WiFi/MuJoCo 页(11 语)
    - 08 页改为「WiFi 状态页与配网」，新增 09 页「MuJoCo 仿真与实机实时镜像」
    - 故障排查/参考顺延为 10/11，01/03/目录页交叉引用同步更新
    - 新增两张截图并改为站点绝对图片路径
    - 侧边栏、分类索引、教程总索引同步 11 语
2026-11-11 feat(tutorials): AmazingHand 教程改版——README 总览 + 9 章结构(11 语)
    - 按新版教程包重构：README 总览 + 产品资料/硬件/快速上手/网页控制/桌面上位机/手势追踪/舵机调试/Arduino/FAQ 共 21 页 × 11 语种
    - 旧页面替换为「页面已迁移」跳转页（11 语种均保留旧地址），README 语言切换改为站内绝对链接
    - 图片资源迁入 public/images，外链指向 Juxi-Technology/AmazingHand 仓库
    - 侧边栏、分类索引、教程总索引同步新结构
    - 飞书已同步：9 个章节文件夹 + 21 篇正文，附件归入「下载与资源」
2026-11-11 feat(sidebar): AmazingHand 侧边栏按 9 个章节分组(11 语)
    侧边栏从 21 项平铺改为 章节组→页面 的嵌套结构，与本地目录和飞书一致。
2026-11-11 feat(nav): 导航栏新增淘宝店铺入口(中/繁→国内,其余→海外)
    - 中文版链接 https://juxitechnology.taobao.com/，其他语种 https://juxitechnology.world.taobao.com/（同一店铺）
    - 按钮位于官方商城右侧，橙色描边区分；960px 起布局不溢出
    - 本地 dev 与线上均验证链接与样式
